WINNAKEN/robot-arm-lab/models/cycloid-27-v1/README.md

# 사이클로이드 27:1 시제품 v1 — 손목 크기 (MP6 · 1 호기용)

**상태: 시제품 — 끼움 값은 임시**(시험편 v1 · 이 판의 맞춤 확인 판을 보고 정한다). 계획 = `docs/design/029-cycloid-27-prototype.md`. 수치의 권위 =
`src/cad/cycloid-27-v1/cycloid.py` 의 산출 `cycloid.json` · 검사 = `checks.json`. 출력 · 구매 · 조립은 사용자가 한다.

> **비작성자 최종 검수 미통과**(2026-10-25 · 사용자 결정 「‘검수 미통과’ 표지로 커밋 (권장)」). 비작성자 검수 5 회(L4 R1 · R2 · R3 · N1 · N2)가 모두 BLOCK
> 이었다. 다섯 번 모두 「지금 부품의 명목 결함은 없음」 이었고 남은 지적은 **검사 장치의 빈틈**이었다. 마지막 고침(N2)은 작성자 양성 대조 35 종으로만 확인했다.
> 이 판을 출력 · 구매의 수용 근거로 쓰지 말고, 출력과 맞춤 확인 판 시험으로 실물을 확인할지는 사용자가 정한다. 기록 = `.dev/cycloid-27-evidence/`.

- 감속비 27:1(고정 핀 28 · 원판 로브 27) · **출력은 입력의 반대 방향**(명목 1/27 — 틈만큼 유격이 있다).
- NEMA17 모터(Ø22 파일럿 · M3 31 mm 사각)에 바로 붙는 독립 시험 감속기 · 바깥 Ø78 · 높이 43.5 mm(모터 면부터 출력 플랜지 윗면).
- 손목 기준: 짐 0.5 kg 에서 필요 약 3.9 N·m(안전율 포함 · MP5). **어깨용이 아니다** — 어깨는 같은 생성기로 키운 판을 두 축 실측 뒤에 만든다.

## 파일

| 파일 | 내용 |
|---|---|
| `cycloid.json` | 계산 산출(윤곽 · 기구학 보장 틈 · 쌓임 · 반지름 · 벽 · 틈 · 베어링 고리 닿음 · 축 방향 고정 · 하중 어림) |
| `checks.json` | 검사 C1 ~ C8 판정 |
| `parts/*.stl` | 부품(조립 자리 · 원판은 둘이지만 같은 부품 — 판에는 `DISC_1` 을 두 번) |
| `print-plate.stl` · `slicer/` | 한 판(H2D) · PrintForge 출력 준비 결과(G-code 없는 3MF · 보고서) |
| `cycloid-27-theta000.solidcraft` · `cycloid-27.step` | 조립(입력 0°) |
| `small-parts.solidcraft` | 맞춤 확인 판 · 와셔 셋 · 게이지 |

## 부품 (인쇄 — PLA · 0.20 Standard · 지지대 없음)

| 부품 | 쓰임 | 개수 | 크기 mm(x × y × 높이) |
|---|---|---|---|
| `FIT_STRIP` | 맞춤 확인 판 | 1 | 120.00 × 72.00 × 11.00 |
| `HOUSING_BASE` | 아래 하우징 — 바닥판(모터 · 고정 핀) + 벽 | 1 | 78.00 × 78.00 × 23.85 |
| `HOUSING_CAP` | 덮개 — 고정 핀 윗끝 · 6808 자리 | 1 | 78.00 × 78.00 × 15.65 |
| `RETAINER` | 누름 고리 — 6808 바깥 고리 | 1 | 72.43 × 72.42 × 2.50 |
| `DISC_1` | 원판(같은 부품 둘 · 둘째는 180° 돌려 끼움) | 2 | 53.03 × 53.12 × 6.00 |
| `CARRIER` | 출력 캐리어 — 출력 핀 · 6800 · 6808 속 고리 | 1 | 45.00 × 45.00 × 15.65 |
| `OUTPUT_FLANGE` | 출력 플랜지 — 6808 속 고리를 누름 | 1 | 44.00 × 44.00 × 4.00 |
| `GAUGE` | 끼움 게이지 0.6(아래 편심 축 높이 — 모터만 있을 때 쓰고 뺀다) | 1 | 30.00 × 14.00 × 0.60 |
| `WASHER_T2p0` | 와셔 2.0(6801 #2 ↔ 6800 속 고리 · 셋 중 맞는 것 하나) | 1 | 14.40 × 14.40 × 2.00 |
| `WASHER_T2p2` | 와셔 2.2(기본) | 1 | 14.40 × 14.40 × 2.20 |
| `WASHER_T2p4` | 와셔 2.4 | 1 | 14.40 × 14.40 × 2.40 |
| `CAM_LOWER` | 편심 축 아래 — 허브 + 편심 1 | 1 | 14.00 × 14.00 × 12.05 |
| `CAM_UPPER` | 편심 축 위 — 간격 고리 + 편심 2 + 저널 | 1 | 14.00 × 14.00 × 14.20 |

한 판 263.2 × 247.1 mm · Bambu Studio 미리 슬라이스: 판정 `ready` · 지지대 권고 없음 · 예상 3 시간 48 분 · 116.91 g · 38.57 m(프로필 Bambu Lab H2D 0.4 nozzle · 0.20mm Standard @BBL H2D · Bambu PLA Basic @BBL H2D · Textured PEI Plate).

## BOM (제안 — 구매 = 사용자)

| 품목 | 수량 | 쓰임 |
|---|---|---|
| 강철 다월 핀 Ø4 × 28 | 28 | 고정 핀(바닥판에 21.85 압입 · 윗끝 6.15 는 덮개 미끄럼 구멍에) |
| 강철 다월 핀 Ø4 × 20 | 6 | 출력 핀(캐리어 판에 압입) |
| 베어링 6801(12 × 21 × 5) | 2 | 원판 가운데 |
| 베어링 6808(40 × 52 × 7) | 1 | 출력 지지(덮개) |
| 베어링 6800(10 × 19 × 5) | 1 | 편심 축 윗끝(캐리어 가운데) |
| M3 열압입 인서트 | 12 | 덮개 아래 4 · 덮개 위 4 · 캐리어 허브 4 |
| M3 둥근머리 나사 × 10 | 4 | 모터(바닥판 위에서 · 물림 4.0 — 모터 나사 깊이 4.5 는 가정) |
| M3 나사 × 30 | 4 | 바닥판 아래 → 덮개 인서트(물림 6.2) |
| M3 나사 × 8 | 4 | 누름 고리 → 덮개 인서트(물림 5.5) |
| M3 나사 × 8 | 4 | 출력 플랜지 → 캐리어 허브 인서트(물림 4.0 — 시험 짐 · 팔을 함께 끼우면 그 두께만큼 길게) |

나사 길이 = `cycloid.json` 의 `screws`(표준 길이 중 물림이 하한 이상이고 끝이 막힌 구멍 바닥에서 0.5 이상 떨어지는 가장 긴 것).

베어링의 표준 치수 · 다월 판매 길이 · 고리 단면은 이 저장소 자료로 확인하지 않았다. 턱 · 고리 반지름은 「d + 0.15(D − d) ≤ 안 고리 바깥지름 ≤ d +
0.4(D − d) · D − 0.4(D − d) ≤ 바깥 고리 안지름 ≤ D − 0.15(D − d)」 가정으로 정했다 — 다른 고리는 넓은 쪽으로 피하고, 제 고리에는 어느
베어링에나 있는 좁은 띠에서 닿게(`cycloid.json` 의 `ring_contacts` · 가장 얇은 겹침 0.30 mm). **실물 베어링에서 턱이 제 고리에만 닿는지** 눈으로
확인한다.

## 축 방향 고정 (어떤 면이 무엇을 잡는가)

- 아래 편심 축: 모터 D 축에 **압입** — 모터만 따로 둔 채 게이지(0.6)를 모터 파일럿 위에 놓고 눌러 넣은 뒤 게이지를 뺀다(바닥판에 붙이기 전).
- 6801 #1: 속 고리 = 아래 편심 축 허브 윗면 ↔ 위 편심 축 간격 고리 밑면(둘 다 입력 속도) · 바깥 고리 = 원판 1 에 압입(원판 윗면과 같은 높이).
- **베어링 속 고리는 모두 손으로 밀어 끼운다**(편심 둘 · 저널) — 누르면 그 힘이 아래로 내려가 아래 편심 축의 압입을 민다. 손으로 안 들어가면 누르지 말고
  `bearing_bore_extra` 를 줄여 편심 축을 다시 출력한다.
- 위 편심 축: D 축에 **미끄럼 끼움** — 간격 고리가 6801 #1 속 고리에 얹힌다 · 위에서는 와셔 · 6800 · 캐리어가 누른다.
- 6801 #2: 속 고리 = 간격 고리 윗면 ↔ 와셔(입력 속도) · 바깥 고리 = 원판 2 에 압입(원판 윗면과 같은 높이 — 원판 1 과 같다).
- 와셔(2.0 / 2.2 / 2.4 중 하나): 6801 #2 속 고리 ↔ 6800 속 고리. **와셔 윗면 = 바닥판 벽 윗면**(설계 차 0.00) — 이것이 조립 중 잴 수 있는
  기준이다(아래 8 단계).
- 6800: 바깥 고리 = 캐리어 자리에 압입(위 턱 — 속 고리 위는 오목) · 속 고리 = 저널.
- 캐리어: 6808 속 고리를 캐리어 턱과 출력 플랜지 사이에 낌 · 6808 바깥 고리 = 덮개 턱과 누름 고리 사이.

## 조립 순서

1. **모터만 따로 둔 채**: 게이지(0.6)를 모터 파일럿 위에 D 축을 끼고 놓고, 아래 편심 축을 D 축에 눌러 게이지에 닿게 한 뒤 게이지를 옆으로 뺌.
2. 모터를 바닥판에 M3 둥근머리 4 개(아래 편심 축 허브 Ø14 가 바닥판 파일럿 구멍 Ø22.3 을 지남 · 머리는 바닥판 위 — 카운터보어 없음).
3. 고정 핀 28 개를 바닥판 구멍에 압입(위로 튀어나온 길이를 같게).
4. 6801 을 원판 둘에 압입 — **둘 다 평평한 판 위에 원판을 놓고 베어링 윗면 = 원판 윗면이 될 때까지**(아랫면 쪽은 1.0 들어감). 그 면이 위로 간다.
5. 원판 하나를 위에서 아래 편심에 **손으로 밀어** 끼움(베어링 속 고리가 허브 윗면에 앉음 · 누르지 않는다).
6. 위 편심 축(미끄럼 끼움)을 D 축에 내려 간격 고리가 6801 #1 속 고리에 얹히게 함 — 세게 누르지 않는다(아래 편심 축이 밀리면 게이지 높이를 잃는다) ·
   D 면 때문에 편심이 아래와 반대쪽.
7. 다른 원판을 **180° 돌려** 위 편심에 손으로 밀어 끼움(원판 둘의 같은 표시가 반대쪽).
8. 와셔(먼저 2.2)를 저널에 끼우고 **곧은 자를 바닥판 벽 윗면에 걸쳐 와셔 윗면과 견준다**: 자가 벽과 와셔에 함께 닿으면 맞음 · 자가 와셔에 떠 있으면(와셔가
   높음) 얇은 와셔 · 와셔 위에 틈이 보이면 두꺼운 와셔. 2.4 로도 틈이 크면(아래 편심 축 허브 ↔ 파일럿 설계 틈 0.6 쯤) 아래 편심 축이 밀린 것 →
   1 단계부터. 밀려도 원판 1 은 나사 머리에서 0.4 떠 있다(설계 틈 1.0 − 0.6).
9. 덮개에 6808 을 위에서 넣고 누름 고리를 M3 4 개로.
10. 캐리어 판에 출력 핀 6 · 가운데에 6800 바깥 고리 압입(캐리어만 따로 — 편심 축에 올리기 전) → 캐리어 허브를 아래에서 6808 속 고리에 밀어 넣고 출력
    플랜지를 M3 4 개로.
11. 덮개 묶음을 내려 출력 핀이 원판 구멍 · 저널이 6800 속 고리(손으로 밀어 끼움) · 고정 핀 윗끝이 덮개 구멍(미끄럼 — 압입 아님)에 들어가게 하고,
    바닥판 아래에서 M3 4 개로 덮개 인서트에 조임. 다시 열 때는 이 4 개만 풀면 덮개 묶음이 통째로 빠진다.

## 손 시험 기록지 (모터 없이 · 또는 모터 끈 채)

| 항목 | 기록 |
|---|---|
| 모터 축(입력)을 손으로 돌릴 때 걸림 · 뻑뻑한 자리(입력 몇 바퀴째 · 출력 각) | |
| 출력 플랜지를 잡고 입력을 돌릴 때 출력이 **반대로** 1/27 도는가 | |
| 출력을 손으로 좌우로 흔들 때 유격(대략 각 · 또는 「안 느껴짐」) | |
| 원판 · 핀 · 캐리어 판 · 와셔 사이 긁힘 소리 · 자국 | |
| 고정 핀 · 출력 핀 · 편심 축이 빠지거나 헐거운가 | |
| 쓴 와셔 두께 | |

결과 → 틈 C(`fits.profile_clearance`) · 출력 구멍 틈(`fits.output_hole_clearance`)을 ±0.05 씩 바꿔 **원판만** 다시 출력.

## 이 판에 쓴 끼움 보정값 (원장 `src/cad/calibration/print-fits.json`)

재료 **PLA**(원장 `print-fits.json`).

| 값 | mm | 상태 | 근거 |
|---|---|---|---|
| `bearing_seat_extra` | 0.05 | 시험함 · 확정 전 | 감속기 맞춤 확인 판 바깥 자리(6801 21.00 / 21.10 / 21.20 · 6800 19.00 / 19.10 / 19.20 · 실 베어링 · 2026-10-29 · 판정 원문 = observations) → 사용자 「작은값과 중간값 사이를 하는게 나아보이긴해」 = 0.05(MP12) — 0.05 자체는 아직 출력해 끼워 보지 않아 provisional · 6808 자리는 시험 없음 · 그 전 근거 = fit-coupons-v1 ② 608 자리 22.00 억지끼움 · 22.10 보통 끼움(2026-10-25) |
| `bearing_bore_extra` | 0 | 확정 | 감속기 맞춤 확인 판 속 고리 기둥(6801 11.90 / 12.00 / 12.10 · 6800 9.90 / 10.00 / 10.10 · 실 베어링 · 2026-10-29): 「둘 다 가운데」 = 안지름 그대로(+0.0 · MP12) · 캐리어 허브 Ø40(6808)은 시험 없음 |
| `pin_press_hole_dia` | 4.2 | 시험함 · 확정 전 | 핀 구멍 시편 v1(MP13 · H2D 판 36b = 하늘 Bambu PLA Pure · 외부 스풀 · 왼쪽 노즐 · 세운 관통 구멍 4.10 ~ 4.45 · 0.05 간격 · 깊이 10 · 실 강철 Ø4 다월 · 2026-11-04 · 판정 원문 = observations): 「20은 되게 끼움맞춤인데 들어가긴하는데조금 빡세고」 = 4.20(들어가는 가장 작은 구멍) · 그 전 맞춤 확인 판 3.8 ~ 4.1 은 모두 작음. provisional — 윗면 · 밑면을 나눈 판정이 아님 · 실제 바닥판은 21.85 를 누름(시편 10) · 🔴 시험 재료 = 하늘 Pure(이 칸의 다른 값은 Basic) → 흰 Basic 시편 36 을 다음 판에 함께 뽑아 견줌 — 바닥판 · 캐리어에 실제로 눌러 본 뒤 확정 |
| `pin_slip_hole_dia` | 4.25 | 시험함 · 확정 전 | 핀 구멍 시편 v1(MP13 · 같은 판 36b · 하늘 Pure · 2026-11-04 · 판정 원문 = observations): 「25는딱 쉽게 들어갈정도」 = 4.25. provisional — 윗면 · 밑면을 나눈 판정이 아님(덮개 구멍은 판 쪽으로 열림) · 실제 덮개는 핀 28 개를 한꺼번에 씌움 · 한 칸 큰 4.30 은 4.27 을 넘어 벽 < 2.0 · 🔴 시험 재료 = 하늘 Pure(덮개는 흰 Basic 으로 뽑음 — 흰 시편 36 으로 견줌) — 덮개를 실제로 씌워 본 뒤 확정 |
| `d_bore_extra` | 0.2 | 임시값(시험 전) | 사용자 결정(MP14 · 2026-11-04 · 원문 `.dev/mp14-evidence/user-decisions-mp14.json` · observations): 핀 구멍 시편 판정 뒤 「핀과 같이 모터축의 크기도 키워야할것같아」 → 질문 창 「핀과 같은 양 +0.20」 = 아래 편심 축 D 구멍 5.20(위 편심 축 = + cam_upper_bore_extra 0.1 = 5.30). 5.20 은 출력해 끼워 보지 않음(맞춤 확인 판 범위 4.90 ~ 5.10 밖) → placeholder · 그 전 = 맞춤 확인 판 D 구멍(4.90 / 5.00 / 5.10 · 평면 1.95 / 2.00 / 2.05 · 실 모터 축 · 2026-10-29 · 초록 Basic) 「가운데(5.00)」 · 편심 축은 하늘 Pure 로 뽑음 |
| `cam_upper_bore_extra` | 0.1 | 임시값(시험 전) | 모터가 오면 정함 |
| `pilot_hole_dia` | 22.3 | 시험함 · 확정 전 | fit-coupons-v1 ① 버니어(부정확): 22.15→21.9 · 22.30→22.0~22.05 · 22.45→22.2(2026-10-25) — 모터로 확정 |
| `m3_clearance_dia` | 3.4 | 임시값(시험 전) | fit-coupons-v1 ③ C 구멍(3.2 / 3.4 / 3.6) — M3 나사 없음 |
| `insert_hole_dia` | 4 | 확정 | fit-coupons-v1 ③ I: Ø4.0 에 M3 인서트가 잘 들어감(2026-10-25 확정) · Ø4.4 너무 큼 · Ø4.2 는 처음에 M4 인서트로 잘못 시험해 무효(M3 로는 아직 안 봄) · 쓴 인서트 = M3 · 길이 5.7 · 바깥지름 4.2(2026-10-26 사용자) — 다른 인서트면 다시 확인 |

## 끼움 확인 판 (`FIT_STRIP` — 줄마다 왼쪽 → 오른쪽 = 작은 값 → 큰 값 · 오른쪽 두 기둥 열은 아래 → 위 · 가운데 = 지금 보정값)

| 자리 | 시험 | 지름 mm | 판정 |
|---|---|---|---|
| (8, 8) | Ø4 pin press hole | 3.80 | |
| (18, 8) | Ø4 pin press hole | 3.90 | |
| (28, 8) | Ø4 pin press hole | 4.00 | |
| (38, 8) | Ø4 pin press hole | 4.10 | |
| (52, 8) | motor D-shaft bore (d_bore_extra +0.10) | 5.10 · 평면 2.05 | |
| (66, 8) | motor D-shaft bore (d_bore_extra +0.20) | 5.20 · 평면 2.10 | |
| (80, 8) | motor D-shaft bore (d_bore_extra +0.30) | 5.30 · 평면 2.15 | |
| (16, 30) | 6801 outer-ring seat | 20.95 | |
| (44, 30) | 6801 outer-ring seat | 21.05 | |
| (72, 30) | 6801 outer-ring seat | 21.15 | |
| (16, 56) | 6800 outer-ring seat | 18.95 | |
| (44, 56) | 6800 outer-ring seat | 19.05 | |
| (72, 56) | 6800 outer-ring seat | 19.15 | |
| (96, 14) | 6801 inner-ring peg | 11.90 | |
| (96, 32) | 6801 inner-ring peg | 12.00 | |
| (96, 50) | 6801 inner-ring peg | 12.10 | |
| (113, 14) | 6800 inner-ring peg | 9.90 | |
| (113, 32) | 6800 inner-ring peg | 10.00 | |
| (113, 50) | 6800 inner-ring peg | 10.10 | |

판정 말: 핀 구멍 · 바깥 자리 · D 구멍 = 압입 적당 · 헐거움 · 안 들어감 · 갈라짐 / **안지름 기둥(베어링 속 고리) = 손으로 밀어 들어가고 흔들림 없음 ·
헐거움 · 안 들어감**(누르지 않는다 — 조립에서도 누르지 않는 끼움이다). 결과 → **끼움 보정 원장 `src/cad/calibration/print-fits.json`**(재료별 값 ·
판정 원문 · 바꾼 기록 — 이 판은 PLA 항목을 읽는다)의 값을 고치고 기록을 더한다(계획 029 의 「끼움 결과 → 매개변수」 표 — 바깥 자리 =
`bearing_seat_extra` · 안지름 기둥 = `bearing_bore_extra`(편심 Ø12 · 저널 Ø10 · 캐리어 허브 Ø40 에 함께 들어감) · 핀 구멍 = `pin_press_hole_dia`(압입)와
`pin_slip_hole_dia`(덮개 — 미끄럼) · D 구멍 = `d_bore_extra`(가운데 구멍이 지금 아래 편심 축과 같은 값 · 위 편심 축은 `cam_upper_bore_extra` 만큼 더 큼)) →
`make_all.py` 로 계산 · 형상 · 검사 · 출력 준비를 다시 돌린다. D 구멍은 모터를 받은 뒤 판정한다(미보유). 맞춤 확인 판 바닥(핀 구멍 밑 1.0) · 게이지(0.6)는
시험용이라 최소 재료 2.0 보다 얇다(검사 C3 밖).

## 한계

- 모터 축(Ø5 D · 평면 → 반대편 4.5 · 장착면에서 축 끝 21.5 = 턱 2 + 19.5) · 파일럿(Ø22 × 2)은 사용자 실측(2026-11-04 · 모터 원장 · MP14). **축을 따라 D 평면이 끝나는 자리는 아직 안 잼** — 편심 축 둘이 D 구멍이라 축 끝에서 18.9 이상 평면이 있어야 아래 편심 축이 끝까지 들어간다. 나사 간격 31 · 모터 나사 깊이 4.5 · 나사 머리는 NEMA17 일반값 **가정**.
- PLA 원판 · 편심 축의 마모 · 크리프 · 열, 강도 · 효율 · 유격은 계산하지 않았다(하중은 어림만 — `cycloid.json` 의 `loads_rough`: 출력 핀 힘 · 밑동 굽힘 ·
  편심 반력 규모 · 두 원판 짝힘).
- 편심 축은 모터 축과 6800 으로만 받친다 — 모터 베어링에 가는 반력 · 두 원판 짝힘이 닫히는 길은 계산하지 않았다.
- 압입(편심 축 · 베어링 · 핀)과 쌓임 공차는 임시 — 와셔 셋과 손 시험으로 맞춘다. 0.20 층 출력은 높이를 층에 맞춰 반올림한다(0.05 단위 높이가 0.1 쯤
  달라질 수 있다) — 그 차이도 8 단계의 와셔 고르기가 받는다. 와셔 셋이 덮는 범위(±0.2)를 넘는 오차는 계산하지 않았다.
