WINNAKEN/robot-arm-lab/models/j23-drive-v1/README.md

# J2 · J3 공통 구동 모듈 v1 (MP16)

NEMA23 + MKS SERVO57D → HTD 3M 벨트 20 : 60(3 : 1) → 인쇄 사이클로이드(고정 핀 28 · 원판 로브 27) = **81 : 1**. 어깨 J2 와 팔꿈치 J3 에 같은 모듈을 쓴다.
모터는 감속기 옆(축 거리 91.0 mm · 벨트 3M-306-15)에 둔다. 시험대 · 시험 팔을 함께 만들었다(책상에서 축을 눕혀 돌려 보기용).

- 결정 원문 = `.dev/mp16-evidence/user-decisions-mp16.json`: 「J2,J3  설계 시작해서 구매품 확정해」 · 「네마 23 서보 57 사올테니」 · 질문 창 「MP16 (권장)」 ·
  「일단 0.7정도 라고 생각해서 손목 안건들고는안더ㅣ나」 · 「J2·J3 같은 모듈 81:1 (권장)」 · 「J2·J3 는 1 kg 기준 (권장)」 · 「J2는 그럼 76사올게」 ·
  「오기전에 모델링은 끝내놔 치수보정은 나중에 한다고해도」 · 「옆 배치 (권장)」 · 「구동 모듈 + 시험대 (권장)」.
- 원천 = `src/cad/j23-drive-v1/`(생성기 `build_drive.py` → SolidCraft 명령줄 · 크기 계산 `sizing.py` · 검사 `check_drive.py` · 대조 `run_controls.py` ·
  출력 준비 `print_prep_drive.py`). 이 폴더는 산출물이다. 원판 윤곽은 MP6 생성기(`cycloid.py`)를 읽기만 해서 쓴다.
- **구매품 치수는 장바구니 상품의 표시값 · 일반값이다 — 받으면 재서 보정한다**(사용자 지시). 특히 D 축 평면까지 거리(3.5 가정) · 풀리 바깥 · 플랜지 · 허브 · NEMA23 볼트 간격 · 파일럿.

감속기 · 모터 · 핀 · 풀리 어림 몸체를 얹은 모습

## 부하 · 여유 (`.dev/mp16-evidence/sizing/` — MP5 하중 모델 사본 · 가정 = 쓸 수 있는 토크 50 % · 안전율 2 · 효율 0.7125)

| 짐 | J2(76 mm 모터 · 토크 1.89 N·m **가정**) | J3(56 mm · 1.26 N·m) | 손목 J4 · J5(27:1 · 그대로) |
|---|---|---|---|
| 0.7 kg | 필요 31.9 N·m · 여유 +71 % | 15.1 · +141 % | -12 %(실제 안전율 약 1.77) |
| 1.0 kg(설계 기준) | 35.9 · +52 % | 17.9 · +103 % | -32 % |

- 키운 J3 모듈의 무게(금속 0.75 kg · 57D 보드 0.12 kg 가정 · 인쇄 +0.35 kg 가정)를 넣고 다시 셈했다. 관절 속도 약 22 °/s(모터 300 rpm 가정).
- 출력은 모터와 **반대 방향**(벨트는 같은 방향 · 사이클로이드가 뒤집음).

## 구매품 (한 모듈 — 두 모듈이면 두 배 · BOM `docs/BOM.md` 2d)

| 품목 | 한 모듈 | 쓰는 곳 |
|---|---|---|
| MKS SERVO57D CAN MT — J2 = 76 mm(Motor Package 2) · J3 = 56 mm(Motor Package 4) | 1 | 입력 |
| HTD 3M 풀리 20 잇 · 벨트 폭 15 · 구멍 8(양쪽 플랜지 권장) | 1 | 모터 축 |
| HTD 3M 풀리 60 잇 · 15 · 구멍 8 | 1 | 입력 축 아래 끝 |
| HTD 3M 닫힌 벨트 15 mm · 3M-306(102 잇) | 1 | 옆 배치 |
| D 컷 강철 축 Ø8 × 100 → **81 로 자름(풀리를 잰 뒤)** | 1 | 입력 축 |
| 베어링 608(8 × 22 × 7) | 2 | 입력 축 — 바닥판 · 캐리어 가운데 |
| 베어링 6804(20 × 32 × 7) | 2 | 원판 가운데 |
| 베어링 6812(60 × 78 × 10) | 1 | 출력(캐리어 허브 ↔ 덮개) |
| 평행핀 Ø6 × 45 | 28 | 고정 핀(바닥판 압입 · 덮개 홈) |
| 평행핀 **Ø8 × 45**(담금질 경화 권장) | 8 | 출력 핀(캐리어에 19 압입) |
| M3 열압입 인서트(M3 × 5.7 또는 6 · 바깥 4.2 · 구멍 Ø4.0 × 깊이 7.5) | 27 | 덮개 밑 6 · 덮개 위 12 · 캐리어 6 · 바닥판 밑 3 |
| M3 × 12 | 7 | 덮개 나사 6(바닥판 밑 자리파기) · 벨트 덮개 모터 쪽 귀 1(+ M3 너트) |
| M3 × 8 | 9 | 누름 고리 6 · 벨트 덮개 귀 3 |
| M3 × 10 둥근머리 | 6 | 출력 플랜지(시험 팔을 달면 빼고 M3 × 20) |
| M5 × 20 렌치볼트 + M5 너트 + M5 와셔 | 4 + 4 + 4 | 모터(바닥판 밑에서 · 너트는 모터 귀 위) |
| (시험대 한 벌) M3 × 12 6 · M3 × 20 6 · 책상 고정 M4 4 | | 시험대 · 시험 팔 |

## 출력 (H2D · 0.20 Standard · PLA Basic · Textured PEI · 지지대 없음 — `.dev/mp16-evidence/printprep.json`)

| 부품 | 방향 | 질량 · 시간 |
|---|---|---|
| `HOUSING_BASE` | 그대로 | 62.1 g · 1 시간 42 분 |
| `CAP` | 그대로 | 104.4 g · 2 시간 43 분 |
| `CARRIER` | 그대로 | 37.0 g · 1 시간 0 분 |
| `DISC_1` | 그대로 | 24.9 g · 47 분 |
| `CAM_LOWER` | 그대로 | 2.0 g · 11 분 |
| `CAM_UPPER` | 그대로 | 2.5 g · 12 분 |
| `WASHER_T1p2` | 그대로 | 0.1 g · 6 분 |
| `WASHER_T1p4` | 그대로 | 0.2 g · 6 분 |
| `WASHER_T1p6` | 그대로 | 0.2 g · 6 분 |
| `RETAINER` | 그대로 | 7.8 g · 19 분 |
| `OUTPUT_FLANGE` | 그대로 | 10.0 g · 19 분 |
| `GUARD` | 그대로 | 66.4 g · 1 시간 38 분 |
| `STAND` | 뒤집어(윗면을 판에) | 96.2 g · 2 시간 7 분 |
| `LEVER` | 뒤집어(윗면을 판에) | 49.1 g · 1 시간 5 분 |

두 모듈(J2 · J3) + 시험대 한 벌 = 판 다섯(`print-plate-*.stl` · `slicer/*.bambu.3mf` — G-code 없는 프로젝트, 창에서 열어 슬라이스):

| 판 | 부품 | 질량 · 시간 |
|---|---|---|
| A_base_carrier | HOUSING_BASE × 2 · CARRIER × 2 · CAM_LOWER × 2 · CAM_UPPER × 2 · WASHER_T1p2 × 2 · WASHER_T1p4 × 2 · WASHER_T1p6 × 2 | 207.6 g · 5 시간 29 분 |
| B_cap_disc | CAP × 2 · DISC_1 × 2 | 258.0 g · 6 시간 49 분 |
| C_guard_disc | GUARD × 2 · DISC_1 × 2 | 183.4 g · 4 시간 31 분 |
| D_stand_lever | STAND × 1 · LEVER × 1 | 144.9 g · 3 시간 9 분 |
| E_retainer_flange | RETAINER × 2 · OUTPUT_FLANGE × 2 | 35.8 g · 1 시간 0 분 |

합계 약 830 g · 21 시간 1 분. 부품 모두 뱀부 판정 `ready` · 지지대 권고 없음.
- 보낼 때 권장: 구멍 턱(카운터보어 · 막힌 베어링 자리 천장)이 있는 **바닥판 · 캐리어 · 벨트 덮개 · 시험대 · 시험 팔**에 「카운터보어 홀을 브리지로 연결 = 희생 레이어」(판 38 교훈 — 뒤에 막을 뚫음).
- **시험 팔은 채움 100 %**(물체별 설정) — 갈고리 최대 무게(J2 설계 하중 = 짐 1 kg 몫 · 안전율 없이): 200 mm 9 kg · 150 mm 12 kg · 100 mm 18 kg. J3 모듈이면 그 절반.
- 이 프로젝트들은 printforge 기본값(벽 arachne · 뱀부 점검기 FAIL 0 · WARN 0)이다. 끼움 원장 값은 classic 조건에서 나왔으므로 핀 · 베어링 자리가 있는 부품을 classic 으로 할지,
  색(바깥 흰 · 안 하늘 등)은 보낼 때 정한다.

## 조립 순서

1. 인서트: 덮개 밑면(z 10 면) 6 · 덮개 윗면 12(누름 고리 6 · 시험대 6) · 캐리어 허브 윗면 6 · 바닥판 밑면 3(벨트 덮개).
2. 고정 핀 28 개(Ø6 × 45)를 바닥판 구멍에 위에서 눌러 끝까지(바닥 2 mm). 608 하나를 바닥판 가운데 자리에 위에서 넣는다(턱에 닿게).
3. 아래 편심 축을 D 축에 눌러 끼운다 — **목(축 중심 작은 고리) 아랫면이 축 아래 끝에서 46.0 mm**(축을 81 보다 길게 잘랐으면 그만큼 위 끝이 608 위로 나옴 · 2 mm 까지 됨).
   6804 를 원판 둘에 **원판 윗면과 같은 높이**로 넣는다.
4. 원판 하나를 아래 편심에 손으로 밀어 끼우고, 축을 위에서 608 에 내려 꽂는다(목이 608 속 고리에 앉음).
5. 위 편심 축(미끄럼)을 축에 내려 간격 고리가 6804 속 고리에 앉게 → 다른 원판을 **180° 돌려** 위 편심에 끼운다.
6. 와셔(먼저 1.4)를 축 위에 — **와셔 윗면 = 원판 2 윗면 + 2.0**(캘리퍼 깊이로). 다르면 1.2 / 1.6 으로.
7. 덮개 묶음: 덮개를 뒤집어 6812 를 자리에 넣고 누름 고리(M3 × 8 6) · 캐리어 판에 출력 핀 8(Ø8 × 45)을 밑에서 끝까지 압입 · 608 하나를 캐리어 가운데 자리에 밑에서 →
   캐리어 허브를 6812 속 고리에 밑에서 밀어 넣고 출력 플랜지(M3 × 10 6).
8. 덮개 묶음을 내려 출력 핀이 원판 구멍 · 608 이 축 위 끝 · 홈이 고정 핀에 들어가게 → 바닥판 밑에서 M3 × 12 6 을 **살짝만** 조이고 60 잇 쪽 축을 손으로 몇 바퀴 돌려
   자리를 잡은 뒤 조인다(덮개 · 바닥판 동심은 핀 홈 틈 0.125 로만 잡힌다).
9. 60 잇 풀리를 축 아래 끝에(멈춤나사를 평면에 · 허브가 있으면 아래로) — 이(벨트 15)가 바닥판 밑면에서 **10.5 ~ 25.5 mm** 아래. 20 잇 풀리를 모터 축에 같은 높이로
   (허브가 있으면 **위 = 바닥판 쪽**으로 — 모터 축은 판 밑으로 J2 19 · J3 20 mm 뿐).
10. 벨트를 걸고 모터를 바닥판 날개 위에(파일럿을 홈에) → M5 × 20 4 를 밑에서 · 너트는 모터 귀 위 → 모터를 바깥으로 밀어 벨트를 당기고 조임(구멍 ±2.5 mm).
11. 벨트 덮개(M3 × 8 3 + 모터 쪽 M3 × 12 + 너트) · 시험대(M3 × 12 6 · 덮개 윗면) · 시험 팔(플랜지 나사 대신 M3 × 20 6).

## 손으로 확인할 것

- 60 잇 풀리를 손으로 돌려 출력이 **반대로** 1/27 도는지(모터 축 기준 1/81) · 걸림 · 긁힘 · 유격.
- 벨트 장력(가운데를 눌러 몇 mm 들어가는지) · 풀리 높이 맞춤.
- 시험 팔 100 / 150 / 200 mm 구멍에 추를 달아 처짐 · 미끄럼(전원 시험은 제어 세션). 시험 팔은 **아래 반원에서만** 돌린다(위로 약 55° 넘게 돌면 모터에 닿음).

## 검사 (`check.json` — 커밋된 STL 로 스스로 계산 · 판정 True)

- C2 입력 각 12 곳 · 인쇄 부품 13 + 구매품 기준 몸체(핀 · 베어링 · D 축 · 풀리 · 벨트 · 모터 76 / 56 · 볼트 머리) 쌍 교차 최대 1.1e-13 mm³ ·
  장력 조절 양 끝(±2.5)에서도 0.
- C3 원판 ↔ 고정 핀 최소 0.100 · 출력 핀 ↔ 원판 구멍 0.100 · 원판 끝 ↔ 하우징 0.70 mm(입력 한 바퀴 720 점).
- C4 벨트: 축 거리 91.00 · 작은 풀리 감김 156° · 물린 이 8.7 · 모터 축이 벨트 가운데 높이까지 닿음. C5 최소 재료 · 틈 · 모터 판 끝(잰 값).
  C6 나사 물림(벨트 덮개 모터 쪽 귀 = M3 × 12 + 너트). C7 구멍 지름(STL 단면 ± 0.03). C9 베어링 고리마다 양쪽 면에 받치는 부품 면(자기 고리만 · 같은 높이).
- 양성 대조 6 모두 잡힘: disc_big(C2) · guard_narrow(C2) · lobe_short(C5) · pin_tight(C7) · plate_wide(C2) · seat_small(C7 · C2).

## 한계 · 확인 안 한 것

- 구매품 치수(위) · 76 mm 모터 토크 · 57D 보드 질량 · 베어링 정격 · 벨트 허용 장력(300 N 가정)은 확인 안 함.
- Ø6 · Ø8 핀 구멍은 Ø4 시편의 더한 값(+0.20 압입 · +0.25 미끄럼)을 그대로 옮긴 **가정** — 큰 핀은 시험 안 함. 고정 핀(Ø6)은 장바구니의 304 스테인리스(경화 아님) · 출력 핀(Ø8 × 45)은 경화 권장.
- 출력 핀이 PLA 원판을 누르는 압력은 MP6 손목의 약 1.4 배(핀 셋 4.9 · 핀 하나 14.6 MPa). 캐리어 구멍 입구 압력 어림 29 MPa
  (설계 하중 · 안전율 2 포함 — 보통 하중은 그 절반 · PLA 크리프는 시험으로 본다). 두 원판 짝힘이 캐리어를 기울이는 몫은 셈하지 않았다(608 둘째가 받음). 6812 하나라 기울임 강성은 시험으로 본다. 해석(FEA) 도구 없음.
- 덮개는 바로 출력한다 — 6812 를 고정 핀 끝 위로 올리고(산출 검토 R1), 원판 위 45° 경사가 핀 홈보다 위에서 시작한다. 경사가 핀 홈과 만나던 판은 SolidCraft STL 이 홈 사이에서 열렸다.
- 팔(어깨 몸통 · 팔 관)에 붙이는 일은 다음 단위.
