WINNAKEN/robot-arm-lab/models/j5-wrist-v1/README.md

# J5 손목 굽힘 관절 실부품 v1 (MP10 · 계획 056)

**상태: 시제품 — 출력해 조립해 볼 첫 판.** 모터 · 드라이버 · 커넥터 치수는 실측한 전체 길이 53.5(모터 앞면 → 뒤 단자대 끝 · 상한) 밖에는 모두 가정값(모터 원장)이고, J4 쪽 접속은 「J4 도 MP6 같은 감속기」 라는 가정이다.
Codex 비작성자 검수는 받지 않았다. Claude 하위 에이전트 산출 검토 R1 을 받아 13 건을 고쳤고, 그 처분은 `.dev/mp10-evidence/review.md` 에 있다. 고친 뒤 다시 검토는 받지 않았다. 출력 · 구매 · 조립은 사용자가 한다.

- 계획 = `docs/design/056-j5-wrist-real-part.md` · 결정 원문 = `.dev/mp10-evidence/user-decisions-mp10.json`.
- **다시 만들기(2026-10-30)**: 사용자 「지금 40 기준으로」(원문 `.dev/mp10-evidence/user-decisions-mp10-rebuild-1030.json`) — 드라이버 칸 뒤 끝을 모터 원장의 **실측 `overall_length` 53.5** 에서 읽는다(전 = 몸체 40 + 간격 2 + 드라이버 18 가정 = 60). 두 반쪽 뒤 끝 z −64.0 → −57.5 · 덮개도 같이 6.5 앞으로 · 허브 그대로. 앞뒤 = `.dev/mp10-evidence/rebuild-1030-before-after.json`.
- **다시 만들기 2(2026-10-30 · 단자대 방향)**: 드라이버 뒷면 사진 + 「뒤에서보면 이런데 6단자는 오른쪽 5단자에 아래2개 더있는건 왼쪽이야 뒤에서 봤을떄 위의 4개는 모터에 드가더라」 → 질문 창 「양옆 단자를 이음 쪽으로 (권장)」(원문 `.dev/mp10-evidence/user-decisions-mp10-terminals-1030.json`) — 드라이버를 뒤에서 볼 때 위(모터 선 4 단자) = −x(J4 쪽 칸) · 양옆 단자대(5+2 · 6) = ±y(두 반쪽 이음) · 화면 · 단추 = +x. ±y 에 **단자대 칸 둘**(두 반쪽에 반씩 · 이음 쪽으로 오르는 45° 박공 · 안쪽은 조임 칸과 이어짐)과 **이음 자리 창 둘**(폭 14 · 뒤 끝면 위 2 ~ 7 + 박공 · 높이 12 · 조임 귀 밑으로 밖) · 뒤 덮개 나사 30 · 150 · 210 · 330°. 앞뒤 = `.dev/mp10-evidence/rebuild2-1030-before-after.json`.
- **다시 만들기 3(2026-11-01 · 모터 커넥터 칸)**: 출력한 반쪽 A 에 모터가 끝까지 안 들어감 — 「핀은 잘보이는데 모터 위쪽 커넥터떄문에 더 안으로못들어가는것같은데? 얼만큼을 더 밀고싶엇는지는 내가정확하게는 모르겟는데...」(사진 둘) → 다음 단계 상자 「커넥터 칸을 앞으로 늘릴 값은 어떻게 정할까요?」 에 「재서 알려줄게」 → 잰 값 「1. 29 / 2. 선이 두껍지않고 변형도심하지안하도되서 10mm (커넥팅하고 커넥터 높이가 7mm정도라) / 3. 16 / 4. 이건 사진 첨부 , 모터로 바로가」(사진 하나 · 원문 `.dev/mp10-evidence/user-decisions-mp10-connector-1101.json` · 사진은 저장소 밖). 모터 −x 면(라벨 면) 뒤 뚜껑 위의 **모터 6 핀 커넥터**(앞면에서 29 뒤가 맨 앞 끝 · 높이 10 · 폭 16)가 옛 판에서는 앞면 뒤 38 mm 까지 1 mm 뿐인 공기 틈에 걸렸다. 반쪽 A 에 **모터 커넥터 칸**을 더함 — y −8.6 ~ 14(폭 22.6) · 모터 −x 면 위 깊이 12(옛 칸 범위 y ≤ 11.2 는 옛 칸 바깥 끝 너머 14.1) · 지붕 = y 방향 45° 박공(양 끝 z −27 · 가운데 꼭대기 z −15.7). +y 갈비는 그 뒤가 짧아져 반쪽 A 갈비 닿는 넓이 386 → 323 mm²(하한 300). 반쪽 B · 덮개 · 허브는 그대로(sha 같음). 앞뒤 = `.dev/mp10-evidence/rebuild3-1101-before-after.json`.
- 코드 = `src/cad/j5-wrist-v1/`(생성기 `j5geom.py` · 만들기 `build_j5.py` · 두 번째 구현 `expected_j5.py` · 검사 `validate_j5.py` · 대조 `run_controls.py` · 출력 준비 `print_prep.py` · 렌더 `blender_j5.py`).
- **MP6 사이클로이드 27:1 감속기는 파일 · 부품 그대로 쓴다**(`models/cycloid-27-v1/` — 「비작성자 최종 검수 미통과」 표지 그대로). 바뀌는 것은 출력 플랜지 나사 넷의 길이뿐(M3 × 8 → 12).
- 목(링크 4 쪽 J4 접속판 + 받침)은 반쪽 A 와 한 몸이다 — 사용자 「한 몸 그대로」(2026-10-29 · 원문 `.dev/user-reports-1029/user-reports.json` · 검토 R-4 ③ 닫힘).

## 좌표

모듈 좌표 = MP6 좌표: z = J5 축 · z = 0 = 모터 앞 장착면 · 감속기 출력 면 z = 43.5 · x = 링크 4 의 +x(J4 → J5) · y = 링크 4 의 −z.
링크 4 점 = (x + 78, z − 21, −y) — 관절 원점 · 축 · 거리는 v1 그대로(검사 C5). 부품 STL 은 이 좌표로 저장했다.

## 부품 (인쇄 · PLA Basic · 0.20 Standard · H2D — `.dev/mp10-evidence/printprep.json`)

| 부품 | 하는 일 | 출력 방향 | 질량 · 시간 |
|---|---|---|---|
| `J5_STATOR_A` | 캔 반쪽(J4 쪽) + **목** — J4 출력 면에 닿는 판(반지름 28.5 바깥 0.6 물림) · 45° 받침 · J4 나사 넷 · 모터 선 칸(−x) · 그 창 · **모터 커넥터 칸**(그 앞 · 박공) · 단자대 칸 · 이음 창 반쪽씩 · 받침 아래 케이블 홈 · 타이 구멍 · 조임 귀 둘 | 뒤 끝을 바닥에(z 위) | 46.7 g · 1 시간 31 분 |
| `J5_STATOR_B` | 캔 반쪽 — 조임 귀 둘(인서트 자리) · 단자대 칸 · 이음 창 반쪽씩 | 같음 | 32.1 g · 53 분 |
| `J5_REAR_COVER` | 뒤 덮개(남색 · KMJH 사선 홈) — 두 반쪽을 뒤에서 묶음 · 떼면 드라이버 뒤가 열림 | 바깥 면이 위 | 12.8 g · 22 분 |
| `J5_OUTPUT_HUB` | MP6 출력 플랜지 위 원판(링크 5 뿌리) — 위면에 링크 5 용 M3 인서트 넷(반지름 20.5 · 0°) | 밑면이 바닥 | 10.6 g · 22 분 |

한 판(`print-plate.stl` · `slicer/` = G-code 없는 뱀부 스튜디오 프로젝트 · 보내기 · 출력은 사용자): 102.2 g · 약 2 시간 54 분.
**네 부품 모두 지지대 권고 없이 판정 `ready`**(뱀부 스튜디오 2.8.2.61 · 부품 하나씩도 같음 — C8 이 지지대 없음까지 본다). 색은 KMJH(반쪽 흰 · 덮개 남 · 허브 회).

## 어떻게 붙나

- **모터 조임**: 두 반쪽이 모터 몸통을 x 로 조인다. 한 반쪽에 갈비 둘(폭 6)만 모터에 닿고(반쪽 A 의 +y 갈비는 모터 커넥터 칸 뒤로 짧음), 나머지 x 면은 공기 틈 1.0 이다(사용자가 고른 「모터 둘레 공기 틈」).
  사각 홈이라 돌지 않는다(모양 잠금). 두 반쪽 사이는 1.0 떠야 조임 힘이 모두 모터로 간다.
- **조임 볼트**: 가르는 면 양옆의 귀를 지난다. 반쪽 A 귀의 평평한 바깥 면에 머리가 앉고, 반쪽 B 귀의 인서트로 들어간다. 귀 밑은 45°.
- **MP6 덮개 나사(M3 × 30) 머리**: 바닥판 밑으로 나온다(둥근머리 1.65 · 렌치볼트 3.0 — 어느 쪽이든). 캔 앞 테의 홈(깊이 3.4)에 들어간다. 그 홈은 가르는 면까지 x 로 열려 있어, 반쪽을 옆에서 밀어 넣을 수 있다.
- **J4 쪽**: 목판을 J4 출력 플랜지(가정 = MP6 출력 플랜지)에 얹고 같은 나사 원(반지름 14 · 45°)에 M3 × 16 을 쓴다.
- **케이블**: 전원(6 단자) · 통신(5+2 단자) 선은 양옆(±y) 단자대 칸 → 이음 자리 창 → 캔 바깥을 1/4 바퀴 → 목 받침 아래 45° 홈 → 타이 구멍 둘로 묶어 J4 쪽으로 뺀다. 모터 선(위 4 단자)은 J4 쪽(−x) 칸 안에서 모터로 간다(그 칸의 창은 남는 출구).

## 구매품 (이 단위가 더하는 것 — MP6 BOM 은 MP6 README 그대로 · `docs/BOM.md` 2c)

| 품목 | 수량 | 쓰임 |
|---|---|---|
| M3 × 16(둥근머리 또는 렌치볼트) | 4 | 모터 조임 — 반쪽 A 귀 → 반쪽 B 귀 인서트(물림 5.7 · 끝 ↔ 바닥 1.5) |
| M3 × 16 | 4 | 목판 → J4 출력 플랜지 → J4 캐리어 인서트(J4 가 MP6 같을 때 · 가정) |
| M3 × 12 | 4 | 허브 → MP6 출력 플랜지 → 캐리어 인서트 — **MP6 의 M3 × 8 넷 대신**(끝 자리는 같음) |
| M3 × 10 둥근머리 | 4 | 덮개 → 두 반쪽 인서트(물림 5.7 · 끝 ↔ 바닥 2.0) |
| M3 열압입 인서트(M3 × 5.7 × 4.2 — 보유품) | 12 | 반쪽 B 귀 4 · 두 반쪽 뒤 4 · 허브 위(링크 5 용) 4 |

이 단위 나사 머리는 둥근머리 ISO 7380(Ø5.7 × 1.65)으로 검사했다. MP6 덮개 나사(R08)는 렌치볼트(ISO 4762)여도 된다(홈이 둘 다 받음).

## 조립 순서

1. 인서트: 반쪽 B 귀의 가르는 면에 넷(조임) · 두 반쪽 뒤 끝면에 넷(덮개) · 허브 위면에 넷.
2. **목(반쪽 A)을 J4 출력 플랜지에 먼저 단다**(M3 × 16 넷 · 판의 J5 쪽 자리파기에서). J5 감속기가 아직 없을 때라 렌치가 들어간다.
3. MP6 감속기를 MP6 README 차례대로 조립하되, 마지막 덮개 나사(M3 × 30 넷)까지 끝낸다.
4. **드라이버 커넥터에 선을 꽂아 두고**, 모터 + 감속기를 반쪽 A 쪽(−x)으로 밀어 넣는다. 덮개 나사 머리는 앞 테의 x 길을 따라 홈에 들어가고, 선은 커넥터 칸으로 들어간다.
   **모터 6 핀 커넥터(선 꽂은 채 · 모터 −x 면 뒤쪽)는 반쪽 A 의 모터 커넥터 칸으로 들어간다** — 커넥터 뒤 선은 위 4 단자로 · 선은 드라이버 면에 붙게 안쪽으로 눕힌다(옛 칸 +y 벽에 스치지 않게 · 검토 R4-2). 모터 선(위 4 단자)은 −x 칸에 들어간다. 양옆 단자대(±y)의 전원 · 통신 선은 반쪽 A 쪽 단자대 칸 반쪽을 지나 이음 자리 창에 눕혀 둔다.
   모터 −x 면이 갈비 둘에 닿고, 캔 앞면이 바닥판 밑면에 닿는다.
5. 이음 창에 눕힌 선이 끼지 않게 반쪽 B 를 +x 에서 밀어 넣고 M3 × 16 넷(반쪽 A 귀 바깥에서)으로 조인다. **두 반쪽 사이가 1.0 떠 있어야 맞다**(닿으면 모터가 덜 조임).
6. **MP6 출력 플랜지 나사 M3 × 8 넷을 빼고**, 허브를 얹어 M3 × 12 넷으로 조인다.
7. 뒤 덮개(M3 × 10 넷). 드라이버 화면 · 버튼은 덮개를 떼면 뒤에서 닿는다(화면 · 단추 = 드라이버 뒷면 아래 · +x 쪽 — 사용자 사진 10/30).
8. 양옆 창에서 나온 선을 캔 겉을 따라 1/4 바퀴 돌려(그 사이 약 85 mm 에는 묶을 자리가 없음 — 검토 R3-5) 목 받침 아래 홈에 눕히고 타이 구멍 두 쌍으로 묶는다.

## 검사 (커밋된 STL 로 스스로 계산 — `check.json` · 대조 `.dev/mp10-evidence/controls.json`)

| 번호 | 무엇 | 결과 |
|---|---|---|
| C0 | 만들기 기록의 sha256 = 지금 STL · 입력(매개변수 · 생성기 · 원장 · cycloid.json) | 참 |
| C1 | 부품 넷 닫힘 · manifold 부피 = 메시 부피 > 0 | 참 |
| C2 | 두 번째 구현(정답 형상) ↔ STL 양방향 표면 거리 ≤ 0.03 | 참(넷 모두 ≤ 0.02 — 이 값은 **위쪽 한계**이지 잰 최대가 아님) |
| C3 | 조립 겹침 · 틈 90 쌍(닿기로 한 28 쌍은 실제로 닿음 — 단자대 가정 상자 넷 포함 · 그 밖 겹침 0 · 모터 커넥터 실측 상자 둘 = 사진 어림 자리 · 가운데 자리 ≥ 0.5) | 참 — 모터 커넥터 0.8(어림 자리) · 0.6(가운데) · 반쪽 사이 1.0 · 드라이버 1.0 · MP6 덮개 나사 머리 겉봉 0.4 · 목판 ↔ 감속기 2.0 · 허브 ↔ 누름 고리 1.5 |
| C3b | 닿는 넓이 하한 | 참 — 갈비 ↔ 모터 반쪽 A 323 · B 386 mm² · 앞 테 ↔ 바닥판 1030 · 허브 ↔ 플랜지 1484 · 덮개 ↔ 반쪽 1197 · 목판 ↔ J4 플랜지 1484 |
| C4 | 나사 16 개 — 자리 · 바닥을 STL 에 광선을 쏴 잼 | 참 — 조임 물림 5.7 · 바닥 여유 1.5 / 덮개 5.7 · 2.0 / 허브 · 목 끝 자리 = MP6 출력 플랜지 나사 끝(35.5 · −68) |
| C5 | v1 parameters 독립 순기구학 ↔ kinematics.json · 모듈 z 축 = J5 축 · 목판 면 가운데 = J4 원점 + 18 · J4 축 | 참(오차 0) |
| C6 | J4 한 바퀴(5°) — 모듈 ↔ v3 링크 0 ~ 3 | 참(목판 ↔ v3 J4 덩어리는 면 접촉 · 목 나사 몸통은 J4 로 들어가는 설계라 뺌) |
| C6b | J4 = MP6 가정 — J4 고정 쪽(덮개 · 누름 고리 · 그 나사 머리)을 5° 간격 한 바퀴 | 참 — 최소 틈 0.45 |
| C7 | 단면 71 곳(원천 값에서 끌어낸 자리) 벽 ≥ 2.0(열림 연산 · 지운 조각 ≤ 1.5 mm²) | 참 — 가장 큰 조각 1.24(45° 예각 모서리 — 얇은 벽 아님) |
| C8 | 출력 준비 기록 = 지금 STL · 판정 `ready` · 지지대 없음 | 참 |
| C9 | J5 한 바퀴(15°) — 허브 · 허브 나사 ↔ 고정 쪽 | 참 — 틈 ≥ 1.0 |
| C10 | 반쪽을 옆에서 밀어 넣는 길(0.25 ~ 45 mm 21 자리) — 모터 · 드라이버 · 커넥터 · 단자대 둘 · 모터 커넥터 실측 상자 둘 · MP6 덮개 나사 머리 겉봉 | 참 — 겹침 0 |
| C11 | 창이 밖으로 열림 — 창 상자 단면 속(가장자리 0.3 안) 막대를 칸 바깥 끝에서 캔 밖까지 · 반쪽과 겹침 0(이음 창 둘 · −x 창) | 참 — 이음 창 폭 14 · 상자 5 + 박공 7 |
| C12 | 덮개 인서트 구멍 넷 — 둘레 2.0 고리가 모두 재료 · 구멍 속은 비어 있음 | 참 |

**양성 대조 21**(생성기 · 검사기에 고장을 넣은 판을 검사기가 잡는지 — 잡아야 할 검사와 C2 가 모두 거짓이어야 잡힘):
- 다시 만들기 3(11/01) 뒤 한 번에 돌린 `.dev/mp10-evidence/controls.json` 에서 **21 개 모두 잡혔다**(all_caught = True). 홈 각 · 조임 칸 좁힘 · 드라이버 칸 좁힘 · 반쪽 틈 0 → C3, 목판 1 mm 밀림 → C5, 허브 키움 → C9, 덮개 인서트 바깥 → C7,
  볼트 자리 얕음 · 목 / 허브 나사 자리 · 덮개 인서트 얕음 → C4, 갈비 좁힘 → C3b, 머리 길 없앰 → C10, J4 면 물림 없앰 → C6b, 인서트 원 반지름 22.5 → C2, 단자대 칸 1.5 좁힘 → C3, 이음 창 막음 → C11, 덮개 인서트 옛 각(70 · 110 · 250 · 290°) → C12, 모터 커넥터 칸 없앰(옛 판 — 사용자가 실물로 겪은 고장) → C3 · C10, 열린 메시 → C1, 기록 ↔ 파일 sha 어긋남 → C0.
- C2 는 생성기 고장 19 개 중 19 개에서 거짓이었다.
- 첫 만들기(10/28)에는 `insert_r` 고장 값 23 이 허브 위 모따기 끝과 맞닿아 SolidCraft 가 만들기를 거부했다(대조 무효) → 22.5 로 바꿔 그것만 다시 돌려 잡았다(`controls-insert_r-rerun.json` — 그때 기록).

## 질량 (어림 — `mass-properties.json`)

모듈 합 약 **662.1 g**(무게중심 모듈 좌표 (−1.2, 0, −8.6) — 링크 4 로 (76.8, −29.6, 0)): J5 인쇄 부품 102 g · MP6 인쇄 부품 90 g · 모터 + 드라이버 310 g(원장 가정) ·
강철 다월 89 g · 베어링 45 g(어림) · 나사 · 인서트 27 g(어림). 인쇄 질량 = 슬라이서 값.

## 가정 · 한계

- 모터 몸체 40 · 몸체 ↔ 드라이버 간격 2 · 앞 판 42.3 · 드라이버 46 각 · 커넥터 12 mm(−x 쪽) · 모터 + 드라이버 310 g — 원장 가정값(몸체 · 간격은 따로 안 잼).
  드라이버 칸 뒤 끝 = **실측 전체 길이 53.5**(10/29 · 뒤 단자대 끝까지 잰 값 — 원장 note 의 뜻으로 읽음 · 원장 means 는 「덮개 면까지 · 단자 제외」 라 서로 다름) → 몸체 + 간격 42 뒤 드라이버 칸 11.5. 몸체 쪽 겹침에는 넉넉한 쪽이지만, **단자대 끝 뒤 여유는 덮개 안면까지 4 · 커넥터 칸 바닥까지 1 mm 뿐**이다(전 판 10.5 · 7.5).
  단자대 위치 = 사용자 사진(10/30 · 위 4 · 왼쪽 5+2 · 오른쪽 6). 단자대 크기 · 선이 들어가는 방향은 안 잼 — 칸 바깥 끝 = 원장 커넥터 여유 12(가정) · 단자대 가정 상자 x 반폭 10. 전원 · 통신 선은 이음 자리 창(폭 14 · 높이 12)으로 나간다(창 크기 하한 검사 없음). J4 쪽(−x) 칸의 창(직사각 5.5 + 박공)은 이제 남는 출구다.
  **단자대 칸 안쪽은 조임 칸과 이어져** 모터 ±y 면(원래 닿지 않는 면)이 |x| ≤ 11 · 높이 −41 ~ 약 −30 에서 드러난다(갈비 조임 · x 방향은 그대로) — 칸 지붕을 바깥 벽 쪽으로 올리는 꼴은 이음 쪽이 열린 칼날 모서리가 되어 뱀부 스튜디오가 「floating cantilever」 를 냈다(parameters roof_note).
  단자대 칸 반폭 11 · 검사 가정 상자 반폭 10 은 −x 칸의 가정을 옮긴 값이다(사진 어림으로 왼쪽 5+2 묶음이 x 약 +11 까지일 수 있음 — 단자대 길이 · 치우침 실측 전 · 검토 R3-2). 칸 · 창이 아래 조임 귀 밑의 안쪽 벽을 지워 「귀 → 갈비」 하중 단면이 줄었다 — 강성은 재지 않음(실물 시험 항목 · 검토 R3-4).
  **모터 6 핀 커넥터**(11/01 실측 — 앞 끝 29 · 높이 10 · 폭 16)의 **y 자리는 재지 않았다** — 위 사진 화소 어림 +4(사진 위 = +y 로 읽음). 칸 y −8.6 ~ 14 은 어림 자리와 가운데 자리를 모두 덮는다(검사 C3 · C10 이 두 상자 다 봄). −y 로 1 mm 넘게 치우쳐 있으면 맞지 않는다. +y 쪽은 커넥터 5+2 단자 쪽 끝이 모터 옆면에서 8.2 보다 가까우면 설계 여유 1.05 아래다(검토 R4-1 의 사진 읽기 = 끝 +12.9 ~ +13.2 → 여유 0.8 ~ 1.1 · 그 거리는 아직 안 잼). 11/05 넓히기(y1 15.3 · 14.6)는 둘 다 C7 얇은 띠로 버렸다 — 넓히려면 −y 띠(y0 · 갈비 규칙)도 같이 바꾼다(`.dev/mp10-evidence/rebuild3-1105-widen-tries.json`). 커넥터 값은 J5 매개변수 · 결정 파일에만 있고 모터 원장에는 없다(원장 단위에 넘김).
  **원장 값(모터 · 끼움)이 바뀌면 이 단위를 다시 만든다**: `build_j5.py` → `print_prep.py` → `validate_j5.py`. 생성기가 원장을 직접 읽고, 원장 sha 가 어긋나면 C0 이 거짓이 된다.
  모터 원장의 「생성기가 자동으로 읽지 않는다」 안내는 그 전 모델들 이야기다(원장은 보호 파일이라 고치지 않음).
- **모터 조임은 모양(사각) 잠금 + 갈비 마찰**이다. 크리프로 조임이 풀리면 축 방향(모듈이 빠지는 쪽)은 마찰에만 기댄다 — 실물 시험 항목.
- J4 접속(판 면 = 링크 4 x 18 · 나사 넷 반지름 14 · 45° · 바깥 물림)은 J4 를 설계할 때 바뀔 수 있다. 중심 맞춤 턱은 끼움 값이 원장에 없어 두지 않았다(나사 구멍 틈만큼 ± 0.2 어긋날 수 있음 — 허브도 같음).
- PLA 는 모터 · 드라이버 열에 약하다(갈비 밖 공기 틈 1.0 · 드라이버 둘레 1.0 · 덮개로 닫힘 — 통풍 없음).
- **두 번째 구현(`expected_j5.py`)은 같은 작성자가 같은 세션에 썼다.** 작은 여유 수까지 생성기와 같으므로 C2 는 의도의 독립 판단이 아니라 SolidCraft ↔ manifold3d 의 일치 확인에 가깝다.
  설계 의도는 C3 · C3b · C4 · C5 · C6b · C7 · C9 · C10 의 측정 검사가 본다.
- 감속기 · 다월 · 베어링 질량은 어림이다.

## 다시 만들기

```powershell
$py = "C:\projects\printforge\.venv\Scripts\python.exe"; $cli = "C:\tools\SolidCraft-0.18.2\solidcraft-0.18.2-windows-x64-portable\solidcraft-cli.exe"
& $py -B src\cad\j5-wrist-v1\build_j5.py --cli $cli --scratch-root <MP10_SCRATCH 표지가 있는 작업 폴더>
& $py -B src\cad\j5-wrist-v1\print_prep.py --printforge C:\projects\printforge --scratch-root <같은 작업 폴더>
& $py -B src\cad\j5-wrist-v1\validate_j5.py --scratch-root <같은 작업 폴더>
& $py -B src\cad\j5-wrist-v1\run_controls.py --cli $cli --scratch-root <같은 작업 폴더>
& C:\tools\Blender-5.2.3\blender-5.2.3-windows-x64\blender.exe -b --factory-startup --python src\cad\j5-wrist-v1\blender_j5.py -- --scratch-root <같은 작업 폴더>
```

구글 드라이브가 방금 쓴 파일에 임시 하드 링크를 걸면 가드가 다시 쓰기를 거부한다 → 이 폴더의 생성 파일(README 는 빼고)을 지우고 다시 돌린다.
