WINNAKEN/robot-arm-lab/models/kmjh-gripper-v1/README.md

# KG1 — 첫 그리퍼 (MP8 · 2026-10-28) — 3D 출력물을 트레이에서 집어 옮기는 평행 집게

> **검수 상태: Codex 비작성자 검수 없음.** 형상 · 맞물림 · 행정 · 구멍 · 출력 · 출처는 커밋된 STL 로 스스로 계산하는 검사(`verify_gripper.py` — 키 34 모두 참)와
> 양성 대조 29 건 · 가드 대조 29 건(`run_controls.py` — 모두 맞음)으로 확인했다. Claude 하위 에이전트 독립 산출 검토의 지적과 처분 = `.dev/mp8-evidence/review.md`
> (계획 검토(만들기 전)와 고친 뒤 다시 검토는 하지 않았다). **출력 · 조립 · 구동은 하지 않았다** — 끼움 값 다섯(관 미끄럼 · 관 고정 · M3 꼭 맞는 구멍 · 피니언 · 랙 백래시)과
> M2 통과는 시험 전 임시값이다. 먼저 **시험편 판(KG1_FIT)** 을 출력해 정한다(M2 는 서보가 온 뒤).
>
> **MP19(2026-11-07) — 시험편 판정 반영 · 다시 만들기**: 시험편 판(KG1_FIT · H2D 판 38 · 흰 PLA Basic) 판정 넷을 원장 `pending` 칸에 넣고(provisional) 다시 만들었다 — 피니언 깎음 0.10 → **0.15** · 관 미끄럼 6.25 → **6.2** · 관 고정 6.05 → **6.1** · M3 꼭 맞는 3.2(값 그대로). 바뀐 부품 STL = BASE · JAW_A · JAW_B · PINION(나머지 12 은 바이트 같음 · 바뀐 자리 = 관 구멍 · 피니언 이 옆면뿐 — `.dev/mp19-evidence/regen-compare.json`). 검사기 상수 둘을 원장에서 읽게 고친 뒤(사용자 결정 「검사 상수를 원장에서 읽게 (권장)」) 키 34 모두 참 · 양성 대조 29 · 가드 대조 29 다시 맞음. 랙 백래시 몫 · M2 통과는 여전히 시험 전 값. 판정 원문 = 원장 observations · `.dev/mp19-evidence/user-decisions-mp19.json`.

요청: 「이제 좀더 해당 장비 설계부분 더 보강하자」 · 「추가로 그립퍼 어떻게했으면좋겟는지 참고로 난 첫 그리퍼는 3d 프린터 출력물 집는데 쓸거야」.
결정(질문 창 원문 = `.dev/mp8-evidence/user-decisions-mp8.json`): G1 「STS3215 12V 버스 서보 (권장)」 · G2 「그리퍼 포함 0.5 kg (권장)」 ·
G3 「중간 (폭 80 mm · 200 g 이하)」 · G4 「정해진 자리(트레이 · 지그)에서 (권장)」 · G5 「Ø6 금속 봉 + 인쇄 턱 구멍 (권장)」 · G6 「탄소 관 6 × 4 (권장)」.
계획 = `docs/design/046-design-reinforcement-gripper.md` · 생성기 = `src/cad/kmjh-gripper-v1/` · 기록 = `.dev/mp8-evidence/`.

**결정 때 안내와 달라진 것**: G6 질문 문구는 「봉은 둘」 이었으나 설계는 **턱마다 둘 = 넷**(관을 함께 쓰면 긴 슬리브끼리 부딪히고, 랙 하나를 길게 내밀면 휨이 큼) ·
질량 **184 g**(G5 설명 「약 155 ~ 180 g」 · 계획 목표 170 g 보다 큼 — 가반 0.5 kg 은 지킴) · 가로 폭 약 165 → 140 mm(작아짐).
→ 사용자 답(2026-10-28): 「탄소봉 네게 써도되고 무게좀더 무거운건 괜찬아」 — 관 넷 · 184 g 그대로 간다.

닫힘
80 mm 벌림

(뒤에서 본 80 mm 벌림 = `render-open80-back.png` · SolidCraft 그림 = `iso.png` · `front.png` · `top.png`)

## 구조

서보(Feetech STS3215)를 **눕혀** 축을 앞(+y)으로 두고, 그 축의 피니언(m1.5 · 18 잇 · 피치 반지름 13.5) **위에 랙 A, 아래에 랙 B** 가 물린다.
피니언이 돌면 두 랙이 반대로 같은 거리만큼 움직여 두 턱이 가운데를 기준으로 같이 열리고 닫힌다. 턱마다 **자기 탄소 관 둘**(Ø6 × 4)을 타고 미끄러진다
(턱 A = 위 관 둘 · 턱 B = 아래쪽에서 세운 벽으로 올라와 뒤 관 둘). 손끝은 나사 둘로 갈아 끼운다(평면 · V 홈).

- 좌표: 원점 = 팔 공구 플랜지에 닿는 면 가운데 · +z = 다가가는 쪽 · x = 턱이 움직이는 쪽. 손끝 가운데 = 팔 J6 축 위(x 0 · y 0).
- 행정: 손끝 사이 0 ~ **94 mm**(한쪽 47 · 물체 80 + 여유) · 서보 199.5° · 닫힘 = 두 손끝이 맞닿음(원점).
- 트레이에서 집기: 손끝 끝(z 106)을 트레이 가까이 대면 **물체 높이 47.5 mm 까지**(그보다 높으면 슬리브 밑(z 58)에 닿음 — 손끝을 띄워 쥠). 검사 G4 가 80 × 20 × 47.5 상자를 81 벌림에 놓아 본다.
- 크기: 가로 140(받침 기둥 끝) × 깊이 약 70(서보 뒤 커넥터 제외) × 높이 106(손끝 끝 · 팔 플랜지에서).
- 무게: **약 183 g**(인쇄 103 g = 슬라이서 · 서보 55 · 관 13 · 혼 3 · 나사 · 인서트 9 — MP19 다시 만들기 · 출력 준비 = printforge printprep 보고서 판 2 · 벽 arachne) · 무게중심 (3.4, −6.9, **35.7**) mm — `mass-properties.json`.
- 손끝 힘(한 턱 · 두 랙이 반씩 · **안내 마찰 무시**): 서보 정격 0.98 N·m → 36 N · 서보 EEPROM 상한 50 % 1.47 N·m → 54 N · 정지 2.94 N·m → 109 N.
  200 g 출력물에 필요한 힘은 SMC 지침 「10 to 20 times the workpiece weight」 를 한 턱에 대어 **19.6 ~ 39.2 N** → 서보 0.53 ~ 1.06 N·m(마찰 무시).
  턱 B 는 구동점(랙 B)이 관보다 39.5 아래라 안내 마찰이 커서 효율이 50 ~ 64 % 쯤으로 떨어질 수 있다(어림) — 실제 쥠 힘은 첫 구동 때 재서 정한다. **토크 상한이 꼭 필요하다**(얇은 벽 출력물 · PLA 기어).
- 기어 굽힘(루이스 · 이 너비 9 · 피니언 Y 0.309 · 랙 0.485 = 원문 미확인): 한 랙 몫 0.5 / 0.6 일 때 피니언 — 정격 8.7 / 10.4 · EEPROM 50 % 13.1 / 15.7 · 정지 26.1 / 31.3 MPa ·
  랙 — 정격 5.5 / 6.7 · 50 % 8.3 / 10.0 · 정지 16.6 / 20.0 MPa. 비교 기준은 PLA 층 사이 인장 하한 **31 MPa**(랙 B 이는 층을 가로지름 · 피니언 이는 층 면 안).

## 부품 (인쇄 — H2D 0.4 · PLA Basic · 0.20 Standard · 지지대 없음 · 슬라이서 「ready」)

| 부품 | 역할 | 출력 방향 | 질량 g · 시간 |
|---|---|---|---|
| `BASE` | 원판(Ø56 · 팔 플랜지에 닿음 · 아랫면 Ø20 맞춤 홈 · **앞면 x 0 세로 맞춤 홈**) · 판 · 받침 기둥 둘(관 넷 — L 미끄럼 · R 고정) · 서보 벽(Ø21 혼 구멍 · M2 홈 넷 · 위 둘 자리파기는 꼭대기까지 틈) · 버팀 둘 · **서보 받침 턱**(벽 뒤 · 서보 아래 옆면) · 카메라 자리 M3 통과 둘(x ±20 · y 22 · 원장 `m3_clearance_dia` 3.4 임시값) | 그대로(z 위) | 46.5 · 79 분 |
| `JAW_A` | 턱 A — 슬리브(관 둘) · 위 랙(이 아래) · 랙 뒤 45° 받침 · 손끝 대 10 mm(+y 면 인서트 둘) | **y 를 위로**(랙 이가 층 안에) | 19.0 · 40 분 |
| `JAW_B` | 턱 B — 아래 랙(이 위) · 세운 벽 · 45° 갈비 셋 · 슬리브(관 둘) · 손끝 대 10 mm(윗면 인서트 둘) · 대 아래 45° 쐐기 | 그대로(z 위 · 랙 이는 층을 가로지름) · **브림 켬**(높이 93.5 · 바닥 깊이 14.5) | 25.6 · 61 분 |
| `PINION` | 피니언 m1.5 · z18 · 이 너비 9 · 허브 Ø20 × 2(혼 바깥면에 앉음) · 혼에 M3 넷(Ø14 원 · **꼭 맞는 구멍** — 혼 위 가운데 맞춤) · 가운데 Ø6(혼 나사 머리) | 앞면(나사 자리파기)을 판에 | 4.1 · 20 분 |
| `PAD_A_FLAT` · `PAD_B_FLAT` | 평면 손끝(끝 바깥 45° 모따기) | 맞닿는 면을 판에 | 4.1 · 3.7 |
| `PAD_A_V` · `PAD_B_V` | V 홈 손끝(세로 90° 홈 깊이 2 — 둥근 출력물) | 맞닿는 면을 판에 | 4.2 · 3.8 |
| `FIT_BLOCK` | 시험편 — 눕힌 관 구멍 Ø5.9 / 6.0 / 6.1 / 6.2 / 6.3 / 6.4(길이 8 = 기둥 두께 · 윗면 홈 1 ~ 6 개 = 순번) + 날개의 세로 M3 구멍 3.1 / 3.2 / 3.3(홈 1 ~ 3 개) | 그대로 | 6.3 · 21 분 |
| `FIT_MESH` | 맞물림 지그 — 판 · 핀 Ø5.8(시험 피니언 가운데 구멍에) · 바깥 벽 둘(랙 막대가 기대어 미끄러짐 · 피치선이 핀에서 13.5) | 그대로 | 9.8 · 21 분 |
| `FIT_RACK_A` | 랙 막대 — **눕혀 출력**(이 윤곽이 층 면 안 = 턱 A 와 같음) · 이 두께 = 원장 `gear_thinning_rack` | 그대로 | 2.1 · 12 분 |
| `FIT_RACK_B` | 랙 막대 — **세워 출력**(이끝 위 · 층을 가로지름 = 턱 B 와 같음) · 쓸 때는 옆으로 눕혀 지그에 | 그대로 | 2.3 · 11 분 |
| `FIT_PINION_005` · `_010` · `_015` · `_020` | 시험 피니언 — 이 두께에서 0.05 / 0.10 / 0.15 / 0.20 뺌(본 피니언 = 원장 `gear_thinning_pinion` — MP19 판정 0.15) | 피니언과 같음 | 4.0 ~ 4.1 |

출력 판(G-code 없는 뱀부 스튜디오 프로젝트 · 보내기는 사용자): **`slicer/fit/`(KG1_FIT · 36.5 g · 1 시간 43 분 — H2D 판 38 로 뽑아 판정 끝 · MP19)** · `slicer/main/`(본판 8 부품 ·
110.9 g · 3 시간 27 분 · MP19 출력 준비 = 뱀부 스튜디오 02.08.02.61 · printforge `51814f6` · 벽 arachne). 판 STL = `print-plate-fit.stl` · `print-plate-main.stl`. 부품 STL = `parts/` · native `kmjh-gripper-v1.solidcraft` · STEP · 3MF.
본판의 턱 B 는 브림을 켜고 보낸다(프로젝트에는 켜 두지 않았음 — 보낼 때 사용자 설정).

## 구매품 (BOM `docs/BOM.md` 2b 절 G01 ~ G11 · 구매는 사용자)

| 품목 | 수량 | 쓰는 곳 |
|---|---|---|
| Feetech STS3215 **12V (C018)** + 동봉 혼 · 혼 나사 M3 × 6 | 1 (+ 예비 1 권장) | 구동 |
| Waveshare Bus Servo Adapter (A) | 1 | 제어 보드 IO1 · IO2 ↔ 서보(TTL) |
| 24 → 12 V 강압기(연속 3 A 이상 · 정지 전류 2.7 A) + 24 V 분기 퓨즈 | 1 | 서보 전원(팔 구동은 24 V — 둘 자리는 배선 문서에서) |
| 탄소 관 **6 × 4**(바깥 6 · 안 4) — 140 mm 넷(사용자 확정 10/28 · 결정 문구는 「둘」 이었음) | 560 mm 이상 | 턱 안내 |
| M2 × 5 둥근머리(또는 낮은 냄비) — **머리 지름 ≤ 3.8 · 높이 ≤ 1.6** | 4 | 서보 → 벽(자리파기 Ø4.0 × 1.8 · 일반 냄비 머리는 안 씀) |
| M3 × 6 렌치볼트 | 4 | 피니언 → 혼(혼 탭 깊이 2.5 — **더 긴 나사 금지**) |
| M3 × 8 둥근머리(ISO 7380) | 4 | 손끝 둘씩 |
| M3 렌치볼트(길이는 팔 쪽 설계 때) | 4 | 받침 → 팔 플랜지(머리는 원판 자리파기 Ø6.2 × 3 안) |
| M3 열압입 인서트(가진 것 · M3 × 5.7 × Ø4.2) | 4 | 손끝 대 |

## 끼움 값 — 원장 `src/cad/calibration/print-fits.json` 하나

| 키 | 값 | 상태 | 쓰는 곳 |
|---|---|---|---|
| `insert_hole_dia` | 4.0 | **확정**(세로 구멍) | 손끝 대 인서트(두 턱 모두 출력 방향에서 세로) |
| `m3_clearance_dia` | 3.4 | 임시값 | 나사 통과(손끝 · 팔 · 카메라) |
| `rod_slide_hole_dia` | 6.2 | 판정 provisional(pending · MP19) | 슬리브 구멍(양 끝 12 mm 씩 · 가운데 Ø7 비움) · L 기둥 |
| `rod_press_hole_dia` | 6.1 | 판정 provisional(pending · MP19) | R 기둥 관 고정 |
| `m3_close_hole_dia` | 3.2 | 판정 provisional(pending · MP19) | 피니언 나사(혼 위 가운데 맞춤) |
| `gear_thinning_pinion` | 0.15 | 판정 provisional(pending · MP19) | 피니언 이 두께 |
| `gear_thinning_rack` | 0.10 | 임시값(pending) | 랙 이 두께(턱 A · B · 시험 막대 — 시험 동안 바꾸지 않음) |
| `m2_clearance_dia` | 2.4 | 임시값(pending) | 서보 나사(위면 폭 간격 20.1 ~ 20.5 를 홈으로 받음) — 서보가 온 뒤 확인 |

새 키는 원장의 `pending` 칸에 있다(감속기 MP6 은 `values` 만 읽어 지문을 묶으므로 — 지문 그대로 확인함).

## 먼저 할 일 — 시험편 판 KG1_FIT (출력은 사용자 · MP19 에서 끝남 — H2D 판 38 · 판정 원문 = 원장 observations)

1. **관 구멍**(`FIT_BLOCK` 앞쪽 · 길이 8 = 기둥 두께): 탄소 관을 구멍마다 넣어 본다 — 판정 말 「안 들어감 / 손으로 밀어 넣음(빠지지 않음) / 쑥 미끄러지고 흔들림 없음 / 흔들림」.
   → **미끄러지고 흔들림 없는 가장 작은 구멍 = `rod_slide_hole_dia`** · **밀어 넣으면 빠지지 않는 구멍 = `rod_press_hole_dia`**.
2. **M3 꼭 맞는 구멍**(`FIT_BLOCK` 날개 · 홈 1 ~ 3 개 = 3.1 / 3.2 / 3.3): M3 나사가 손으로 들어가고 흔들림 없는 가장 작은 구멍 → `m3_close_hole_dia`.
3. **맞물림**(`FIT_MESH` + 랙 막대 둘 + 시험 피니언 넷): 막대 A 는 그대로 눕혀, 막대 B 는 옆으로 눕혀 이가 핀을 보게 두 벽 안쪽에 대고, 시험 피니언을 허브를 아래로 핀에 끼운다.
   막대 하나를 x 로 밀면 피니언이 돌며 다른 막대를 반대로 민다(그리퍼와 같음). 「뻑뻑 / 부드럽고 덜컹 없음 / 덜컹」 —
   **부드럽고 덜컹이 가장 적은 피니언의 번호(0.05 / 0.10 / 0.15 / 0.20)를 `gear_thinning_pinion` 에 그대로** 적는다(랙 값은 그대로 두므로 합계가 시험과 같다).
4. 알려 주시면 원장에 원문 그대로 적고, 키를 `pending` → `values` 로 옮기며 **`parameters.json` 의 `fits_from` 목록도 같이 옮긴 뒤**(안 옮기면 생성기 · 검사가 멈춤)
   아래 「다시 만들기」 차례로 다시 만들어 본판을 준비한다(그때 MP6 도 `make_all.py`).

## 조립 순서

차례가 중요하다 — **턱 B 의 세운 벽이 피니언 앞을 가려서, 턱 B 를 넣은 뒤에는 피니언 · 혼 나사에 손이 닿지 않는다.** 검사 G8 이 이 차례의 빼내는 길(거꾸로)을 1 mm 마다 본다
(혼 높이 2.65 · 3.0 두 끝 · 관 없는 턱 A 가 0.3 처진 경우 포함).

1. `BASE` 를 팔(또는 시험대)에 먼저 고정 — 팔 나사 넷(Ø31.5 원)은 서보 · 턱이 들어오면 위에서 닿지 않는다(그리퍼를 떼려면 관 → 턱 B → 턱 A → 피니언 → 서보 순으로 푼다).
2. 서보를 벽 뒤에서 대고, **서보 아래 옆면을 받침 턱에 눌러 댄 채** M2 × 5 넷을 조인다(벽 앞 홈 — 피니언을 달면 가려짐). 받침 턱이 서보 높이(피니언 ↔ 랙 거리)를 정한다.
3. 스플라인 혼 + 혼 나사(가운데 M3 × 6) — 혼은 스플라인 어느 자리에 끼워도 된다.
4. 피니언을 혼에 대고 M3 × 6 넷(꼭 맞는 구멍 — 피니언이 혼 가운데에 선다).
5. 턱 A 를 **위에서 내려** 랙 A 를 피니언 위에 물린다 — 닫힘 가까이(손끝 대 안쪽 면이 받침 앞면 맞춤 홈에서 왼쪽 약 4 mm).
6. 턱 B 를 **앞(+y)에서 밀어 넣는다** — 랙 B 가 피니언 아래를 축 방향으로 미끄러져 물린다(손끝 대 안쪽 면이 홈에서 오른쪽 약 4 mm — 두 턱이 홈 양쪽으로 같은 거리).
7. 관 넷: 앞끝을 살짝 모따기하고 **L 기둥(미끄럼)으로 넣어** 두 슬리브를 지나(관 없는 턱은 0.3 ~ 0.5 처져 있으니 들어 맞춤) **R 기둥에만 눌러 끼운다**(바깥면과 같은 높이).
   R 이 헐거우면 다 끼운 뒤 바깥면에서 접착제를 스며들게(L 쪽은 붙이지 않음 — 빼낼 때 R 쪽에서 Ø5 막대로 밀어냄).
8. 손끝(평면 또는 V) — A 는 옆 날개를 대 +y 면에, B 는 덮개를 대 윗면에 M3 × 8 둥근머리 둘씩.
9. 처음 돌리기 전에 **서보 EEPROM 토크 상한을 먼저** 낮춘다(아래 Codex 몫). 천천히 닫아 **두 손끝이 맞닿는 선이 받침 앞면 맞춤 홈 위(± 1 mm)** 인지 본다 —
   약 2.4 mm 비켜 있으면 턱 하나가 한 이 어긋난 것이니 턱 B 를 앞으로 빼서 한 이 옮겨 다시 넣는다.
10. 서보 케이블은 묶음끈으로 받침 기둥 쪽에 붙여 J6 회전에 끌리지 않게(고정 자리는 다음 판 — 검토 G12).

## 제어 · 펌웨어 (Codex 몫 — 이 단위는 고치지 않음)

한 목록은 `.dev/HANDOFF.md` MP8 절의 「Codex 에게」(① ~ ⑧): UART 두 번째 구동 경로의 정지 · 제어권 · `Max_Torque_Limit`(주소 16 · EEPROM) 50 % 이하 ·
시작 토크(200 g 이면 0.53 ~ 1.06 N·m · 마찰 무시) · 손끝 간격 = 2 × 13.5 × θ · 닫힘 0 = 손끝 맞닿음 · **조립은 닫힌 자리에서 하므로 199.5° 가 서보 원시 0 / 4095 경계를 넘을 수 있다 —
닫힘 자리 오프셋(서보 위치 보정)을 펌웨어에서 정함** · 강압기 · 퓨즈 배선 · 어댑터 논리 전압(잇기 전 멀티미터 — 사람 점검) · URDF 그리퍼 링크 · 확장 헤더 핀 간격 확인.

## 짐 판정 (MP5 계산기를 입력 사본으로 다시 — `.dev/mp8-evidence/loads-gripper/summary.json`)

그리퍼 183 g + 출력물 200 g = **383 g**(MP19)(가반 0.5 kg 안). 물체 무게중심(쥐는 점)은 높이 셋으로 본다 — 손끝 판 가운데 82.25 · 트레이에서 20 mm 물체 96 · 6 mm 물체 103(기본 · 최악).
여유 = 그 짐에서의 토크 여유(부호 있음 · MP5 표처럼 0.1 % 아래 내림).

| 후보(칸) | 기본(쓸 수 있는 토크 50 %) — 82.25 / 96 / 103 | 비관(40 %) — 82.25 / 96 / 103 |
|---|---|---|
| 손목 사이클로이드 27:1 · NEMA17-40 | 25.5 / 23.2 / 22.1 % | **0.4 / −1.4 / −2.3 %**(트레이 집기에서 부족) |
| 손목 27:1 · NEMA17-48 | 74.1 / 71.2 / 69.7 % | 39.3 / 37.0 / 35.8 % |
| 손목 54:1 · NEMA17-40 | 138.4 / 134.1 / 132.0 % | 90.7 / 87.3 / 85.6 % |
| 어깨 J2 칸 135:1 · NEMA17-48 | 9.9 / 9.6 / 9.4 % | **부족** |
| 어깨 J2 칸 162:1 · NEMA17-48 | 31.9 / 31.5 / 31.3 % | 5.5 / 5.2 / 5.1 % |
| 어깨 J2 칸 81:1 · NEMA23-56 | 35.3 / 35.0 / 34.8 % | 8.3 / 8.0 / 7.9 % |

어깨 칸은 J2 를 본다(같은 구동이면 J3 여유가 더 큼). 어깨 · 손목 구동은 여전히 「두 축 시험 실측 뒤 결정」(사용자) — 이 표는 그 결정의 입력이다.
손목을 27:1 · NEMA17-40 으로 가면 트레이 집기의 비관 경우가 모자라므로 **NEMA17-48 이나 앞단 2:1(54:1)** 이 안전하다(모터 실측 원장 · 영향 표 참고 — 손목 여유 0 이 되는 NEMA17-40 유지 토크 = 기본 0.328 / 비관 0.41 N·m).

## 검사 (`.dev/mp8-evidence/gripper/verify.json` — 키 34 모두 참)

- G0 출처: 부품 STL · native · STEP · 3MF sha256 = 만들기 기록 · 출력 키 집합 = 독립 기대 집합 · 입력 sha256 = 지금 파일 · 쓴 끼움 값 = 원장 · 출력 준비 기록의 부품 · 판 · 슬라이서 파일과
  질량 기록의 부품 sha256 = 지금 파일 · 만들기 도구(`solidcraft-cli 0.23.0` · sha256) 기록.
- G1 부품 16 = 독립 표 · 닫힌 메시 · manifold 부피 = 메시 부피(바꾸기에 실패한 입체가 빈 입체로 조용히 통과하지 않게).
- G2 표본 u 0 · 2 · 10 · 23.5 · 35 · 47 × 손끝 두 벌: 인쇄 부품이 낀 모든 쌍(서보 몸통 · 커넥터 자리 · 혼 · 혼 나사 · 서보 나사 머리 · 몸통 · 피니언 나사 머리 · 몸통 · 관 넷 ·
  팔 나사 · 손끝 나사 포함) 교차 ≤ 0.01 mm³ · **움직이는 쌍은 δ 0.3 옮겨도 ≤ 0.01**(빼는 방향은 이름 표로만) · **놀음 끝 여덟**(혼 높이 2.65 · 턱이 관 위에서 ±0.1(원장 관 미끄럼 − 관 6.0 의 반 · 턱 ↔ 관은 0.02 덜 민 자리 — MP19) · 피니언이 나사 구멍 안에서 0.1) ·
  피니언 나사 끝 ↔ 서보 몸체.
- G3 위상 표본 20(23.5 ~ 28.25) + 표본 u: 피니언 ↔ 랙 겹침 없음 · 피니언 비킴 + 관 놀음(0.2)만큼 밀어도 겹침 없음(최소 백래시) · 원장 백래시 반경 환산 0.3434 + 0.125 = 0.4684 밀면 겹침 > 1 mm³(물려 있음 · 가장 작은 겹침 1.793 mm³ — MP19 에서 옛 고정 0.4 를 원장 읽기로).
- G4 손끝 간격 = 2u · 최대 94 · 서보 각 ≤ 300° · 물체 상자 80 × 20 × 47.5 가 81 벌림에서 아무 데도 안 닿음.
- G5 선언 구멍 73 개: 지름 = 출처(원장 · parameters · 시험편 목록) · 안이 빔(M2 홈은 홈 길이 탐침) · 둘레 재료(인서트 · 관 · 시험편) · 개수 표와 꼭 같음 · 인서트가 출력 방향에서 세로.
- G6 출력 방향별: 판 안 · 판 닿는 넓이 · 아래 향한 면마다 다리 길이(가파른 면 20 · 수평 30 mm 넘거나 한쪽이 비면 받침 없음 — 받침 없는 넓이 ≤ 5 mm²). G7 루이스 · 꽉 찬 질량 상한.
- G8 조립 경로: 턱 A 를 위로 80(혼 높이 두 끝) · 턱 B 를 앞으로 40(턱 A 정위치 · 0.3 처짐) 빼내는 길에 겹침 ≤ 0.01(1 mm 마다) · 관 축 = 기둥 구멍 = 슬리브 구멍 = 치수 파일 ·
  L 기둥 = 미끄럼 · R 기둥 = 고정.
- 양성 대조 = `.dev/mp8-evidence/gripper/controls.json`(29 건 — 거짓이 된 키 집합이 밝힌 기대 집합과 꼭 같고, G2 계열은 겨냥한 쌍 이름까지 · 가드 대조 29 — 거부 사유 조각까지).
  **대조가 덮지 않는 키 일곱**: G0 도구 기록 · G1 닫힘 · G1 manifold · G4 최대 벌림 · G4 서보 각 · G6 판 안 · G6 판 닿음(까닭 = controls.json `not_covered`).
- **검사 범위 밖**: 실제 끼움 · 마찰 · 백래시(시험편 전) · 서보 실물 치수(공개 도면 — 위면 구멍 폭 간격 · 혼 지름 19.2 / 19.95 · 혼 높이 · 서보 길이 방향 틈 0.89 는 실물로 확인) ·
  M2 셀프태핑 자리 깊이(공표값 없음) · 강도는 기어 이만 — 턱 B 손끝 대(10 × 18 · 층을 가로지름)는 꽉 찬 단면 어림으로 EEPROM 50 % · 쥐는 점 z 100 에서 약 7.6 MPa ·
  정지 토크면 약 15 MPa(출력은 벽 둘 · 채움 15 % 라 실제는 약 1.7 배 — 정지에서 층 사이 31 MPa 에 가까움 → 토크 상한 필수) · 턱 · 관 처짐 · 크리프 · 열 ·
  서보 받침 턱 자리의 얇은 띠(자리파기 ↔ 혼 구멍 0.38 · 기능에 안 걸림) · 팔에 붙인 자세에서 J5 를 접을 때의 충돌(그리퍼를 v3 Link6 에 붙인 자세 검사는 다음).

## 다시 만들기

```
python src/cad/kmjh-gripper-v1/build_gripper.py --cli <solidcraft-cli.exe> --scratch-root <작업 뿌리(표지 MP8_SCRATCH)>
python src/cad/kmjh-gripper-v1/print_prep.py --printforge <printforge 저장소> --scratch-root <작업 뿌리>
python src/cad/kmjh-gripper-v1/verify_gripper.py --out .dev/mp8-evidence/gripper/verify.json
python src/cad/kmjh-gripper-v1/run_controls.py --scratch-root <작업 뿌리>
python src/cad/design-check-mp8/gripper_loads.py --gripper models/kmjh-gripper-v1/mass-properties.json
python src/cad/design-check-mp8/motor_impact.py
blender --background --factory-startup --python src/cad/kmjh-gripper-v1/render_gripper.py -- --scratch-root <작업 뿌리> --u 0 40
```
