WINNAKEN/robot-arm-lab/models/manipulator-v2/README.md

# 팔 전체 v2 — v3 초안 모양 전면 재설계 (MP18 · 개념 B · 57D 단자 · 케이블 길)

MP17 팔 전체 v1(`models/manipulator-v1/` · 커밋 `e80c995`)을 **v3 초안(MP7) 모양**으로 다시 그렸다. **구매품 · 관절 거리 · 관절 축은 그대로** — 바뀐 것은 출력 부품과 J3 구동 모듈의 돌림 각뿐이다.

- 결정 원문 = `.dev/mp18-evidence/user-decisions-mp18.json`: 「하나 더 궁금한건 지금 저기 저 초안 디자인처럼 모델링 수정은 안되?」 → 질문 창 「셸(껍데기) 추가 (권장)」 · 「MP17 커밋 후 MP18 로 (권장)」 → 셸 개념 그림에 「뭔가 다르지않아?? 전면적으로 디자인 개선을 시작해」 · 「이미 출력된거 안써도되니깐 구매품만 그대로 쓴다면괜찬아」 → 개념 B 그림에 「B 로 진행 · 손목까지 (권장)」.
- 원천 = `src/cad/manipulator-v2/`(MP17 생성기 · 검사기 · 출력 준비 · 하중 · 그림을 복사해 고침 — **MP17 파일은 그대로**). 계획 = `.dev/mp18-evidence/plan-mp18.md`.
- 작업 폴더의 개념 그림(커밋 안 함)으로 v3 · MP17 · 개념 B 를 같은 쪽에서 견줘 고른 뒤 본설계했다.
- **MP18 이어서(57D 단자 · 케이블 길)** — 결정 원문 = `.dev/mp18-evidence/user-decisions-mp18-cable.json`: 마무리 물음 「57D 단자 · 케이블 길 설계를 언제 할까요?」 에 「2」(= 「42D 단자 배치를 57D 에도 가정해 지금 바로」) → 개념 그림 뒤 질문 창 「A · 막대 높이 키움 (권장)」 · 「±170° 유지 (권장)」 — 아래 「57D 단자 · 케이블 길」 절.

앞(+y · 위팔 덮개 쪽)

## v1(MP17) 에서 바뀐 것

| 자리 | v1 (MP17) | v2 (MP18) |
|---|---|---|
| J3 구동 모듈(MP16) | 모터가 팔꿈치 위로 솟음 | **축 둘레로 90° 돌려 모터를 위팔 안(J2 쪽)에** — 모듈 부품 · 구매품 그대로(덮개 윗면 인서트 자리 · 캐리어 나사 자리도 함께 돎) |
| 위팔 | 판 + 상자 · KMJH 글자(돋움 · 새김) | **앞이 열린 상자**(판 y 52 ~ 59 + 둘레 벽 y 170 까지) + **앞 덮개**(두께 4 · 남색 뚜껑 J2 · J3 + 민트 사선 · KMJH 돋움) · 모터 창 · 통풍 홈 · J2 끝 덮개 나사 기둥 · **J3 끝 덮개 받침대**(따로 출력 · J3 모듈 바닥판의 벨트 덮개 인서트 셋에) |
| 어깨 | 판 + 발 · J2 모터 흰 덮개 · MP16 벨트 덮개 | **뒤 통**(북 r 64 + 뒤 기둥 · 바닥 열림 · 벨트 덮개 대신 그 인서트 · 나사로) + **J2 모터 두건**(갈비로 모터에 끼움 · 남색 앞면 · 통풍) · 어깨 판 피함 자리 넓힘 |
| 바닥 | 원통 BASE + 민트 고리 | **원뿔 겉**(r 68 → 62 · 민트 띠 · 뒤 케이블 박공 홈(폭 24 · 높이 22 · 이어서: 들고 나는 묶음 둘이 지남) · 바닥판 밑에서 나사 셋) |
| 회전대 | 흰 | **남색 띠**(한 물체 · 높이 구간 색) |
| 아래팔 · J6 | 몸통 그대로 보임 | **흰 통**(몸통 둘레 · 남색 뒤판 · 남색 앞 고리 · 판 홈 · 통풍 · 몸통 뒤 덮개 나사를 M3 × 12 로) |
| 링크 5 | 판 | **남색 뚜껑**(J5 허브 나사 위 · 평면에 양면테이프 — 떼어 정비) + 민트 사선 |
| 빠진 출력 부품 | — | MP16 GUARD(둘) · MP17 모터 덮개 둘 · J2 끝 덮개 · 바닥 민트 고리 |

## 57D 단자 · 케이블 길 (MP18 이어서 — 결정 원문 = `.dev/mp18-evidence/user-decisions-mp18-cable.json`)

MP18 산출 검토 R1-2(57D 단자 자리 없음) · R1-3(케이블 길 없음)을 닫았다. **57D 는 아직 없어 42D 배치를 옮긴 가정**이다(실측하면 `parameters.json` v2.term57 만 바꿔 다시 만든다).

**57D 단자 어림(가정)** — 42D(MP10 다시 만들기 2 · 3 · 사용자 사진 · 글 · 실측 · 모터 원장)를 그대로 옮김:
- 드라이버를 뒤에서 볼 때 **위 = 모터 4 단자**(그 아래 몸통 면에 모터 6 핀 커넥터 — 몸통 뒤 끝에서 11 앞부터 · 높이 10 · 폭 16) · **왼쪽 = 5+2 단자대(CAN H / L 쪽)** · **오른쪽 = 6 단자대(V+ / GND 쪽)** · 아래 = 화면 · 단추.
- 단자대 · 4 단자는 드라이버 면에서 **12 mm**(선 굽힘 포함 · 원장 connector_clearance) · 띠 ±11 · 드라이버 폭 = 몸통 + 3.7(42D 원장 46 − 42.3) · 칸 틈 0.5.
- 방향(J2 · J3 같음): 위(커넥터)가 −x(J2 = 뒤 · J3 = J2 쪽) · **화면은 관절 축 쪽**(조립 뒤 못 봄). J2 = 전원 아래 · CAN 위 / J3 = 전원 위 · CAN 아래.
- 검사용 어림 몸체 = `REF.J2/J3.DRIVER57` · `TERM57_TOP / LEFT / RIGHT / CONN`(C4 · C5 · C9 에 들어감) · **J3 드라이버 · 단자 어림은 벨트 홈 두 끝에도**(+2.5 = 장력 쪽 · -1.5 — 검토 R1-4: 더 J3 쪽(−2.0)은 가정 드라이버가 J3 모듈 뚜껑에 닿음).

**바뀐 출력 부품**:

| 부품 | 바뀐 것 |
|---|---|
| J2 두건 + 남색 앞면 | 속 = 드라이버(가정 폭) + 2.0 · 갈비가 **드라이버 덮개**를 누름(y 56.5 ~ 66.5 — 몸통을 누르면 넓은 드라이버를 못 지남) · **단자 칸 셋**(뒤 = 커넥터 · 4 단자 / 위 = CAN / 아래 = 전원 — 뒤 끝이 열린 각기둥이라 밀어 끼울 때 단자가 지나감) · 바깥 = 칸을 감싼 **팔각** · 앞 10 mm 늘려 **드라이버 앞 선 방** · 아래 칸 바닥 **선 홈**(14 × 16 + 45°) · 남색 앞면 **선 구멍 Ø13** + **타이 짝 둘**(J1 · J2 고리 끝 — 검토 R1-2) · 통풍 홈 넷(팔각 채움 위까지 뚫음 — 검토 R1-5) |
| 어깨 판 | 피함 자리 = 두건 바깥 + 1.5 · 자리표시 묶음 구멍 둘 없앰 |
| 위팔 상자 + 앞 덮개 | **막대 높이 78 → 91**(사용자 「A · 막대 높이 키움 (권장)」) · 모터 창 x 쪽 5.5(드라이버 가정 폭 + 벨트 ±2.5) · **판 홈**(J3 단자 칸 위 · 아래 · J2 쪽 — **위 홈은 선 출구와 합침** x 62.5 ~ 108 · 첫 전체 검사에서 모터 밑 출구가 J2 를 +3° · J3 를 +121° 로 막아 위로 옮김) · **J2 끝 벽 선 입구**(112° · Ø13 + 45°) · 판 홈에 **벨트 장력 이동 ±2.5**(검토 R1-4) · 위 벽 **묶음 구멍 둘**(x 25 = J2 고리 끝 · x 92 = J3 고리 끝 — 통풍 홈을 x 48 ~ 84 로 옮겨 벽 3.75 · 검토 R1-2 · R1-7) |
| 원뿔 겉 + 띠 | 뒤 홈 24 × 10 + 45°(꼭대기 22 — 들고 나는 묶음 둘) · 뒤 **묶음 구멍**(z 46) |
| BASE | 뒤 창 폭 18 → 24 |
| 통(J4 · J6) + 뒤판 | 케이블 구멍 = **통 틈 안 원호 홈**(r 43.75 · 폭 9 · 아래팔 24° ~ 54° · J6 -54° ~ -24° — 선이 나란히 지남 · 검토 R1-11 · 옛 구멍(y −30)은 MP10 몸통 뒤 덮개(막힌 판)로 열려 길이 없었다) · 통 앞 **타이 짝**(아래팔 180° · J6 300° — J4 · J6 고리 끝 · 출구를 그 각으로 옮겨 감김을 줄임 · J6 는 캔 반쪽 아래 귀(260 ~ 280°)를 피함 · 검토 R1-2) |
| 링크 5 | J5 쪽 **귀 + 묶음 구멍**(J5 고리를 축 가까이 — r 45) |

**케이블 고정 구간**(묶여 링크와 함께 움직이는 곳 · 세계 q = 0 · `parameters.json` v2.cable.segments):

| 링크 | 이름 | 지나는 곳 | 지름 |
|---|---|---|---|
| 바닥(링크 0) | `L0_IN` | 탁자 → 원뿔 겉 뒤 홈 → BASE 뒤 창(들어옴) | 10 |
| 바닥(링크 0) | `L0_SPLIT_P` | 바닥 안 틈 → J1 전원 단자 창(−y) · 나눈 선 | 6 |
| 바닥(링크 0) | `L0_SPLIT_C` | 바닥 안 틈 → J1 CAN 단자 창(+y) · 나눈 선 | 6 |
| 바닥(링크 0) | `L0_LINK` | BASE 창 → 바닥 안 틈(나눔) | 6 |
| 바닥(링크 0) | `L0_OUT` | BASE 뒤 창 → 원뿔 겉 뒤 홈 → 겉을 따라 위로 → 겉 묶음 구멍(나감 · J1 고리 시작) | 10 |
| 회전대 · 어깨(링크 1) | `L1_HOOD` | 두건 아래 혹 홈 → 앞 방(앞면 안쪽) · 앞면 아래 타이(J1 고리 끝) → CAN(위) → 앞면 위 타이(J2 고리 끝) → 남색 앞면 구멍 | 10 |
| 회전대 · 어깨(링크 1) | `L1_PWR` | 앞면 아래 타이 뒤에서 갈린 전원 두 가닥 → 아래 단자대(J2 전원) | 6 |
| 위팔(링크 2) | `L2_BOX` | J2 끝 벽 입구 → 덮개 기둥 아래 → 위 벽 타이 x 25(J2 고리 끝) → J3 전원(위) → 모터 J2 쪽 → CAN(아래) → 다시 J2 쪽으로 올라 → 위 벽 타이 x 92(J3 고리 끝) → 위 판 홈 → 판 뒤 | 10 |
| 아래팔(링크 3) | `L3_FA` | 아래팔 −y 면(위 타이) → 통 뒤판 | 10 |
| 아래팔(링크 3) | `L3_ANN_IN` | 통 뒤판 원호 홈 → 통 틈(나눔) | 6 |
| 아래팔(링크 3) | `L3_ANN_ARC` | 통 틈 둘레: J4 전원(위) → −y → CAN(아래) | 6 |
| 아래팔(링크 3) | `L3_ANN_FWD` | 통 틈 −y(180°) → 통 앞 타이 → 출구(J4 고리) | 6 |
| J5 몸통(링크 4) | `L4_J5` | J5 목 홈 · 타이(MP10) → J5 몸통 바깥 | 6 |
| J5 몸통(링크 4) | `L4_J5_ARC` | J5 몸통 둘레: 전원 창(위) · CAN 창(아래) | 6 |
| 링크 5 | `L5_PLATE` | 링크 5 귀 타이 → 판 −y 면(보스 아래) → J6 통 뒤판 | 10 |
| 링크 5 | `L5_ANN_IN` | J6 통 뒤판 원호 홈 → 통 틈(나눔) | 6 |
| 링크 5 | `L5_ANN_ARC` | 통 틈 둘레: J6 CAN(아래) → 전원(위) | 6 |
| 링크 5 | `L5_ANN_FWD` | 통 틈 300° → 통 앞 타이 → 출구(그리퍼 선만 · J6 고리) | 4 |
| 그리퍼(링크 6) | `L6_SERVO` | 그리퍼 서보 커넥터 아래 | 4 |

**관절 고리**(C10 — 바라는 범위에서 다른 관절 0 · 두 고정점 사이 가장 짧은 길(관절과 같은 축 원통을 돌아감 · **감긴 각은 접지 않음** — 검토 R1-1) · 단위 mm · 타이 = 고리 끝 둘의 타이 자리와 고정점까지 거리):

| 관절 | 바라는 범위 | 필요 최대 | 감긴 각 최대 | 고리 길이 | 가장 짧을 때 → 남는 길이 | 감는 반지름 | 타이(끝 둘) | 맞음 |
|---|---|---|---|---|---|---|---|---|
| J1 | -170° ~ +170° | 282 (@-170°) | 206° | **300** | 85 → 215 | 68 | 원뿔 겉 7 · 두건 앞면 27 | 예 |
| J2 | -100° ~ +0° | 56 (@0°) | 50° | **75** | 17 → 58 | 55 | 두건 앞면 14 · 위팔 위 벽 50 | 예 |
| J3 | -20° ~ +120° | 194 (@120°) | 239° | **210** | 94 → 116 | 41 | 위팔 위 벽 29 · 아래팔 판 11 | 예 |
| J4 | -120° ~ +120° | 104 (@-120°) | 120° | **120** | 54 → 66 | 42 | 아래팔 통 11 · J5 목(MP10) 14 | 예 |
| J5 | -90° ~ +90° | 108 (@-90°) | 90° | **135** | 82 → 53 | 44 | J5 목(MP10) 14 · 링크 5 귀 10 | 예 |
| J6 | -170° ~ +170° | 170 (@-170°) | 187° | **190** | 81 → 109 | 42 | J6 통 10 · 플러그 | 예 |

- 고리 길이 = 필요 최대 + 15 를 5 로 올림(J5 는 +10 더 — 곧은 길 셈이 MP10 목 받침을 지나는데 실제 선은 돌아감 · 검토 R1-6) · 여유 10 이상.
- **감긴 각은 접지 않는다**(검토 R1-1): 선은 축 몸통을 뚫지 못하니 180° 넘게 감기면(J1 206° · J3 239° · J6 187°) 원통을 그만큼 돈다. 처음 셈(0 ~ 180° 로 접음)은 J1 · J6 를 15 ~ 16 mm 짧게 봤다 — J1 270 → 300 · J3 170 → 210 · J6 180 → 190(출구 300°) · J4 150 → 120(출구를 J5 목 홈과 같은 180° 로). 설계 셈(작은 걸음으로 이어 셈)과 검사(q = 0 방위 차 + 관절 각)는 다른 방법으로 같은 값.
- 남는 길이는 고리가 처지는 몫(J1 이 가장 김 — 바닥 뒤로 늘어짐). J3 뚜껑 뒤(y < 37)는 비어 있어 J3 고리가 처지면 남색 뚜껑 · 민트 사선 위를 쓸 수 있다 — 처짐 · 쓸림은 검사 밖(조립 뒤 손으로 돌려 봄).
- **고리 끝 열둘마다 타이 자리**(그리퍼 서보 끝만 플러그 · 검토 R1-2) — C10 이 부품 STL 에서 짝 구멍 둘(빈 곳)과 사이 벽(찬 곳)을 찾고 고정점에서 60 mm 안인지 본다. 새 자리 다섯 = 두건 앞면 둘 · 위팔 위 벽 x 25 · 아래팔 통 앞 · J6 통 앞. 두건 쪽 둘은 두건(갈비 누름으로만 붙음)에 있다 — 어깨 판 뒤는 뒤 통이 덮어 끈이 못 지난다 · 두 고리의 당김(J1 = 아래 · J2 = 팔 평면)은 두건이 빠지는 쪽(+y)과 직각이다. 타이 = 4 mm 이하(구멍 4.5 × 2.4 · BOM F06).

## 쓸 수 있는 관절 범위(C5 — 자기 충돌만 · 표시 자세에서 관절 하나씩 · 5° · 끝 1° — 이어서: 57D 단자 어림 · 케이블 고정 구간도 넣고 봄)

| 관절 | v2 | v1(MP17) | 바라는 범위(작성자 제안) | 덮음 |
|---|---|---|---|---|
| J1 | 한 바퀴 | 한 바퀴 | -170° ~ +170° | 예 |
| J2 | -105° ~ +20° | -130° ~ +25° | -100° ~ +0° | 예 |
| J3 | -120° ~ +125° | -140° ~ +130° | -20° ~ +120° | 예 |
| J4 | 한 바퀴 | 한 바퀴 | -120° ~ +120° | 예 |
| J5 | -100° ~ +100° | -115° ~ +115° | -90° ~ +90° | 예 |
| J6 | 한 바퀴 | 한 바퀴 | -170° ~ +170° | 예 |

- J2 × J3 격자(10°): 충돌 없는 칸 31 % · 그중 책상 위 24 %. J2 뒤쪽 · J3 접힘 · J5 는 v1 보다 조금 줄었다(어깨 두건 · 위팔 상자 · 통 · 케이블 고정 구간 때문) — 바라는 범위는 그대로 덮는다.
- 케이블 **고리**(관절 사이 늘어진 구간)는 몸체로 넣지 않았다 — 길이만 C10 이 본다(아래). 실제 팔에서 고리가 다른 부품에 닿거나 쓸리는지는 조립 뒤 손으로 돌려 본다.

## 자세 그림(보기용 — 사용자 글 「발사 완료하면 블랜더로 몇몇 자세들 이미지 만들어서 남겨놔」 · `.dev/mp18-evidence/user-decisions-mp18-cable.json` 넷째)

자세마다 검사기(`check_arm.Sweep` — 링크끼리 겹침 · 움직이는 링크의 가장 낮은 점 z ≥ 0 = 탁자 위)로 먼저 보고 통과한 8 자세만 그렸다(`renders/poses/poses.json` · 치수 원천 아님).
그림 = Blender Workbench — 작업 폴더 `C:\tools\mp18c\poses\`(`blender_arm.py` 사본에 보기마다 화면 맞춤만 더함 — 원본 맞춤은 세운 자세를 자른다 · 한 장씩 큰 그림도 거기).

자세 여덟 — 뒤 비스듬히

자세 여덟 — +y(위팔 덮개 쪽)

| 자세 | J1 ~ J6 (°) | 가장 낮은 점 z (mm) | 뜻 |
|---|---|---|---|
| `home` | 0 · 0 · 0 · 0 · 0 · 0 | 110 | 영점 — 팔을 앞으로 곧게 |
| `display` | 15 · -50 · 70 · 15 · 25 · -10 | 13 | 표시 자세(parameters poses.display_deg) |
| `ready_high` | 0 · -60 · 60 · 0 · 0 · 0 | 124 | 들어 올린 준비 자세(parameters 의 ready 는 팔의 가장 낮은 점이 탁자 아래 z −79 라 대신 — find_poses.py) |
| `upright` | 0 · -90 · 0 · 0 · 0 · 0 | 124 | 위로 곧게 세움 |
| `reach_table` | 0 · -40 · 60 · 0 · 20 · 0 | 7 | 앞 탁자로 뻗어 집기(쥐는 점 앞 562 · 탁자 위 23 — find_poses.py) |
| `side_pick` | 90 · -40 · 60 · 0 · 20 · 0 | 7 | J1 90° 돌려 옆 탁자에서 집기 |
| `folded` | 0 · -95 · 110 · 0 · 90 · 0 | 8 | 작게 접은 보관(쥐는 점 바닥 앞 150 · 탁자 위 14 — find_folded.py) |
| `wrist_play` | -30 · -55 · 75 · 90 · 60 · 90 | 124 | 손목 돌림 · 꺾음 |

- `parameters.json` 의 ready 자세(0 · -60 · 90 · 0 · 60 · 0)는 링크끼리 겹침 없음 · 가장 낮은 점 z -79(탁자 아래)라 그리지 않고 `ready_high` 로 대신했다 — ready 값을 바꿀지는 따로(이 단위에서 안 바꿈 · `renders/ready-isoback.png` 가 그 자세).

## 출력(H2D · 0.20 Standard · PLA Basic · Textured PEI · 모두 지지대 없음 — `.dev/mp18-evidence/printprep.json`)

| 부품 | 방향 | 질량 · 시간 |
|---|---|---|
| `FLOOR` | 그대로(밑면이 판) | 67.2 g · 1 시간 24 분 |
| `BASE` | 그대로(밑면이 판) | 104.5 g · 2 시간 32 분 |
| `BASE_SKIN` + `BASE_SKIN_BAND` | 그대로(밑면이 판) | 59.8 g · 1 시간 27 분 |
| `J1_CAN_A` | 그대로(밑면이 판) | 30.8 g · 56 분 |
| `J1_CAN_B` | 그대로(밑면이 판) | 31.8 g · 53 분 |
| `TURRET` + `TURRET_BAND` | 뒤집어(윗면이 판) | 112.6 g · 2 시간 22 분 |
| `J1_SPACER` | 그대로(밑면이 판) | 12.6 g · 24 분 |
| `SHOULDER` | +y 면이 판 | 59.2 g · 1 시간 42 분 |
| `SHOULDER_SHROUD` | −y 면이 판 | 187.9 g · 4 시간 36 분 |
| `J2_MOTOR_HOOD` + `J2_HOOD_FACE` | +y 면이 판 | 48.3 g · 1 시간 21 분 |
| `J2_HUB` | +y 면이 판 | 17.0 g · 28 분 |
| `UPPER_ARM` | −y 면이 판 | 243.8 g · 5 시간 53 분 |
| `UA_COVER` + `UA_LOGO` | −y 면이 판 | 67.7 g · 1 시간 31 분 |
| `UA_J3_BRACKET` | −y 면이 판 | 10.6 g · 35 분 |
| `UA_CAP_J2` + `UA_CAP_J2_MARK` | −y 면이 판 | 11.6 g · 20 분 |
| `UA_CAP_J3` + `UA_CAP_J3_MARK` | −y 면이 판 | 18.8 g · 28 분 |
| `FOREARM` | −y 면이 판 | 59.5 g · 1 시간 19 분 |
| `J3_CAP` + `J3_CAP_MARK` | +y 면이 판 | 9.9 g · 17 분 |
| `J4_CAN_A` | 그대로(밑면이 판) | 33.1 g · 1 시간 1 분 |
| `J4_CAN_B` | 그대로(밑면이 판) | 31.8 g · 53 분 |
| `J4_REAR_COVER` | 뒤집어(윗면이 판) | 12.7 g · 22 분 |
| `FA_TUBE` + `FA_TUBE_CAP` + `FA_TUBE_RING` | −x 면(뒤판)이 판 | 54.6 g · 1 시간 20 분 |
| `LINK5` | +y 면이 판 | 44.5 g · 1 시간 4 분 |
| `LINK5_CAP` + `LINK5_CAP_MARK` | −y 면이 판 | 4.5 g · 11 분 |
| `J6_CAN_A` | 그대로(밑면이 판) | 34.3 g · 1 시간 3 분 |
| `J6_CAN_B` | 그대로(밑면이 판) | 31.8 g · 53 분 |
| `J6_REAR_COVER` | 뒤집어(윗면이 판) | 12.7 g · 22 분 |
| `J6_TUBE` + `J6_TUBE_CAP` + `J6_TUBE_RING` | −x 면(뒤판)이 판 | 54.6 g · 1 시간 20 분 |
| `TOOL_FLANGE` | 그대로(밑면이 판) | 11.3 g · 24 분 |
| `J1_FIT_SLEEVE` | 그대로(밑면이 판) | 6.7 g · 15 분 |
| `J1_FIT_BORE` | 뒤집어(윗면이 판) | 9.2 g · 20 분 |

팔 한 대 몫 = 판 10 장 · **판 I(6818 끼움 시편)를 가장 먼저**:

| 판 | 부품 | 질량 · 시간 |
|---|---|---|
| A_upper_arm | UPPER_ARM | 243.8 g · 5 시간 53 분 |
| B_cover | UA_COVER · UA_J3_BRACKET | 78.2 g · 2 시간 1 분 |
| C_shoulder | SHOULDER_SHROUD · SHOULDER | 246.2 g · 6 시간 11 분 |
| D_floor_hood | FLOOR · J2_MOTOR_HOOD · J2_HUB | 131.1 g · 3 시간 1 분 |
| E_base_skin | BASE_SKIN · BASE · J1_SPACER | 176.8 g · 4 시간 14 분 |
| F_forearm_tubes | FOREARM · FA_TUBE · J6_TUBE | 168.6 g · 3 시간 54 분 |
| G_cans | J1_CAN_A · J1_CAN_B · J4_CAN_A · J4_CAN_B · J6_CAN_A · J6_CAN_B | 193.1 g · 5 시간 19 분 |
| H_turret_small | TURRET · J4_REAR_COVER · J6_REAR_COVER · TOOL_FLANGE | 150.1 g · 3 시간 16 분 |
| J_link5_caps | LINK5 · UA_CAP_J2 · UA_CAP_J3 · LINK5_CAP · J3_CAP | 89.0 g · 2 시간 0 분 |
| I_fit_coupons_first | J1_FIT_SLEEVE · J1_FIT_BORE | 15.9 g · 31 분 |

합계 약 1493 g · 36 시간 25 분(MP16 · MP6 · MP10 · KG1 모듈 판은 그 단위 것 — MP16 GUARD 는 뽑지 않음).
- **시제품 출력 색**(사용자 질문 창 「검정=남색 · 녹색=민트」 · 판은 「검사 끝난 뒤 정함」 — `.dev/mp18-evidence/user-decisions-mp18-cable.json` 셋째): 남색 자리 = 검정 실 · 민트 자리 = 녹색 실(H2D 에 넣은 차례 검정 · 회색 · 흰색 · 녹색) — 모형 색 · 출력 준비 기록은 KMJH 그대로 · 실 배정은 보낼 때. 57D 에 묶인 판 A · B · C · D 는 57D 실측 뒤.
- **첫 출력 = H2D 판 42**(사용자 글 「끝나는대로 H2D에 출력걸었으면 좋겠어」 — `.dev/mp18-evidence/user-decisions-mp18-cable.json` 넷째 · 판은 같은 글의 「I,G 함께 …」): 판 I(6818 끼움 시편 둘 — 슬리브 고리를 구멍 고리 안에) + 판 G(몸통 캔 여섯) + J4 · J6 뒤 덮개 + 링크 5 = **흰색 한 판**(녹색이 섞인 공구 플랜지는 뺌) · 2026-11-07 01:42 H2D1 로 보냄(01:49 첫 층).
  AMS A3 흰 실이 **Bambu PLA Pure**(뱀부 필라멘트 관리 탭)라 Pure 프로필(최대 체적 12 mm³/s — Basic 25)로 다시 잘랐다: 8 시간 32 분 · 279 g · 287 층 · 지지대 없음 · 벽 classic(끼움 원장을 판정한 판과 같은 벽 방식) · 구멍 턱 희생 레이어(printforge auto) · 오른쪽 노즐 A3.
  🔴 끼움 원장 값(6818 구멍 · 슬리브)은 흰 **Basic** 으로 판정한 값 — 이 시편은 Pure 라 결과를 볼 때 재료가 다름을 적고 본다(실제 흰 부품도 이 Pure 스풀로 뽑으면 그 부품과는 같은 실). 작업 폴더 = `C:\tools\mp18c\plate42\` · 출력 기록 = `Downloads\H2D_start\README.txt` 42.
- 색: 한 물체 안의 띠 · 판 · 표시는 높이 구간 수정자(AMS) — 남색 = J2 허브 · 뚜껑들 · 두건 앞면(바닥 2.5) · 회전대 띠 · 통 뒤판(바닥 3) · 통 앞 고리(맨 위 4.5) · 글자 / 민트 = 공구 플랜지 · 원뿔 띠 · 사선 / 회색 = 바닥판 · 간격 고리.
- 구조 부품(어깨 · 위팔 · 아래팔 · 링크 5 · 회전대 · BASE · 뒤 통)은 벽 4 ~ 6 · 채움 40 % 이상 권장(MP17 검토 R1-22 그대로). 모터를 감싸는 위팔 상자 · 두건 · 뒤 통 · 통의 재료는 온도 실측 뒤 정한다(아래 「가정 · 한계」 — 위 시간 · 질량은 PLA).

## 나사(C3 — STL 광선 · 물림 ≥ 4 · 구멍 바닥 여유 ≥ 0.5 · 인서트 구멍 깊이)

| 자리 | 개수 | 나사 | 물림 최소 | 바닥 여유 최소 |
|---|---|---|---|---|
| floor_to_j1_can | 4 | M3 × 10 | 6.5 | 1.5 |
| floor_to_base | 4 | M3 × 8 | 5.0 | 2.5 |
| turret_to_j1_mp6 | 4 | M3 × 12 | 4.0 | 2.0 |
| shoulder_to_turret | 6 | M3 × 12 | 5.0 | 2.5 |
| shoulder_to_j2_cap | 6 | M3 × 10 | 5.5 | 2.0 |
| upper_arm_to_j2_carrier | 6 | M3 × 16 | 5.0 | 2.5 |
| upper_arm_to_j3_cap | 6 | M3 × 10 | 6.5 | 1.0 |
| ua_cover_to_upper_arm | 3 | M3 × 8 | 5.8 | 2.6 |
| ua_cover_to_j3_bracket | 3 | M3 × 8 | 5.8 | 2.6 |
| j3_bracket_to_j3_base | 3 | M3 × 8 | 5.0 | 2.5 |
| forearm_to_j3_carrier | 6 | M3 × 16 | 5.0 | 2.5 |
| forearm_to_j4_pad | 4 | M3 × 12 | 4.5 | 3.0 |
| link5_to_j5_hub | 4 | M3 × 20 | 6.0 | 2.0 |
| link5_to_j6_pad | 4 | M3 × 12 | 5.0 | 2.5 |
| j5_neck_to_j4_mp6 | 4 | M3 × 16 | 4.0 | 2.0 |
| tool_flange_to_j6_mp6 | 4 | M3 × 12 | 4.0 | 2.0 |
| gripper_to_tool_flange | 4 | M3 × 10 | 7.0 | 1.0 |
| floor_to_base_skin | 3 | M3 × 8 | 5.0 | 1.5 |
| shoulder_shroud_to_j2_base | 3 | M3 × 8 | 5.0 | 2.5 |
| fa_tube_cap_to_j4_can | 4 | M3 × 12 | 5.0 | 3.0 |
| j6_tube_cap_to_j6_can | 4 | M3 × 12 | 5.0 | 3.0 |

- MP17 과 달라진 나사: 위팔 덮개 M3 × 8 × 6(새 자리 — J2 끝 상자 기둥 셋 · J3 끝 받침대 기둥 셋) · 바닥판 → 원뿔 겉 M3 × 8 × 3(새 자리) · J4 · J6 몸통 뒤 덮개 M3 × 10 × 8 → **M3 × 12 × 8**(통 뒤판 3 mm) ·
  어깨 뒤 통 = MP16 J2 벨트 덮개 나사(M3 × 8 × 3 + 모터 쪽 M3 × 12 + 너트 — 2d 그대로 · 모터 쪽 너트 나사는 광선 검사 밖 — 셈 3 + 5 + 2.4 = 10.4 ≤ 12) ·
  J3 덮개 받침대 → J3 바닥판 = MP16 J3 벨트 덮개 나사 M3 × 8 × 3(2d 그대로 — v2 는 벨트 덮개를 뽑지 않음). 인서트 +9(상자 기둥 3 · 받침대 기둥 3 · 원뿔 발 3).
  **새 길이 · 새 품목은 없다** — 이미 BOM 에 있는 M3 × 8 · M3 × 12 의 수만 늘고 M3 × 10 이 8 줄어든다(BOM 2f).

## 조립 순서(v1 과 다른 곳만)

1. 바닥: 원뿔 겉을 바닥판 위에 세우고 **바닥판 밑에서 M3 × 8 셋**(발 인서트) — BASE · J1 순서는 v1 그대로(겉은 BASE 를 바닥판에 조인 뒤 씌워도 됨). **겉은 회전대보다 먼저**(겉 위 안쪽 r 59.5 < 회전대 r 63 — C9 는 회전대 없이 봄).
2. 어깨: J2 모듈(벨트 덮개 없이 · **모터 쪽 귀 너트는 미리 날개 위에 순간접착제로** — 통을 씌운 뒤에는 손이 닿지 않음) → 어깨 판(v1) → **뒤 통을 뒤(−y)에서 모듈 위로 밀어 넣고** 벨트 덮개 귀 자리 셋에 M3 × 8 · 모터 쪽 귀에 M3 × 12 → **두건**을 앞(+y)에서 어깨 판 피함 자리를 지나 **드라이버 덮개에** 밀어 끼움(갈비 · 들어가는 끝 45°).
3. 위팔: J2 허브 + 위팔 상자 → J2 출력(M3 × 16 × 6 · 상자 안에서) → **J3 모듈(모터 · 벨트 포함)을 앞에서 상자에 넣고** 뒤(−y)에서 덮개 윗면 인서트에 M3 × 10 × 6 →
   **J3 덮개 받침대**를 앞에서 넣어 J3 바닥판 벨트 쪽 면의 벨트 덮개 인서트 셋에 M3 × 8 × 3 → 케이블 정리 → **앞 덮개**(M3 × 8 × 6 — 상자 기둥 3 · 받침대 기둥 3) → 남색 뚜껑 둘을 덮개 핀에 눌러 끼움(핀 하나가 다른 반지름 — 한 방향으로만 · 떼어 정비).
4. 아래팔: v1 그대로(J3 출력 나사 자리만 모듈과 함께 돎). **통은 작업대에서 J4 몸통에 먼저** — 몸통 뒤에서 밀어 넣고 몸통 뒤 덮개 나사(M3 × 12 × 4)로 뒤판과 함께 조인 뒤,
   **몸통째** 아래팔 판에(판이 통 홈으로 들어감 · 받침 나사) → 그다음 J5 손목. 팔에 단 뒤에는 통을 뒤로 빼면 J3 뚜껑에 걸린다(C9 가 찾음). J6 도 같음(링크 5 판 · 그다음 공구 플랜지 · 그리퍼).
5. 링크 5 뚜껑을 평면에(양면테이프 — 떼면 밑의 J5 허브 나사).
6. **케이블(이어서)**: 바닥 뒤 홈으로 들고 나는 묶음 → BASE 뒤 창 → 바닥 안 고리 틈에서 선을 나눠 J1 단자 창(±y) → 나가는 묶음은 원뿔 겉 뒤를 따라 올려 겉 묶음 구멍에 타이 →
   J1 고리 → 두건 아래 혹 홈으로 들여 앞 방(앞면 안쪽)으로 → **앞면 아래 타이** → 전원 두 가닥은 아래 단자대(J2 전원) · 묶음은 앞 방 위로 → CAN 단자(위) → **앞면 위 타이** → 남색 앞면 구멍 → J2 고리 →
   위팔 J2 끝 벽 입구 → 덮개 기둥 아래 → **위 벽 타이(x 25)** → J3 전원(위) → 모터 J2 쪽 → CAN(아래) → 다시 J2 쪽으로 올라 위 벽 안 → **위 벽 타이(x 92)** → 위 판 홈으로 뒤 →
   J3 고리(J3 뚜껑 뒤) → 아래팔 −y 면 위 타이 → 통 뒤판 원호 홈으로 선을 나눠 통 틈 → J4 전원(위) · CAN(아래) → −y 쪽(180°)에서 앞으로 → **통 앞 타이** → J4 고리 → J5 목 홈 · 타이(MP10) →
   J5 몸통 바깥 → J5 단자 창(위 전원 · 아래 CAN) → J5 고리 → 링크 5 귀 타이 → 판 −y 면(보스 아래로) → J6 통 뒤판 원호 홈 → 통 틈 → J6 단자 → 그리퍼 선만 300° 에서 앞으로 → **통 앞 타이** →
   J6 고리 → 그리퍼 서보 커넥터(아래). 두건 앞면 타이는 두건을 끼운 뒤 앞에서(끈은 앞면 바깥으로) · 통 앞 타이는 통을 몸통에 단 뒤 통 바깥에서.
   **J2 · J3 단자는 모터를 집에 넣기 전에 선을 꽂아 둔다**(넣은 뒤에는 화면 · 단추 · 단자에 손이 안 닿음 — CAN ID · 보정은 넣기 전이나 CAN 명령으로).

## 검사(`check.json` — 커밋된 STL 로 스스로 계산 · 판정 True)

- C0 만들기 기록 · C1 닫힘 · 한 덩어리(글자는 **다섯 조각이어야 참** — MP17 은 한 조각만 저장된 걸 못 잡았다) · 두건 통풍 홈 뚫림(이어서 검토 R1-5) · C2 순기구학(v1 + 아래팔 165 · 모듈 축 = 관절 축 — 돌린 J3 모듈 포함) ·
  C3 나사 위 표 · C4 세 자세 겹침 0 + 맞춤 짝 범위(BASE_SKIN ↔ BASE_SKIN_BAND 41.9 · TURRET ↔ TURRET_BAND 30.9 · J2_MOTOR_HOOD ↔ J2_HOOD_FACE 27.3 · J2_MOTOR_HOOD ↔ REF.J2.DRIVER57 31.1 · UA_COVER ↔ UA_LOGO 12.0 · UA_CAP_J2 ↔ UA_CAP_J2_MARK 4.5 · UA_CAP_J3 ↔ UA_CAP_J3_MARK 4.5 · J3_CAP ↔ J3_CAP_MARK 3.1 · FA_TUBE ↔ FA_TUBE_CAP 12.4 · FA_TUBE ↔ FA_TUBE_RING 12.4 · LINK5_CAP ↔ LINK5_CAP_MARK 2.2 · J6_TUBE ↔ J6_TUBE_CAP 12.4 · J6_TUBE ↔ J6_TUBE_RING 12.4 · TOOL_FLANGE ↔ KG1.BASE 0.9 — 표시 짝은 하한 > 0 이라 뜬 표시도 거짓) · C5 위 · C6 지름 · 틈 · C7 출력 준비 기록 · C8 하중 기록 ·
  **C9 넣는 길**(검토 R1-1 · R1-4 — 묶음 10 개를 빼는 방향으로 2 mm 걸음씩 옮기며 받는 쪽과 겹침 0: j3_module_into_upper_arm, j3_bracket_into_upper_arm, ua_cover_onto_upper_arm, shoulder_shroud_onto_j2, j2_hood_onto_motor, fa_tube_onto_j4_can_bench, j4_unit_onto_forearm, j6_tube_onto_j6_can_bench, j6_unit_onto_link5, base_skin_over_base — 이어서: J2 · J3 57D 단자 어림을 두건 · 뒤 통 · J3 모듈 묶음에 넣음) ·
  **C10 케이블 고리 길이**(이어서 — 관절마다 바라는 범위에서 두 고정점 사이 가장 짧은 길 ≤ 고리 길이 − 10 · **감긴 각 펼침**(검토 R1-1) · 고정점 = 고정 구간 끝 · **고리 끝 타이를 STL 에서 확인**(검토 R1-2)).
- 이어서: **57D 단자 어림(42D 배치 가정 · 드라이버 · 단자대 · 4 단자 · 모터 커넥터)과 케이블 고정 구간(캡슐 19 줄 · 지름 10 / 나눈 선 6 / 그리퍼 선 4)은 구매품 어림 몸체로 C4 · C5 에 들어간다** — 구멍 · 홈이 없거나 좁으면 C4, 다른 링크가 지나며 치면 C5 가 거짓. 검토 R1-3 뒤 C4 는 **같은 링크의 모터 · 드라이버 · 나사 머리 어림과 케이블도** 본다(단자 어림은 선이 꽂히는 곳이라 뺌).
- 양성 대조 33 개 모두 잡힘(`.dev/mp18-evidence/controls.json` — MP17 대조 13 + v2 대조 8 + 이어서 대조 12):

| 대조 | 뜻 | 잡아야 할 검사 | 거짓이 된 검사 |
|---|---|---|---|
| shoulder_hole_small | 어깨 가운데 구멍 반지름 45(J2 허브 반지름 46 이 못 지나감) | C4 | C4 |
| turret_high | 회전대 판을 위로 3 mm 두껍게(J2 덮개 밑과 만남) | C4 | C3 · C4 |
| pad_insert_shallow | 몸통 받침 인서트 구멍 깊이 7.5 → 5.0 | C3 | C3 |
| turret_shoulder_touch | 회전대 턱을 위 6818 바깥 고리에 다시 닿게(축 기준 둘) | C6 | C6 |
| floor_hole_big | 바닥판 중심 맞춤 구멍 5.2 → 7.4 | C3 | C3 |
| shoulder_cbore_none | 어깨 → J2 덮개 나사 자리파기 3.5 → 0 | C5 | C3 · C5 |
| sleeve_tight | J1 슬리브 안 반지름 41 → 39.5(틈 0.5) | C6 | C6 |
| tool_boss_big | 공구 플랜지 돌기 반지름 10 → 10.6 | C6 | C4 · C6 |
| j3_layer_shift | J3 모듈을 손목 면 쪽으로 2 mm 옮겨 놓음 | C4 | C3 · C4 |
| can_turned | J4 몸통을 축 둘레로 180° 돌려 놓음 | C3 | C3 |
| open_mesh | 아래팔 STL 사본에서 997 번째 면마다 지움 | C1 | C1 |
| record_mismatch | 만들기 기록의 출력 sha 하나를 0 으로 | C0 | C0 |
| j2_range_wanted_wide | 바라는 J2 범위 −175° ~ +60° | C5 | C5 |
| j3_turn_zero | MP18: J3 모듈을 안 돌림(모터가 다시 팔꿈치 위 · 위팔 상자 밖) | C3 · C4 | C4 |
| logo_one_letter | MP18: KMJH 글자 몸체를 안 합침(첫 글자만 저장 — MP17 의 고장) | C1 | C1 |
| ua_j3_ribs_back | MP18: J3 끝 덮개 갈비를 상자에 되살림(r 59 — J3 모듈이 들어가는 길을 막음 · 검토 R1-1) | C9 | C4 · C9 |
| j3_bracket_post_out | MP18: J3 덮개 받침대 기둥 r 55 → 59(기둥 벽이 상자 벽 속) | C4 | C4 |
| mark_floating | MP18: 돋움 표시를 면 0.02 속 대신 0.3 위에 띄움(검토 R1-12) | C4 | C4 |
| hood_rib_tight | MP18: J2 모터 두건 갈비 누름 0.15 → 1.0 | C4 | C4 |
| shroud_small | MP18: 어깨 뒤 통 북 반지름 64 → 60(J2 덮개 r 59 속) | C4 | C4 |
| tube_slot_narrow | MP18: 통 홈 y 39.5 → 44(통 벽이 아래팔 · 링크 5 판 속) | C4 | C4 |
| ua_bar_low | 이어서: 위팔 막대 높이 91 → 78(J3 57D 단자 어림이 위아래 벽 속) | C4 | C4 |
| hood_no_pockets | 이어서: 두건 단자 혹 · 칸 없음(MP18 네모 두건) | C4 | C4 |
| hood_exit_closed | 이어서: 두건 남색 앞면 선 구멍 없음 | C4 | C4 |
| ua_entry_closed | 이어서: 위팔 J2 끝 벽 선 입구 없음 | C4 | C4 |
| skin_slot_small | 이어서: 원뿔 겉 뒤 홈을 MP18 크기(16 · 7 + 45° 15)로 — 들고 나는 묶음이 못 지남 | C4 | C4 |
| j2_loop_short | 이어서: J2 고리 75 → 50 mm(바라는 범위에 56 필요) | C10 | C10 |
| loop_anchor_off | 이어서: J3 고리 아래팔 고정점을 고정 구간 끝에서 10 mm 옮김 | C10 | C10 |
| j1_loop_fold | 검토 R1-1: J1 고리 300 → 265 mm(감긴 각을 0 ~ 180° 로 접어야 맞는 길이 — −170° 끝은 282 필요) | C10 | C10 |
| cable_in_j3_motor | 검토 R1-3: 위팔 케이블 점 하나를 J3 57D 모터 몸통 속으로(같은 링크 구매품 어림) | C4 | C4 |
| tie_decl_off | 검토 R1-2: J2 고리 두건 앞면 타이를 뚫은 자리보다 20 mm 위에서 찾음 | C10 | C10 |
| notch_no_travel | 검토 R1-4: 위팔 판 홈에 벨트 장력 이동을 안 넣음(벨트 홈 끝의 J3 단자 어림이 판 속) | C4 | C4 |
| hood_vents_short | 검토 R1-5: 두건 통풍 홈을 네모 높이까지만(팔각 채움이 막음) | C1 | C1 |

## 하중(`.dev/mp18-evidence/loads/loads.md` — 손계산 · MP17 방식 그대로)

필요 / 가진 토크(N·m) · 여유:

| 짐 | J1 | J2 | J3 | J4 | J5 | J6 |
|---|---|---|---|---|---|---|
| 0.5 kg | 3.0 / 4.0 (+35 %) | 34.3 / 54.5 (+59 %) | 18.0 / 36.4 (+102 %) | 5.1 / 4.0 (-20 %) | 5.1 / 4.0 (-20 %) | 0.2 / 4.0 (+1833 %) |
| 0.7 kg | 3.4 / 4.0 (+20 %) | 37.3 / 54.5 (+46 %) | 20.2 / 36.4 (+80 %) | 6.2 / 4.0 (-35 %) | 6.2 / 4.0 (-34 %) | 0.3 / 4.0 (+1305 %) |
| 1.0 kg | 3.9 / 4.0 (+3 %) | 41.8 / 54.5 (+30 %) | 23.6 / 36.4 (+54 %) | 7.9 / 4.0 (-49 %) | 7.9 / 4.0 (-48 %) | 0.4 / 4.0 (+896 %) |

- 질량 합 약 **8.86 kg**(v1 8.19 kg — 집 · 덮개 · 통이 더해짐 · GUARD · 모터 덮개는 빠짐) · 케이블 어림 147 g 포함(선 밀도 가정 — 검토 R1-10d).
- 위팔 상자 판 홈 자리(판이 벽까지 0.45 만 남음) = 위 · 아래 벽 + 덮개 단면(단면 계수 약 30918 mm³ — MP17 판 7 × 60 의 7.4 배) · 설계 J2 토크를 거기 걸어도 1.4 MPa(검토 R1-8 · 한계식 box_walls_carry_bending_at_notches).
- 감속기 설계점 대조(1 kg): J2 안전율 1.72(v1 1.72) · 1 kg 에서 2 미만 = J1 · J2 · J4 · J5 · 설계점에 맞는 J2 짐 0.61 kg.
- 짐 한계(안전율 2): J1 1.06 kg · J2 1.84 kg · J3 2.15 kg · J4 0.32 kg · J5 0.32 kg · J6 10.25 kg.
- **J2 짐 기준 · 손목 짐 한계는 MP17 에서 넘어온 사용자 결정 대기 그대로**(이 단위에서 바꾸지 않음).

## 가정 · 한계

- 구매품 치수는 표시값 · 가정(MP17 과 같음). v2 의 새 출력 부품 끼움(두건 갈비 0.15 · 뚜껑 핀 3.0 ↔ 구멍 3.1 · 통 홈 · 원뿔 발)은 시험 전 값(끼움 원장 밖 — 시편 먼저).
- 🔴 **57D 단자 · 드라이버는 42D 배치를 옮긴 가정이다**(사용자 「2」 = 「42D 단자 배치를 57D 에도 가정해 지금 바로」): 57D 가 오면 드라이버 폭 · 단자대 자리 · 선을 꽂은 높이 · 모터 커넥터 자리 · 화면 쪽을 재서
  `parameters.json` v2.term57 을 실측으로 바꾸고 다시 만든다. 다르면 두건 · 위팔 상자 · 덮개를 다시 뽑아야 할 수 있다 — **급하지 않으면 이 다섯(UPPER_ARM · UA_COVER · J2_MOTOR_HOOD · J2_HOOD_FACE · SHOULDER — 어깨 판 피함 자리는 두건 바깥에서 나옴 · 검토 R1-9)은 57D 실측 뒤에 뽑는 것이 안전**(다른 판 · 끼움 시편은 됨).
  가정에 민감하다(검토 R1-9): 드라이버가 한쪽 0.6 만 넓어도(비례 가정 61.3) 위팔 단자 틈 0.45 → 벽 속 · 두건 갈비 누름 0.15 → 0.77(맞춤 상한 넘음) · 모터 창 x 여유 1.15 → 0.53 — 좁으면 두건이 헐거워진다. J2 범위 여유도 바라는 −100° 에서 5°(MP18 15°).
- J3 모터를 벨트 홈 J3 쪽 끝(−2.5)까지 당기면 가정 드라이버가 J3 모듈 뚜껑(MP16)에 닿는다(−2.0 에서 1.3 mm³ · −2.5 에서 49 mm³ — 재어 봄) — 짧은 벨트(공차)면 −1.5 까지만 쓸 수 있다. C4 는 +2.5 · −1.5 두 끝에서 본다 · 57D 실측 뒤 다시. J2 모터 장력은 J2 에서 먼 쪽(−x)으로만 — 두건이 모터와 함께 움직여 어깨 판 피함 자리(틈 1.5)에서 멀어진다(반대 끝 +x 는 틈을 넘음).
- 케이블 묶음은 가정(18AWG 전원 둘 + CAN RVSP 4 심 + 그리퍼 STS3215 3 선 = 둥근 지름 10 · 통 · 바닥 안 틈 9.5 ~ 10.5 는 선을 나눠 지름 6). **전원을 드라이버마다 이어 가는지 · 별로 나누는지 · 접속점(WAGO)을 어디 두는지는 배선 문서 몫** — 별 배선이면 묶음이 굵어져 구멍 · 홈이 모자랄 수 있다.
- RVSP(CAN)의 움직이는 굽힘 반지름(약 10 × 지름 = 50)을 관절 고리가 다 지키지는 못한다 — 고리 구간은 유연한 선(드래그 체인용)이 낫다 · **사지 않았다**(사용자 결정 · 배선 문서).
- J1 ±170° = 바닥 뒤 느슨한 고리(약 300 mm · 정지 자세에서 탁자 쪽으로 늘어짐 · 끝 자세에서 회전대를 반 바퀴 넘게(약 206°) 감음 — 사용자 「±170° 유지 (권장)」). 고리는 묶음 보호(스파이럴 · 메시 슬리브)가 있으면 좋다(없음 · 사지 않음).
- 그리퍼 서보(STS3215 12 V) 선은 J6 고리만 건너고 통 · 링크를 따라 바닥까지 간다 — 12 V 전원 · 직렬 신호를 어디서 내는지는 배선 몫. 서보 커넥터 자리는 MP8 검사 어림(플러그 구역) 기준.
- 판 홈(J3 단자 · 선 출구) 때문에 위팔 뒤 판은 모터 창 둘레가 더 열렸다 — 그 자리 굽힘은 위아래 벽 + 덮개가 받는다(하중 절 · 검토 R1-8). 비틀림은 창 · 홈 때문에 열린 단면(셈 안 함 · 다음 판).
- 전원을 드라이버마다 이어 가면 단자 하나에 18AWG 두 가닥이 물린다 — 6 단자대 정격 · 굽힘 여유 12 가 감당하는지는 배선 문서 몫(검토 R1-11).
- 뒤(−y)에서는 위팔 판의 창 · 홈으로 J3 모터 끝 · 단자 · 선이 보인다 — 창 뒤로는 주로 **어깨 판**이 1 mm 틈으로 지나가고(q2 = 0 에서 창의 약 40 %를 덮음) |J3| 가 약 127° 를 넘으면 아래팔도 지나간다(덮을 자리 없음 · 앞 = 위팔 덮개 쪽이 v3 모습).
- 모터를 감싸는 집(위팔 상자 · 두건 · 뒤 통 · 통)에는 통풍 홈을 냈지만 **온도 실측 전** — 덮개를 닫은 채 재고 재료를 정한다(PETG · ASA 는 새로 사야 하면 먼저 묻는다 · 재료가 바뀌면 끼움 시편부터).
- J2 벨트: 뒤 통 바닥이 열려 있어 작은 풀리에 손가락이 닿는다(검토 R1-7) — 케이블은 두건으로 지나게 정했으니 뒤 통 바닥 막음은 다음 판에 따로. J3 벨트는 상자 · 덮개로 다 가려짐.
- 여러 색 판(D · E · F · H · J)은 같은 층에 색이 섞여 노즐을 바꾼다 — 위 시간 · 질량은 한 색 기준 추정이다.
- 하중 단면: 위팔은 판 홈 자리 상자 단면(위 줄) · 아래팔 · 링크 5 · 어깨 판은 MP17 셈 그대로(`loads.md`).
- 덮개 가운데(약 150 mm) 고정 · 가장자리 45° 모따기(지금은 2 × 2 계단) · 통 홈 가장자리 칼날(0 → 2.2)은 다음 판.
- 어깨 두건은 드라이버 덮개에 갈비 누름(0.15)으로만 붙는다(케이블 당김은 빠지는 쪽과 직각 · 확실한 잠금은 57D 실측 다시 만들기에서 — 검토 R1-2 · R1-9) · 원뿔 겉은 바닥판 나사 셋 · 링크 5 뚜껑은 양면테이프(자리 없음 — 링크 5 는 그 면을 판에 놓고 뽑음).
- **MP17 결함(이 단위에서 찾음)**: MP17 `UA_LOGO.stl` 은 KMJH 다섯 글자 중 **한 조각만** 저장됐다(SolidCraft 가 글자마다 몸체를 따로 만들고 첫 몸체만 저장 · MP17 C1 이 조각 수를 안 봄). v2 는 합쳐서 다섯 조각 · C1 이 다섯을 요구 · 대조 `logo_one_letter` 가 잡는다. MP17 파일은 고치지 않았다(v2 가 대신함).
- **Codex URDF v4**(`models/robot-arm-urdf-v4/` · 118 · 커밋 `14794818`)가 이 모델(이어서 R1 고친 뒤 작업 트리 · 아래팔 165)을 읽어 만들어졌다 — v4 가 읽은 MP18 입력 97 중 형상 입력(부품 STL 43 · parameters · 생성기 · 검사기 · 하중 · 출력 준비 · 만들기 기록)은 이 판과 바이트가 같고, 다른 것은 표시 GLB · 렌더 그림 9(다시 그림)과 이 README(문서)뿐이다.
- 산출 검토 = Claude 하위 에이전트(읽기 전용) — 처분 = `.dev/mp18-evidence/review-r1-disposition.md` · 이어서(57D 단자 · 케이블 길) 산출 검토 R1 「고친 뒤 출력」(지적 11 — 중요 3 · 사소 8) — 처분 = `.dev/mp18-evidence/review-cable-r1-disposition.md` · Codex 검수 없음.

## 다시 만들기

```powershell
$py = "C:\projects\printforge\.venv\Scripts\python.exe"; $cli = "C:\tools\SolidCraft-0.18.2\solidcraft-0.18.2-windows-x64-portable\solidcraft-cli.exe"
cd src\cad\manipulator-v2
& $py -B build_arm.py --cli $cli --scratch <저장소 밖 작업 폴더>
& $py -B print_prep_arm.py --printforge C:\projects\printforge --scratch <같은 폴더>
& $py -B loads_arm.py
& $py -B check_arm.py
& $py -B run_controls.py --cli $cli --scratch <같은 폴더>
& $py -B render_arm.py --blender C:\tools\Blender-5.2.3\blender-5.2.3-windows-x64\blender.exe --scratch <같은 폴더>
```
