WINNAKEN/robot-arm-lab/models/motor-holder-v1/README.md

# 모터 받침 v1 (MP15)

감속기(MP6 `cycloid-27-v1`)를 앞면에 단 모터(MKS SERVO42D)를 책상에 **눕혀** 잡는 받침.
감속기 부품은 그대로다. J5 손목과 같은 감속기를 손으로 · 전원으로 시험할 때 쓴다.

- 결정: 2026-11-04 질문 창 「따로 모터 받침 (권장)」(`.dev/mp14-evidence/user-decisions-mp14.json` 의 `holder_question`) → 2026-11-05 단위 번호 「MP15」(`.dev/mp15-evidence/user-decisions-mp15.json`).
- 축 눕힘 · U 자 받침 + 위 막대 · 바닥판 구멍 넷 · 축 높이 55 는 **작성자 선택**이다. 바꾸려면 말해 주면 된다.
- 원천 = `src/cad/motor-holder-v1/`(생성기 `build_holder.py` → SolidCraft 명령줄). 이 폴더는 산출물이다.
- 산출 검토 R1(Claude 하위 에이전트)의 중요 둘(막대 강도 · 축 방향 멈춤)을 고친 판이다 — 처분 = `.dev/mp15-evidence/review-r1-disposition.md`.

감속기 · 모터 · 커넥터 · 덮개 나사 머리를 얹은 모습(어림 몸체)

## 부품

| 부품 | 파일 | 출력 | 질량 · 시간(슬라이서) |
|---|---|---|---|
| 받침 HOLDER | `parts/HOLDER.stl` | 바닥판이 판에(그대로) · 지지대 없음 | 34.3 g · 58 분 |
| 막대 BAR | `parts/BAR.stl` | 눕혀서(조립 자리에서 z 만 내림) · 지지대 없음 | 4.9 g · 14 분 |
| 한 판 | `print-plate.stl` · `slicer/motor-holder-v1.bambu.3mf` | H2D · 0.20 Standard · PLA Basic · Textured PEI · 벽 arachne | 39.3 g · 약 1 시간 6 분 |

- 뱀부 점검기(`check_bambu_3mf.py`) = FAIL 0 · WARN 0.
- 프로젝트는 G-code 가 없어 창에서 열어 슬라이스한다.
- 막대는 창에서 막대만 골라 **채움 100 %** 로 바꾸면 더 튼튼하다(명령줄 출력 준비에는 물체별 설정이 없다).
- 보내기 · 출력은 사용자.

## 치수 요점 (좌표: 모터 앞면 x 0 · 몸통 +x · 감속기 −x · 책상 z 0)

- 축 높이 **55** — 감속기(Ø78) 맨 아래가 책상에서 16(바닥판 윗면에서 11).
- U 홈: 안쪽 폭 **43.0**(원장 몸통 42.3 **가정** + 한쪽 0.35) · 바닥 z 33.85 · x **0.3 ~ 26.0**.
  - 앞 끝 0.3 — 감속기 바닥판 뒷면(Ø78 평면)이 받침 앞면에 닿아 **모터가 뒤로 밀리지 않는다**(놀이 0.3).
  - 바닥판 뒤로 덮개 나사(M3 × 30) 머리 넷이 나와 있다(높이 ≤ 3.0). 아래 둘은 받침 앞면에 주머니(머리 지름 + 1.5 · x 4.0 까지)로 비켜 가고, 위 둘은 벽 윗면보다 높다.
  - 뒤 끝 26.0 = 모터 6 핀 커넥터 앞 끝 29(2026-11-01 실측 · J5 매개변수) − 3.0. 커넥터가 어느 면에 와도, 모터가 앞으로 3 mm 밀려도 닿지 않는다. 몸통보다 넓은 드라이버도 그 뒤.
- 벽 두께 8 · 벽 윗면 = 모터 윗면 − **1.0** — 막대가 벽보다 먼저 모터를 누른다(몸통이 원장 값보다 1.0 작아도 눌림). 이 틈은 멈춤이 아니다 — **살짝 조인다**.
- 인서트 구멍 Ø4.0(끼움 원장 확정) × 깊이 8 · x 15 · 벽 한가운데(구멍 둘레 2.0 · 인서트 둘레 약 1.9).
- 막대 **20 × 59 × 8** · 구멍 Ø3.4(끼움 원장 M3 통과 — placeholder) · 둥근머리 자리파기 Ø6.5 × 3 · x 5 ~ 25.
- 바닥판 58 × 80 × 5(x −12 ~ 46) · 구멍 Ø4.5 넷(x −6 · 40 · y ±34) — M4 나사나 4 mm 나무나사, 또는 가장자리를 클램프로.

## 필요한 것

| 품목 | 수 | 비고 |
|---|---|---|
| M3 열압입 인서트(M3 × 5.7 × 4.2) | 2 | BOM R06 보유분 |
| M3 둥근머리 나사 × 10(인서트 물림 4.0) 또는 × 12(물림 5.7 · 끝 ↔ 구멍 바닥 2.0) | 2 | R07(M3 × 10)이 남으면 그것 — 검사 C6 이 두 길이를 잼 |
| 고정 나사 M4 또는 4 mm 나무나사 | 4 | 또는 클램프 — 시험만 할 거면 없어도 됨 |

BOM 은 이 단위에서 고치지 않았다.

## 조립 순서

1. 인서트 둘을 벽 윗면 구멍에 인두로 넣는다(면과 같은 높이에서 멈춤).
2. 받침을 판이나 책상에 나사 넷으로 고정한다. **앞 구멍 둘은 감속기 밑이 되므로 모터를 얹기 전에.**
3. 감속기를 단 모터를 위에서 내려 U 홈에 얹는다. 감속기 바닥판 뒷면이 받침 앞면에 거의 닿고(0.3), 아래 덮개 나사 머리 둘이 받침 앞면 주머니에 들어간다.
   커넥터 쪽은 위로(권장 — 선이 자유롭다).
4. 막대를 올리고 M3 둘을 번갈아 **살짝** 조인다. 막대는 벽에 닿지 않고 모터만 누른다 — 모터가 앞뒤로 안 밀릴 만큼만(세게 조이면 막대가 휜다).
5. 감속기를 열 때는(덮개 나사가 받침 · 막대에 가려 렌치가 안 닿는다) 막대를 풀고 모터를 들어낸 뒤 연다.

## 손으로 확인할 것

- 모터가 U 홈에 손으로 쑥 들어가는지 · 좌우로 덜컥거리지 않는지. 빡빡하거나 헐거우면 **몸통 한 변(사각)** 을 캘리퍼로 재 알려 주면 원장에 적고 다시 만든다(지금 42.3 은 가정 — 검사는 이 값을 믿는다).
- 막대를 조인 뒤 모터가 앞뒤로 안 밀리는지.
- 감속기 출력을 손으로 돌릴 때 받침이 들리지 않는지(고정 안 했을 때).
- 전원을 넣어 오래 돌린 뒤 모터 몸통 온도. 45 °C 를 넘으면 받침을 PETG 로(PLA 는 55 ~ 60 °C 에서 물러진다 — 감속기 바닥판도 같다).

## 검사

`check.json`(커밋된 STL 로 스스로 계산) C0 ~ C8 모두 참 · 양성 대조 열둘 모두 잡힘(`.dev/mp15-evidence/controls.json`):
C2 홈 틈 0 · C3 앞면 x 0(원기둥 + 멈춤) · 주머니 없음(나사 머리만) · 앞면 x 4.5(멈춤만) · 축 높이 42(원기둥만) · C4 뒤 끝 28.5 ·
C5 벽 = 모터 윗면 · 막대 0.5 뜸 · C6 벽 6 · 막대 구멍 3.0 · 자리파기 없음(M3 × 10 물림 1.0) · C7 막힌 구멍.

## 한계

- 몸통 한 변 42.3 · 몸통 길이 40 · 드라이버 폭 46 은 모터 원장의 **가정** 값. 홈 폭만 몸통 한 변에 걸린다(실제 허용 약 +0.7 / −1.0 — 산출 검토 셈).
- 덮개 나사 머리 높이 3.0 은 렌치볼트 기준(둥근머리면 1.65 — 더 여유).
- 모터가 앞으로(감속기 쪽) 밀리는 것은 막대 조임의 마찰로만 잡는다 — 3.0 까지는 아무 데도 안 닿는다.
- 전원을 넣어 돌릴 때의 반력은 U 홈 벽 · 막대가 모양으로 받는다(계산은 산출 검토의 어림뿐 — 손 시험으로 확인).
- 그림의 모터 · 커넥터 · 감속기는 어림 몸체다(드라이버 없음).
