WINNAKEN/robot-arm-lab/models/pin-coupon-v1/README.md

# 핀 구멍 시편 v1 (MP13 · 2026-11-04)

**상태: 시험편 — 끼움 값이 아니다.** 감속기(MP6 `cycloid-27-v1`)의 강철 Ø4 다월 구멍 값을 정하려는 작은 판이다.
끼움 값의 권위는 `src/cad/calibration/print-fits.json` 한 곳뿐이고, 이 판의 판정을 받은 뒤 거기에 적는다.

- **왜**: 감속기 맞춤 확인 판(`FIT_STRIP`)의 핀 구멍 3.8 · 3.9 · 4.0 · 4.1 이 실제 다월에 모두 작았다.
  사용자 말: 「우선 핀이왔는데 전에 테스트핀넣으라고 줫던거 가장큰것도때려야지 겨우겨우들어가 거의안들어간다고봐도 무방」.
  질문 창의 답은 「0.05 간격 8 개 (권장)」 · 「MP13 (권장)」 이다. 원문은 `.dev/mp13-evidence/user-decisions-mp13.json` 에 있다.
- 코드 = `src/cad/pin-coupon-v1/`(`parameters.json` · 만들기 `build_pin_coupon.py` · 검사 `check_pin_coupon.py` · 출력 준비 `print_prep_coupon.py`).

## 모양

판 84 × 20 × 10 · 모서리 R2 · 관통 구멍 여덟 개(간격 10 · 세운 구멍 = 실제 부품과 같은 방향). 구멍 아래에 새긴 두 자리 숫자는 「4.」 뒤 두 자리다.

| 숫자 | 10 | 15 | 20 | 25 | 30 | 35 | 40 | 45 |
|---|---|---|---|---|---|---|---|---|
| 구멍 지름(모델) | 4.10 | 4.15 | 4.20 | 4.25 | 4.30 | 4.35 | 4.40 | 4.45 |

4.10 은 지난 판의 가장 큰 구멍과 같은 값이다. 두 판을 견주는 기준으로 다시 넣었다.

## 출력

- 뱀부 스튜디오 프로젝트 = `slicer/pin-coupon-v1.bambu.3mf`(printforge 출력 준비 · G-code 없음 · 지지대 없이 `ready` · 약 25 분 · 8.7 g).
- H2D 로 보낼 판은 저장소 밖 `Downloads\H2D_start\projects\36_핀구멍시편_4.10-4.45_흰A1_약23분.3mf` 이다.
  흰 Bambu PLA Basic · 오른쪽 노즐(AMS A1)로 맞췄고, 명령줄 슬라이스로 22.7 분 · 8.69 g · 경고 없음을 확인했다.
- **조건**: H2D 0.4 · 0.20mm Standard · Bambu PLA Basic · Textured PEI · 벽 classic(시스템 기본). 끼움 원장의 다른 값(베어링 자리 · D 구멍 · 인서트)과 같은 조건이다.
  감속기 하우징 · 캐리어를 다른 필라멘트나 벽 방식(arachne)으로 뽑을 거면 이 판도 그 조건으로 다시 뽑아야 한다.
- 보내기 · 출력은 사용자가 한다.

## 판정하는 법

다월은 바이스나 손바닥으로 곧게 누른다. 망치로 때리지 않는다. 한 구멍씩, 두 쪽에서 따로 본다.

1. **윗면(숫자 새긴 면)에서 넣기 = 압입** — 감속기 바닥판 · 캐리어의 핀 구멍 조건이다(그 구멍은 출력할 때 위로 열린다).
   - 고르는 기준: 손바닥이나 바이스로 눌러 끝까지 들어가고, 손으로는 빠지지 않는 가장 작은 구멍.
   - 실제 바닥판은 21.85 mm 를 누른다(이 판은 10 mm). 이 판에서 빡빡하면 실제로는 더 빡빡하다.
2. **밑면(판에 닿던 면)에서 넣기 = 미끄럼** — 감속기 덮개의 핀 구멍 조건이다(덮개는 핀 구멍이 판 쪽으로 열린 채 출력된다).
   - 고르는 기준: 손으로 쑥 들어가고 흔들림이 거의 없는 가장 작은 구멍.
   - 실제 덮개는 핀 28 개를 한꺼번에 씌우므로, 고른 것보다 한 칸 큰 값이 안전할 수 있다.

판정 말 = 「안 들어감 · 때려야 들어감 · 눌러서 들어감(안 빠짐) · 손으로 들어감(꽉) · 손으로 쑥(흔들림 없음) · 헐거움」. 구멍마다 윗면 · 밑면 두 칸을 적는다.

## 판정 결과 (2026-11-04)

- 사용자 말(원문 `.dev/mp13-evidence/user-verdict-mp13.json`): 「출력과 테스트완료했어 20은 되게 끼움맞춤인데 들어가긴하는데조금 빡세고 25는딱 쉽게 들어갈정도」.
- 🔴 시험한 판 = **36b**(하늘 Bambu PLA Pure · 외부 스풀 · 왼쪽 노즐 — 다른 세션이 같은 메시를 재료만 바꿔 뽑은 사본) · 사용자 답 「36b 하늘 Pure」.
  원장 PLA 칸의 다른 값은 흰 · 초록 Basic 조건이다. 흰 Basic 판(36)은 다음 감속기 판에 함께 뽑아 견준다(사용자 고름).
- 작성자 해석(원문 아님): 4.20 = 압입 `pin_press_hole_dia` · 4.25 = 미끄럼 `pin_slip_hole_dia`. 둘 다 4.27 안쪽이라 묻지 않고 원장에 반영했다.
  윗면 · 밑면을 나눠 본 판정은 아니어서 원장 상태는 `provisional` 이다. 실제 바닥판(21.85 압입) · 덮개(핀 28 개 한꺼번에)에 끼워 본 뒤 확정한다.
- 원장 반영 · MP6 다시 만들기 = 같은 단위 MP13(`.dev/HANDOFF.md` 「MP13 판정 반영」 절).

## 판정 뒤 (이 단위 MP13 의 남은 일)

1. 이 판의 판정과 지난 판(`FIT_STRIP` 3.8 ~ 4.1)의 판정 원문을 끼움 원장 `observations` 에 함께 적는다. 원장은 한 번만 고친다.
2. `pin_press_hole_dia`(지금 3.95 · 임시)와 `pin_slip_hole_dia`(지금 4.1 · 임시)를 고친다.
3. MP6 을 `make_all.py` 로 다시 만든다.
4. 🔴 **설계 제약**: 고정 핀 28 개가 반지름 28 에 놓여 중심 사이가 6.27 mm 다. 구멍이 **4.27 을 넘으면 구멍 사이 벽이 최소 재료 2.0 보다 얇아진다**(바닥판 압입 · 덮개 미끄럼 둘 다). 고른 값이 4.27 을 넘으면 원장을 고치기 전에 사용자에게 묻는다(벽 두께를 받아들일지 · 핀 원을 바꿀지 등).

## 검사 (`check.json` · 대조 `.dev/mp13-evidence/controls.json`)

| 번호 | 무엇 | 결과 |
|---|---|---|
| C0 | 만들기 기록 sha = 지금 STL · 입력(매개변수 · 생성기) · 고장 판 아님 | 참 |
| C1 | STL 닫힘 · 부피 > 0 | 참(15 587 mm³) |
| C2 | 구멍마다 단면(z 2 · 5 · 8)의 넓이 같은 원 지름 = 표의 값 ± 0.03 · 중심 ± 0.05 · 왼쪽 → 오른쪽 커짐 | 참(어긋남 최대 0.004) |
| C3 | 여덟 구멍 모두 관통(가운데 z 광선이 재료를 안 만남) | 참 |
| C4 | 출력 준비 기록 = 지금 STL · `ready` · 지지대 없음 | 참 |

양성 대조 둘 다 잡혔다: 둘째 · 셋째 구멍을 바꿔 뚫은 판 → C2 거짓 · 바닥 1 mm 를 남긴 막힌 구멍 판 → C3 거짓.
만든 도구 = solidcraft-cli 0.28.0 · Codex 비작성자 검수는 받지 않았다(시험편 — 값은 실물 판정이 정한다).
