WINNAKEN/robot-arm-lab/models/bench-prep-v1/slicer/README.md

# H2D 출력 준비 결과

2026-10-23에 PrintForge와 Bambu Studio 02.08.02.61로 각 모델 1개씩 로컬 슬라이스했습니다. 세 모델 모두 `ready`이며 아래 숫자는 **슬라이서 예상값**입니다. 실제 출력·치수·내구성 검증은 아직 하지 않았습니다.

| 모델 | 1개 예상 시간 | PLA 예상 사용량 | 서포트 생성 |
|---|---:|---:|---|
| 케이블 타이 받침 | 8분 52초 | 1.61g | 없음 |
| 빈 배선 태그 | 8분 6초 | 1.42g | 없음 |
| 소형 부품 트레이 | 26분 45초 | 18.81g | 없음 |
| 각 1개를 **별도 작업 3회**로 출력할 때 합계 | **43분 43초** | **21.84g** | 없음 |

한 판에 묶어 출력하거나 수량을 늘린 시간·사용량은 따로 슬라이스해야 합니다.

사용자가 확인한 조건은 H2D와 PLA입니다. 이번 예상은 **0.4mm 노즐, 0.20mm Standard, Bambu PLA Basic, Textured PEI Plate**를 가정했습니다. 실제 PLA 브랜드·노즐·플레이트에 맞춰 설정을 확인하세요. AMS 슬롯이나 좌우 노즐 배정은 하지 않았습니다.

각 하위 폴더의 `.bambu.3mf`는 Bambu Studio에서 열어 검토할 **슬라이스 전 프로젝트**입니다. 전달된 세 프로젝트에 G-code 항목이 없음을 확인했습니다. 출력 버튼을 누르거나 프린터로 파일을 보내지는 않았습니다. 미리보기 PNG와 `print_prep_report.json`, 전체 명령·해시는 `slice_manifest.json`에 있습니다.

원본 슬라이스의 G-code는 `.dev/model-prep-evidence/slicer/runs/` 안의 검증 자료로만 보관합니다. 실제 출력에 바로 사용하기 위한 배포 파일이 아닙니다. PrintForge 소스와 설치된 프로필은 수정하지 않았습니다. 네이티브 Bambu 실행 파일의 모든 내부 네트워크 활동을 계측한 것은 아닙니다.
