WINNAKEN/robot-arm-lab/src/simulation/clock_ready_resume_108/README.md

# 108 inactive fixed-target diagnostic preparation

Separate local preparation based on the final099 source and the exact09742-second proposal.
The configured deadline is int0; configured per-purpose limits are data, not execution authority.
A new108 approval, reviewed freeze and non-author PASS must precede a future explicit45-minute activation.
The consumed099 config, markers, failures, review limits and class thresholds remain unchanged.
No current SSH, SDK/native, CAN, power, flash, calibration, installation or physical operation.
Gains/caps/thresholds/model/program remain unchanged. Local HOST and review results are in outputs/isaac-clock-ready-108.
