WINNAKEN/robot-arm-lab/src/simulation/clock_ready_run/README.md

# 099 fixed-target native diagnostic

Reviewed integration of096 closed recovery and097 exact42-second proposal.
Deadline remains0 until the one-shot reviewed coordinator activates the approved45-minute budget.
No CAN, power, flash, calibration, installation or physical operation. Gains/caps/thresholds/model unchanged.
