WINNAKEN/robot-arm-lab/src/simulation/metadata_session/README.md

# 057 module-bound metadata session

Torch/TV module-bound METADATA/RECORD/init hashes are pinned to048 seal. Ambient discovery is preserved separately. launch.ps1 -Role test|prepare|run|verify. New audit/diagnosis/conditional connection once each, original056 ledger frozen. No install/reboot/hardware/training. Results outputs/isaac-metadata-v1/HANDOFF.md.
