WINNAKEN/robot-arm-lab/src/simulation/mp18_isaac_119/README.md

# 119 MP18 URDF v4 Isaac validation and video

Only the 119 driver CLI `run` opens SSH. Native SDK execution requires final L4 PASS, frozen source/model/dependency hashes, an actual retained user cap decision and a fresh 119 run. `prepare` writes the local payload; `consume` only rechecks the original retrieved result. No real CAN or RS485 is used. No install, clock or network setting changes are included.

One stream and one SDK child own import, 2 s gravity hold, 12 s small motion and, after successful gates, one 42 s large motion. Global/SDK budgets are 2700/1800 s; phase limits are 600/300/300/900 s. No retry or automatic gain/cap/criterion change is permitted. Gains 64/16 and arm position/velocity settling limits 0.5 deg/1 deg/s are retained. Large-motion settling is checked at 34 s. Original v4 URDF effort limits remain untouched. The optional runtime 12/7 Nm override needs the specific user answer; old 6/5 Nm permits import/hold diagnosis only.

The local mathematical support envelope uses source mesh convex-hull vertices for exact linear z extrema, not contact simulation. Native mesh readback checks every source triangle, including multiplicities, rather than only counts/bounds. Tool0 physical-API normalization and root articulation-API placement are explicit and logged. Runtime full inertia, zero-step initialization, independent world-COM gravity reference, remaining drive cap, base/floor/clock/finite-state and frame-generation observations remain separate native acceptance gates. Mass/inertia are estimates and self collision is disabled; no physical safety or performance acceptance is implied.

After retrieval, `media.py encode` validates the sealed original PNGs/sidecars, indices, 120 Hz physics steps, 10 fps clocks and fresh rendering. It labels actual native RGB with stage outcomes and checks the H.264 MP4 by ffprobe and full decode. First/middle/last frames decoded from the finished movie require visual inspection before upload. No HOST fixture or viewer rendering can substitute for native video. Failed or unrun phases stay FAIL/NOT_RUN.

The parent seals exact recovered files only after the actual SDK child is reaped. A closed SDK seal still requires all numeric/provider postchecks. A failed or interrupted lifecycle can deliver only a FAIL diagnostic video: direct native PID/job identity, recovered-byte hashes and preapp SDK/provider/numeric evidence are rechecked; uncompleted phases are derived as FAIL then NOT_RUN. This partial provenance is explicit, and never accepted as motion success or module stability after execution. Original partial records stay unchanged. Missing actual RGB cannot be replaced by an animation.

The Drive connector uploads only `delivery/robot-arm-v4-119.mp4` and the sanitized `delivery/result.json` into a new My Drive `robot-arm-lab-Isaac-v4-119` folder, with no sharing changes. Folder/file metadata readback must verify names, sizes and membership. Raw logs, environment paths, keys and the full repository are excluded. Local source acceptance, actual import/hold/motion outcomes, video export, Drive delivery and physical hardware readiness are reported separately.

Development groups A/B/C/D each retain their original 1500 s clocks and reserves. L2/L4 use at most two rounds and non-author reviewers; the previously authorized same-family fallback retains a common-bias limitation. Older 116/118 sources, failures, rounds and ledgers are immutable inputs. Existing unrelated CAD work is preserved.

The same delivery module has a closed local Git publisher. `publish-preflight` validates the exact unit119 source/output/plan inventory, final review freeze and one bounded unit119 shared-document section without Git mutations. `publish` uses raw unfiltered blobs and a private index based on HEAD, constructs shared blobs from HEAD plus only that section, and verifies actual blob bytes. Before the first ref CAS it exclusively acquires the actual default `index.lock` and rereads the latest staged state. While holding that lock it merges only owned entries into a copy of the locked index, preserves separately staged shared blobs, verifies all foreign entries, then fsyncs and atomically installs the binary index. Ordinary Git writers cannot enter the snapshot-to-write interval; a preexisting lock is never removed. Foreign shared worktree bytes stay unchanged. A second local receipt commit updates only its owned receipt path through standard Git locking. Repeated delivery is rejected. The worktree handoff text is added separately by preserving every prior byte. No push is included.
