WINNAKEN/robot-arm-lab/src/simulation/retest_session/README.md

# 058 authorized runtime retest

Unchanged057R2 metadata/inventory/math, new user-authorized audit/diagnosis/conditional connection once each. Legacy057 consumed ledger preserved. No install/reboot/hardware/training. launch.ps1 -Role test|prepare|run|verify. Results outputs/isaac-retest-v1/HANDOFF.md.
