WINNAKEN/robot-arm-lab/src/simulation/torque_observer_run/README.md

# 079 — 고정된 계측 호출의 실제 검증

078 R2의 제어·계측 구현은 그대로다. 사용자 새45분 승인으로 별도 원장과 1/2/1 사전예산을 사용한다. 예비 정지는 기계적 연결 오류 수리의 원 실패·독립 검토·signature 증거가 있을 때만 사용한다. 기준·게인·cap·경로·물성·실물 제외는 유지한다. 계획079와 outputs/isaac-torque-run-v1/ 참조.
