WINNAKEN/robot-arm-lab/src/simulation/torque_observer_trial/README.md

# 078 — 관절 힘·토크와 제동 응답 계측

077 제어는 그대로 유지한다. torque.py는 외부 명령, 실제 운동축 투영, 자식 관절 프레임6D를 구분한다. PD 단독 토크나 포화로 승격하지 않는다. step0은 물리 샘플이 아니며 양의 모든120Hz 샘플을 검사한다. 계획078·outputs/isaac-torque-observer-v1 결과 참조.
