WINNAKEN/robot-arm-lab/docs/design/014-product-exterior-v2-display-kit.md

> 개발 이력: 작성 당시의 계획·결과입니다. 현재 상태는 [STATUS](../STATUS.md)를 확인하세요. 원시 로그와 로컬 경로 일부는 공개본에서 제외했습니다.

# MP4 — 1:1 제품 외장 v2 · J2 첫 분할 · 오늘 H2D 끼움 시험편

2026-10-23 사용자: 「작업계속 이어가고 마무리하고 이제 실제 프로젝트를 하나해보자 우선 오늘저녁에 h2d를 사용할수있게되기때문에 준비해야하고
C:\projects\robot-arm-lab 이 프로젝트에 지금 코덱스 써서 좀 원리나 이런것관련해서 모델링 컨셉 새롭게 짠게있어 이거 좀 제품답게 만들어봐」.
작업자 = Claude(모델링 — `.dev/HANDOFF.md` 의 역할 분담: 모델링은 Claude/PrintForge, 제어는 Codex). 파일 이름의 `display-kit` 는 첫 판의 이름이며,
결정 2 로 축소 전시 모형은 하지 않는다.

## 사용자 결정 — 질문 창 넷의 원문

원문 전체(질문 · 선택지 이름 · 설명 · 답)는 `.dev/product-v2-evidence/user-decisions-mp4.json`(세션 기록에서 스크립트로 꺼냄). 고른 것과 그 설명:

1. 오늘 출력 = **「6축 제품 시안 축소 모형 (권장)」** — *"제품답게 다듬은 6축 외관을 1:2 정도로 줄인 전시용 모형을 H2D 두 색(예: 흰 몸체 + 주황
   링)으로 한 판에 출력합니다. 모터 실측 없이 오늘 바로 출력할 수 있습니다. 움직이는 기능 부품은 아닙니다."* · 다듬는 범위 = **「외관 디자인 v2
   (권장)」** — *"모터·드라이버를 외장 안으로 숨기고, 둥근 링크 셸 · 관절 덮개와 색 링 · 베이스 하우징 · 케이블 통로를 넣은 제품 시안을 새로
   만듭니다(보기 정본 + 출력용 분할). 내부 감속기 · 베어링 · 볼트 설계는 하지 않습니다."*
2. (L2 R1 뒤) 축소 비율 → 글 답 *「잠깐만 생각해보면 1:1로 모델링은 뽑아놔야지 프린팅을 이모형을 할건아니잖아 모델링에서 컨셉을 좀더 1:1로하고 이제
   분리할걸 분리해야지」* · 두 색 = **「흰 판 · 주황 판 따로 (권장)」** — *"흰 부품 판과 주황 부품(색 링 · 끝 덮개) 판을 따로 준비하고 판마다
   시간·재료 견적을 드립니다. 원하시면 뱀부 스튜디오에서 두 파일을 한 판으로 합치실 수 있습니다."* · 관절 연결 → 글 답 *「실제적으로하자 좀더
   지금은 모형만하는데 이제 잘라서 실설계까지 하고싶은거야 필요하면 MECH SPARRING 까지 써서 검토해」* · 케이블 통로 = **「베이스→손목 이어진 통로」**
   — *"실제 크기 모델에 지름 6 mm 정도의 이어진 통로를 두고 다른 부품과 겹치지 않는지 확인합니다. 시간이 더 걸리고, 축소 모형에는 너무 가늘어 빝니다."*(「빝니다」 도 질문 창의 오타)
3. 오늘 출력 = **「끝움 시험편 세트 (권장)」**(「끼움」 의 오타 — 작성자가 질문 창 글을 이스케이프로 적다 낸 오타. 원문 그대로 둔다) — *"NEMA17
   장착면(Ø22 보스 · M3 구멍 31 mm 간격), 베어링 자리(후보 크기 몇 개), M3 인서트 · 통과 구멍, 링 · 덮개 끌움을 단계별 공차로 만든 작은
   판들입니다(약 1시간 안팎). 이 결과로 1:1 부품의 구멍 치수를 정합니다."* · 감속기 = **「자리만 두고 다음에 선정 (권장)」** — *"오늘은 감속기
   들어갈 공간(지름·깊이)과 모터·출력 접속면만 정해 부품을 나눕니다. 감속기 방식(프린트 사이클로이드 · 프린트 유성 · 기성 감속기 구매)은
   Mech-Sparring 으로 토크·크기를 비교 검토한 뒤 정합니다."*
4. (L2 R2 BLOCK — 예산 2 회 소진 뒤) 검토 진행 = **「고쳐서 바로 진행 (권장)」** — *"두 지적을 계획에 반영하고(관절 하나를 감속기 자리·모터·출력
   접속면까지 첫 분할, 시험편 기록지·판정 기준 추가) 바로 만듭니다. 계획 검토는 더 하지 않고 산출물 검토(L4)에서 함께 봅니다. 오늘 저녁 출력에
   맞출 수 있습니다."* · 가진 부품 = **「M3 열압입 인서트」**(하나만 — M3 볼트 · 608 · NEMA17 모터는 지금 없음) · 첫 분할 관절 = **「J2 어깨
   (권장)」** — *"가장 큰 관절(지름 104 mm)이고 무게를 가장 많이 받습니다. 여기서 정한 꼴을 다른 관절에 줄여 씁니다."*

작성자 해석(검수 대상): 축소 모형은 하지 않는다(2). 1:1 외장 v2 를 정본으로 두고(A2), 「분리할 걸 분리」 · 「실설계」 의 첫 단계로 J2 를 실제 부품으로
나눈다(A3 — 결정 3 · 4 의 「오늘 … 부품을 나눕니다」). 감속기는 공간 · 접속면만(3). 「두 색 따로」 는 출력 부품(흰 몸체 · 주황 링과 덮개)에 적용하고
오늘 시험편은 한 색. 케이블 통로(2)는 다음 단계 B2 — A2 외곽은 통로 자리를 아직 두지 않아 B2 에서 바뀔 수 있다.

## 오늘(A) — 차례와 자를 선

차례 = A1(오늘 저녁 출력의 핵심 경로) → A2 → A3. 시간이 모자라면 A2 의 STEP · 렌더, A3 의 렌더를 뒤로 미룬다. L4 PASS 전에 넘기는 것은 「L4 전 —
미검수」 라고 적는다.

### A1 끼움 시험편 세트

- 생성기 `src/cad/fit-coupons-v1/build_coupons.py` → `models/fit-coupons-v1/`(편집 이력 있는 SolidCraft · 판 STL · STEP · 미리보기 · `coupons.json` ·
  README 기록지). 출력 준비 = PrintForge `printprep` 한 판(여러 셸이 든 STL 하나 — 도구는 물체 하나만 받고 방향을 바꾸지 않는다 `--orient 0` → 방향은
  생성기가 잡는다) · 실행기 `run_slice_prep.py`(MP1 의 것과 같은 꼴 — 명령 · 해시 · 종료 값 · 보고서) → `.dev/fit-coupons-evidence/`.
- **출력 조건 고정**(MP1 과 같다 · 1:1 부품도 같은 조건으로 뽑는다 — 다르면 끼움을 다시 잰다): Bambu Lab H2D 0.4 nozzle · 0.20mm Standard @BBL H2D ·
  Bambu PLA Basic @BBL H2D · Textured PEI Plate · 지지대 auto.
- 항목(지름 기준 — ④ 만 반지름 틈 · 숫자 = 모델 치수 그대로 새김):
  - ① NEMA17 장착면 판 셋: 두께 3 · 파일럿 **관통 구멍** Ø22.15 / 22.30 / 22.45(모터 보스 Ø22 · 높이 약 2) · M3 통과 Ø3.4 네 개(31 mm 정사각).
  - ② 608(d × D × B = 8 × 22 × 7) 바깥 고리 자리: 높이 5 · Ø22.00 / 22.10 / 22.20 / 22.30. (관절 베어링은 감속기 선정 뒤 — 6806 고리는 시간 때문에 뺐다.)
  - ③ M3 구멍 덩어리(높이 10): 통과 Ø3.2 / 3.4 / 3.6(관통) · 셀프탭 Ø2.5 / 2.7 / 2.9(깊이 8) · 인서트 Ø4.0 / 4.2 / 4.4(깊이 8 — 길이 5.7 형까지 + 2.3) ·
    같은 아홉을 가로(눕힌 구멍 · 깊이 10)로 한 번 더.
  - ④ 링 · 덮개 미끄럼 끼움: 속 빈 Ø40 보스(벽 4) + 고리 안지름 Ø40.20 / 40.40 / 40.60(반지름 틈 0.10 / 0.20 / 0.30 · 점 1 / 2 / 3 개).
  - ⑤ D 자 구멍 판(두께 5): D6 핀용(반지름 3 · 평면 5 기준) 틈 0.10 / 0.20 / 0.30 · 모터 축 D5(반지름 2.5 · 평면 4.5) 틈 0.10 / 0.20 / 0.30 + D6 핀 둘(평면을
    판에 눕혀 출력 · 길이 20).
- **판정**(출력 전 — 실행기 · 검사기가 수로 적는다): 셸마다 닫힘 · 체적 양수 · 공동 없음 · 설계 치수로 계산한 최소 재료 두께 ≥ 1.2 mm(새김 글자는
  제외 — 글자는 높이 ≥ 3 · 새김 깊이 0.6 · 못 읽히면 점 · 위치로 가린다) · 판 안(H2D 프로필 350 × 320 × 325 — MP1 보고서) · 구멍마다 축과 Z 의
  각도 기록 · 견적 1.5 시간 이하(넘으면 ⑤ 의 D5 줄 → ③ 의 가로 줄 → ② 의 +0.30 차례로 뺀다). 견적이 1 시간을 넘으면 사용자에게 알린다(선택지
  설명이 「약 1시간 안팎」).
- **끼움 판정**(출력 뒤 — 사용자, README 기록지): 오늘 판정 = ④ · ⑤(출력물끼리 짝) · ③ 의 인서트 구멍(사용자 보유). 나머지(① 모터 · ② 608 · ③ 통과 ·
  셀프탭 — 짝 부품 없음)는 캘리퍼로 출력 치수만 적어 두고 부품이 오면 판정. 판정 말: 「안 들어감 / 눌러 넣음(손 힘) / 손으로 미끄러짐 / 헐거움」.

### A2 1:1 외장 v2 정본

- `src/cad/armold-mks-product-v2/`(`parameters.json` · 형상 라이브러리 `v2geom.py` · `build_product.py` · `validate_product.py` · README) →
  `models/armold-mks-product-v2/`(native — Base + Link1…6 · revolute 6 · STEP · 3MF · 등각 / 정면 / 측면 · v1 과 v2 를 같은 시점으로 나란히 둔 그림 ·
  `bodies.json` · `validation.json` · README). 외장 몸체는 **속이 찬 외곽 덩어리**다(벽 · 속 공간은 B 와 A3).
- 기구학 = v1 그대로: `models/armold-mks-concept-v1/kinematics.json` 의 원점 · 세계 축 · `R_child`(표시 자세 `[15, -50, 70, 15, 25, -10]`도). native 관절 0
  = 표시 자세(v1 과 같은 관례 · ±170 도는 예시). 제어(012 · 013 · 015)는 CAD 값을 아직 쓰지 않는다.
- 관절마다 모터 캔의 쪽(축 방향 기준 · 캔 반지름은 여섯 모두 39 — `parameters.json`):

  | 관절 | 축 | 드럼 지름(v1) | 출력 면 | 모터 캔 |
  |---|---|---|---|---|
  | J1 | Z | 90 | +Z | −Z(베이스 기둥 안 · 덮개 없음) |
  | J2 | Y | 104 | +Y | −Y |
  | J3 | Y | 90 | **−Y** | **+Y**(v1 은 −Y — 전완을 상완 반대쪽에 두려고 뒤집음) |
  | J4 | X | 78 | +X | −X(전완 관을 겸함) |
  | J5 | Y | 78 | +Y | −Y |
  | J6 | X | 78 | +X | −X(손목 관을 겸함) |

- **검사**(`validate_product.py` → `validation.json` 의 `checks` 일곱 — 하나라도 거짓이면 종료 값 1):
  관절 원점 · 축 = v1(값은 native 의 `joint.list` 의 `frame_a` · `frame_b` 에서 읽음 · 원점 허용 1e-6 mm · 단위 축 성분 차 1e-9 — native 관절을 v1 값으로
  만들었으니 이 검사는 native 에 그대로 기록됐는지를 보는 것이다) · 정확 커널 간섭에서 검사 못 한 쌍 0 · 서로 다른 링크 사이 체적 간섭 0 · 가정 상자
  18 개(v1 치수 · v2 배치) · 각 상자가 그 관절 모듈 덩어리 안에 |V(상자 ∩ 모듈) − V(상자)| ≤ 1e-9 · V(상자) · 가정 상자와 다른 링크 간섭 0 · v1
  동결 파일 23 개의 해시 불변(`frozen-manifest.json`). 같은 링크 안의 이음 겹침은 셈만 적는다. 커넥터 상자 모서리 반지름 36.4 와 캔 39 의 차 2.6 mm 는
  벽 두께가 아니다. 「제품 외관」 의 판정은 사용자의 눈.

### A3 J2 첫 분할(실제 부품 — 오늘은 출력하지 않음)

- `src/cad/armold-mks-product-v2/build_j2_split.py` → `models/armold-mks-product-v2/j2-split/`. J2 의 지역 좌표(출력 축 = +Z · 출력 면 z = +18)에서:
  - 부품: **뒤 하우징**(모터 캔 + 뒷벽 한 몸 · 흰) · **감속기 하우징**(드럼 고리 · 출력 베어링 자리 · 흰) · **출력 플랜지**(흰 — 자식 링크와 감속기
    출력을 잇는다) · **색 링**(주황) · **끝 덮개**(주황). 감속기는 공간만(투명 참조 몸체) · 모터 · 드라이버는 v1 가정 상자(참조).
    L4 R1 처분 뒤(F1 · F2): **베어링 누름판**(흰 — 베어링 바깥 고리를 위에서 누르고 색 링을 붙잡음)을 더해 부품 여섯 · 끝 덮개는 뒤 하우징의 기둥 셋에
    M3 · 고정된 쪽의 가장 높은 면(누름판 · 색 링)은 출력 면보다 0.5 낮게(자식 링크는 출력 플랜지에만 닿는다) · A2 의 자식 링크(상완 허브 · 관)를 참조로 그린다.
  - 접속면 표(README): 모터 면(파일럿 · M3 네 개 · 31 mm) · 감속기 공간(지름 · 깊이) · 감속기 출력 접속(볼트 원 · 중심 맞춤) · 출력 베어링 자리(자리
    표시용 후보 — 감속기 선정 뒤 확정) · 부품 사이 체결(M3 열압입 인서트 + 볼트 · 개수 · 반지름) · 끼움 치수는 A1 결과 전 가정값.
  - 검사: 부품끼리 체적 간섭 0(일부러 띄운 틈은 수로) · 가정 상자 18 개 가운데 J2 의 셋이 뒤 하우징의 빈 속에 들고 벽과 간섭 0 · 부품 합의 외곽이 A2 의
    J2 모듈 외곽 안 · 부품마다 닫힘 · 출력 방향(평평한 면이 판에)과 최소 벽 두께. L4 R1 처분 뒤: A2 의 자식 링크와 부품 간섭 0 · 외곽 검사에 예외 없음 ·
    자리파기 · 나사 구멍의 틈 양수.

## 다음(B) — 이번 단위 밖, 사용자와 차례로

B1 나머지 관절 · 링크 셸 · 베이스의 분할(J2 꼴을 줄여 씀 · 끼움 = A1 결과). B2 베이스 → 손목 케이블 통로(결정 2 — 지름 · 관절 통과 방식 · 회전 때 길이
변화 · A2 외곽 수정). B3 감속기 방식 비교(Mech-Sparring). B4 주문한 MKS 2 세트의 두 축 부품 출력.

## 하지 않는 것 · 무접촉 · 커밋

축소 전시 모형 · 감속기 설계 · 실제 모터 장착 확정 · 강도 · 하중 · 프린터 전송 · 구매 · 펌웨어 · 제어 코드. 소유 = 이 계획 ·
`src/cad/armold-mks-product-v2/` · `src/cad/fit-coupons-v1/` · `models/armold-mks-product-v2/` · `models/fit-coupons-v1/` · `.dev/product-v2-evidence/` ·
`.dev/fit-coupons-evidence/`, 그리고 `.dev/CODING_RULES.md` · `.dev/HANDOFF.md` · `.dev/SESSION_HANDOFF.md` 의 **MP4 문단 · 절 덧붙이기만**. 무접촉 =
012 · 013 · 015 와 Codex 의 이후 계획 · 근거 폴더 · `src/firmware/` · v1 · MP1 · MP2 파일. 커밋은 소유 경로만 스테이징하고, 커밋 전후로 `git status` ·
`git diff --cached --stat` 을 본다(같은 브랜치의 Codex 미커밋 변경을 섞지 않는다).

## 검토

새 단위 MP4. L2 R1 · R2 = BLOCK(R2 의 중대 둘 = 결정 3 의 「오늘 부품을 나눕니다」 를 미룸 · 시험편 기록지 없음) → 결정 4 「고쳐서 바로 진행」 으로 L2 는
더 하지 않는다. L4 최대 2 회 — 비작성자(같은 계열 독립 서브에이전트 또는 Codex). 감속기 비교(B3)는 Mech-Sparring.

- L4 R1(Codex `gpt-6.1-sol` high · 2026-10-23) = **`BLOCK — Blocker 0 / Major 2 / Minor 4`** — A1 = 오늘 출력 가 · A2 = 가 · A3 = 불가(F1 플랜지가 자식
  링크와 겹침 · F2 끝 덮개 · 색 링의 빠짐 막음 없음). 영수증 · 처분 = `.dev/product-v2-evidence/l4/`(`mp4-l4-r1-codex.md` · `mp4-l4-r1-disposition.md`).
  처분 뒤 L4 R2(마지막 회).
- L4 R2(Codex `gpt-6.1-sol` high · 2026-10-23) = **`NEEDS_ATTENTION — Blocker 0 / Major 0 / Minor 1`** — R1 의 F1 ~ F6 모두 CLOSED · A1 · A2 · A3 모두 배송 가 ·
  D1(문장 하나 — 고정된 쪽 윗면의 높이)은 고침(`mp4-l4-r2-disposition.md`). L4 2/2 회 · 남은 열린 지적 없음.
