WINNAKEN/robot-arm-lab/docs/design/017-runtime-refresh-phone-execution.md

> 개발 이력: 작성 당시의 계획·결과입니다. 현재 상태는 [STATUS](../STATUS.md)를 확인하세요. 원시 로그와 로컬 경로 일부는 공개본에서 제외했습니다.

# ST3-C — runtime configuration refresh and phone execution roadmap

2026-10-23. L2 R1 PASS7/0; L4 R1 NEEDS_ATTENTION7/2; L3 R2 snapshot frozen for independent L4 R2 (pending). Current user authorizes runtime actual setting rereads and subsequent phone/ESP32 preparation before parts; no flash, device access, purchases or CAD. This file covers **C runtime refresh only**. D phone adapter/safe SDK composition receives its own saved018 plan and independent review after C freezes; no app/UI/HTTP/SDK changes in C. New C budgets declared before first review: L2 max3, L4 max3. D is a genuinely separate adapter/execution boundary, not a renamed C defect or budget reset; unresolved C findings block D integration. Old first-fault/heartbeat/capability/phase findings and disposition remain binding, external-family bridge NOT_RUN (central hook barrier, no bypass).

## 1. Actual baseline and minimal module changes

Current016 completed Boot46fixtures7302assertions/Run51fixtures3426assertions, hardware approvals false/app inactive. SingleSelected Run consumes same-CanPort, move-only BootEvidence with50ms admission, old800ms authority and only scalar earliest4s config expiry. It currently rereads F1/31/32/3A only. Replacing this scalar with a fake renewed timestamp would launder old settings; C instead carries every actual config sample and matches actual periodic transactions.

Owned changes: new shared `src/firmware/components/robot_config/` strict config codec/evidence schema; controlled Boot config compatibility/header/CMake and evidence mint; controlled Run pending/scheduler/config freshness/proof/status/CMake; tests/runtime, necessary Boot/Run runner+expectation updates; this plan and component READMEs; `.dev/runtime-refresh-evidence/build/`. Existing core/gate/StopLink/TWAI/app/HTML/CAD untouched. Root manages top-level records and later target-build integration.

Avoid boot↔run circular dependency: extract existing strict codec implementation into robot_config (depends only robot_core). robot_boot/config_codec.hpp becomes a source-compatible alias shim for existing callers/tests, no duplicate schema/implementation; oldconfig_codec.cpp contains no duplicated definitions. robot_run androbot_boot both REQUIRE robot_config. Preserve handwritten expected wire byte tests and compare extracted behavior against baseline, not only aliases comparing themselves.

## 2. Exact protocol and immutable evidence

ManualV1.0.9 p32 config reads `[00,code,checksum]` DLC3; response echoes **code**, never00, with exact scalar width. Supported schema:82u8=5 (SR_vFOC);84u8=16;8Au8=2(500k);8Bu16=active axis ID;8C two u8 values01/01 (respond/active);4Au8=0(sync off);98u32=1000ms. Big-endian, checksum=(standard CAN ID+prior DATA)&255, DATA/nonRTR/nonextended, ID1/2 before narrowing. `code FF FF C`, DLC4, is explicitunsupported and is rejected before value interpretation. WrongDLC/checksum/code/flags/unrelatedaxis cannot refresh. Runtime emits config **reads only**, never98/F3/settingswrites/calibration/versioninference. Boot retains explicit98write+ACK+newquarantinedread logic, including140ms from98 WRITE confirmedTX. Version40 ambiguity and hardware identity remain externally reviewed approval, not guessed parser.

Shared fixed `ConfigSample` holds valid, value, confirmed_tx_at, dequeued_at; no clock calls, mutable public approval flags or arbitrary raw send. BootEvidence privately carries [2][7] samples, active topology/profile/calibration/principal/issuingCanPort binding and existing deadlines. Mint copies actual validated samples after all-stage proof. Move consumes all private fields once. New Run validation checks each valid flag, expected immutable value, confirmedTX<=dequeue<=now, checkeddequeue+4000 and now<thatdeadline, in addition to existing exact profile/port/move-only/50ms/oldauthority checks. Missing/zero samples cannot be accepted merely because scalar earliestexpiry is future. The scalar earliest configexpiry may remain diagnostic but never acts as a lifetime renewable approval.

All approvals default false. LegacyAllEnabled is still explicitly trusted legacy fixture behavior and is not silently upgraded to production startup. Runtime config monitor is required only for SingleSelected with actualBootEvidence; legacy51 regression behavior remains unchanged. Current transport object identity must outlive capability/actors and stay physically unrebound; no new physical power-cycle detection claim.

## 3. One transport owner, transaction correlation and expiry

Reuse normal actor's sole CanPort owner and one global inflightTX/one pendingresponse. Extend pending kind to DiagnosticRead or ConfigRead; no second actor, FIFO, speculative parallel read, retry or callback-side port access. Original TX50ms, readresponse100ms from actualTXcompletion, poll gap/processing<10ms, RX batch16/backlog checks and alert/error precedence remain. Configpending additionally binds axis+schemaindex+code and same lifetime. ConfigTx API acceptance is not TXsuccess. Only response after matching successful confirmedTX, with dequeue>=TX, dequeue/current processing before deadline and dequeueage<10ms, can update exactly that entry. Pending absent, expired prior generation, duplicate or unsolicited reply remains raw bounded log only. Malformed replies never refresh and ultimately time out. Same axis+code confirmedTX spacing>=140ms, including shared98 Bootwrite/read provenance; no admission/reset refresh.

At **every** request/poll/submission entry, now>=any active entry's actualdequeue+4000 expires before completion/renew/FD. No refresh by reset, seed mint, keepalive, session creation, gateAcquire, normalencoderread or anotheraxis's settings. All additions checked, clock reversal/counter exhaustion fail closed. Actual new matching expected setting read updates only its own actualTX/dequeue/value, removing that entry's old expiry. There is no fixed4s-from-handoff cap once all entries continue to refresh. Actual protocol failure/expiry still stops, never retries/re-enables.

Stop classification: actual config mismatch/unsupported means profile/unchanged-driver premise invalidated → SingleSelected fault + realclose + torqueunknown/manualcut, stop_verifiedfalse, no fresh-driver reset used as approval. Known bus fault remains the016 invalidating close policy. Pure age expiry with no contrary setting evidence may use historical previouslyverified1000 heartbeat for actualStopLink, but actor remains Fault. Configresponse timeout/malformed response follows existing normal transaction-failure stop policy; it does not invent a mismatch or refresh. No action may clear the first fault/time. Preserve original firststop100ms isolation/600ms preparation/3600ms global and terminal no-restart. No config read duringStop/Quiet or after terminal; real new-driver stop verification is separate from current config validity.

## 4. Admission pressure and bounded scheduler

Copying14 timestamps is necessary but insufficient: seed deadlines may be clustered20ms apart from initial Bootreads or spread180ms apart after sparse refresh. A scalar earliestdeadline plus naïve14slot round robin can expire later entries before reaching them. The scheduler must use **each** sample's deadline and request-age budget, not restart a 14-slot cycle at handoff.

Normal fast-fixture cadence remains one eligible transaction at least20ms apart. Diagnostic cycle interleaves axes across F1/31/32/3A; samecode>=140ms. Steady policy inserts at most one ordinary config read after a complete diagnostic cycle, selecting the earliest actual config deadline; begin ordinary prefetch when oldest configage>=1000ms (not at age4000). With fast responses,2axes diagnostic8slots+1config=180ms,3position span360+axisoffset20=380<400;14-entry config rotation2520<4000. One-axis spacing140 is still enforced. These are candidate service rates, not guaranteed success for every response within100ms; overloaded/slow cases fail closed rather than enlargeTTL.

Urgent mode: any config actualexpiry<=now+600ms is eligible ahead of ordinaryprefetch regardless ofcycle cursor. Pick earliest actualdeadline first. Protect currentlyvalid diagnostics: if any latest required diagnostic sample is age>=200ms, service its oldest required diagnostic before another urgent config (and still enforce hard400ms); do not claim a timer alone keeps samplesfresh. While initialChecking has no inherited valid diagnostics, no movement is permitted; urgent seed entries may be refreshed first, then actual fresh normal diagnostic/stability proof is obtained. OriginalChecking2000ms and oldowner800ms still dominate; a seed with insufficient actual timing slack may honestly fail, never gain a new800ms epoch. The scheduler does not guarantee all valid-seed age distributions can succeed under worst-caseAPI/RX latency. Boundary tests must demonstrate clustered seed deadlines handled by actual reads when feasible and exactexpiry fails when not.

Urgent reordering must not fabricate three-position proof or weaken140/400. Repeated configuration bursts may temporarily delay a fresh three-position stopped window; latestdiagnostic freshness remains enforced, completion waits genuine new proof or faults at its original2000ms movement limit. No cursor catch-up burst/FIFO. After every completed transaction, recalculate priorities against current porttime and actual timestamps. If no slot can be safely serviced before a harddeadline, fail closed; do not silently discard an active axis/setting.

Predispatch gate hold: currently arm/ticket pauses normal reads while oldobservations stay<400ms. Do not pause a setting alreadynear expiry. New Arm/Ticket admission requires all actualconfigdeadlines strictly beyond now+400ms; otherwise Busy while realurgentrefresh continues. Existingownedpermit hardchecks both configTTL and diagnosticage; renewal cannot refresh either. Once movingintent is taken, resume normal/config schedule, selectedaxis reservation prevents overlap. Same-valued config replies update config timestamps but do not manufacture encoder/state observations or unrelated gate approvals.

## 5. Host acceptance and mutation tests

Strict C++17 -Wall -Wextra -Werror -pedantic, existinglocalZig; preserve sandbox failure then formal escalation if needed. Tests link actual Boot/sharedcodec/Run/gate/StopLink/StopCoordinator, fakeCanPort only. Preserve fullsource+buildinput/executable hashes and raw failure evidence. ExistingBoot46 andlegacyRun51 fixtures plus original mutants must be rerun; old fixed-config-expiry test is intentionally updated to distinguish newactualrefresh from fakeextension, with originalR2 evidence kept.

C1 codec extraction equivalence against handwritten values and malformed widths/checksum/sentinel/flags/ID; Boot98 ACK/writequarantine still passes. C2 actualBoot→sameport capability→Run seed containsall14real timestamps, wrongprofile/port/expired/reuse/defaultdenial preserved. C3 run beyond old4s **and at leastthree fullconfigrotations** with sameprincipal explicitAcquire/renew and actual per-setting configreads; counts/timestamps show everysetting refreshed, no torque re-enable/FD retry. Includeone-axis[1],[2] andtwoaxis; active-onlysettingcoverage exact.

C4 matchedsettingwrongvalue/unsupportedfor eachschemafamily faults/makesnoverifiedstop, noreset/re-enable; unrelatedaxis/code/checksum/duplicate cannot renew; withheldreply timesout; ageexpiry exact>=4000 before late reply/renew. C5 newestvalue onaxis1 cannotrenewaxis2entry. C6 clustered mixed old seed timestamps copiedexactly, earliest-deadline ordering wins when feasible; infeasible admission/slowreplyfails oldauthority/configdeadline, no fabricated newgrant. C7 simultaneous configdue vsdiagage200/400,140samecode, TX50/read100/poll10 boundaries; predispatchconfigheadroomBusy then actualread allows explicitnewArm; newsettingread cannot satisfy postFD2 positionproof. C8 stoppriority/quiet no configTX, knownbusinvalidatingclose vs age-onlyhistoricalstop, firstfault retained throughcleanup, longrunpoll/RX storagebounded.

Minimum3 compiled behavioral mutants with actual failingtarget assertions: fake all configtimestamps onkeepalive/reset; acceptmismatching/unmatchedconfigasfresh; omitdiagnosticpriority whileconfigurgent. Exact executed fixture/assertioncounts and NOT_RUN gaps stated honestly before L4; full matrix not inferred from compile. No app/network/SDKtarget/hardware in C. C completion requires independentL4 no unresolvedC defects before D production edits.

## 6. D roadmap only — separate018 plan/review

D will define trusted phoneadapter and safetarget composition after C freeze. It must provide bounded2sessions, realauthenticatedprincipal mapping, serverboot/phase namespaces, Host/Origin and typedversion/body/field bounds, rate+queue limits, strictseq/replay, explicit maintenance/unloaded/disable/heartbeat/drive/enable/handoff/normalAcquire/Arm/Ticket/Move routes, distinct status/error/unknownposition fields. Stop gets separatepriority path and never waits behindordinaryqueue; HTTP task never callsport. One supervisor task ownsBoot orRun; disconnect/reconnect neverrestoresauthority, stalephase requests cannot cross Boot→Run.

018 must distinguish simulation backend from actual ESP32 HTTP/SoftAP execution and demonstrate correspondinghostparser/session/queue tests. App compile selects simulation/real path but **defaultdeviceinactive/physicalapprovalsfalse**, noSDK network or CANstartup onhost. Pin existingSDK, buildbothdeclaredpaths, capture freshinputcensus and ELFsymbols proving actualnewruntime/Boot/Run/adapter execution functions link into finalELF, not only unusedarchives. Compilation does not authorizeflash/network/device/motion. Root handles targetbuildintegration afterapprovedDimplementation. No app/UI implementation authorized by this C plan alone; D unresolved scope cannot be declaredcomplete througha mockpage.

## L3 R1 executed evidence and acceptance gap (historical)

Runtime22fixtures/1,525,994assertions PASS; Boot46/7,292 and legacyRun51/3,427 PASS. Three runtime mutations compile successfully and fail their intended assertions (keepalive laundering, wrongaxis, wrongvalue); oldBoot3/Run2 mutants also compile and fail. Tests/runtime/README.md maps actual execution and remaining gaps. In particular, required diagnostic-priority intersection is **NOT PROVEN**: both urgent-only and all-config priority-bypass variants survived the steady schedules; the attempted real Arm setup was denied by genuine position freshness. Those raw failures/survivors are preserved. This is an explicit C acceptance gap for independent L4 disposition, not an author waiver or proof of an unreachable branch. D remains blocked pending independent C acceptance. Exact4000 late-response, clustered-seed pressure and systematic timing/API permutations are not claimed individually executed.

### ST3-C R2 validation snapshot (independent L4R2 pending)

Runtime28fixtures/1527570assertions,5 compiled failing behavioral mutants; oldBoot46/7292+3 andRun51/3427+2 pass. Actual wire RX-age observer now kills the original urgent-only priority mutation (bad config dispatch age3402 vs diag250; positive maximum159). Shared production freshness/headroom predicates, used by actual actor, pin4000/400/overflow while real seed/EDF/one-entry nonrenew/late reply/admission traces pin consumer use. PostFD2 real config response cannot replace new positions; completion follows genuine proof515ms later. Exact actorTTL/headroom race is represented by the explicitly reviewer-permitted predicate+consumer alternative, not falsely claimed isolated wire crossing. See tests/runtime/README.md for exact evidence/limits. Historical R1 survivor gap remains in preserved R1 snapshot; current R2 awaits independent disposition.
