WINNAKEN/robot-arm-lab/docs/design/018-phone-and-esp32-execution.md

> 개발 이력: 작성 당시의 계획·결과입니다. 현재 상태는 [STATUS](../STATUS.md)를 확인하세요. 원시 로그와 로컬 경로 일부는 공개본에서 제외했습니다.

# ST3-D — phone adapter and ESP32 execution preparation

2026-10-23, L1 plan only. Root is plan author; a separate implementation author and independent reviewer are required. L2 max3/L4 max3 declared before review. ST3-C must pass before D production changes. Unresolved findings and previous first-fault recurrence lineage carry forward; a new number does not reset them. Scope is offline preparation and actual pinned SDK compile/link, never flash/device access/purchases/CAD. Current hardware approvals remain false.

## Composition and ownership

New `robot_phone` component composes actual Supervisor and BenchRun through one exact CanPort. Only the serialized control owner may create core sessions, call requests, poll, mint/consume handoff, or touch the port. Boot is terminal before Run starts. No second port or duplicated configuration cache. C's per-setting freshness and diagnostic/stop timing guards remain authoritative.

HTTP task may only receive/validate bounded wire input and send envelopes to the owner. It cannot call a core's open_session/request/status directly: those APIs may inspect deadlines or physical state. The owner publishes copied bounded status/results for HTTP. SDK queue/locking details must prevent data races; never hold a network/mutex wait across a CAN call. Control task polls every1ms candidate (FreeRTOS1000Hz); actual scheduler/API/ISR bounds remain hardware NOT_RUN. HTTP receive/send can block only its own lower-priority task with finite timeouts.

Owner phases are Boot, RunChecking, Run, Stopping, Terminal; monotonically increasing phase generation fences old queued input. No request replay/automatic Acquire/Arm/Ticket/Move across handoff or reconnect. Only explicit authenticated Handoff requests mint/consume actual BootEvidence and preserve its principal/port/deadlines. Two interactive session slots maximum; initial implementation may retain slots for a boot lifetime, clearly reporting SessionFull until explicit reboot. Stateless status reads need not allocate slots. Any slot reclamation instead requires a reviewed expiry/owner-stop/generation contract, never silent reuse.

## Bounded wire contract and trust

Choose a small versioned ASCII POST body rather than a permissive JSON-to-core cast. Exactly eleven pipe-delimited fields: `v1|boot|phase|seq|request|op|lease|ticket|axis|direction|unloaded`. Maximum256 bytes, ASCII only, no escapes/extra fields/signs/whitespace/NUL/trailing data. Decimal unsigned fields check overflow before conversion; boolean exactly0/1; axis0/1/2 and direction0/1, operation allowlist. Wire IDs are decimal strings in JSON status to preserve uint64 beyond JavaScript precision. Tests use handwritten request bytes and inspect actual routed core results.

Server session identity and authenticated principal are not accepted from body fields. HTTP headers carry a server-issued random session credential after pairing; body boot/phase must exactly match copied current owner values. Pairing credential is freshly generated at each prepared ESP32 boot from ESP hardware RNG, never a checked-in fixed token. Session credentials are also random and bound to one internal slot/principal; invalid/duplicate/expired credentials cannot impersonate another slot. Constant-length comparisons avoid partial/prefix matches. Credential, payload and raw CAN are never placed in GET URLs or status logs. Serial onboarding prints credentials deliberately once for the operator; routine logs and API status do not expose them.

Prepared target is local SoftAP only: WPA2 password and pairing credential supplied through serial onboarding on the actual board, no Internet/cloud/OTA. Exact per-listener Host policy: ordinary port80 accepts only `192.168.4.1` (browser's default-port Host); Stop port8081 accepts only `192.168.4.1:8081`. Cross-listener Host, arbitrary suffix/port, missing or duplicate Host is rejected. Both listeners accept only Origin `http://192.168.4.1` for state changes and Stop preflight; no CORS wildcard or missing/null Origin exception. Pairing route also requires pairing credential and correct Origin. Same-origin page holds session credential only in memory; reconnect/reload does not restore motion authority or resend a request. No claim of TLS or protection from an already-authorized credential holder. Host tests inject deterministic credentials through an explicit fixture dependency; no fixture secret reaches prepared target.

Routes on port80: GET `/` serves the embedded page; authenticated GET `/api/status` returns copied owner status; POST `/api/session` pairs/opens a slot; POST `/api/command` accepts only the strict grammar and session credential but excludes Stop. An independent HTTP instance on port8081 accepts POST `/api/stop` only for the same wire grammar with Stop opcode, plus bounded OPTIONS. Distinct TCP and HTTP control-UDP ports and server tasks prevent an ordinary fragmented receive or result wait from blocking Stop ingress. Stop server has exact `Access-Control-Allow-Origin: http://192.168.4.1`, allowed POST/OPTIONS and explicit credential/content-type header list, never wildcard or reflected arbitrary Origin. Other routes/methods and normal operations on Stop port fail. Both instances share the copied-message owner bridge, never live core objects. Browser uses explicit `http://192.168.4.1:8081/api/stop` for Stop; it is separate software-stop ingress, not a physical emergency-stop guarantee.

Pinned SDK public header getters return only the first match and cannot prove duplicate rejection. Each actual server therefore installs the supported `open_fn` plus `httpd_sess_set_recv_override` and per-socket transport context. A portable raw-header guard accumulates at most1024 bytes through CRLFCRLF over arbitrary receive fragments, enforcing request-line/header syntax and case-insensitive uniqueness of Host, Origin, authorization/session credential, Content-Length and Content-Type. Reject obs-fold, conflicting framing/Transfer-Encoding, NUL, malformed CRLF and oversized input. The recv override validates the complete raw header before returning the fragment containing its terminating bytes to the SDK parser. Invalid input returns a socket error/close before URI dispatch; no private SDK struct/header access. Already-delivered partial header bytes cannot dispatch a request without the terminating fragment. Subsequent body reads do not enter the header recorder. Mandatory one request per connection, `Connection: close` and actual session close prevent pipelined data from reusing the guard. New connection gets a new guard/deadline. Portable tests feed the exact same guard fragmented duplicate-header cases; target wrapper must call that guard, not rely solely on ordinary SDK getters.

Content type/length, fragmented body completion and malformed body fail before admission. Exact limits: body256, raw headers1024, ordinary external client sockets2 and Stop external client socket1 (HTTP max_open_sockets5/4 including SDK internal3); LWIP socket allocation16; one normal owner job and one Stop job; owner result wait50ms, no retry; accepted normal enqueue age<50ms at consume; authenticated ordinary commands at most10/s per session with burst4 (permits explicit Arm/Ticket/Move plus a lease renewal), Stop independent of that bucket. Status polling is separately bounded5/s and never renews authority. Socket receive/send timeout100ms, total per-request header/body deadline250ms checked around calls; any timeout closes rather than restarting the total deadline. A network stall or malicious use of the Stop listener can still delay another network Stop; no hostile network availability guarantee is claimed. Separate Stop ingress specifically prevents ordinary work and its response wait from blocking Stop. Never accept user-controlled profile approval/calibration/rawCAN/unlimited pulses/speed/torque settings.

One bounded normal job slot and one independent Stop slot, with finite handler wait for correlated response. Full normal slot returnsBusy; no FIFO of moves, no replace/retry of an accepted move. Stop is serviced before normal work; on Stop acceptance invalidate pending ordinary job and never extend the first stop time. Envelopes include server enqueue time and generation. Owner rejects stale normal jobs before touching core; delay allowance is explicit and less than core observation/lease limits. Stop scheduling delay must also fail closed and cannot manufacture a later deadline. Software stop timing is measured from core's actual owner acceptance, not the phone tap or HTTP receive; queue and network latency are reported separately, never presented as a physical emergency-stop bound.

For the portable component, all adapter/session/queue state has one serialized owner. The SDK wrapper uses bounded FreeRTOS command/result queues, copies envelopes, and publishes snapshots without concurrently reading live core objects. At most one pending HTTP result per handler; late results cannot satisfy a later request (unique job generation), timeout does not auto-retry. Invalid credentials do not consume core sequence or authority. Exact caps/rates are constants with tests; Stop must remain admissible to a valid observer under ordinary-command saturation.

## Explicit UI and command mapping

Operations are allowlisted and namespace-specific: maintenance acquire/renew, unloaded confirmation, DisableAll, FinishMaintenance, drive acquire, EnableSelected, Handoff, normal acquire/renew, Arm, Ticket, Move, Release, Stop. A same-named numeric enum from Boot cannot be cast into Run. Selected axis is immutable from reviewed profile; axis tabs only change display. The UI may perform Arm/Ticket/Move as an explicit single-click sequence only after each actual response, with no speculative or retry sends. A rejected step stops that sequence. Lease keepalive200ms starts only after explicit acquisition and stops on hidden page, connection loss, phase change or any error; no reconnect acquire.

Phone page is responsive and embedded from repository source, with no CDN. It displays phase/generation, actual core status and fault, selected axis, position validity/age, configuration oldest age, lease owner/expiry, queued versus core accepted result, stop_verified and manual_power_cut_required separately. Unknown positions are not zero. Stale/hidden/disconnected pages disable motion immediately and discard local tickets. Always visible software Stop remains distinct from torque disable/unloaded confirmation. No UI control can set physical approvals. A clear hardware-unapproved banner is mandatory for the prepared target.

The new page is not the old mockup. Offline browser/model tests use explicit simulated snapshots and a simulation badge; the embedded target page calls actual SDK routes/core composition. Validation must distinguish parser/model execution, HTML/browser preview, actual target compile/link and NOT_RUN on-board networking/motion.

## SDK entry and target build

Pinned ESP-IDF5.5.6/ESP32-S3 tools already installed and freshly verified. New main composition and HTTP/SoftAP source, component CMake dependencies and project option may be edited. Default entry remains inactive. A separate `ROBOT_LAB_PREPARED_RUNTIME` build option selects the actual task/HTTP/SoftAP composition for compile/link verification; hardware/profile approvals remain immutable false in that prepared profile, so core begin denies before TWAI reset/submit. An old menu approval flag cannot override this. Actual profile acceptance is a future change, not a writable web setting.

Build default inactive and prepared-runtime variants in new ignored build directories without altering old ST2 evidence. Capture before/after source census including every new C++/header/CMake/Kconfig/web resource plus SDK config/compile inputs; build exit, full warnings, BIN/ELF sizes/hashes and nm/map evidence. Prepared final ELF must contain reachable actual owner tick, phone dispatch, Supervisor, BenchRun, StopLink, IdfTwaiPort and SDK HTTP/Wi-Fi functions, not just unreferenced archives or an artificial keep-symbol list. App references a real task function selected by the prepared build option; approvals prevent physical commands at runtime. No build script invokes flash/monitor/serial/device discovery.

## Acceptance

Strict portable C++17 host tests exercise actual phone parser/adapter+actualBoot/Run with fake CanPort: default denial0I/O; exact credential/Host/Origin; overflow/duplicate/extra/truncated fields; phase/boot/replay; two sessions and observer Stop; ordinary saturation/Stop priority/stale queue/late result; explicit full maintenance-to-Run path, repeated moves beyond old4s with actual C refresh; disconnect/lease expiry and no auto-resume; stop/cleanup first-error preservation. Minimum three behavioral mutants must compile and fail targeted tests (authentication bypass, phase fence omission, normal-before-Stop). Re-run C/Boot/Run suites.

UI state tests cover stale/hidden/phase changes clearing authority and tickets, error halting the explicit move sequence, no automatic acquire on reconnect and uint64 string handling. SDK-boundary tests additionally exercise both independent ingress paths: a withheld ordinary body/result does not occupy Stop task/queue, wrong port/op rejected, correct ordinary Host without port and Stop Host with8081 pass, swapping either Host fails, exact common Origin/CORS/OPTIONS, fragmented duplicate raw headers rejected before dispatch, header/body deadline not renewed and late result not reused. The100ms socket timeout uses supported per-socket timeval settings in open_fn; integer-second SDK recv_wait_timeout/send_wait_timeout fields alone do not implement it. These may use SDK stubs around actual production wrapper but must be distinguished from on-board networking. Build tests check actual embedded resource equality and route/production linkage. If actual browser rendering is inspected record it separately; do not call static source tests a mobile usability test. Target compile/link both modes plus actual symbols is required before D completion. Physical Wi-Fi/CAN/torque/response timing remains NOT_RUN.

Save raw failures and frozen manifests under `.dev/phone-runtime-evidence/`. Independent L4 covers full portable/SDK wrapper/UI/build composition and declares exact tested gaps. Final records state C/D completion separately, external-family NOT_RUN if bridge remains blocked, local commit/push status and next received-hardware acceptance.
