WINNAKEN/robot-arm-lab/docs/design/022-modeling-reducer-review.md

> 개발 이력: 작성 당시의 계획·결과입니다. 현재 상태는 [STATUS](../STATUS.md)를 확인하세요. 원시 로그와 로컬 경로 일부는 공개본에서 제외했습니다.

# MP5 — 모델링 · 감속기 검토 (Mech-Sparring 방식 · Claude 모델링 · 2026-10-23)

작업자 = Claude(모델링 담당 — `.dev/HANDOFF.md` 의 역할 분담). 파일 번호: 처음 `021-…` 로 만들었으나 Codex 의 계획 021(`021-joint-frames-and-zero-transform.md` ·
관절축 · 영점)과 겹쳐 022 로 옮겼다 — R1 원문 · R1 브리프 · 사전 점검 원문의 「021」 은 이 문서다. 이 문서는 계획이자 검토 보고서다. 결정은 사용자가 한다 — 아래 「권고」 는 작성자의 제안이다.

## 요청 (원문)

- 2026-10-23 사용자: 「실험편은 좀 나중에나올거야 모델링이랑 감속기 관련 검토좀더해봐」.
- MP4 결정(계획 014 · 원문 `.dev/product-v2-evidence/user-decisions-mp4.json`): 관절 질문의 답 「실제적으로하자 좀더 지금은 모형만하는데 이제 잘라서 실설계까지
  하고싶은거야 필요하면 MECH SPARRING 까지 써서 검토해」 · 감속기 질문의 답 「자리만 두고 다음에 선정 (권장)」 — 그 설명은 감속기 방식을 「Mech-Sparring 으로
  … 비교 검토한 뒤 정합니다」 라고 했다.

## 방법 — Mech-Sparring 방식

Mech-Sparring(`C:\projects\Mech-Sparring` · KineSpar)의 원칙: **LLM 은 제안만 하고(수치 생성 금지), 검증은 결정론 계산이, 승인은 엔지니어가 한다.** 그
저장소의 코드는 아직 단위 · 물리량 층(Phase 0)이라 감속기 비교 도구로 돌릴 수 없다(그 저장소는 읽기만 했다). 그래서 원칙만 따른다:

1. 입력 = 저장소 파일(v1 `parameters.json` · `kinematics.json` · v2 `parameters.json` · A2 의 몸체 부피 · 겉넓이 · 중심(`main-eval.json`) · J2 분할 부품 ·
   시험편 3MF 의 출력 설정 · 슬라이서 결과)과 `src/cad/review-mp5/inputs.json`(출처가 있는 값과 **ASSUMPTION** 표지가 붙은 가정).
2. 계산 = `src/cad/review-mp5/joint_loads.py`(결정론 · 같은 입력이면 같은 값) → `.dev/mp5-review-evidence/loads.json` · `loads.md`. 산출물에 읽은 입력
   파일마다 sha256 이 남는다.
3. **이 문서의 표는 `loads.md` 의 블록(`<!-- mp5-…:begin -->` ~ `end`)을 줄 그대로 옮긴 것이다.** `src/cad/review-mp5/check_doc_sync.py --rerun` 이
   (가) 입력 해시가 지금 파일과 같은지 (나) 이 문서의 블록이 `loads.md` 와 글자 그대로 같은지 (다) 다시 계산한 `loads.md` 가 저장된 것과 바이트로 같은지를
   본다 — 입력이나 계산이 바뀌었는데 이 문서를 고치지 않으면 실패한다. 표 밖 문장의 계산 수는 블록의 값이고(입력 표의 가정 값은 `inputs.json`),
   블록 밖 문장은 이 검사가 대조하지 않으므로 L4 가 대조한다.
4. 후보 비교 · 권고 = 작성자의 제안(계산 결과와 참고 기체의 공개 값에 근거) — 사용자가 고른다.
5. 비작성자 검토(L4 · 최대 2 회) — 계산 스크립트 · 입력 · 이 문서의 수와 논리.

## 하지 않는 것 · 무접촉

- 모델 파일(A2 · J2 분할 · 시험편)을 고치지 않는다 — **Codex 의 계획 020(관절 계약)이 v2 파일의 해시를 후보 스냅샷으로 고정한다.** 레이아웃을 바꿔야 하면
  v2 를 고치지 않고 새 판(v3)으로 만들고 HANDOFF 로 Codex 에 알린다(이 단위에서는 만들지 않는다).
- 감속기 설계 · 구매 · 출력 · 펌웨어 · 제어 코드 없음. Mech-Sparring · Codex 파일 무접촉.
- 소유 = 이 문서 · `src/cad/review-mp5/` · `.dev/mp5-review-evidence/` · HANDOFF 류의 MP5 절 덧붙이기.

## L4 R1(BLOCK — 주요 5 · 작은 7) 뒤 바뀐 것

원문 = `.dev/mp5-review-evidence/mp5-l4-r1-codex.md` · 처리 기록 = `.dev/mp5-review-evidence/mp5-l4-r1-disposition.md`.

| 지적 | 고친 것 |
|---|---|
| F1 구동 토크를 베어링 굽힘으로 봄 | M6 를 다시 썼다 — 베어링이 받는 반경 힘 · 기울임 모멘트를 따로 계산(「J2 출력 베어링」 블록) |
| F2 27:1 이면 손목에 충분 | 필요 감속비를 **올림** 표시 · 후보 구동마다 「필요 토크를 내는 가장 큰 짐」 을 계산이 판정(「후보 구동 판정」 블록) |
| F3 1 단 후보를 NEMA23 어깨에 가능하다고 봄 | 같은 판정 블록 — 27:1 은 어느 어깨 시나리오도 못 낸다 |
| F4 S2 범위를 NEMA17 전체로 일반화 | 모터 길이(S1 · S2 · S3)마다 범위를 따로 적었다 |
| F5 가정 쌓임을 필수 외장 증가로 확대 | M1 을 「그 가정대로면」 의 조건부로 고쳤다 · 표의 수만 쓴다 |
| F6 J4 = J5 복사 | J4 = J5 를 90° 꺾었을 때 두 방향 모멘트의 합 크기(J5 캔의 옆 편심 포함) |
| F7 관 · 목 · 롤 모듈의 자리가 A2 와 다름 | A2 몸체 중심을 `kinematics.json` 의 관절 원점 · 축에 투영 |
| F8 점질량 관성만 · J6 관성 0 | 요소마다 원판 자기 관성(어림 가정 — 상한 아님 · R2 D1) · 관절이 돌리는 요소를 링크 소속으로(축 위 허브 포함) · J6 원판 · J1 에 J2 묶음 · 링크1 · 옆 편심 |
| F9 출력 설정 근사를 출처처럼 씀 | 시험편 3MF 의 설정을 계산이 직접 읽는다(벽 0.42 + 0.45 · 채움 15 % · 밀도 1.26) · 윗면 · 아랫면 차이는 가정으로 적음 |
| F10 「지배 변수」 단정 | 민감도를 16 가지로 넓히고, 순서는 「이 범위 안에서」 로만 말한다 |
| F11 문서 ↔ 산출물 동기 장치 없음 | 입력 sha256 · 블록 대조 · 다시 계산 비교(`check_doc_sync.py`) |
| F12 Armold 가 Sweep 26:1 을 쓴다고 씀 | 구매 메모가 「확인할 질문」 으로 남긴 것으로 고쳤다 |

## 입력 (요지 — 전부는 `inputs.json` · `loads.json`)

| 항목 | 값 | 근거 |
|---|---|---|
| 팔 길이 | 상완 165 · 전완 140 · 손목 78 / 140 mm · 드럼 깊이 36 · 캔 67 | v1 `parameters.json` · `kinematics.json` · v2 외장 식(캔 = 3 + 모터 40 + 2 + 드라이버 18 + 뒤 여유 4) |
| 출력 질량 모형 | 밀도 × (겉넓이 × 벽 + 나머지 × 채움) — 벽 · 채움 · 밀도는 시험편 3MF 에서 읽음 | 아래 「질량」 블록 · 벽 두께를 모든 면에 쓴 것(윗면 1.0 mm · 아랫면 3 층)은 **가정** |
| 관절 모듈 출력 부품 | J2 = 분할 여섯 부품 · 다른 관절 = A2 외곽의 모형 질량 비로 키우거나 줄임 | J2 분할 · A2 eval |
| 링크 몸체 | A2 의 속이 찬 외곽 몸체를 같은 모형으로 | 속 빈 실부품과 다를 수 있다(아래 한계) |
| 모터 | NEMA17-40 0.40 N·m · 0.28 kg / NEMA17-48 0.59 N·m · 0.39 kg / NEMA17-60 0.65 N·m · 0.50 kg(질량 가정) / NEMA23-56 1.26 N·m · 0.70 kg | 판매처 표기(아래 출처 — 이 검토에서 다시 확인하지 않음) · **주문한 MKS 모터는 아직 재지 않았다** |
| 구동 보드 | MKS SERVO42D 0 ~ 3000 mA(NEMA17) · SERVO57D 0 ~ 5200 mA(NEMA23) | MKS CAN 매뉴얼 V1.0.9(`.dev/mks-can-v109-text.txt`) |
| 가정 | 쓸 수 있는 토크 = 유지 토크의 50 % · 안전율 2 · 관절 가속 2 rad/s² · 감속기 금속 0.15 kg/관절 · 드라이버 보드 0.03 kg · 짐 중심 = 플랜지 + 50 mm · J6 짐 편심 20 mm · 자기 관성 반지름 52 mm(어림 — 상한 아님) · 효율(사이클로이드 0.75 · 앞단 + 사이클로이드 0.7125 = 0.75 × 0.95 · 복합 유성 0.55 · 상용 기어헤드 0.73) · 모터 300 rpm 에서 그 토크 · 앞단 비 2 · 3 · 5 · 6 · 8 | **ASSUMPTION**(두 축 시험의 실측으로 바꿀 것) |
| 자세 | 팔을 수평으로 곧게 편 자세(J2 · J3 · J5) · J4 = J5 를 90° 꺾은 경우(J5 가 거기까지 간다는 것도 가정 — `kinematics.json` 의 ±170° 는 확인 안 된 표시용) · J1 = 관성만 · J6 = 짐 편심 | 계산 스크립트 머리말 |

시나리오: S1 = 여섯 축 모두 NEMA17-40(v1 가정) · S2 = 모두 NEMA17-48 · S3 = J2 · J3 NEMA17-60, 나머지 NEMA17-48 · S4 = J2 · J3 NEMA23-56(57D), 나머지 NEMA17-48.
모터가 길어져도 캔 · 인쇄 질량은 A2(모터 40 mm 기준)로 두었다 — 실제로는 캔이 길어져 조금 더 무겁다(「모터 · 캔 맞춤」 블록).

## 결과

### 질량

<!-- mp5-mass:begin -->
- 출력 설정(시험편 3MF에서 읽음): 벽 0.87 mm · 채움 15 % · 필라멘트 밀도 1.26 g/cm³
- 질량 모형 점검(끼움 시험편 판 하나): 모형 47.8 g · 슬라이서 43.11 g · 모형/슬라이서 1.108
- J2 분할 여섯 부품의 모형 질량 = 161 g · 관절 모듈 출력 부품(외곽 비로 추정) = J3 142 g · J4 130 g · J5 130 g · J6 130 g
- J2 너머 팔 질량(짐 제외): S1 2.67 kg · S2 3.11 kg · S3 3.22 kg · S4 3.42 kg
<!-- mp5-mass:end -->

모형이 이 판 하나에서 슬라이서보다 무겁게 나온다 — 출력 질량을 크게 잡는 쪽이다. 슬라이서 비로 모든 출력 질량을 줄여도 J2 필요 감속비는 1.7 % 만 줄었다
(아래 민감도).

### 관절별 필요 토크 · 감속비

필요 감속비 = 필요 토크(안전율 포함) / (유지 토크 × 0.5 × 효율). **소수 첫째 자리로 올림** — 고를 감속비는 표의 값 이상이어야 한다. 「앞단+사이클로이드」 ·
「복합 유성」 은 같은 필요 토크를 다른 효율 가정으로 나눈 값이다.

<!-- mp5-summary:begin -->
| 시나리오(J2 · J3 모터) | 짐 kg | J2 필요 N·m | J2 필요 감속비: 사이클로이드 · 앞단+사이클로이드 · 복합 유성 | 사이클로이드 비일 때 J2 °/s | J3 필요 감속비(사이클로이드) | J4 필요 감속비 | J5 필요 감속비 | J1 필요 감속비(관성만) | J6 필요 감속비 |
|---|---|---|---|---|---|---|---|---|---|
| S1 (NEMA17-40) | 0.0 | 17.67 | 117.9 · 124.1 · 160.7 | 15.2 | 56.6 | 9.5 | 9.2 | 8.5 | 0.1 |
| S1 (NEMA17-40) | 0.25 | 21.01 | 140.1 · 147.5 · 191.0 | 12.8 | 72.3 | 17.0 | 16.8 | 11.0 | 0.7 |
| S1 (NEMA17-40) | 0.5 | 24.34 | 162.3 · 170.9 · 221.3 | 11.0 | 88.0 | 24.6 | 24.4 | 13.4 | 1.4 |
| S1 (NEMA17-40) | 1.0 | 31.01 | 206.8 · 217.7 · 282.0 | 8.7 | 119.3 | 39.7 | 39.6 | 18.3 | 2.7 |
| S2 (NEMA17-48) | 0.0 | 20.61 | 93.2 · 98.1 · 127.1 | 19.3 | 44.6 | 7.4 | 7.1 | 6.7 | 0.1 |
| S2 (NEMA17-48) | 0.25 | 23.95 | 108.3 · 114.0 · 147.6 | 16.6 | 55.2 | 12.5 | 12.3 | 8.4 | 0.5 |
| S2 (NEMA17-48) | 0.5 | 27.28 | 123.3 · 129.8 · 168.2 | 14.5 | 65.9 | 17.6 | 17.4 | 10.0 | 1.0 |
| S2 (NEMA17-48) | 1.0 | 33.95 | 153.5 · 161.6 · 209.3 | 11.7 | 87.1 | 27.8 | 27.7 | 13.4 | 1.9 |
| S3 (NEMA17-60) | 0.0 | 20.98 | 86.1 · 90.6 · 117.4 | 20.9 | 40.5 | 7.4 | 7.1 | 6.8 | 0.1 |
| S3 (NEMA17-60) | 0.25 | 24.31 | 99.8 · 105.0 · 136.1 | 18.0 | 50.1 | 12.5 | 12.3 | 8.5 | 0.5 |
| S3 (NEMA17-60) | 0.5 | 27.65 | 113.5 · 119.5 · 154.7 | 15.8 | 59.8 | 17.6 | 17.4 | 10.1 | 1.0 |
| S3 (NEMA17-60) | 1.0 | 34.32 | 140.8 · 148.3 · 192.0 | 12.7 | 79.1 | 27.8 | 27.7 | 13.4 | 1.9 |
| S4 (NEMA23-56) | 0.0 | 21.65 | 45.9 · 48.3 · 62.5 | 39.2 | 20.9 | 7.4 | 7.1 | 6.9 | 0.1 |
| S4 (NEMA23-56) | 0.25 | 24.98 | 52.9 · 55.7 · 72.2 | 34.0 | 25.9 | 12.5 | 12.3 | 8.6 | 0.5 |
| S4 (NEMA23-56) | 0.5 | 28.32 | 60.0 · 63.1 · 81.8 | 30.0 | 30.9 | 17.6 | 17.4 | 10.2 | 1.0 |
| S4 (NEMA23-56) | 1.0 | 34.99 | 74.1 · 78.0 · 101.0 | 24.2 | 40.8 | 27.8 | 27.7 | 13.6 | 1.9 |
<!-- mp5-summary:end -->

- J2(어깨)는 모터 길이마다 다르다: 사이클로이드 효율 가정에서 S1 117.9 ~ 206.8 · S2 93.2 ~ 153.5 · S3 86.1 ~ 140.8 · S4(NEMA23) 45.9 ~ 74.1. 그 비로
  돌리면 J2 는 S1 8.7 ~ 15.2 · S2 11.7 ~ 19.3 · S3 12.7 ~ 20.9 · S4 24.2 ~ 39.2 °/s(표시한 올림 비로 셈 · 내림 표시).
- J3(팔꿈치): S2 44.6 ~ 87.1 · S4 20.9 ~ 40.8.
- J4 · J5(손목 앞 둘): S2 7.1 ~ 27.8 · S1 9.2 ~ 39.7. J4 는 J5 캔의 옆 편심이 더해져 J5 보다 조금 크다.
- J1 은 관성만 계산했다(마찰 · 케이블 끌림 없음) — S2 에서 6.7 ~ 13.4. J6 은 S1 · 1 kg 에서도 2.7 이하 — 이 계산으로는 어느 감속기든 토크가 남는다.
- 참고 기체의 공개 감속비(로컬 자료): Arctos v2 = 13.5 · **150 · 150** · 48 · 67.82 · 67.82(J5 · J6 은 차동 손목) · Faze4 = 25 · **27** · 15 · 11.85 ·
  11 · 19.19(J1 · J4 · J5 는 벨트 단 포함 · J6 은 유성). 두 기체의 모터 · 가반 · 효율은 우리 가정과 같지 않으므로 수를 맞대어 판정하지 않는다.

### 후보 구동 판정

구동(감속비 R · 효율 η)마다 「유지 토크 × 0.5 × η × R ≥ 필요 토크」 를 만족하는 가장 큰 짐(0 · 0.25 · 0.5 · 1 kg 중). 27:1 = Faze4 J2 · Codex 엑셀의 예 ·
앞단 비 2 · 3 · 5 · 6 · 8 은 **가정**(설계한 것이 아니다).

<!-- mp5-candidates:begin -->
| 구동(감속비 · 효율) | 관절 속도 °/s(모터 300 rpm) | J2 · S1(17-40) | J2 · S2(17-48) | J2 · S3(17-60) | J2 · S4(23-56) | J3 · S2(17-48) | J3 · S4(23-56) | J4 · J5 · S1(17-40) | J4 · J5 · S2(17-48) |
|---|---|---|---|---|---|---|---|---|---|
| 사이클로이드 1 단 27:1 · η 0.75 | 66.6 | ✗(0 kg 도 모자람) | ✗(0 kg 도 모자람) | ✗(0 kg 도 모자람) | ✗(0 kg 도 모자람) | ✗(0 kg 도 모자람) | 0.25 kg 까지(여유 4.4 %) | 0.5 kg 까지(여유 10.1 %) | 0.5 kg 까지(여유 54.0 %) |
| 앞단 2:1 + 사이클로이드 27:1 = 54:1 · η 0.7125 | 33.3 | ✗(0 kg 도 모자람) | ✗(0 kg 도 모자람) | ✗(0 kg 도 모자람) | 0 kg 까지(여유 11.9 %) | 0 kg 까지(여유 15.1 %) | 1 kg 까지(여유 25.7 %) | 1 kg 까지(여유 29.3 %) | 1 kg 까지(여유 84.6 %) |
| 앞단 3:1 + 사이클로이드 27:1 = 81:1 · η 0.7125 | 22.2 | ✗(0 kg 도 모자람) | ✗(0 kg 도 모자람) | ✗(0 kg 도 모자람) | 1 kg 까지(여유 3.9 %) | 0.5 kg 까지(여유 16.9 %) | 1 kg 까지(여유 88.6 %) | 1 kg 까지(여유 94.0 %) | 1 kg 까지(여유 176.9 %) |
| 앞단 5:1 + 사이클로이드 27:1 = 135:1 · η 0.7125 | 13.3 | 0 kg 까지(여유 8.8 %) | 0.5 kg 까지(여유 4.0 %) | 0.5 kg 까지(여유 13.0 %) | 1 kg 까지(여유 73.1 %) | 1 kg 까지(여유 47.2 %) | 1 kg 까지(여유 214.4 %) | 1 kg 까지(여유 223.3 %) | 1 kg 까지(여유 361.5 %) |
| 앞단 6:1 + 사이클로이드 27:1 = 162:1 · η 0.7125 | 11.1 | 0.25 kg 까지(여유 9.8 %) | 1 kg 까지(여유 0.2 %) | 1 kg 까지(여유 9.3 %) | 1 kg 까지(여유 107.8 %) | 1 kg 까지(여유 76.7 %) | 1 kg 까지(여유 277.3 %) | 1 kg 까지(여유 288.0 %) | 1 kg 까지(여유 453.9 %) |
| 앞단 8:1 + 사이클로이드 27:1 = 216:1 · η 0.7125 | 8.3 | 0.5 kg 까지(여유 26.4 %) | 1 kg 까지(여유 33.7 %) | 1 kg 까지(여유 45.7 %) | 1 kg 까지(여유 177.1 %) | 1 kg 까지(여유 135.6 %) | 1 kg 까지(여유 403.1 %) | 1 kg 까지(여유 417.3 %) | 1 kg 까지(여유 638.5 %) |
<!-- mp5-candidates:end -->

이 표는 **목록에 둔 여섯 구동만** 판정한다 — 「후보 중 통과하는 것」 이지 「필요한 최소」 가 아니다(필요한 최소 감속비는 위 요약 표). 여유가 몇 % 인
칸은 가정 하나만 바뀌어도 뒤집힌다(민감도 표).

- **사이클로이드 1 단 27:1 은 어느 어깨(J2) 시나리오에서도 짐 0 kg 조차 못 낸다**(NEMA23 포함). 손목 J4 · J5 는 0.5 kg 까지.
- NEMA23 어깨(S4): 후보 중에서는 54:1(앞단 2:1)이 0 kg · 81:1(앞단 3:1)이 1 kg 까지(여유 3.9 %) — 그때 관절 속도 33.3 · 22.2 °/s. 1 kg 에 필요한 최소는
  앞단 효율로 78.0.
- NEMA17-48 · 60 어깨(S2 · S3): 후보 중에서는 135:1 이 0.5 kg · 162:1 이 1 kg 까지 — 관절 속도 13.3 · 11.1 °/s. **S2 · 162:1 · 1 kg 은 여유 0.2 % 의
  경계**다(1 kg 에 필요한 최소는 앞단 효율로 S2 161.6 · S3 148.3). NEMA17-40(S1)은 216:1 에서도 0.5 kg 까지.
- 손목 J4 · J5 를 1 kg 까지: 후보 중에서는 54:1(앞단 2:1 + 27:1)이 가장 작은 통과다. 1 단으로 필요한 최소는 S2 27.8 · S1 39.7 — 그런 비의 1 단
  감속기는 이 검토의 후보 목록에 없다.

### 민감도

<!-- mp5-sensitivity:begin -->
- 기준(S2 · 짐 0.5 kg · J2 · 사이클로이드) = 123.3

| 한 번에 하나만 바꿈 | J2 필요 감속비 | 변화 % |
|---|---|---|
| J2 모터만 NEMA23-56(J3 는 48 그대로) | 57.8 | -53.2 |
| 쓸 수 있는 토크 0.5 → 0.7 | 88.1 | -28.6 |
| 안전율 2.0 → 1.5 | 92.5 | -25.0 |
| 쓸 수 있는 토크 0.5 → 0.4 | 154.2 | +25.0 |
| 관절 가속 2 → 6 rad/s² | 143.2 | +16.1 |
| 사이클로이드 효율 0.75 → 0.65 | 142.3 | +15.4 |
| 사이클로이드 효율 0.75 → 0.85 | 108.8 | -11.8 |
| 감속기 금속 0.15 → 0.25 kg | 136.5 | +10.7 |
| J4 ~ J6 모터 NEMA17-40(J2 · J3 는 48 그대로) | 111.7 | -9.4 |
| 손목 J5→J6 140 → 72 mm(J6 캔 배치를 바꿔야 가능) | 113.7 | -7.8 |
| 감속기 금속 0.15 → 0.10 kg | 116.8 | -5.3 |
| J3 모터 · 드라이버를 J2 축 위로 | 117.0 | -5.2 |
| 채움 15 → 25 % | 127.4 | +3.3 |
| 짐 중심 = 플랜지 + 0.05 → 0.10 m | 126.1 | +2.3 |
| 출력 질량 × 판의 슬라이서/모형 비 | 121.2 | -1.7 |
| 채움 15 → 10 % | 121.3 | -1.6 |
| 자기 관성 반지름 52 → 104 mm(그 항 4 배) | 123.6 | +0.2 |
<!-- mp5-sensitivity:end -->

한 번에 하나씩 바꾼 이 범위 안에서는 J2 모터(NEMA23 로 −53.2 %)가 가장 크고, 그다음이 쓸 수 있는 토크(−28.6 ~ +25.0 %) · 안전율(−25.0 %) · 관절 가속 ·
효율(−11.8 ~ +16.1 %)이다. 감속기 금속(가정 · −5.3 ~ +10.7 %)과 배치 쪽(손목 모터 −9.4 · 손목 길이 −7.8 · J3 모터 위치 −5.2 %)이 그 뒤다. 자기 관성 어림을 2 배 반지름으로
키워도 +0.2 % 다. 이 순서는 고른
바꿈 폭에 따라 달라지므로 「지배 변수」 를 확정하지 않는다. 이 가운데 두 축 시험이 잴 수 있는 것은 **쓸 수 있는 토크**다(안전율은 설계 선택 · 가속은 요구 값 ·
효율은 감속기 시제품이 있어야 잰다) — 그 폭(−28.6 ~ +25.0 %)이 배치 바꿈보다 크다는 것이 두 축 시험을 먼저 할 이유다.

### J2 출력 베어링 하중

팔 무게가 모두 출력 베어링으로 간다고 볼 때(감속기는 구동 토크만 받음)의 정적 근사. 기울임 = 팔 무게중심이 베어링 중심에서 J2 축 방향으로 비킨 거리 × 무게
(정적) 와 J1 이 2 rad/s² 로 가속할 때 팔의 접선 관성력이 만드는 것(α Σ m x²)의 합 크기.

<!-- mp5-bearing:begin -->
| 시나리오 | 짐 kg | 반경 힘 N | 팔 무게중심의 J2 축 방향 자리 mm(베어링 중심 = 9.3) | 기울임: 정적 · J1 가속 · 합 N·m(안전율 전) | 참고: J2 구동 중력 토크 N·m(감속기가 받음) |
|---|---|---|---|---|---|
| S1 | 0.0 | 26.2 | 1.3 | 0.21 · 0.62 · 0.66 | 8.21 |
| S1 | 0.25 | 28.7 | 1.1 | 0.23 · 0.80 · 0.84 | 9.69 |
| S1 | 0.5 | 31.1 | 1.1 | 0.26 · 0.99 · 1.02 | 11.18 |
| S1 | 1.0 | 36.0 | 0.9 | 0.30 · 1.35 · 1.39 | 14.14 |
| S2 | 0.0 | 30.6 | 1.1 | 0.25 · 0.72 · 0.76 | 9.58 |
| S2 | 0.25 | 33.0 | 1.0 | 0.27 · 0.90 · 0.94 | 11.06 |
| S2 | 0.5 | 35.5 | 0.9 | 0.30 · 1.09 · 1.13 | 12.54 |
| S2 | 1.0 | 40.4 | 0.8 | 0.34 · 1.45 · 1.49 | 15.51 |
| S3 | 0.0 | 31.6 | 3.5 | 0.18 · 0.73 · 0.75 | 9.75 |
| S3 | 0.25 | 34.1 | 3.3 | 0.21 · 0.91 · 0.93 | 11.24 |
| S3 | 0.5 | 36.5 | 3.0 | 0.23 · 1.09 · 1.12 | 12.72 |
| S3 | 1.0 | 41.4 | 2.7 | 0.27 · 1.46 · 1.48 | 15.69 |
| S4 | 0.0 | 33.6 | 5.7 | 0.12 · 0.74 · 0.75 | 10.08 |
| S4 | 0.25 | 36.0 | 5.3 | 0.14 · 0.92 · 0.93 | 11.56 |
| S4 | 0.5 | 38.5 | 4.9 | 0.17 · 1.10 · 1.12 | 13.05 |
| S4 | 1.0 | 43.4 | 4.4 | 0.21 · 1.47 · 1.49 | 16.01 |
<!-- mp5-bearing:end -->

### 모터 · 캔 맞춤 (지금 v2)

<!-- mp5-canfit:begin -->
- J2 분할 기준(관절 중심에서): 모터 면 18 mm · 모터 → 드라이버 간격 2 mm · 덮개 안쪽 면 81.5 mm(덮개 기둥 끝) · 캔 안 반지름 37 mm — 바깥 캔 끝은 85 mm(모터 40 mm 기준). 커넥터 · 57D 보드 크기 · 다른 관절의 실제 장착면은 보지 않았다.

| 모터 | 드라이버 뒤끝 mm | 덮개 안쪽 면을 넘는 길이 mm | 프레임 대각선 반(모서리 안 깎은 상한) mm | 캔 안 반지름을 넘는 mm |
|---|---|---|---|---|
| NEMA17-40 | 78 | 0.0 | 29.9 | 0.0 |
| NEMA17-48 | 86 | 4.5 | 29.9 | 0.0 |
| NEMA17-60 | 98 | 16.5 | 29.9 | 0.0 |
| NEMA23-56 | 94 | 12.5 | 40.3 | 3.3 |
<!-- mp5-canfit:end -->

### J2 감속기 공간

<!-- mp5-space:begin -->
- 지금 J2 분할의 감속기 공간 = 깊이 12.3 mm · 반지름 39.5 mm (드럼 깊이 36 mm 안에 뒷벽 · 턱 4.0 · 베어링 10.0 · 누름판이 함께 든다)

| 후보(쌓임 두께는 모두 가정) | 가정 쌓임 mm | 그 가정대로면 더 필요한 깊이 mm |
|---|---|---|
| 사이클로이드 1 단(원판 2 장) | 20 | 7.7 |
| 앞단(벨트 · 평기어) + 사이클로이드 · 같은 축에 쌓음 | 30 | 17.7 |
| 복합 유성(링 둘) | 26 | 13.7 |
| 상용 NEMA17 유성 기어헤드 | 40 | 27.7 |
<!-- mp5-space:end -->

## 모델링 검토 — 지금 v2 · J2 분할에서 바꿔야 할 것

- **M1 J2 드럼 안의 감속기 공간은 12.3 mm 다.** v2 의 드럼 깊이 36 mm 는 v1 의 「감속기 깊이」 값을 그대로 쓴 것이고, 실부품으로 나누니 뒷벽 · 턱 · 베어링 ·
  누름판을 빼고 12.3 mm 가 남았다. 비교용으로 둔 쌓임 두께(**가정**)대로면 네 후보 모두 7.7 ~ 27.7 mm 가 더 필요하다. 이것은 「드럼을 몇 mm 늘려야 한다」 는
  결론이 아니다 — 감속기를 고른 뒤 그 부품 두께로 다시 재야 하고, 출력 베어링을 감속기 출력부와 겹쳐 놓는 배치(검토 안 함)로 줄 수도 있다.
- **M2 NEMA17 어깨는 큰 감속비와 느린 관절을 뜻한다.** 1 kg 에 필요한 최소 감속비(앞단 효율)는 S2 161.6 · S3 148.3 이고, 후보 목록에서는 162:1(11.1 °/s · S2 는
  여유 0.2 %)이 그것을 넘는다. S1 은 후보 216:1 로도 0.5 kg 까지다. 이 수는 쓸 수 있는
  토크 50 % · 안전율 2 · 효율 가정에 달려 있다(민감도 표에서 그 셋 하나씩만으로 −28.6 ~ +25.0 %).
- **M3 모터 길이가 캔을 정한다.** J2 분할에서 모터 면(18 mm) 뒤로 모터 · 2 mm · 드라이버를 놓으면, 덮개 안쪽 면(81.5 mm)을 40 mm 모터는 넘지 않고
  48 mm 모터는 4.5 mm, 60 mm 는 16.5 mm 넘는다. NEMA23 은 12.5 mm 넘고,
  프레임 대각선 반(모서리를 안 깎은 상한)이 캔 안 반지름을 3.3 mm 넘는다 — 실물 모서리 치수로 확인해야 하지만, 들어가더라도 어깨 모듈 반지름 · 길이가 바뀐다.
  주문한 MKS 모터의 실제 길이를 재는 것이 v3 의 첫 입력이다. 모터 길이 40 → 48 은 J2 너머 팔을 2.67 → 3.11 kg 로 만든다(캔 연장분 제외).
- **M4 케이블 통로(B2)와 감속기 방식이 얽힌다.** 지금은 모터가 관절 축과 같은 줄에 있어(동축) 관절 한가운데로 케이블을 지나게 할 수 없다. Faze4 는 벨트로
  모터를 비켜 놓는다. 앞단(벨트 · 평기어)을 쓰면 모터를 비켜 놓을 수 있어 「베이스 → 손목 이어진 통로」(사용자 결정)와 함께 풀 수 있다 — 통로 성립은 검토 안 함.
- **M5 손목이 길다(J5 → J6 140 mm — MKS 뒤쪽 쌓임 때문에 v1 에서 72 → 140).** 72 mm 로 줄일 수 있다면 J2 필요 감속비가 7.8 % 준다(S2 · 짐 0.5 kg 기준) — 그러려면 J6 캔을
  J5 와 겹치지 않게 다시 배치해야 한다(검토 안 함).
- **M6 J2 출력 베어링의 기울임은 이 근사에서 구동 중력 토크의 약 1/10 이다.** 반경 힘 26.2 ~ 43.4 N · 기울임 0.66 ~ 1.49 N·m(안전율 전) — 같은 경우
  J2 구동 중력 토크 8.21 ~ 16.01 N·m 는 감속기가 받는 양이고 베어링 기울임이 아니다(R1 의 M6 는 이 둘을 같게 보았다 — 틀림). 이 기울임이 6812 에 큰지
  작은지는 정격과 대조해야 판정할 수 있다(대조 안 함). 충격 · 처짐(강성) · 감속기 출력부가 나눠 받는 몫도 없다. 베어링 배치는 감속기를 고른 뒤 그 정격으로
  다시 본다.
- **M7 레이아웃을 바꾸면 Codex 의 관절 계약(계획 020)이 다시 스냅샷해야 한다.** v2 를 고치지 말고 v3 로.
- **M8 J3 모터 · 드라이버를 J2 축 위로 옮기면 J2 필요 감속비가 5.2 % 준다(S2 · 짐 0.5 kg 기준)** — 벨트 · 링크로 J3 를 돌리는 배치(M4 와 같은 결정).

## 감속기 후보 비교 (작성자의 정리 — 판정 수는 위 블록)

| 후보 | 이 계산에서 | 장점 | 위험 · 비용 |
|---|---|---|---|
| 인쇄 사이클로이드 1 단(27:1 예) | 손목 J4 · J5 0.5 kg 까지 · J3 은 NEMA23 일 때 0.25 kg 까지 · 어깨는 어느 모터로도 0 kg 도 못 냄 | 인쇄 쉬움 · 유격 작음(Faze4 설명) · Codex 엑셀의 기준 | 핀 · 베어링 금속 부품 · 편심 부품 정밀도 |
| 앞단(벨트 · 평기어) + 사이클로이드 | 후보 중: NEMA23 어깨 81:1(앞단 3:1)이면 1 kg(여유 3.9 %) · NEMA17-48/60 어깨 162:1(앞단 6:1)이면 1 kg(S2 여유 0.2 % — 경계) · 손목 54:1(앞단 2:1)이면 1 kg | 모터를 비켜 놓아 가운데로 케이블(M4) · J3 모터 옮김(M8) | 벨트 장력 · 모듈이 커짐 · 효율 가정 0.7125 미확인 |
| 인쇄 복합 유성(링 둘) | 효율 가정 0.55 라 같은 짐에 더 큰 비 — S2 어깨 1 kg 이면 209.3 | 동축 · 큰 비를 한 단에 | 미끄럼 손실 · 마모 · 유격 |
| 상용 NEMA17 유성 기어헤드 | 감속비는 고를 수 있음(이 계산은 효율 0.73 만 넣음) | 사서 바로 시험 | 길이 +40 mm 급(가정) · 유격 · 출력축 허용 반경력 · 모멘트는 제품마다 다름(정격 대조 안 함) |
| 인쇄 파동 기어(strain wave) | 계산 안 함 | 유격 작음 | PLA 유연 부품의 피로 — 시험 전 권하지 않음 |
| J2 · J3 를 NEMA23 + MKS 57D 로 | 어깨 필요 감속비가 S2 의 약 절반(45.9 ~ 74.1) · 후보 중 54:1 · 81:1 이면 관절 속도 33.3 · 22.2 °/s(필요 비 그대로라면 24.2 ~ 39.2) | 속도 · 여유 | 지금 캔에 안 들어갈 수 있음(M3) · 57D 보드 크기 미확인 · 모터 · 보드 추가 구매 |

## 권고 (작성자의 제안 — 결정은 사용자)

1. **목표 짐(가반)을 먼저 정한다** — 0.25 / 0.5 / 1.0 kg 에 따라 위 판정 표의 칸이 바뀐다.
2. **J2 · J3 의 구동을 정한다** — (가) NEMA23 + 57D + 앞단 3:1 + 사이클로이드 27:1(81:1 · 어깨 1 kg 여유 3.9 % · 22.2 °/s) 또는 (나) NEMA17-48/60 +
   앞단 6:1 + 사이클로이드 27:1(162:1 · 어깨 1 kg · 11.1 °/s — S2 는 여유 0.2 % 의 경계 · S3 는 9.3 %). (가)는 빠르나 어깨가 커지고(M3) 사야 할 것이
   는다 · (나)는 주문한 모터 계열이지만 느리고, 주문한 모터가 40 mm 급(S1)이면 216:1 에서도 0.5 kg 까지다. 두 안 모두 1 kg 에서는 여유가 얇아 쓸 수 있는
   토크 실측(권고 4)이 판정을 바꿀 수 있다.
3. 손목 J4 · J5 는 짐 0.5 kg 까지면 사이클로이드 1 단 27:1(S1 여유 10.1 %), 1 kg 이면 후보 중 54:1(앞단 2:1). J6 은 토크로는 정해지지 않는다(공간 · 유격으로
   고른다).
4. 두 축 시험에서 MKS 모터의 실제 길이 · 토크 · 속도 · 발열을 재서 `inputs.json` 의 가정(50 % · 300 rpm · 모터 질량)을 바꾸고 이 계산을 다시 돌린다
   (`joint_loads.py` → `check_doc_sync.py --rerun`).
5. 위가 정해지면 v3 레이아웃(캔 길이 · 어깨 크기 · 드럼 깊이 · 케이블 통로 · 손목 길이)을 그리고, J2 감속기 시제품 하나를 인쇄 시험한다(시험편 판정 뒤의
   끼움 값으로). 베어링 배치는 그 감속기의 정격으로 다시 본다.

## 재지 않은 것 · 한계

- 실제 모터 토크 · 속도 곡선 · 감속기 효율 · 마찰 · 유격(모두 가정) · 동적 궤적(가속은 일정 값 하나 · 동시 축 가속 없음) · 링크의 처짐 · 강도 · 베어링 정격.
- 관성: 요소의 자기 관성은 드럼 반지름 원판의 어림이다(상한 아님 — 긴 관의 가로축 관성은 더 클 수 있다 · 반지름 2 배에서 J2 +0.2 %). 모터 회전자 ·
  감속기 안 회전체가 감속비의 제곱으로 커져 보이는 관성(반사 관성)은 넣지 않았다 — 큰 감속비에서 가속 여유를 줄일 수 있다(회전자 관성 자료 없음).
- 모터 · 드라이버 자리는 J2 분할의 장착면 · 참조 상자를 모든 관절에 쓴 것이다(다른 관절은 분할 전).
- 출력 질량 모형은 시험편 판 하나로만 견줘 봤다(모형이 1.108 배) — 큰 부품에서 다를 수 있다. 링크는 A2 의 속이 찬 외곽이라 속 빈 실부품보다 무겁게,
  리브 · 체결부 · 베어링 좌면이 빠져 가볍게 잡는 성분이 함께 있다 — 어느 쪽이 큰지 재지 않았다.
- 다른 관절의 모듈 질량은 J2 분할을 외곽 비로 키운 추정이다. 모터가 길어질 때의 캔 연장 질량은 넣지 않았다. 각 관절 묶음(모듈 출력 부품 전체)은 그 관절의
  고정 쪽으로 셌다 — 출력 플랜지처럼 관절과 함께 도는 부분의 자기 관성은 빠졌다(축 위).
- 감속기 축 방향 쌓임의 부품 두께는 가정이다(표준 베어링 폭만 확정 값). J4 의 최악 자세 · J5 의 90° 도달은 가정이다. J1 은 관성만이다.
- 웹 출처(모터 판매처 표기)는 이 검토에서 다시 열어 보지 않았다.

## 검토

새 단위 MP5(검토 · 보고서). L2 는 두지 않는다(코드 · 모델을 바꾸지 않는 검토 단위 — 계산 스크립트는 보고서의 근거). L4 최대 2 회 — 비작성자(Codex) 가 입력 ·
계산 · 이 문서의 수와 논리를 본다. R1 = BLOCK(주요 5 · 작은 7 — 위 표대로 고침) → 작성자 쪽 사전 점검 10 건 고침 → **R2(마지막) = NEEDS_ATTENTION ·
막음 0 · 주요 0 · 작은 5**(R1 주요 5 건 해소 판정 · 원문 `.dev/mp5-review-evidence/mp5-l4-r2-codex.md`). R2 의 작은 5 건은 L4 회차가 끝난 뒤 작성자가
고쳤다 — 자기 관성 「상한」 표현 철회(D1) · 모터 · 드라이버 자리를 J2 분할의 장착면 · 덮개 안쪽 면 기준으로(D2) · 동기 검사가 같은 이름 블록 중복 · 닫히지 않은
블록을 잡게(D3) · M2 의 후보비 / 필요 최소 구분(D4) · 상용 기어헤드의 근거 없는 하중 평가 삭제(D5). 처리 기록 = `mp5-l4-r2-disposition.md`. **그 고침은
비작성자가 다시 보지 않았다**(L4 2/2 소진). 이 보고서는 가정 아래의 비교 근거이며 실물 모터 · 감속기 · 가반의 선정 승인이 아니다.

## 출처

- Faze4 설계 결정(감속비 · 벨트 · 유성): `docs/references/packages/01/mechanical_refs/Faze4/upstream/docs/B_Design_decisions.rst`
- Arctos v2 감속비 · 차동 손목 · 57D 예시: `docs/references/packages/03/MKS_CAN/Arctos_MKS_CAN_reference/docs/configuration.md`
- Sweep 26:1 · Armold 와의 관계(확인할 질문으로 남음): `docs/references/packages/04/other_public_refs/PURCHASE_REQUIRED_KO.txt`
- MKS SERVO42D/57D 전류: `.dev/mks-can-v109-text.txt`(MKS CAN 매뉴얼 V1.0.9)
- 모터(판매처 표기 — 제조사 데이터시트 아님 · 이 검토에서 다시 열어 보지 않음): 17HS4401 https://openelab.io/products/hanpose-nema17-42mm-12v-stepper ·
  17HS19-2004S1 https://manuals.plus/asin/B00PNEQKC0 ·
  https://funduinoshop.com/en/electronic-modules/electric-motors-and-accessories/elektromotoren/stepper-motors/nema17-stepper-motor-with-lead-17hs19-2004s1 ·
  17HS24-2104S https://www.ebay.de/p/26025345458 · 23HS22-2804S https://www.newegg.com/p/0ZK-0G4B-001W8
- Codex 의 감속기 엑셀: `outputs/reducer-control-20261023/`(사이클로이드 원리 · 구매 후보 · 계산 예시). 이 검토는 엑셀이 비워 둔 선정 입력 중 **부하 · 필요
  감속비 쪽만** 가정 아래 계산했다 — 속도 · 열 · 강성 · 유격은 아니다.
