WINNAKEN/robot-arm-lab/docs/design/023-v2-static-joint-alignment.md

> 개발 이력: 작성 당시의 계획·결과입니다. 현재 상태는 [STATUS](../STATUS.md)를 확인하세요. 원시 로그와 로컬 경로 일부는 공개본에서 제외했습니다.

# 023 — v2 정적 관절 대조 (등록용 안내)

동시 모델링 작업이 커밋84947de에서022를 감속기 보고서에 사용했다.
이 작업의 동결 계획은 [022-v2-static-joint-alignment.md](022-v2-static-joint-alignment.md)다.
초기 검토명022-CA와 인계 등록명023-CA는 **동일 작업·동일 원장·동일 검토 예산**이다.
동결 계획/소스/반례를 바꾸거나 새 예산을 시작하지 않는다. 검토 근거는 `.dev/cad-alignment-evidence/`다.
