WINNAKEN/robot-arm-lab/docs/design/034-last-stop-outcome.md

> 개발 이력: 작성 당시의 계획·결과입니다. 현재 상태는 [STATUS](../STATUS.md)를 확인하세요. 원시 로그와 로컬 경로 일부는 공개본에서 제외했습니다.

# 034 — 마지막 종료 관측의 독립 소유 / SO-20261026

## User disposition / finite bounds

2026-10-26 user said 계속진행해 after the explicit proposal to retain last Stop outcome separately from live connection. This authorizes a fresh ownership design after033 PRODUCT EXHAUSTED, not serial R2 of033. Carry original PA/Stop identity and terminal-evidence/recovery witness unions/thresholds; next additional independently supported + author-accepted same terminal/recovery instance1 remains sufficient for PRODUCT EXHAUSTED. PA next accepted actual live-key instance1, startup/SB and firstfault ledgers remain. No number/budget reset of history. L2 maximum2 / L4 maximum2 declared before first review; author cannot be final reviewer. External-family NOT_RUN under prior central block, no bypass. Ring unresolved/deferred, calibration/normal/hardware/measured approvalsfalse, fixed100pulse restriction unchanged. No hardware/flash/CAN/torque/purchase/printing/CAD/push.

## Actual defect and ownership change

033 separates StopBinding from observer/normal lease but final Terminal still lives only in snapshot. Independent actualOwner phase4/verifiedtrue input is consumed, binding retires, next ordinary status failure or offline calls disconnect() and deletes snapshot; final display disappears. Preserve the original probe/receipts/source at Git20cea77 and evidence. Introduce independently owned immutable lastTerminalOutcome, containing facts only, never any credential/lease/ticket/nonce or command capability. It is independent of live snapshot, StopBinding, result observer, numeric intent and connection auth.

This is a bounded in-memory last observation, NOT an event log or durable browser storage. Page/process restart may lose it; do not add localStorage/IndexedDB. No acknowledgment/delete button, TTL, hidden cleanup or automatic alarm reset. Every successful qualifying newer terminal observation replaces the ONE record; old records are not an unacknowledged alarm ledger. A new boot/nonterminal state, pair, failed pair, disconnect, hidden/clear/stale, Stop ACK/error or receipt must NOT erase it. Only a valid authenticated ordered Terminal sample replaces it. The UI ALWAYS identifies it as past observation, with source boot and boot-local server milliseconds, never as current safe/online/torque-off/physical stop approval.

## Producer and replacement contract

Only the actual authenticated /api/status consumption path in poll writes a private evidence field. Public update(s) cannot publish history. Preserve existing captured session/auth/issued-serial guards; stale callback from old session or older completed poll cannot overwrite. Existing update validates uint64 snapshot fields. After update succeeds, construct/validate a fact record, then publish it BEFORE observeStopTerminal retires the key. If Terminal fact validation fails, disconnect under existing fail-closed error path, preserve prior history AND retain StopBinding (do not retire on malformed final data).

Qualifying sample phase must be exactly4 (Owner Terminal), not Stopping3, ACK, ready or positive lease. Data whitelist: boot/generation/at/stop_at/fault_at uint64 strings; selected_axis reported uint16 including0/unknown; core_state/core_fault/adapter_fault nonnegative uint32 integers; stop_verified and manual_power_cut_required exact booleans. Optional core_stop_verified/queue_stop_late must be booleans if present, otherwise stored null and displayed as unreported, never false/safe. Do not impose inferred sign/at/fault temporal relations, fixed generation offsets, core-state enums or cross-flag consistency that could reject a real Fault/clock terminal. Both verified and manual-cut facts are shown as reported; neither is inferred from the other.

Copy primitives only, freeze record and expose a read-only getter. No spread-copy of live snapshot or positions, no retained secret. Read/format/render history cannot write any control state, acquire/renew/Stop automatically, modify freshness or reconnect auth. All movement guards continue to consume only live snapshot/authority. Same boot replacement must not go backwards in source at or generation compared with retained outcome, even across disconnect where snapshot=null. Reject such terminal data before key retirement and retain previous outcome. Equal source time/generation may be replaced by a later accepted poll (latest authenticated facts); no numerical ordering between DIFFERENT opaque boot IDs. New authenticated Terminal of a different boot replaces latest record; nonterminal newboot keeps old outcome visibly labeled with its origin. Existing poll session/serial fences protect previous-connection callbacks. No absolute server/client clock subtraction or local TTL.

## Consumer / display contract

Add a distinct last-terminal evidence panel. Render it unconditionally BEFORE the existing no-live-snapshot early return. It remains visible when live status says disconnected. Always label 과거 관측 · 현재 안전 상태를 뜻하지 않음 and source boot/axis/at; explicitly show stop_verified, manual_power_cut_required, fault and optional unreported facts. For manualcut=true display a historical report that power cut was required; do not silently hide it because live connection failed or a different boot is currently nonterminal. A later valid Terminal can replace the latest record according to policy; this is not human acknowledgment of an older alarm. No controls read this evidence. No live status substitution or fake fresh indication.

## Scope and predecessors

Production ownership: only robot_phone/web/app.js and index.html. New src/firmware/tests/stop_outcome/, .dev/stop-outcome-evidence/, this plan and closeout indexes HANDOFF/SESSION/BACKLOG/LESSONS/ARCHITECTURE. No Owner/Gate/Run/HTTP/protocol/CAD/old test modifications. Preserve prior immutable plans/evidence, Git20cea77 and the copied predecessor app. Existing033 JS44 mock Terminal lacks two optional flags; treat those as unknown as above, NOT by patching old tests or defaulting to false. Concurrent modeling/print commits/dirty edits must not be reverted or staged as ours.

This unit seeks actual production-JS and DOM HISTORY-RETENTION acceptance only. Full Boot/CAN/browser motion composition/033 hide-Stop acceptance/030PB/032 Ticket-delay/effective missingStop/FD/wholephase-deadline remain OPEN. A deterministic DOM history fixture can avoid the failing Boot setup without claiming to close it: use exact actual production HTML/JS, real Chromium timers/fetch and a loopback HTTP server serving a preserved actualOwner Terminal payload. The source of the status is RECORDED NATIVE OUTPUT, not a live Owner instance in that browser run. Diagnostic manualcut=true variants are explicit synthetic protocol samples. This is a dedicated consumer proof, not a new actual-CAN/phone or Boot schedule result.

## Required tests and effective controls

1. Reuse independently produced actualOwner pending.json final payload; actual PhoneControl consumes authenticated poll Terminal then network failure and explicit production offline action. Outcome persists, live auth/snapshot clears, no permission/commands arise. Positive before/after input matches immutable whitelisted facts. Also manualcut=true/verifiedfalse synthetic diagnostic payload persists and renders distinctly.
2. Lifecycle matrix: hide/clear/stale/pulse, disconnect, failed/successful new pairing, different-boot nonterminal, later valid same/different boot Terminal, Stopping, malformed/missing/string boolean/optional flag/type/uint overflow, direct update, source object mutation, equal time, older time/gen across disconnect, old-session delayed response, out-of-order response. Record survives nonqualifying events; qualifying replacements follow exact policy; no control flags come from history. Check no secrets in record/DOM/storage. No record from direct update or ACK.
3. Actual DOM: load exact assets from loopback HTTP; explicit Pair -> recorded native Terminal; verify historical panel. context offline/status503 triggers actual production disconnect/render and history stays. Explicit re-pair with synthetic manualcut sample, network failure, different-boot nonterminal (old history stays past), newer terminal replacement. No private state/credential/lease injection into browser; no altered product sources or timer intervals. Record all traffic; no control command/renew/automatic pair. Screenshot and actual visible text checked. Target SDK/WiFi/physical/actual new Owner->DOM composition NOT_RUN.
4. Negative controls with syntax-valid mutations and targeted assertion failures, original positive before/after: predecessor actualJS fails post-failure outcome retention; erase-on-disconnect fails it; bypass poll evidence publication fails it; history rendered only from live snapshot fails DOM disconnected-record check. Test malformed final cannot retire existing binding. Optional additional source/time/order controls must test their own consumer, no regex-only proof.
5. Regressions: existing actual JS transfer19, legacy136, stop-capability44; angle5057/UI50/actualbridge156; existing033 actual authenticated Owner132/10 using newly compiled unchanged server/native2552; UI/HTTP/runtime SDKstubs appropriate to changed asset bundle. Label fixture and mock boundaries; no claims old flaky original028 runner passed. Full PB remains open regardless this narrow acceptance.

Freeze/hash before independent L4. Reviewer reproduces actual defect/consumer controls, classification/landing/union and sufficient thresholds; no source edits during review. Any new accepted terminal/recovery instance triggers the inherited class-stop, not an extra R2. Report exact PASS/FAIL/NOT_RUN scopes, carry all unresolved hardware and prior verification gaps. No new unrelated feature or persisted history.
