WINNAKEN/robot-arm-lab/docs/design/035-browser-boot-handoff-stop.md

> 개발 이력: 작성 당시의 계획·결과입니다. 현재 상태는 [STATUS](../STATUS.md)를 확인하세요. 원시 로그와 로컬 경로 일부는 공개본에서 제외했습니다.

# 035 — 부팅·인계·정지의 브라우저/실제 코어 연결 검증

2026-10-26 user explicitly requests offline live browser Boot->handoff->Stop verification, calibration unapproved/ring deferred. This is verification-only: all production app.js/HTML/Owner/Boot/Run/Gate/HTTP/CAN sources remain unchanged at ea09cc2. Keep all033/034/PA/terminal-recovery/startup/firstfault histories and next-instance thresholds; no renumbering reset. L2maximum2 / L4maximum2 declared before review. Independent nonauthor source/consumer review, class/landing/union/EXHAUSTED disposition required. External-family NOT_RUN under prior central block/no bypass; same-family residual. No target/device/flash/purchase/CAD/print/push.

## Reframed acceptance / original observation

Prior033 browser-001 timed out before disable-all. Actual trace: maintenance1432, renew1652/1897, unloaded1954, renew2157/2402/2646/2905; final3151 phase0/core3/fault0, lease_until3705. No Disable request or driver fault was observed. Its test-only conjunction of port operator slot + renewal age<100 + enabled button was not observed in1000ms. This is not proof that the firmware rejected Disable, nor proof that wall jitter is the sole cause. Preserve original artifacts. Do not repeatedly phase-hunt with new sleeps/deadline widening or call a favorable host phase general phone usability.

New scope: actual unchanged browser DOM/fetch -> loopback HTTP fixture -> actual native Owner/Boot/Run/Gate/codec/FakeCAN in one live run, with a declared common CONTROLLED virtual time. Native state is generated from fresh begin/config reads, NOT a prerecorded packet or bootstrapped Ready/lease. No fabricated evidence, private API/state injection, forced port drains, favorable() before commands, auto fixture Renew, direct internal Acquire, or relaxed freshness/permission/deadline. The browser's unmodified50ms/250ms intervals and timeouts run under Playwright clock. This proves selected logical schedules/consumer composition, NOT real-time WiFi/phone/ESP32 scheduling or all phase/latency acceptance. Full030/032 PB/movement/missingFD/phase sweep remain open; all cases calibratedfalse and FD0, no numerical move.

## Controlled clock and scheduling contract

Preflight installed Playwright API on a synthetic page only, then product test after L2. Install/pause clock on blank page before production navigation. Browser Date starts epoch+0, native port clock starts0. No product timers are skipped at initialization. Product script/HTML served byte-identically, no source instrumentation. Install clock exactly once; never fastForward/resume/setSystemTime during scenario. Advance monotone logical time in1ms while waiting operator conditions, or to the NEXT actual product timer/deferred transport boundary otherwise (never past a50ms timer). Assert Date.now==epoch+native.now and no native submit/API operation advances port time. Every intermediate native ms runs actual owner.tick; no native sleeping. Product callbacks and HTTP event-loop promises are drained at each current time before advancing. Host wall I/O timeout aborts, never changes logical safety time.

A new fixture instantiates BootFake + test-approved boot profile + actualOwner + calibrationfalse and begins WITHOUT pairing, maintenance, observations, pre-renewal or bootstrap helper. Actual Pairing envelope through Owner returns the actual seeded credential; Node status session set contains ONLY credentials returned by successful actualOwner pairing. Normal and Stop endpoint listeners are preserved independently from wire.op, so actual Owner still authenticates/denies route mismatch. Actor uses enqueue/tick/take_result public APIs, not private authority access. An operation that has no result yet remains pending and is polled after clock advances; never loops time internally. JSON serialization copies actual result/status fields with uint64 strings.

At each logical boundary: advance native to t (one actual tick per ms), advance browser clock to same t with all due application timers fired, drain newly arrived HTTP requests/responses at t, including same-time Owner tick for newly queued envelopes. All positive dispatch/response latency is explicitly0 logical ms; there is NO claim to tolerate an arbitrary<50ms network delay. A separate queue-age50 case stores enqueue time at HTTP arrival and dispatches later, so native admission sees actual age. Reply delay holds only transport response; native keeps polling. If browser/native drift, unexpectedly hidden clock advance, pending reply timeout or invalid protocol occurs, fail scenario. Disclose timer/rAF initialization and fixed zero phase; do not call this an exhaustive virtual-time proof.

Operator policy: use real DOM enabled/visible/hit-test and read-only FakeCAN diagnostics/rolling position timestamps to wait for first eligible stopped slot (same min140/TTL400 as observable metadata; no proof injection). Tap by actual browser touchscreen at current logical time, including scroll/hit-testing; no controller-method calls in page.evaluate. Waiting for a precondition is allowed; after a request is sent, a rejection FAILS that scenario, no retry/reacquire. Remove the old TEST-ONLY age<100 renewal heuristic, not a production guard: ordinary busy/enabled plus independently enforced core admission remains. A separate explicit unloaded confirmation200ms after Disable (before old claim expires) is an operator action, not automatic authority extension. It may be accepted or rejected by actual core; no deadline edits. Fixed scenario seeds/first eligible selection, no serial schedule tuning after failure without recorded structural diagnosis/review disposition.

## Scenarios / required assertions

1. Selected axis1 and axis2 normal: actualDOM Pair/observed NeedsMaintenance -> Maintenance/explicitUnloaded/DisableAll/readbacks/secondUnloaded/ReadyDisabled -> Finish/Drive/EnableSelected/readback/Granted -> combined handoff actualChecking/actual one-shot Gate Acquire -> authenticated result adoption/actual normalRenew -> explicit independent Stop -> actual Terminal/stop_verified, historical DOM panel persists after offline. Selected-axis F3 enable and all-axis disable facts from actual sent frames, FD0. Calibrationfalse/angle disabled. No side-channel authorization.
2. Pending handoff ACK/status held1200 logicalms: actualDOM hide/visible handlers via explicit synthetic visibilitychange/hidden getter fixture (NOT OS background), explicit Stop before first new namespace status, actual nonce/principal retained, core stop at explicit time, attempts0 after original grant/lease windows. Late ACK cannot adopt/renew/acquire. Final actual Terminal/readback and history arrive through live HTTP. Distinguish ordinary reply held from native actor queue priority; inherited native priority tests cover the latter separately.
3. Offline after accepted Pending: production offline disconnect removes normal control; native may consume the already explicit grant once, never new retries. No move/Renew/autoAcquire after disconnect; original lease expiry causes actual Stop. Online restoration only readonly binding recovery -> Terminal/history, no automatic pairing or movement. Do not assert offline alone sends remote Stop.
4. Grant receipt response held1200: observer timeout/late receipt cannot restore authority or renew. Actual fixed server deadline, subsequent Stop/Terminal and readonly history verified. Query consumes no authority by itself.
5. EnableSelected queue dispatch age50: actual Owner Stale rejection, single sent request/no automatic retry/enable side effect; explicit Stop through current Boot namespace and final state. No handoff credit for this negative prefix.
6. Bad pairing negative: actual Owner Auth denial, no admitted session/control/enable/move, not a full positive flow.

Each run starts a fresh actualOwner and browser context. Capture exact assets, browser/version, timer/poll times, request wire + actual pair/result/status, native sent frames/transfer_attempts, phase transitions, core fault/time/stop_at and final history text/screenshots. Never infer no internal Acquire from no Acquire wire message. Test calibratedfalse always. Synthetic visibility and loopback Stop-URL route/CORS wrapper are fixtures; production HTTP server/real network remain SDKstub/NOT_RUN.

## Effective controls and regression

Positive before/after controls required. Three syntax-valid controls reach their own intended assertions: wrong served asset -> byte identity; missing handoff forwarding with fake Pending reply -> actualChecking/core reservation assertion; missing Stop forwarding with fake success -> immediate explicit core stop_at assertion BEFORE unrelated lease expiry. All originals repeat with same controlled schedule, no host phase search. No missingFD claim because no motion intended; prior missingFD remains open. Keep syntax/import failures distinct from behavioral kills.

New native bridge tests check real pairing/auth, listener mismatch, exact clock monotonicity/no hidden submit time advancement, no fixture bootstrap/renew, status/result strings. Use unchanged production headers/source. Reuse native2552 and existing034 historyJS57/StopBinding44/old19/136 tests if dependency paths unaffected. Actual HTTP/runtime SDKstub regression not mandatory when no production asset changes; historical passing results not relabeled new executions. Document every NOT_RUN.

Owned new paths only src/firmware/tests/browser_chain/, .dev/browser-chain-evidence/, this plan and closeout indexes. No changes to prior harness/evidence/product; reference hashes frozen. Layer2 PASS precedes product harness implementation; API-only tool preflight is not implementation acceptance. Freeze then independent L4 reproduces source and actual native/browser consumers, attacks clock/late reply/admission/Stop forwarding, reports9binary/5categories and finding landing/class thresholds. Any accepted same PA/terminal/startup/firstfault instance invokes existing threshold despite spare rounds. Report conditional controlled-clock acceptance separately from real-time wall usability and full PB/hardware acceptance.
