WINNAKEN/robot-arm-lab/docs/design/046-design-reinforcement-gripper.md

> 개발 이력: 작성 당시의 계획·결과입니다. 현재 상태는 [STATUS](../STATUS.md)를 확인하세요. 원시 로그와 로컬 경로 일부는 공개본에서 제외했습니다.

# MP8 — 설계 보강 1 단계: 모터 실측 원장 · 첫 그리퍼 KG1 (Claude 모델링 · 2026-10-27)

> 계획 번호 046 은 MP8 이 쓴다(040 ~ 044 = Codex · 045 = MP7). 결정 원문 = `.dev/mp8-evidence/user-decisions-mp8.json`.
> (처음 쓸 때(10/27)는 「042 ~ 044 = 비워 둔 자리」 로 적었는데, 그 뒤 Codex 가 042 · 043 · 044 를 썼다 — 10/28 확인 · 검토 R-11.)

## 요청 (원문)

- 「아 아직 출력안할거야」(외장 v3 3MF 출력 준비 질문에 대한 답 — 출력 준비는 멈춤)
- 「이제 좀더 해당 장비 설계부분 더 보강하자」
- 「추가로 그립퍼 어떻게했으면좋겟는지 참고로 난 첫 그리퍼는 3d 프린터 출력물 집는데 쓸거야」

## 사용자 결정 (질문 창 원문 · 선택지 원문)

| 번호 | 고른 선택지(원문) | 선택지 설명(원문 요지) |
|---|---|---|
| G1 구동기 | 「STS3215 12V 버스 서보 (권장)」 | 55 g · 정격 10 kg·cm · 위치 · 부하 · 전류 되읽기 · 어댑터 (A) + 24→12 V 강압기 · 보드의 빈 IO1 · IO2 · CAN 과 따로 도는 두 번째 구동 경로라 정지 · 제어권 규칙을 Codex 가 새로 짬 |
| G2 가반 | 「그리퍼 포함 0.5 kg (권장)」 | 지금 손목 판정이 그대로 · 물체는 약 0.3 kg 까지(쓸 수 있는 토크가 20 % 낮으면 약 0.2 kg) |
| G3 출력물 | 「중간 (폭 80 mm · 200 g 이하)」 | 행정 약 90 mm · 몸체 폭이 손목 드럼 Ø78 보다 커지고 무게도 늘어남 |
| G4 집는 자리 | 「정해진 자리(트레이 · 지그)에서 (권장)」 | 사람이 판에서 떼어 트레이에 놓으면 로봇이 집어 옮김 · 카메라는 붙일 자리만 |
| G5 안내 | 「Ø6 금속 봉 + 인쇄 턱 구멍 (권장)」 | 가장 가벼움 — 그리퍼 약 155 ~ 180 g · SO-ARM 그리퍼와 같은 방식 · 미끄럼 끼움은 원장에 값이 없어 구멍 6.0 ~ 6.4 시험편을 먼저 출력해 고름 |
| G6 봉 재질 | 「탄소 관 6 × 4 (권장)」 | 가장 가볍고(하나 약 3 g) 매끈하고 단단함 · SO-ARM 이 쓰는 재질 중 하나 |

**결정 때 안내와 달라진 것(검토 R-04 — 사용자에게 알리고 관 수량을 묻는다)**: G6 질문 문구는 「봉은 둘」 이었으나 산출은 **턱마다 둘 = 넷**(B2 의 까닭) ·
G5 질문의 가로 폭 「약 165 mm」 → 140 mm(작아짐) · 그리퍼 질량은 G5 설명의 범위(약 155 ~ 180 g)를 조금 넘어 **184 g**(검토 뒤 손끝 대를 두껍게 하고 받침 턱 · 시험 지그를 더한 뒤 값).
**사용자 답(2026-10-28 · MP8 끝 보고 뒤)**: 「탄소봉 네게 써도되고 무게좀더 무거운건 괜찬아」 → 관 넷 확정 · 184 g 받아들임(작성자 해석은 `.dev/mp8-evidence/user-decisions-mp8.json` 에 따로 · 설계 · 짐 판정 숫자는 그대로).

작성자 해석(결정과 따로): G2 = MP5 계산 모형의 짐(그리퍼 + 물체 점질량)과 같은 뜻 · G3 의 80 mm = 집을 물체의 가장 큰 폭 · G4 는 트레이 · 지그 설계를
이번 범위에 넣으라는 뜻으로 읽지 않는다(붙일 자리만).

## 지금 상태 — 설계 현황 조사 요지 (2026-10-27 · 읽기 전용 조사 5 + 비평 2)

- 실제 부품으로 설계된 것은 둘뿐이다: v2 계보 J2 어깨 분할(부품 6) · MP6 사이클로이드 27:1 시제품(관절에 넣지 않은 독립 시제품). 외장 v3 를 포함한 나머지는
  속이 찬 외곽 덩어리(벽 · 체결 · 베어링 · 모터 장착 · 케이블 통로 없음).
- 모든 모델이 모터를 **실측하지 않은 가정값**으로 그린다(몸체 40 · 드라이버 18 · 파일럿 Ø22 × 2 · 축 Ø5 D · 24 · 나사 깊이 4.5). 모터 두 세트는 10/26 도착 · 미측정.
- 관절 거리를 그대로 두는 지금 배치에서 **모터 몸체 길이 상한 ≈ 44 mm**(J4 끝 덮개 ↔ J3 드럼 · 40 mm 일 때 틈 4 mm · 48 mm 면 4 mm 겹침) — 영향 표
  `.dev/mp8-evidence/motor-impact.md`(이 단위의 `motor_impact.py` · MP5 mp5-canfit 값과 같은 식 · 같은 값 재현).
  → **검토 뒤 바뀜(2026-10-28)**: 가장 먼저 걸리는 것은 **J1 드라이버 ↔ 발 윗면 43.0**(발을 파면 바닥 기준 51) · v3 J4 43.2(민트 사선 돋움 0.8) · J2 분할 기둥 끝 43.5(다시 그리면 풀림) ·
  v2 J4 44.0 — 드라이버 18 · 간격 2 가정 아래(영향 표 · 검토 MP8-MOT).
- 그 밖의 빈 곳(이번 범위 밖 · 다음 단위 후보): 감속기 통합(J2 공간 12.3 mm · 손목 감속기 43.5 vs 드럼 36) · 베어링 하중 경로 · 체결 · 케이블 통로(B2) ·
  드라이버 화면 · 버튼 접근(MKS 설명서: 보정은 무부하 · 기계에 넣기 전) · 재료 · 출력 공정 · 관절 범위 · 실제 질량 · 관성(URDF 값은 임의) · 끼움 시험편 ④ 링 0.10 ~ 0.30 모두 헐거움.

## 이번 범위

| 묶음 | 산출 | 결정 · 부품 없이 되는가 |
|---|---|---|
| A 모터 실측 원장 | `src/cad/calibration/motor-mks42d.json`(가정값 · 출처 · 쓰는 곳) · `docs/measure/mks42d-sheet.md`(무전원 실측 기록지) · `src/cad/design-check-mp8/motor_impact.py`(영향 표) · `check_motor_ledger.py`(형식 + 양성 대조 15) | 된다 — 값은 사용자가 잰 뒤 채움 |
| B 첫 그리퍼 KG1 | `src/cad/kmjh-gripper-v1/` 생성기 · `models/kmjh-gripper-v1/`(부품 STL · STEP · native · 질량 · 무게중심 · 출력 판 추정) | G1 ~ G4 로 된다 · 구매품 치수는 공개 자료(실물 오면 대조) |
| C 그리퍼 짐 판정 | `src/cad/design-check-mp8/gripper_loads.py` → `.dev/mp8-evidence/loads-gripper/`(MP5 계산기를 입력 사본으로 다시 돌림) | B 의 질량이 나오면 |
| D 구매품 · 인계 | `docs/BOM.md` 그리퍼 줄(선택함) · HANDOFF MP8 절 · Codex 에게(펌웨어 · 배선 · URDF) | — |

## 하지 않는 것 · 무접촉

관절 거리 · 축 · 표시 자세(사용자 10/27) · v1 · v2 · v3 · J2 분할 · MP6 · MP5 파일(읽기만 — MP5 계산기는 모듈로 불러 입력 사본만 바꿈) · URDF ·
펌웨어 · 배선 문서(Codex) · 끼움 원장 값 변경(MP6 지문이 값에 묶임 — 값은 MP6 맞춤 판정 때) · 출력 · 프린터 전송 · 구매 · 판에서 떼어 내기 · 카메라 ·
트레이 · 지그 설계 · J6 출력 플랜지 설계(그리퍼 쪽 체결면만 정하고 팔 쪽은 J6 감속기를 고를 때) · 새 설치.

## A. 모터 실측 원장

- 원장 꼴은 끼움 원장(`print-fits.json`)을 따른다: 항목마다 value · unit · status(assumed / published / measured) · means · source · used_by ·
  관측 원문(observations — 세트 A · B · 날짜 · 키 · 원문) · 바뀐 기록(history).
- 원장은 생성기가 자동으로 읽지 않는다 — 각 모델 파일은 자기 값을 그대로 두고, 영향 표를 보고 각 단위에서 반영한다(MP5 · MP6 지문 · 해시를 깨지 않음).
- 영향 표 `motor_impact.py`: LC(v2geom · v3geom 같은 식) · J4 ↔ J3 드럼 · J6 ↔ J5 드럼 · J1 캔 끝 ↔ 바닥 · J2 분할 덮개 넘침 · 프레임 대각선 ↔ 캔 안 반지름 ·
  MP6 모터 나사 끝 ↔ 구멍 바닥(하한 0.5) · 몸체 길이 상한(관절 거리 그대로) · 시나리오 40 / 48 / 60. 입력 sha256 을 싣는다.
- 형식 검사 `check_motor_ledger.py --controls`: 거부 14 + 통과 1(원문 있는 measured) — 각 대조는 거부 목록이 정확히 그 항목 하나.
- 기록지는 Codex 점검표(`docs/specs/bench-no-can-checklist.md`) A 절의 무전원 규칙을 따르고 그 파일은 고치지 않는다. 시험 조각 판정(파일럿 판 · D 구멍)은 끼움 원장
  observations 에만 먼저 적는다.

## B. 첫 그리퍼 KG1 — 요구

- 방식: 대칭 평행 집게 — 피니언 하나 + 랙 둘(두 턱이 같은 거리만큼 반대로) · 금속 직선 안내 · 손끝 교체(나사 둘 + 인서트) · 닫힌 끝 기계 멈춤(원점).
- 구동기: Feetech STS3215 12V(C018) 한 개 — 서보 몸체는 플랜지 쪽 · 손끝은 짧게(짐 모멘트).
- 집는 폭: 물체 최대 80 mm(G3) → 손끝 사이 최대 벌림 ≥ 90 mm · 닫힘 0 mm(얇은 부품 · ~~손끝끼리 맞닿기 직전 멈춤~~ → **두 손끝이 맞닿음 = 닫힘 · 원점**(B2 · 검토 R-15 로 하나로 맞춤)).
- 질량 목표: 그리퍼(~~어댑터 ·~~ 나사 · 서보 포함) ≤ 170 g · 무게중심과 쥐는 점은 플랜지에 가깝게 → C 에서 판정.
  (어댑터 판은 따로 두지 않게 바뀌어(아래 줄) 질량에 들지 않는다 · 버스 서보 어댑터 (A)는 제어 보드 쪽 부품 — 검토 R-05.)
- 체결면(그리퍼 쪽): 팔 쪽 J6 출력이 정해지지 않았으므로 ~~그리퍼 바닥 = 어댑터 판과 따로 — 어댑터 판만 다시 만들면 J6 · 시험대 · 2 ~ 3 호기에 붙는다~~
  → **B2 로 바뀜(2026-10-28)**: 받침 원판(Ø56 · M3 넷 Ø31.5 · 아랫면 Ø20 맞춤 홈)이 곧 체결면 — 팔 쪽 판 하나만 이 면에 맞추면 J6 · 시험대 · 2 ~ 3 호기에 붙는다.
  대신 팔 나사는 서보 · 턱 아래에 가려 **그리퍼를 떼려면 관 → 턱 B → 턱 A → 피니언 → 서보 순으로 풀어야 한다**(관을 접착하면 사실상 못 뗌 — 그래서 관은 R 기둥에만 눌러 끼움).
- 끼움 값: 인서트 구멍 Ø4.0(원장 확정) · M3 통과 3.4(원장 임시값) — 원장에서 읽고 parameters.json 에 끼움 키를 두지 않는다.
  ~~금속 안내의 끼움은 구매품이 맡게 해 인쇄 미끄럼 끼움을 쓰지 않는다~~ → **사용자 G5 「Ø6 금속 봉 + 인쇄 턱 구멍 (권장)」 로 바뀜**(2026-10-28 질문 창 —
  그 선택지가 「구멍 6.0 ~ 6.4 시험편을 먼저 출력해 고르셔야 함」 을 적었다): 새 끼움 키 넷은 원장의 `pending` 칸(시험 전 · values 와 따로 — MP6 지문이
  values 전부에 묶여 있어 values 에 키를 더하면 MP6 을 다시 만들어야 함 · 지문 그대로 확인 `cc0a39b9…`).
- 카메라: 붙일 자리(나사 구멍 둘)만 · 트레이 · 지그는 범위 밖(G4).
- 디자인: KMJH(흰 몸체 · Deep Navy 덮개 · Cool Gray 손끝 받침 · 민트 사선 하나) — 색은 출력 때 필라멘트로 정함(이번엔 출력 안 함).
- 출력: H2D 0.4 · PLA · 지지대 없이 눕힐 수 있는 부품 꼴 · 판 맞춤 · 질량은 슬라이서 추정(출력 · 전송 없음).

## B2. 배치 · 치수 (구매품 조사 `.dev/mp8-evidence/research-dims.md` 뒤 · 2026-10-28)

- 서보를 **눕혀** 축을 +y 로(커넥터가 있는 아래면이 뒤를 봄 — 세우면 커넥터 자리 약 14 mm 만큼 그리퍼가 길어짐). 서보 위면(M2 넷)을 벽 뒷면에 · 스플라인은
  벽의 Ø21 구멍으로. 피니언 m1.5 · z18 · r 13.5 · ~~b 10~~ → **b 9 + 허브 2**(조사: 0.4 노즐 m1.5 ~ 2.0 · z ≥ 17 언더컷 없음 · 검토 G01 — 피니언 뒷면과
  턱 A 쐐기 앞면 사이 축 방향 틈 0 → 1.0 · 혼 높이 2.65 에서도 0.65).
- **서보 받침 턱(검토 G07)**: 서보 위면 M2 자리가 홈이라 서보가 z 로 ±0.4 떠다닐 수 있음 → 벽 뒤에 서보 아래 옆면(z 13.64)을 받치는 턱 · 조일 때 서보를 턱에 눌러 댐.
  피니언 나사 넷은 꼭 맞는 구멍(원장 pending `m3_close_hole_dia` 3.2)으로 혼 위 가운데를 잡음.
- 랙 A = 피니언 위(이 아래) · 랙 B = 피니언 아래(이 위) → 두 턱이 반대로 같은 거리. 턱마다 **자기 탄소 관 둘**(턱 A y −15 · −5 · 턱 B y 10.5 · 18.5 · z 52) —
  관을 함께 쓰면 긴 슬리브끼리 부딪히고, 랙 하나를 슬리브 밖으로 길게 내밀면 피니언 밀어내는 힘에 휨(어림 0.4 ~ 1.2 mm)이 커서 넷으로 했다.
- 턱 B 는 랙이 아래라 세운 벽(y 5.5 ~ 9.5)으로 슬리브까지 올라온다 — z 를 위로 출력(랙 이는 층을 가로지름 · ~~랙 Y 0.485 로 피니언보다 튼튼~~ →
  랙 Y 0.485 는 원문 미확인 · 층을 가로지르므로 층 사이 인장 31 MPa 와 견줌 · 검토 R-17).
  턱 A 는 y 를 위로 출력(랙 이가 층 안) · 랙 뒤 45° 받침 · 그래서 서보 벽 꼭대기를 38.5 로 낮춤.
- 손끝 A = 옆 날개를 대 +y 면에(인서트 = 출력 방향 세로) · 손끝 B = 덮개를 대 윗면에(같은 까닭) — 두 손끝 모두 확정 인서트 값(세로 구멍)만 쓴다.
- 행정 0 ~ 94(한쪽 47) · 서보 199.5° · 닫힘 = 두 손끝이 맞닿음 · 받침 기둥 안쪽 x ±62(슬리브 끝 최대 ±61 — 손끝 대 10 mm 로 두껍게 한 뒤 · 검토 G09).
- 관: L 기둥(미끄럼)으로 넣어 두 슬리브를 지나 R 기둥에만 눌러 끼움(검토 R-14) · 맞춤 홈(받침 앞면 x 0) — 두 손끝 맞닿는 선이 홈 위면 두 턱이 같은 이에 물린 것(검토 G02).
- 팔 체결: 원판 Ø56(공구 플랜지와 같은 지름) · M3 넷 Ø31.5 원(0°) · 아랫면 Ø20 맞춤 홈(팔 쪽 돌기 — J6 출력 설계 때) — 원판을 먼저 팔에 조인다(조립 뒤엔 위에서 닿지 않음).

## C. 그리퍼 짐 판정

- `gripper_loads.py`: 그리퍼 질량 · 무게중심 + 물체 0.2 kg(G3) @ 쥐는 점을 합성 점질량으로 바꿔(곧게 편 자세의 중력 항은 정확히 같음 · 관성 항은 Σ m(o − c)² 만큼
  작음 — 그 크기를 함께 적음) MP5 `joint_loads.py` 를 입력 사본으로 다시 돌린다(모듈의 HERE 만 바꿈 · MP5 파일 무변경 · 입력 사본은 `.dev/mp8-evidence/loads-gripper/`).
- 기본 경우(쓸 수 있는 토크 0.5)와 비관 경우(0.4) · 손목 27:1 S1 / S2 · 손목 54:1 · 어깨 후보 칸(J2 칸 — 같은 구동이면 J3 여유가 더 큼) · MP5 0.5 kg @ 0.05 m 기준과 견줌.
- 쥐는 점(물체 무게중심)은 한 점 가정이 아니라 **높이 셋**(손끝 판 가운데 82.25 · 트레이 집기 20 mm 물체 96 · 6 mm 물체 103 — 기본 = 103)으로 돈다(검토 G04).

## 검사 장치 (MP6 · MP7 교훈 — 처음부터)

`src/cad/kmjh-gripper-v1/verify_gripper.py` — 커밋된 부품 STL 만으로(생성기를 부르지 않음 · 정답 = parameters + 원장 + 검사기 안의 독립 표):
G0 출처 sha256(부품 STL · native · STEP · 3MF ↔ 만들기 기록 ↔ 지금 입력) · G1 부품 목록 · 닫힘 · G2 열림 여섯 자리 × 손끝 두 벌의 모든 쌍(인쇄 부품 + 서보 몸통 ·
혼 · 나사 머리 · 관 · 커넥터 자리) 교차 ≤ 0.01 mm³ · G3 맞물림(겹침 없음 + 0.4 밀면 겹침) · G4 손끝 간격 = 2u · G5 구멍(지름 = 원장 · 빔 · 둘레 재료 · 독립 개수 ·
인서트가 출력 방향에서 세로) · G6 출력 방향별 판 안 · 판 닿음 · 가파른 처마 · 다리 길이 ≤ 30 · G7 루이스 · **G8 조립 경로**(턱 A 를 위로 · 턱 B 를 앞으로 빼내는 길 ·
관 축 = 기둥 구멍 = 슬리브 구멍 — 만든 뒤 작성자가 조립 차례의 빈틈을 찾아 더함).
쓰기 가드 `guard.py`(보호 = v1 · v2 · v3 · MP6 · MP5 · URDF · 펌웨어 · 원장 폴더 · 격리 작업 뿌리 표지 `MP8_SCRATCH`) · 양성 대조 `run_controls.py`(밝힌 기대 키 집합과 꼭 같음 ·
형상 대조는 사본 기록의 출력 sha256 도 맞춰 G0 이 같이 거짓이 되지 않게 · 가드 대조는 꾸민 저장소에서 가드 함수만).

**검토 뒤 검사 장치에 더한 것(2026-10-28 · 처분 = `.dev/mp8-evidence/review.md`)**: G1 manifold 바꾸기 = 메시 부피(열린 메시가 빈 입체로 조용히 통과하던 길을 막음) ·
G2 움직이는 쌍 δ 0.3 최소 틈(빼는 방향은 이름 표로만) · 놀음 끝 여덟(혼 높이 2.65 · 관 위 놀음 ± · 피니언 비킴) · 구매품 쌍(피니언 나사 끝 ↔ 서보) · 나사 몸통 기준 입체 ·
G3 위상 표본 20 + 최소 백래시(피니언 비킴 + 관 놀음 만큼 밀어도 겹침 없음) · G4 물체 상자 · G5 M2 홈 탐침 · 원장 밖 종류는 parameters 와 대조 · 개수 표 73 개 전부 ·
G6 구멍 가림을 없애고 아래 향한 면마다 다리 길이(가파른 면 20 · 수평 30) · G8 혼 높이 두 끝 · 관 없는 턱 A 0.3 처짐 · 관 끼움 쪽 · G0 출력 키 집합 · 출력 준비 기록 · 도구 판.
대조 29 + 가드 29(거부 사유 조각까지) · `--out` 도 가드.

## 결과 (2026-10-28 · 독립 산출 검토 뒤 고친 판 — 첫 판 값은 아래 줄 끝 괄호)

- 그리퍼: 부품 16(인쇄 8 + 시험편 8 — 관 구멍 · M3 구멍 블록 · 맞물림 지그 · 랙 막대 둘 · 시험 피니언 넷) · 검사 모두 참 · 슬라이서 「ready」 · 지지대 없음 ·
  시험편 판 36.4 g · 1 시간 45 분 · 본판 111.5 g · 3 시간 28 분(첫 판 23.4 g · 108.5 g).
- 질량 **184 g**(인쇄 104 + 서보 55 + 관 13 + 혼 3 + 나사 · 인서트 9 — 목표 170 g 을 14 g 넘음 · 첫 판 181 g) · 무게중심 z 35.8 ·
  출력물 200 g 과 합쳐 384 g(가반 0.5 kg 안).
- 짐 판정(MP5 계산기 · 입력 사본 · 쥐는 점 높이 셋): 손목 27:1 · NEMA17-40 기본 여유 25.3 / 23.0 / 21.9 % · **비관 0.2 / −1.6 / −2.5 %**(쥐는 점 82.25 / 96 / 103 mm —
  트레이 집기에서는 비관 경우 부족) · NEMA17-48 기본 69.5 % 이상 · 비관 35.6 % 이상 · 54:1 비관 85 % 이상 · 어깨 162:1 비관 5.0 ~ 5.4 % · 135:1 비관 부족(첫 판은 z 85 한 점 · 비관 0.4 %).
- 모터 영향 표: 관절 거리 그대로면 몸체 상한 **43.0 mm**(J1 드라이버 ↔ 발 윗면 — 발을 파면 51) · v3 J4 43.2 · J2 분할 43.5(다시 그리면 풀림) · v2 J4 44.0 —
  드라이버 18 · 간격 2 가정 아래(첫 판 「≈ 44 · J4 ↔ J3」).

## 검토

Codex 비작성자 검수는 이번에 하지 않는다(필요하면 사용자가 지시). 대신 Claude 하위 에이전트 워크플로(같은 모델 계열 — 비작성자 검수가 아님)로
~~계획 검토 1 회(만들기 전)~~ · 산출 검토(만든 뒤 · 읽기 전용 · 셸 없음) — 지적과 처분은 `.dev/mp8-evidence/review.md`.
**계획 검토(만들기 전)는 하지 않았다**(이 줄의 약속과 다름 — 검토 R-10 · review.md 머리에 적음). 산출 검토 지적을 고친 뒤의 다시 검토도 하지 않았다.

## 소유 경로 · 커밋

이 계획 · `src/cad/kmjh-gripper-v1/` · `models/kmjh-gripper-v1/` · `src/cad/design-check-mp8/` · `src/cad/calibration/motor-mks42d.json` ·
`src/cad/calibration/print-fits.json`(`pending` 칸 · `used_by` 한 줄 — `values` 무변경 · MP6 지문 그대로) · `docs/measure/` ·
`.dev/mp8-evidence/` · `docs/BOM.md`(그리퍼 줄 · 바뀐 기록 덧붙이기) · `.dev/HANDOFF.md` MP8 절 · `.dev/CODING_RULES.md` MP8 단락(덧붙이기만 — 남의 미커밋 줄은
색인에 올리지 않음). 커밋은 소유 경로의 파일 이름만 적어서(`git commit --only` — Codex 가 스테이징해 둔 것은 건드리지 않음) · push 없음.
