WINNAKEN/robot-arm-lab/docs/design/056-j5-wrist-real-part.md

> 개발 이력: 작성 당시의 계획·결과입니다. 현재 상태는 [STATUS](../STATUS.md)를 확인하세요. 원시 로그와 로컬 경로 일부는 공개본에서 제외했습니다.

# 056 — J5 손목 굽힘 관절 실부품 v1 (MP10 · Claude 모델링 · 2026-10-28)

## 요청 · 결정

- 사용자 「계속이어가」 → 질문 창: 「손목 관절 실부품 설계 (권장)」 · 「J5 손목 굽힘 하나 (권장)」 · 「관절 거리만 고정 (권장)」 · 「PLA 로 먼저 (권장)」 · 「MP10 (권장)」.
  원문(질문 · 고른 것 · 고르지 않은 것) = `.dev/mp10-evidence/user-decisions-mp10.json`(세션 기록에서 스크립트로 꺼냄).
- 작성자 해석: J5 관절 하나를 **실제로 출력해 조립할 부품**으로 만든다. MP6 사이클로이드 27:1 감속기는 **파일 · 부품 그대로** 쓰고, 그 둘레의 모터 · 드라이버 하우징 ·
  J4 쪽 목(링크 4) · 출력 허브(링크 5 뿌리) · 뒤 덮개를 새로 그린다. 관절 원점 · 축 · 거리(v1 kinematics)만 지키고 바깥 치수는 v3 와 달라져도 된다.

## 범위 · 하지 않는 것

- 새 폴더: 코드 `src/cad/j5-wrist-v1/` · 산출 `models/j5-wrist-v1/` · 근거 `.dev/mp10-evidence/`.
- 하지 않음: v1 · v2 · v3 · MP6 · 그리퍼 · 끼움 원장 · 모터 원장 · URDF · 펌웨어 · 배선 문서 고치기 · 출력 · 프린터 전송 · 구매 · 새 설치 · 모터 전원.
  J4 · J6 · 링크 5 몸통은 다음 단위(이번엔 접속면 · 나사 자리만).

## 좌표

- **모듈 좌표 = MP6 좌표**: z = J5 축(링크 4 의 +y) · z = 0 = 모터 앞 장착면 · 감속기 출력 면 z = 43.5(`cycloid.json` `stack_mm.output_face`) ·
  x = 링크 4 의 +x(J4 → J5 방향) · y = 링크 4 의 −z. MP6 부품 STL 이 이 좌표로 저장돼 있어 옮기지 않고 그대로 쓴다.
- 링크 4 안 자리: 모터 면 = J5 원점에서 링크 4 −y 로 21(v3 와 같은 자리 — 드럼 면 −18 에서 3 안). 링크 4 점 = (x + 78, z − 21, −y).
  J4 출력 면(링크 4 x = 18 · v3 와 같음)은 모듈 x = −60, J4 축은 모듈 (y, z) = (0, 21) 을 지나는 x 방향.

## 부품 (인쇄 · PLA)

| 부품 | 하는 일 |
|---|---|
| `J5_STATOR_A` | 캔 반쪽(J4 쪽 · x < 0) + **목(링크 4)**: J4 출력 면(x = −60)에 닿는 판 + 캔으로 내려오는 받침 · J4 나사 넷 자리 · 조임 귀(볼트 머리) · 커넥터 칸 · 케이블 창 · 홈 · 타이 구멍 |
| `J5_STATOR_B` | 캔 반쪽(x > 0) · 조임 귀(인서트 자리) |
| `J5_REAR_COVER` | 뒤 덮개 — 두 반쪽을 뒤에서 묶음 · 떼면 드라이버 화면 · 버튼 쪽이 열림 |
| `J5_OUTPUT_HUB` | MP6 출력 플랜지 위 원판(링크 5 뿌리) — 위면에 링크 5 용 M3 인서트 넷 |

## 핵심 설계 판단

- **캔은 둘로 나눠 모터 몸통을 조인다(조개 꼴).** 하중 길: J5 짐 → MP6 하우징 → 모터 나사 넷(MP6 그대로) → 모터 몸통(강철 · 사각) → 두 반쪽의 사각 홈(모양으로 돌지 않음 ·
  볼트 넷이 x 방향으로 조임) → 목 → J4. 두 반쪽 사이는 1.0 띄워 조임 힘이 모두 모터로 가게 한다. **(2 차: 조임은 갈비 둘 · 볼트는 가르는 면 옆 귀 — 아래 「2 차」 절)**
- 버린 길: ① MP6 덮개 나사(반지름 34.5)로 캔 앞 테를 함께 조이기 — 나사 머리 자리 바깥 벽이 1.3 mm(바깥 39)로 얇고, 나사를 넣을 길이 없음 ·
  ② MP6 하우징 바깥을 띠로 감싸 마찰로 잡기 — 돌림을 모양으로 막을 데가 없음 · ③ 모터와 바닥판 사이에 판 끼우기 — MP6 쌓임(파일럿 · 편심 축 압입 높이)이 깨짐.
  드라이버(가정 46 각)가 모터(42.3)보다 커서 한 덩어리 캔은 뒤에서 끼울 수 없다 — 그래서 조개 꼴.
- MP6 덮개 나사(M3 × 30) 머리는 바닥판 밑으로 나온다 → 캔 앞 테에 홈(폭 7)을 판다(돌림 막기에는 안 씀). **(2 차: 깊이 3.4 + 가르는 면까지 x 길)**
- MP6 출력 플랜지 나사(M3 × 8)는 허브 두께만큼 긴 것으로 바꾼다(머리 밑 4 → M3 × 12 · 끝 위치 그대로).
- J4 접속: J4 도 MP6 와 같은 출력 플랜지(나사 넷 · 반지름 14 · 45°)라고 **가정**하고 목판을 그 위에 얹어 같은 나사를 길게(M3 × 16) 쓴다. J4 를 설계할 때 바뀔 수 있다.
- 케이블: 감속기가 모터와 같은 축이라 가운데로 못 지나간다 → 드라이버 커넥터가 J4 쪽(−x) 옆에 있다고 **가정**하고 그 옆 벽에 구멍을 낸다(밖으로 나와 목을 따라 J4 로).
- 출력 방향: 두 반쪽 = 뒤 끝을 바닥에 세워(축이 위) · 덮개 = 바깥 면이 위 · 허브 = 밑면이 바닥. 오버행은 45° 모따기로 줄인다(KMJH 사선과 같은 말).

## 치수 원천 (숫자를 옮겨 적지 않는다)

- 형상 = `src/cad/j5-wrist-v1/parameters.json`.
- MP6 접속 = `models/cycloid-27-v1/cycloid.json`(`stack_mm` · `radii_mm` · `screws`) + `src/cad/cycloid-27-v1/parameters.json`(개수 · 나사 머리) — 읽기만.
  나사 자리 각(덮개 · 출력 인서트 45° · 누름 고리 0°)은 MP6 생성기의 고정값이라 parameters 에 출처와 함께 적는다.
- 모터 · 드라이버 = `src/cad/calibration/motor-mks42d.json`(모두 가정값 · 생성기가 직접 읽음 — 실측이 들어오면 다시 만들면 따라옴).
- 구멍 = `src/cad/calibration/print-fits.json` PLA(`m3_clearance_dia` 3.4 임시 · `insert_hole_dia` 4.0 확정). parameters 에 끼움 키를 적으면 생성기가 멈춘다.
- 관절 자리 = v1 `kinematics.json` · `parameters.json`(읽기만).

## 검사 (커밋된 STL 로 스스로 계산)

| 번호 | 무엇 |
|---|---|
| C1 | 부품 STL 닫힘 · manifold 부피 = 메시 부피 > 0 |
| C2 | 두 번째 구현(생성기를 부르지 않고 parameters · 원장 · `cycloid.json` 으로 manifold3d 로 다시 만듦 — 같은 작성자라 커널 일치 확인에 가깝다 · 검토 R-5) ↔ STL 양방향 표면 거리 ≤ 0.03 |
| C3 | 조립 겹침 · 틈: 네 부품 + MP6 부품 + 모터 · 드라이버 · 커넥터 가정 상자 + 나사 몸 — 닿기로 한 쌍(조임 면 · 바닥판 면 · 허브 ↔ 플랜지)만 면 접촉, 나머지는 겹침 0 · 틈 하한 |
| C4 | 나사마다 표준 길이 · 물림 ≥ 4 · 끝 ↔ 구멍 바닥 ≥ 0.5 — 자리면 · 바닥은 STL 을 막대로 찔러 잰다 |
| C5 | 자리: 모듈 z 축 = v1 J5 축 · 목판 면 = J4 원점 + 18 · J4 축 (MP9 의 독립 순기구학 · 표시 자세) |
| C6 | J4 한 바퀴(5° 간격): 모듈 ↔ v3 링크 0 ~ 3 바디 겹침 |
| C7 | 단면 벽 두께 ≥ 2.0(z · x 단면 여러 곳 · shapely) |
| C8 | 출력 준비(printforge printprep · H2D · PLA Basic · 0.20) — 판정 · 지지대 · 질량 · 시간 |
| C9 | J5 한 바퀴(15° 간격): 허브 ↔ MP6 고정 쪽 · 누름 고리 나사 머리 틈 |
| C3b | (2 차) 닿는 넓이 하한 — 갈비 ↔ 모터 · 앞 테 ↔ 바닥판 · 허브 ↔ 플랜지 · 덮개 ↔ 반쪽 · 목판 ↔ J4 플랜지 |
| C6b | (2 차) J4 = MP6 가정 — J4 고정 쪽(덮개 · 누름 고리 · 그 나사 머리)을 5° 간격 한 바퀴 · 반쪽 A 와 겹침 0 · 틈 ≥ 0.3 |
| C10 | (2 차) 반쪽을 옆에서 밀어 넣는 길 — 모터 · 드라이버 · 커넥터 · MP6 덮개 나사 머리 겉봉과 겹침 0 |

양성 대조(생성기에 고장을 넣어 다시 만든 판을 검사기가 잡는지): 홈 각 · 조임 홈 좁힘 · 드라이버 칸 좁힘 · 목판 1 mm 밀림 · 허브 키움 · 덮개 인서트 바깥으로 ·
반쪽 틈 0 · 볼트 자리 얕음 · 열린 메시 · 인서트 원 반지름 2.5 mm(20.5 → 23) — 2 차에서 더함: 갈비 좁힘 · 머리 길 없앰 · 목 / 허브 나사 자리 · 덮개 인서트 얕음 · J4 면 물림 없앰 · 기록 ↔ 파일 sha 어긋남(모두 17).

## 손계산 (어림 — 판정 아님)

- J5 필요 토크 약 3.9 N·m(짐 0.5 kg · 안전율 포함 · MP6 README). 모터 조임 면(x = ±21.15)에서 그 짝힘 ≈ 3.9 / 0.042 = 93 N — 볼트 넷의 조임 힘(M3 · 몇 백 N)에 비해 작고,
  사각 홈이라 미끄러져도 돌지 않는다(모양 잠금). 크리프로 조임이 풀리면 축 방향(모듈이 빠지는 쪽)만 마찰에 기댄다 — 실물 시험 항목.
- 목판 뿌리 굽힘: 손목 이후 짐 어림 2 N·m · 실제 뿌리(z −2)의 판 10 × 42 단면(세워 출력이라 층과 수직으로 당김) → 약 2.9 MPa — PLA 층간 강도보다 한참 작음(검토 R-12 가 바로잡음).

## 가정 · 위험

- 모터 · 드라이버 · 커넥터 치수 · 커넥터 방향은 모두 가정(실측 전). 드라이버 화면 · 버튼 면도 모름.
- J4 접속 = MP6 출력 플랜지 가정(위치 · 나사). 중심 맞춤 턱은 끼움 값이 원장에 없어 안 둠 — 나사 구멍 틈만큼(± 0.2) 어긋날 수 있다.
- PLA 는 모터 · 드라이버 열에 약하다(공기 틈만 둠) · 조임 크리프.
- MP6 는 「비작성자 최종 검수 미통과」 표지 그대로다.

## 검토

계획 검토 없음(사용자 「일단 만들어놓고 조금씩 수정」 흐름 · MP9 와 같음). 산출 검토 = Claude 하위 에이전트(읽기 전용 · 작성자 결론 안 줌). Codex 비작성자 검수 없음(잔여 위험).

## 만들며 바뀐 것 (검사 · 슬라이서가 찾은 것 — 위 글보다 이것이 이긴다)

| 무엇이 드러남 | 고침 |
|---|---|
| 첫 만들기에서 반쪽 A STL 이 열림(manifold 부피 0) — 목 받침 윗면이 캔 앞면과 같은 z = 0 평면 | 받침 윗면 z −2 · 앞면을 판 안쪽 0.3 · 어느 면도 같은 평면에 두지 않음 |
| 뱀부 스튜디오 「floating cantilever」(반쪽 A) — 받침 앞 0.3 mm 띠가 공중 첫 층 | 판 아래 앞 모서리 45° 1 mm 모따기 · 받침 경사를 판 밑면보다 0.3 아래에서 시작 |
| 같은 경고가 남음 — 슬라이스 시험(칸 채움 → 경고 없음 · 턱 채움 → 남음)으로 **커넥터 칸의 평평한 천장**이 원인 | 커넥터 칸 · 케이블 구멍 천장을 45° 박공으로 · 칸 안쪽 끝은 드라이버 칸 가장자리 + 0.1 까지(조임 칸과 벽 2.75) → 네 부품 모두 지지대 없이 `ready` |
| C7: 조임 볼트 자리파기가 둥근 바깥으로 비스듬히 나오며 1.1 mm 입술 | 입술이 min_wall 보다 얇은 구간을 바깥으로 틈(상자 높이는 원통보다 0.1 좁게 — 원통에 접한 상자 면에서 SolidCraft 빼기가 「no result」) |
| 허브 위 2 mm 모따기 부근에서 링크 5 인서트 바깥 살 1.0 ~ 1.6 | 인서트 원 반지름 22 → 21 · 생성기 한계에 모따기 반영 |
| C2 계산이 4 분 넘게 걸림 | 정확히 다시 재는 문턱 0.005 → 0.02(허용 0.03 의 2/3 — 그 아래 값은 참 거리 이상이라 판정이 바뀌지 않음 · 보고 값 ≤ 0.02 는 위쪽 어림) |
| (1 차 끝) 위 「입술 트기」 · 「박공」 줄은 2 차에서 대체됨 | 아래 2 차 절 |

## 2 차 — 산출 검토 R1 반영 (위 글과 다르면 이 절이 이긴다)

검토 = `.dev/mp10-evidence/review.md`(원문 `review-r1-raw.md`) · 중대 2 · 보통 4 · 경미 8 — 13 건 수용 · 고침 · R-4 ③(목을 반쪽 A 와 한 몸으로 넣은 것)은 사용자 결정으로 넘김.

| 바뀐 것 | 왜 |
|---|---|
| MP6 덮개 나사 머리 홈 깊이 2.2 → 3.4 · 머리에서 가르는 면까지 x 방향 길 | R-1 반쪽을 옆에서 밀어 넣을 길 · R-2 렌치볼트 머리(3.0)도 받음 |
| 조임 면 = 한 반쪽에 갈비 둘(폭 6) · 나머지 x 면 공기 틈 1.0 · 앞 테 구멍도 1.0 | R-4 ② 고른 글 「모터 둘레 공기 틈」 · 앞 테가 갈비 틈보다 좁으면 그 밑면이 뜸(슬라이서) |
| 드라이버 칸 → 조임 칸 45° 깔때기(사각뿔대) | 갈비 + 평평한 턱 = 뱀부 스튜디오 「floating cantilever」(변형 슬라이스로 가림) |
| 조임 볼트를 둥근 캔 벽의 자리파기 → **가르는 면 양옆 귀(lug)** 로(머리는 귀 평면 · 귀 밑 45°) | 비스듬한 자리파기의 얇은 입술 · 그 입술을 트는 상자 · 슬롯이 판마다 SolidCraft 빼기 실패 · 열린 이음매 |
| 커넥터 칸 = 한 번의 45° 외쪽 지붕(안쪽 끝 −41 · 바깥 벽 쪽만 높음) | R-8 조임 면 뒤 얇은 벽 · 상자 + 박공 두 빼기의 같은 평면 면이 열린 이음매 |
| 목판 J4 면 반지름 28.5 바깥 0.6 물림 | R-3 J4(= MP6) 누름 고리 나사 머리(출력 면보다 0.15 높음)를 J4 가 돌 때 긁음 |
| 목 받침 45° 아랫면 케이블 홈 + 케이블 타이 구멍 두 쌍 | R-4 ① 고른 글 「밖 홈과 묶는 고리 자리」 |
| 허브 링크 5 인서트 원 21 → 20.5 | R-14 인서트 바깥지름 4.2 기준 위면 벽 |
| J4 나사 원 · 개수 · 각 · 나사 길이 목록 = MP6 에서 읽음 · 바깥 반지름 = MP6 단언 · 케이블 창 높이 = 드라이버 높이 기준 | R-9 · R-7 |
| 검사: C3b · C6b · C10 더함 · C4 광선 · C7 단면(48 곳)을 원천 값에서 · C8 은 지지대 없음까지 · C2 거리 전 넓이 0 면 거름 · C7 문턱 1.5(45° 예각 모서리 1.24 는 얇은 벽 아님) | R-6 · R-7 · 작성자 |
| 대조 10 → 17 | R-11 |

결과 = 검사 13 모두 참 · 네 부품 지지대 없이 `ready` · 모듈 약 672 g.

## 다시 만들기 (2026-10-30 · 모터 전체 길이 실측 반영 — 이 절이 위 글 · 표보다 이긴다)

- 사용자 「J5 모터 40mm 짜리 아니였어??」 → 다음 단계 상자 「J5 뒤쪽 길이를 53.5 로 줄여 다시 만들까요?」 에 「지금 40 기준으로」(원문 `.dev/mp10-evidence/user-decisions-mp10-rebuild-1030.json` · 규칙 = CODING_RULES 「MP10 다시 만들기」 단락).
- 바꾼 것: 드라이버 칸 = 몸체 `body_length` 40 + 간격 `motor_driver_gap` 2(가정) 뒤에서 모터 원장의 **실측 `overall_length` 53.5**(10/29 · 뒤 단자대 끝까지 · 상한)까지. 원장 `driver_depth` 18(가정)은 더 읽지 않는다(`parameters.json` `motor_keys` · `driver_span_note`). 생성기 · 두 번째 구현 · 출력 준비(모터 무게중심) · 렌더 · 만들기 기록(`driver_z_used`)을 같이 고침. 구조 · 다른 매개변수 무변경.
- 결과: 두 반쪽 · 덮개가 6.5 앞으로(캔 뒤 끝 z −64.0 → −57.5) · 허브 STL 그대로 · 검사 13 모두 참 · 양성 대조 17 모두 잡힘 · 한 판 111.06 → 105.5 g · 모듈 약 672 → 666 g · SolidCraft CLI 0.23.0 → 0.26.0.
- 따라 바뀐 것(고치지 않음 · 사용자 판단 대기): 케이블 창이 드라이버 칸 기준이라 직사각 높이 12 → 5.5 · 단자대 끝 뒤 여유 덮개 안면까지 4 · 커넥터 칸 바닥까지 1. 모터 · 드라이버 · 커넥터는 overall_length(실측) 밖에는 여전히 가정 — 위 글의 「모두 가정」 은 이 하나를 빼고 읽는다.
- 산출 검토 = Claude 하위 에이전트(읽기 전용) — 원문 `.dev/mp10-evidence/review-rebuild-1030-raw.md` · 처분 = `.dev/mp10-evidence/review.md` 끝. Codex 비작성자 검수 없음(잔여 위험).

## 다시 만들기 2 (2026-10-30 · 드라이버 단자대 방향 — 이 절이 위 글 · 표보다 이긴다)

- 사용자 드라이버 뒷면 사진 + 「뒤에서보면 이런데 6단자는 오른쪽 5단자에 아래2개 더있는건 왼쪽이야 뒤에서 봤을떄 위의 4개는 모터에 드가더라」 → 질문 창 「양옆 단자를 이음 쪽으로 (권장)」(원문 `.dev/mp10-evidence/user-decisions-mp10-terminals-1030.json` · 규칙 = CODING_RULES 「MP10 다시 만들기 2」 단락).
- 드라이버를 뒤에서 볼 때 위(모터 선 4 단자) = −x · 양옆 단자대(5+2 · 6) = ±y(이음) · 화면 · 단추 = +x. 위 「케이블」 판단(−x 커넥터 가정)과 「J5_STATOR_A 커넥터 칸 · 케이블 구멍」 은 이렇게 바뀐다: −x 칸 = 모터 선 칸(창은 남는 출구) · ±y 단자대 칸 둘 = 두 반쪽에 반씩 · (x, z) 단면 = 상자 + 이음 쪽으로 오르는 45° 박공 · 안쪽은 조임 칸 면 − 0.15 까지(조임 칸 · 깔때기와 이어짐) · 이음 자리 창 둘 = 폭 14 · 뒤 끝면 위 2 ~ 7 + 박공 · 조임 귀 너머까지 · 뒤 덮개 나사 30 · 150 · 210 · 330°.
- 만들며 바뀐 것: ① 창을 드라이버 칸 기준(박공 꼭대기 −39)으로 두니 SolidCraft 가 반쪽 A 빼기를 「no result」 — 창이 조임 귀 45° 밑면을 높이 파고들 때만 실패(낮거나 좁은 창은 됨) → 뒤 끝면 기준으로 내림. ② −x 칸과 같은 외쪽 지붕(바깥 벽 쪽이 높음)은 안쪽 끝이 드라이버 칸 옆 공중에서 시작하는 칼날 모서리를 남겨, 이음 쪽이 열린 ±y 칸에서는 한쪽만 붙은 외팔보 → 뱀부 스튜디오 「floating cantilever」(층 단면 검사로 0.1 × 10 mm 띠 확인 · 지붕 시작을 올려도 남음) → 이음 쪽 박공으로 바꿈 · 네 부품 다시 지지대 없이 `ready`.
- 산출 검토 R3 뒤 고침: ③ 이음 창 꼭대기가 가르는 면에서 조임 귀 밑면과 0.003 mm 로 맞닿아 있어 창을 1 mm 내림(한계 `terminal_window_clear_of_lug`) · ④ 새 검사 C11(창이 밖으로 열림) · C12(덮개 인서트 구멍 둘레 벽)와 대조 셋(단자대 칸 좁힘 → C3 · 이음 창 막음 → C11 · 덮개 인서트 옛 각 → C12). 결정 질문 그림은 「반쪽 A │ 반쪽 B」 를 세로 이음으로 그렸지만(위 = −x 면 A 가 위 · 이음은 가로) 구현은 고른 글대로다(검토 R3-9).
- 결과: 검사 15 모두 참(C3 88 쌍 · 닿음 28 · C7 62 곳) · 양성 대조 20 모두 잡힘 · 한 판 105.5 → 104.34 g · 모듈 약 666 → 665 g.
- 산출 검토 = Claude 하위 에이전트(읽기 전용) — 원문 `.dev/mp10-evidence/review-rebuild2-1030-raw.md` · 처분 = `.dev/mp10-evidence/review.md` 끝. Codex 비작성자 검수 없음(잔여 위험).

## 다시 만들기 3 (2026-11-01 · 모터 커넥터 칸 — 이 절이 위 글 · 표보다 이긴다)

- 사용자 맞춤 보고 「핀은 잘보이는데 모터 위쪽 커넥터떄문에 더 안으로못들어가는것같은데? 얼만큼을 더 밀고싶엇는지는 내가정확하게는 모르겟는데...」(사진 둘) → 다음 단계 상자 「커넥터 칸을 앞으로 늘릴 값은 어떻게 정할까요?」 에 「재서 알려줄게」 → 잰 값 「1. 29 / 2. 선이 두껍지않고 변형도심하지안하도되서 10mm (커넥팅하고 커넥터 높이가 7mm정도라) / 3. 16 / 4. 이건 사진 첨부 , 모터로 바로가」(원문 `.dev/mp10-evidence/user-decisions-mp10-connector-1101.json` · 규칙 = CODING_RULES 「MP10 다시 만들기 3」 단락).
- 원인: 모터 −x 면 뒤 뚜껑 위의 모터 6 핀 커넥터 + 선(앞면에서 29 뒤부터 · 높이 10 · 폭 16). 옛 판은 앞면 뒤 38 까지 모터 −x 면 위가 공기 틈 1.0 뿐이고 커넥터 칸은 z −41 부터라 반쪽 A 가 커넥터 높이 − 1 만큼 덜 들어갔다. 위 표 「모터 · 드라이버 · 커넥터 가정」 에 없던 부품(모터 쪽 커넥터)이다.
- 고침: 반쪽 A 에 모터 커넥터 칸 — y −8.6 ~ 14(폭 22.6) · 모터 −x 면 위 깊이 12(옛 칸 범위 y ≤ 11.2 는 옛 칸 바깥 끝 너머 14.1) · 지붕 = y 방향 45° 박공(양 끝 z −27 · 가운데 꼭대기 z −15.7). (y, z) 단면을 x 로 밀어낸 칸 둘(깊은 칸 · 옆 칸 — 옆 칸은 벽이 얇아 커넥터 높이 + 2 까지만 · 지붕 · 바닥 0.2 아래로 같은 평면 피함).
- 만들며 바뀐 것: 첫 시도는 옛 −x 칸처럼 바깥 벽 쪽으로 오르는 외쪽 지붕이었다 → 뱀부 스튜디오 「floating regions」(지지대 필요) — 층 단면 검사로 셋을 찾음: 조임 칸 벽(x −22.15)과 +y 갈비 끝에서 공중에 시작하는 칼날 모서리 · 새 칸 바깥 벽이 옛 칸 45° 지붕 위에 선 아래 방향 칼날. → y 방향 박공(양 끝 벽에서 자라 오름) + 깊은 칸이 옛 칸 바깥 끝 너머까지(옛 지붕을 품음)로 바꾸니 네 부품 다시 지지대 없이 `ready`.
- 결과: 검사 15 모두 참(C3 90 쌍 · 닿음 28 · 모터 커넥터 상자 틈 0.8 / 0.6 · C3b 반쪽 A 갈비 323 mm² · C7 71 곳) · 양성 대조 21 모두 잡힘(새 대조 = 모터 커넥터 칸 없앤 옛 판 → C3 · C10) · 한 판 104.34 → 102.23 g · 반쪽 A 46.7 g · 1 시간 31 분.
- 산출 검토 = Claude 하위 에이전트(읽기 전용) — 원문 `.dev/mp10-evidence/review-rebuild3-1101-raw.md` · 처분 = `.dev/mp10-evidence/review.md` 끝. Codex 비작성자 검수 없음(잔여 위험).
- 2026-11-05: 끼움 원장 · 모터 원장 · MP6 산출이 MP13 · MP14 로 바뀌어 같은 형상으로 다시 돌림(네 부품 sha 그대로). 5+2 쪽 거리를 못 받은 채 넓히기 둘(y1 15.3 · 14.6)을 시도했으나 둘 다 C7(얇은 띠 > 1.5 mm²)로 버리고 14.0 유지(`.dev/mp10-evidence/rebuild3-1105-widen-tries.json`). 반쪽 A 는 H2D 38 번 판으로 보냄(MP14).
