WINNAKEN/robot-arm-lab/docs/design/061-arm-exploded-view.md

> 개발 이력: 작성 당시의 계획·결과입니다. 현재 상태는 [STATUS](../STATUS.md)를 확인하세요. 원시 로그와 로컬 경로 일부는 공개본에서 제외했습니다.

# MP11 — 팔 전체 분해도: 외장 v3(rev1) + 그리퍼 KG1 (Claude 모델링 · 보기용) — 2026-10-29

> 계획 번호 061 은 MP11 이 쓴다. 056 은 MP10 · Codex 둘 다 썼고, 057 ~ 060 은 Codex 것이다(060 은 커밋 시점에 Codex 가 스테이지만 해 둔 상태).
> 결정 원문 = `.dev/mp11-evidence/user-decisions-mp11.json`(세션 기록에서 스크립트로 꺼냄).

## 요청 (원문)

- 「전체적인 파트들의 분해도 도 한번 쫙 만들어봐 방금 손목처럼」
  - 저장소 밖(`C:\tools\mp10-work\arm-exploded\`)에서 그림 넷을 만들어 보여 드렸다. 「방금 손목처럼」 은 MP10 의 손목 분해도 렌더를 가리킨다.
- 닫는 글에서 「이 분해도를 저장소에 남길까요?」 라고 여쭸고, 답은 「새 단위로 남기기」 였다.
- 질문 창에서 단위 번호를 여쭸고, 답은 「MP11 (권장)」 이었다. 고르지 않은 선택지는 「MP9 3 단계」.

## 무엇을 남기나

- 이 단위는 보기용 그림 단위다. 산출은 그림 다섯 장과 그것을 다시 만드는 스크립트다. 치수의 원천이 아니며, 겹침 · 강도 같은 설계 검사도 하지 않는다.
- 그리는 대상은 외장 v3 장면 `models/armold-mks-product-v3/blender/kmjh-arm-v3.blend`(rev1)의 몸체 47 개다. 여기에 그리퍼 KG1 개체 11 개를 붙인다.
  - 그리퍼는 부품 STL 6 개(바탕 · 턱 둘 · 피니언 · 손끝 덮개 둘)를 쓴다.
  - 서보는 상자 하나로, 탄소 관 넷은 원통 넷으로 그린다.
  - 붙이는 행렬은 MP9 의 `models/arm-v3-kg1-assembly/assembly.json` 에 있는 `mount.g_to_world_display` 이다.
  - 벌림 u 와 손끝 덮개 판은 `src/cad/arm-v3-kg1-assembly/parameters.json` 의 `gripper.render_u` 와 `gripper.padset` 을 쓴다.
- J5 는 v3 외장 모양 그대로 둔다. MP10 의 J5 실부품(`models/j5-wrist-v1/`)은 넣지 않는다. 이유는 두 가지다.
  - 사용자가 본 그림을 그대로 남기는 단위다.
  - MP10 의 목을 어떻게 할지(반쪽 A 와 한 몸으로 둘지, 따로 떼는 어댑터로 할지)가 아직 사용자 결정 대기다.
  - 실부품으로 바꿔 넣는 일은 따로 정한다.
- 장면 파일은 열어서 읽기만 하고 저장하지 않는다. 렌더 앞뒤의 sha256 이 같은지 대조한다.

## 산출 — `models/arm-v3-kg1-exploded/`

| 파일 | 내용 |
|---|---|
| `renders/arm-exploded-numbered.jpg` | 곧게 편 자세(q = 0)의 분해도. 번호 43 개를 달고 오른쪽에 링크별 부품 목록을 붙였다. |
| `renders/arm-exploded-home.jpg` · `renders/arm-assembled-home.jpg` | ㄱ 자 대기 자세(갤러리 `home`)를 앞 왼쪽 45° 에서 본 분해도와, 같은 각도의 조립 그림. |
| `renders/arm-exploded-straight.jpg` · `renders/arm-assembled-straight.jpg` | 곧게 편 자세의 번호 없는 분해도와 조립 그림. |
| `data/render-report-*.json` | 장면 sha256 · 자세 · 개체마다 옮긴 양(mm) · 축 점선 개수 · 부품 중심의 화면 자리 · `blend_unchanged`. |
| `data/label-grid-*.json` | 카메라 광선이 처음 맞은 부품을 칸마다 적은 격자. 번호 풍선 자리를 고르는 데 쓴다. |
| `manifest.json` | 입력 파일 · 스크립트 · 산출 파일의 sha256 과 렌더 명령. |
| `check.json` · `README.md` | 아래 검사 결과와 읽는 법. |

코드는 `src/cad/arm-v3-kg1-exploded/` 에 둔다.

| 파일 | 하는 일 |
|---|---|
| `explode_arm.py` | Blender 안에서 장면을 열고 그리퍼를 붙인 뒤 벌려서 렌더한다. |
| `label_parts.py` | 번호 풍선과 부품 목록을 붙인다. 번호 묶음 `GROUPS` 도 여기 있다. |
| `make_all.py` | 위 둘을 돌리고 manifest 를 쓴다. |
| `check_exploded.py` | 검사한다. |
| `run_controls.py` | 양성 대조를 돌린다. |
| `guard.py` | 쓰기 가드. |
| `parameters.json` | 샷 설정. |

## 벌리는 규칙

벌리는 양은 보기용 값이며, 스크립트 상수에 계수 F 를 곱한다.

- **관절**
  - 관절 k 의 빈 객체(`JOINT_Jk`)를 그 관절 축 방향으로 옮긴다. 방향의 부호는 「자식 링크가 붙는 몸체 중심 − 모듈 중심」 으로 정한다.
  - 거리는 J1 75 · J2 85 · J3 85 · J4 75 · J5 75 · J6 65 mm × F 이고, 바닥에서 손끝 쪽으로 누적된다.
- **바닥 묶음**
  - 발판은 제자리에 둔다.
  - 나머지는 높이 차례로 35 mm 씩 올린다.
  - J1 은 J1 모듈이 올라간 만큼 같이 올린다.
- **관절 안 작은 부품**: 모두 모듈에서 바깥쪽으로 뺀다.

  | 부품 | 방향 | 거리 |
  |---|---|---|
  | 끝 덮개 | 그 관절 축 | 45 mm × F |
  | 끝 덮개 사선 | 그 관절 축 | 70 mm × F |
  | 띠 고리 | 그 관절 축 | 28 mm × F |
  | 허브 덮개 | J2 · J3 · J5 축 | 40 mm × F |
  | 허브 덮개 사선 | J2 · J3 · J5 축 | 62 mm × F |
  | 로고 글자 | 위팔 면에 수직 | 28 mm × F |
  | 로고 사선 | 위팔 면에 수직 | 40 mm × F |
  | 공구 돌기 | J6 축 | 30 mm × F |

- **그리퍼**: 그리퍼 좌표 G 에서 옮긴다.
  - 그리퍼 전체를 +z(J6 축 바깥)로 70 mm × F 옮긴다.
  - 서보는 −y 로 48, 피니언은 +y 로 42 옮긴다.
  - 턱은 ±x 로 28, +z 로 38 옮긴다.
  - 손끝 덮개는 ±x 로 28, +z 로 78 옮긴다.
- **점선**: 관절 축의 중심선이다. 대시 9 mm · 틈 5 mm · 굵기 Ø1.6 이다. 길이는 그 축에 놓인 부품들의 축 방향 범위에 20 mm 씩을 더한 만큼이다.
- **샷 두 개**: 값은 `parameters.json` 에 있다.

  | 샷 | 자세 | 바라보는 방향 | F | 채움 |
  |---|---|---|---|---|
  | home | `home` | (−1, −1.05, 0.62) | 1.3 | 0.86 |
  | straight | `zero` | (0.7, −1, 0.8) | 1.6 | 0.80 |

  두 샷 모두 Cycles 64 샘플, 2400 × 1600 이다.

## 검사 — 그림이 무엇을 그렸는지만 본다

검사기는 커밋된 산출과 지금의 입력 파일을 읽어서 스스로 계산한다.

- **C1 장면 무변경**: 리포트 둘 다 `blend_unchanged` 가 참이어야 한다. 리포트의 장면 sha256 은 지금 장면 파일의 sha256 과 같아야 한다.
- **C2 번호 완전성**
  - 렌더한 부품 개체(점선 제외 58 개)는 저마다 `GROUPS` 의 번호 하나에만 들어가야 한다. 빠진 것도, 두 번 든 것도 없어야 한다.
  - 번호는 43 개다.
  - 번호마다 장면에 실제로 있는 개체를 가리켜야 한다.
- **C3 산출 지문**: manifest 의 산출 sha256 이 지금 파일과 같아야 한다.
- **C4 입력 지문**: manifest 의 입력 sha256(장면 · MP9 행렬 · 그리퍼 STL · 매개변수 · 운동학 · 자세 · 스크립트)이 지금 파일과 같아야 한다. 다르면 그림이 낡은 것이다.
- **C5 벌림 기록**: 리포트마다 다음이 있어야 한다.
  - 관절 6 개를 옮긴 양
  - 옮긴 양이 0 이 아닌 관절 안 · 바닥 부품
  - 축 점선 0 개 초과
  - 자세가 `parameters.json` 과 같음
- **양성 대조** `run_controls.py`: 메모리 안에서 다음 다섯 가지를 하나씩 일부러 망가뜨린다. 해당 검사가 거짓이 되는지 본다. 저장소 파일은 바꾸지 않는다.
  - `GROUPS` 에서 번호 하나 빼기
  - 개체 하나를 두 번호에 넣기
  - 산출 sha 한 글자 바꾸기
  - 장면 sha 바꾸기
  - 관절 옮긴 양 하나 지우기

## 하지 않는 것

- 다음 파일은 읽기만 한다.
  - v1 · v2 · v3(장면 포함)
  - MP6
  - 그리퍼 KG1
  - MP9 조립 파일
  - MP10 J5 실부품
  - 끼움 원장 · 모터 원장
- 관절 거리 · URDF · 펌웨어 · 배선 문서는 건드리지 않는다.
- 출력 · 구매 · 새 설치는 하지 않는다.
- 공유 문서(HANDOFF · SESSION_HANDOFF · CODING_RULES)에는 덧붙이기만 한다.
- 커밋은 `git commit --only` 로 내 경로만 한다. push 는 하지 않는다.

## 소유 경로

- `src/cad/arm-v3-kg1-exploded/`
- `models/arm-v3-kg1-exploded/`
- `.dev/mp11-evidence/`
- 이 계획 문서(061)
- `.dev/HANDOFF.md` 의 MP11 절 · `.dev/SESSION_HANDOFF.md` 의 MP11 줄 · `.dev/CODING_RULES.md` 의 MP11 단락(셋 다 덧붙임)
