WINNAKEN/robot-arm-lab/docs/design/086-can-arrival-readonly-preparation.md

> 개발 이력: 작성 당시의 계획·결과입니다. 현재 상태는 [STATUS](../STATUS.md)를 확인하세요. 원시 로그와 로컬 경로 일부는 공개본에서 제외했습니다.

# 086 — CAN 수령 체크리스트와 무운전 시험 계획

2026-10-30 · 문서 준비 단위. 사용자 요청: Isaac 노트북 없이 CAN 도착 전 준비를 계속하고, 다음 주 모듈 수령 시 사용할 체크리스트·시험 순서를 정리한다. 실물 보정·모터 운전은 제외한다.

이번 산출물은 `docs/specs/can-arrival-readonly-checklist.md`와 이전 사용자 엑셀 선호에 따른 `outputs/01a16115-2f16-75c2-b397-2c7acca28c43/can-arrival-v1/CAN_수령체크리스트.xlsx`다. 현재 펌웨어·매뉴얼·Waveshare 공식 설명과 보존된 회로 자료를 대조한다. 문서 대조 결과와 엑셀 생성 보조물은 `.dev/can-arrival-prep/`에 출처/해시와 함께 보존한다. 제품 코드·승인 플래그·BOM·CAD/URDF·기존 시험 원장·시뮬레이션 파일은 변경하지 않는다. 설치·플래시·장치 연결·송신·전원 인가·재부팅·구매·Isaac 재접속은 실행하지 않는다.

단계는 지금 준비 → 수령품 식별 → 무전원 배선/종단 → 드라이브와 분리한 보드 단독 확인 → 조건 충족 뒤 읽기 전용 단일 드라이브 A/B 개별 확인 → 서로 다른 ID가 확인된 경우에만 두 드라이브 함께 확인으로 나눈다. CAN 부품 수령 자체를 실물 시험 PASS로 처리하지 않는다. 이번 사용자 요청은 시험 계획 작성이며 해당 실물 단계를 지금 수행하는 지시는 아니다.

명령표는 현재 codec에서 허용하는 ID1/2와 읽기 코드31/32/F1/3A만 담는다. 계산된 checksum과 수신 DLC를 실제 C++ 고정 시험 자료/매뉴얼과 대조한다. 설정 쓰기·F3 토크 변경·F7·이동·보정·홈/제로·공장초기화는 전송 대상에서 제외한다. F3 같은 바이트가 checksum 위치에 나타날 수 있으므로 금지 판정은 명령 첫 바이트 기준임을 명시한다.

선택 Waveshare는 절연 CAN H/L 단자이므로 별도 기준선이나 차폐를 전원−/SH GND에 임의 연결하지 않는다. RVSP4core의 같은 꼬임쌍만 H/L로 식별하고 남은 심·차폐는 초기 짧은 벤치에서 각각 절연한다. MKS 급전 귀환은 별개다. 기존003의 이 배선 정정은 유지하되 옛CF8883m/미구현 문구·운전 명령 순서는 이번 체크리스트에 가져오지 않는다.

현재 기본 app은 장치 비활성이고 준비 실행부도 승인false다. 기존 유지보수/운전 경로는 읽기 전용 도구가 아니다. 따라서 수령 직후 가능한 무전원/보드 단독 확인과, 전용 읽기 실행부·전원 시 자동 동작 검토가 필요한 실제 CAN 확인 사이에 명확한 보류 조건을 둔다. 미확정 펌웨어/핀/bitrate/ID를 가정으로 통과시키지 않는다.

완료 판정은 문서·프레임 산술·출처 대조까지이며 실제 CAN·정지·토크/운전·물리 시간 검증은 NOT_RUN을 유지한다. 이번은 구현을 하지 않는 메소드/시험계획 문서 단위로, 기존 코딩 단위085의 시간/실행/검토 예산을 재사용하지 않는다.
