WINNAKEN/robot-arm-lab/docs/design/146-public-github-release.md

> 개발 이력: 작성 당시의 계획·결과입니다. 현재 상태는 [STATUS](../STATUS.md)를 확인하세요. 원시 로그와 로컬 경로 일부는 공개본에서 제외했습니다.

# 146 공개 GitHub 초판

2026-11-13 KST. 사용자가 WINNAKEN 계정의 공개 저장소 생성, 지금까지 작성한 코드·문서 업로드, 개발 과정 기록을 명시적으로 요청했다.

## 범위

- 원본 작업 폴더와 188개 로컬 커밋은 보존한다. 약 2.7GiB의 비공개 실행 이력은 push하지 않는다.
- 별도 `C:/projects/robot-arm-lab-public` 공개 배포 폴더에 현재 자체 소스, 작성 문서, URDF v4 자산을 검증 후 복사한다. 작업 트리에는 미커밋인 최신 reader144도 포함한다.
- README, 현재 검증 상태, 개발 일지, 기여/실행 안내, 외부 출처와 공개 범위 설명을 추가한다. 역사 계획은 당시의 계획/결과이며 현재 상태로 오인하지 않도록 표시한다.
- 원본 ESP/flash/NVS 덤프, 인증정보, 주문/메일/사진 원본, 로컬 사용자·네트워크 식별정보, SDK/의존성/빌드, raw 실행·검수 로그, 외부 패키지/상용·권한 불명 자료와 과거 Git 객체는 제외한다.
- 공개본 텍스트의 개인 경로·네트워크 endpoint는 환경변수/명확한 예시 값으로 바꾸되, 소스 동작·판정 기준·기구 파라미터는 바꾸지 않는다. 변경 경로/유형과 파일 해시 목록을 기록한다.
- 새 재사용 라이선스를 임의 부여하지 않는다. 외부 라이선스/출처는 별도 문서에 유지한다.

## 검증과 게시

1. L2는 공개 필터/식별정보 제거/원본 보존/재현성의 논리 결함을 검토한다.
2. 내보내기와 별도 공개 검사로 금지 경로·바이너리·토큰·실제 네트워크 endpoint·파일 크기·URDF mesh 참조를 확인한다. 금지/알 수 없는 바이너리는 실패 처리한다.
3. 현재 reader144 HOST 회귀는 실제 CAN/USB 없이 실행한다. 공개 조회 성공 기록은 ID1/500K/0RPM 한 번의 응답만 뜻하며 실제 움직임·정지 기능·원점 검증은 미완료임을 표시한다.
4. 비작성자 L4가 공개 트리와 검사 결과를 실제 읽고 개인정보/외부 권리/허위 수용/누락을 확인한다. PASS 전에는 외부 생성/업로드를 하지 않는다.
5. 승인된 공개 트리만 새 Git history의 main에 커밋하고 `WINNAKEN/robot-arm-lab` public 생성/push한다. CLI 인증 계정과 저장소 부재를 사전 조회했다. force push 없이 원격 visibility/commit/tree를 다시 읽어 완료를 판정한다.
6. 원본에는 공개 경로와 동기화 절차만 인계한다. 원본 history를 public remote로 바로 연결하지 않는다.

## 운용 한도

두 그룹(내보내기·검사, 공개 안내·게시)으로 분리하고 각 M 단위 45분 이내, 종료 정리 300초를 남긴다. 주 검토자 L2/L4 공유 최대45분, L2/L4 각 최대2회다. 표준 외부 호출 경로는 기존 Python lint 결함으로 이번에도 차단됨을 확인했으며, 사용자에게 이전 승인된 동일 계열 비작성자 폴백을 적용한다. 동일 계열 공통 편향은 잔여로 기록한다. 원본 제품 코드·하드웨어·모터 전원·카메라/네트워크 설정은 변경하지 않는다.
