WINNAKEN/robot-arm-lab/docs/specs/gripper-ttl140.html

ROBOT ARM LAB / GRIPPER 140 / 2026-11-11

# J5·J6는 CAN 그리퍼 STS3215는 TTL 버스

사용자가 제시한 상품은 Feetech STS3215 12V·30kg·cm TTL, ST-3215-C018로 식별됩니다. 상품 설명과 제조사 자료를 대조한 결과이며, 실제 받은 서보의 명판·리비전·핀 방향은 아직 확인하지 않았습니다.

그리퍼 신호 S를 CAN H/L 또는 RS485 A/B에 연결하지 않습니다. STS3215는 단일 신호선의 반이중 TTL 디지털 통신이며, 일반 PWM 서보 신호와도 구분합니다. 호환 TTL 버스 인터페이스의 보유 여부·제품명이 확인 대기입니다.

## 권장 첫 시험 구조 — 기능 블록이며 핀 배정·구매 확정이 아닙니다

그림의 USB형 어댑터는 첫 시험 후보입니다. 어댑터가 자동 방향제어와 적절한 신호 레벨을 지원한다면 향후 기존 ESP32의 별도 UART로 통합하는 방법도 검토할 수 있습니다. 제어기를 반드시 두 개 사야 한다는 뜻은 아닙니다. 현재 보드의 CAN/RS485 단자가 TTL 포트를 대신하지 않습니다.

그리퍼 기능 | 연결 준비 원칙
V / Vcc | 확인된 12V형 서보에 맞는 보호된 전원. 24V 직결 금지, USB 5V나 ESP32 3V3를 모터 전원으로 사용하지 않음
G / GND | 서보 전원 귀환 및 선택한 TTL 인터페이스의 기준 GND를 해당 회로대로 연결. CAN 절연 SGND와 혼용하지 않음
S / Signal | 단일 반이중 TTL 버스 데이터. 방향제어·송신 해제·수신 신호레벨을 확인한 인터페이스를 사용. ESP32 GPIO 직결 배선은 미승인

단자 이름 기준이며 커넥터를 어느 쪽에서 보는지와 선색으로 핀 순서를 추측하지 않습니다. 제조사 C018 자료는 신호 high2–5V를 기재하므로 ESP32 3.3V 입출력과의 호환을 별도 확인해야 합니다.

## 소프트웨어와 기구 시험에서 바뀌는 점

- 기존 MKS CAN 명령과138의 RS485 FA/FB 프레임을 그리퍼에 쓰지 않습니다. STS3215 전용 프로토콜/코드가 필요하며 현재 저장소의 실제 그리퍼 제어 경로에는 아직 통합하지 않았습니다.
- 어댑터와 현품 확인 후 ID·모드·전압·현재 위치 읽기부터 준비합니다. 조립된 그리퍼를 임의로180° 중립·끝각·연속회전 모드로 보내거나 자동 영점 보정하지 않습니다. 개폐 가능한 각도와 방향은 현물에서 별도 확인합니다.
- 30kg·cm는 공칭12V에서의 stall torque 표기입니다. 서보축 토크를 손끝 파지력이나 연속 허용 하중으로 그대로 쓰지 않습니다. 제조사 C018의 stall current2.7A도 보호/전원 선정의 참고값이며 실제 공급 정격 확정이 아닙니다.

근거: Feetech C018 제조사 사양서 p3·4·8 (https://cdn.robotshop.com/media/F/Fit/RB-Fit-155/pdf/feetech_12v_30kg_cm_magnetic_encoding_servo_sts321_specification_pdf.pdf) / Waveshare ST3215 공식 자료 (https://docs.waveshare.com/ST3215_Servo) / 호환 서보 제어보드와 전압 일치 원칙 (https://docs.waveshare.com/Servo_Driver_with_ESP32). 7.4V형 등 다른 파생 모델의 수치를 혼용하지 않습니다.

준비용 혼합 버스 안내 · TTL 어댑터/현품/전원 확인 대기 · 실제 연결·급전·통신·플래시·구동 NOT_RUN
