WINNAKEN/robot-arm-lab/docs/brand/README.md

# 디자인 컨셉 — KMJH (개인 프로젝트 · 모델링 색 · 디자인 기준)

사용자(2026-10-26): 「우리 모델링을 조금 수정해야하는게 색상을 주황색보다는 흰 청 회로 맞추면좋겟는데 내 개인 프로젝트니깐 위의 컨셉에 맞추는거지 당장은
중요한거아니고 나중에 다시 모델링하거나 할떄 컨셉으로 유지하기위한 (개인프로젝트) 색상이나 디자인 을 통일하고싶어서 그래」.

**지금 있는 모델은 고치지 않는다**(「당장은 중요한거아니고」). 다음에 외장을 다시 모델링하거나 새 부품을 만들 때 이 기준을 따른다.

공개본에는 로고·팔레트 컨셉 그림만 포함합니다. 연락처·명함·QR이 들어간 적용 예시 원본은 로컬에만 보존하고 공개하지 않습니다.
- `kmjh-01-identity.webp` — 「KMJH / BRAND IDENTITY EXPLORATION」: 가로 로고 · 모노그램 · 로고 변형 셋 · 색 · 스타일 단서 · 적용 예
- 적용 예시 이미지 — 비공개 원본으로만 보존하며 이 공개본에는 포함하지 않음

## 색 (그림의 표기 그대로)

| 이름 | 값 | 그림에 적힌 뜻 |
|---|---|---|
| Deep Navy | `#0B2545` | STABILITY · EXPERTISE · TECHNOLOGY |
| Cool Gray | `#6B7280` | BALANCE · VERSATILITY · ENGINEERING |
| Mint Accent | `#34D399` | INNOVATION · PROGRESS · POSITIVITY |
| White | `#FFFFFF` | CLARITY · SIMPLICITY · FOCUS |

사용자 말의 주색 = **흰 · 청(남색) · 회**. 민트는 그림에서 로고 사선 · 짧은 강조 띠에만 쓰인 강조색이다.

## 모델링에 옮기는 법 (작성자 제안 — 사용자 확정 전)

| 자리 | 지금(v2 외장 · 계획 014) | 컨셉 적용 제안 |
|---|---|---|
| 링크 셸 · 베이스 하우징 등 큰 외장 | 흰 몸체 | **흰색** 그대로 |
| 관절 색 링 · 끝 덮개 | 주황 | **진한 남색(Deep Navy)** |
| 감속기 하우징 · 브래킷 · 속 기능 부품 | (기능 부품은 PLA 아무 색 — 지금 시험은 초록) | **회색(Cool Gray)** 또는 남색 — 시험 출력은 색을 따지지 않는다 |
| 강조 | 없음 | **민트(Mint Accent)** 를 작은 면에만: 덮개의 45° 사선 띠 · 표시선 · 로고 사선 |
| 로고 | 없음 | 모노그램(K · M · J · H 를 엮은 각진 기호) 또는 가로 로고를 베이스 옆면 · 이름판에 양각 / 음각 · 다른 색 판 끼움 |

형태 단서(그림의 「STYLE CUES」 = Precision · Motion · Trust · Modular 와 로고 모양에서 읽은 것 — 제안):
- 각진 면 + **45° 사선**(로고 K 의 민트 사선 · 모노그램의 꺾인 획) — 둥근 곡면 위주보다 평평한 면과 사선 모따기.
- 모듈 반복 — 관절마다 같은 덮개 · 같은 색 띠 규칙.
- 장비 이름판 예(그림 03): 외장 한 면에 이름판 자리(모델 · 일련번호 · 전압 · 가반)를 두는 것도 가능.

## 색 · 재료로 옮길 때

- H2D AMS 로 여러 색을 쓸 수 있다. 실제 필라멘트 색 이름 · 값은 **그때 색상표로 골라** 이 표에 적는다(아직 고르지 않음 · 화면 색 값과 필라멘트 색은 같지 않다).
- 구매는 `docs/BOM.md` 의 M03(외장 PLA — 흰 · 남 · 회 + 민트 소량 · 「나중」).
- 끼움 보정값은 재료 · 색이 바뀌면 다시 잴 수 있다(`src/cad/calibration/print-fits.json` 은 Bambu PLA Basic 기준) — 같은 PLA Basic 의 다른 색이면 그대로 써 보고 맞춤 확인 판으로 확인.

## 바뀐 기록

| 날짜 | 내용 |
|---|---|
| 2026-10-26 | 처음 만듦 — 사용자 그림 두 장 · 말 원문 · 색 넷(그림 표기) · 모델링 적용 제안 |
