WINNAKEN/robot-arm-lab/src/simulation/provider_session/README.md

# 055 provider-bound SDK session

새 사용자 권한의 audit→diagnosis→conditional new-process connection, 각1회. Torch/CUDA 원자료를 guard 전에 기록하고 원본 report로 root가 profile을 선택한다. 기존053/054 원장·source·실패는 보존한다. install/reboot/hardware/training/ring work 없음.

launch.ps1 -Role test; -Role prepare -Purpose installation_audit|provider_diagnosis|provider_connection; -Role run -RunDir <prepared absolute path>; -Role verify -RunDir <path>. 최종 결과는 outputs/isaac-provider-v1/HANDOFF.md와delivery.json.
