WINNAKEN/robot-arm-lab/docs/design/006-offline-and-hardware-acceptance-cases.md

> 개발 이력: 작성 당시의 계획·결과입니다. 현재 상태는 [STATUS](../STATUS.md)를 확인하세요. 원시 로그와 로컬 경로 일부는 공개본에서 제외했습니다.

# ESP32 2축 제어 검증 시나리오

2026-10-22 · 설계004/화면005의 수용 시나리오 · **전 항목 PLANNED / 실행 전**

이 문서는 시험 입력과 기대 결과를 준비한 것이다. 테스트 코드 작성·실행, ESP32 빌드·실물 구동 결과가 아니다. 가짜 시계·가짜 CAN transport를 주입하는 호스트 시험과 실제 장치 시험을 구분한다. 정본 계약이 바뀌면 해당 시나리오도 같은 변경으로 갱신한다.

## 1. 부품 없이 구현 후 실행할 시험

| ID | 입력 / 조건 | 관측해야 할 결과 |
|---|---|---|
| O01 | 가이드003의 ID1/2 정상 프레임·signed48 음수·signed16 속도 | 바이트·DLC·checksum 정확, 위치 부호/단위 맞음. 기존88프레임은 출처 확인된 골든 입력으로 사용 |
| O02 | 잘못된 DLC/checksum/명령/ID/RTR/확장프레임, 미지원 code FF FF | 정상 상태를 갱신하지 않음, 오류 원인 기록. 유효성 없는 위치를0으로 표시하지 않음 |
| O03 | 2개의 WS 세션이 동시에 acquire | 한 세션만 소유, 다른 세션 관찰 유지. 이 때문에 CAN 이동이 발생하지 않음 |
| O04 | READY에서 arm, F3ACK만 수신하고3A응답 없음 | ARMED 금지, 제한시간 후 STOPPING. ACK만으로 허가완료 표시 금지 |
| O05 | 정상100펄스 요청 뒤 같은 seq/request_id 재전송 | FD 송신1회, 중복 요청은 결과 재표시/거절. 캐시 eviction 뒤에도 실행안됨 |
| O06 | 같은 ticket에 새seq/request_id 사용 | ticket 1회성으로 두 번째 실행 거절 |
| O07 | 만료 ticket, 이전boot/session/lease, 상태 revision 변경 | CAN 전송0회. 모바일시계 조작으로 TTL 늘어나지 않음 |
| O08 | 입력 큐에 있는 move 직후 stop, CAN 송신 직전 epoch변경 | 아직 송신하지 않은move폐기, STOP우선. 이미송신된프레임은별도로기록 |
| O09 | 일반 큐8개 포화 뒤 stop | stop 래치가 처리됨. 추가move거절,정지누락없음 |
| O10 | FD TX실패/ACK누락/지연/중복완료 | FD 자동 재송신0회,STOPPING. 과거완료응답하나로다음이동허용안됨 |
| O11 | MOVING중 사용자keepalive중단, CAN RX정상 | 서버lease만료로STOPPING. WS연결만남아도허가연장안됨 |
| O12 | 화면hidden/WSdisconnect/close누락 | 최선의종료알림과별개서버시계만으로만료. 재접속은관찰,이전요청복원없음 |
| O13 | STOPPING 진입 후 전송목록 전체 기록 | 각축F7최대1회 외정상조회/설정없음. TX로heartbeat를무기한갱신하지않음 |
| O14 | F7ACK누락 또는 TX종료시점불명확 | 타이머만료로성공처리안됨,FAULT·물리차단안내. 자동조회재개없음 |
| O15 | F7ACK성공 뒤 관측속도/위치 불안정 | STOPPED_RECHECK진입금지,FAULT. 정지응답과실제관측분리 |
| O16 | bus-off 진입,복구 이벤트,수동재점검 | 일반TX/허가폐기,복구만으로CANmove전송안됨. 재점검상태로만진입 |
| O17 | MCU재부팅에NVS설정은남고RAM상태소멸 | 새boot,기존lease/ticket/arm/pending소멸. 설정이남아도이동0회 |
| O18 | 축1허가상태에서축2보기전환/축2이동요청 | 허가자동이전없음,축2요청거절. 전역동시이동없음 |
| O19 | 관찰세션stop,타출처/잘못된sessionstop | 유효관찰stop허용,타출처·잘못된세션거절. 조작권없다고정상stop거절안됨 |
| O20 | JSON초과길이/중복키/NaN상당값/잘못된타입/unknown op | 파싱·범위검증거절,부분실행0회. 오류로서버재시작안됨 |
| O21 | 로그256건초과/전송상태메시지지연 | drop수표시,제어루프안막힘. 오래된측정은age/invalid표시 |
| O22 | stop·토크해제·오류시각 동시 이벤트 | 정의된정지우선순위적용,이동중F3disable로바뀌지않음 |
| O23 | active_axes=[1] 또는[2]의 정상1축, [1,2]에서1축누락 | 명시한1축은READY가능,2축누락은차단. 무응답축자동제외없음 |
| O24 | enable=1 부팅/정지뒤enable유지, 유지보수제어권 요청 | 정지·무부하확인뒤disable/3A=0으로READY진입. maintenance arm/move거절 |
| O25 | 유지보수disableACK만도착,3A누락 또는실제MOVING관측 | READY승격금지,움직이는축토크해제금지. FAULT진단조건우회없음 |
| O26 | 이전epoch/timeout거래/중복읽기응답, pending없는정상checksum묶음 | raw로그만,valid/age갱신안됨. Rmax미확정프로필은arm차단 |
| O27 | STOPPING/FAULT에stop·stale·lease만료를반복주입 | episode/epoch/축별F7시도/절대기한고정. F7재전송과기한연장없음 |
| O28 | fake transport HW에FD대기중 STOP→정상격리→재설치/복구 | 옛inflight/알림폐기,이전FD추가방출없음. F7전용새세대또는FAULT만 |
| O29 | stop/uninstall/recovery API실패 또는 결과불명확 | barrier완료거짓표시없음,새송신호출0회,FAULT·물리차단안내. 하드웨어실패상태선로무송신보장은아님 |
| O30 | FD시작ACK뒤정상조회·중복시작ACK가계속오지만완료없음 | 최초TX기준전체이동deadline2000ms후STOPPING,조회로기한연장안됨 |
| O31 | 전체deadline과완료/stop동시도착 | 정지/기한만료우선,이전이동재시작없음. 정확한경계시각규칙대로판정 |
| O32 | keepalive의오래된seq/이전lease재전송 | 제어권만료시각갱신안됨,정상새keepalive만유효 |

각 시험은 초기 상태, 가짜 단조 시각, 입력 이벤트 순서, 예상 CAN TX 목록, 최종 상태, 화면 이벤트를 명시한 fixture로 만든다. 구현 함수의 내부 분기 수를 그대로 기대값으로 삼지 않는다. 경계값은 만료 직전/정각/직후를 포함한다. 유효하지 않은 프레임도 수신됐다는 이유로 last_valid_rx를 갱신하지 않는다.

Rmax 전제가 성립하지 않아 오래된 응답이 새거래의 정상창 안에 들어오는 경우, CAN에 요청nonce가 없어 원리적으로 구별 불가능할 수 있다. O26을 이 반례까지 해결한 시험으로 확대하지 않는다. 그런 장치/전제에서는 운전 프로필을 승인할 수 없으며 응답지연·RX서비스 상한은 별도 실물H11의 수용 전제다. host fixture의epoch태그만으로 선로프레임에없는식별자를발명하지않는다.

## 2. 화면 시안 검토와 실제 화면 시험의 차이

| ID | 이번 디자인 시안에서 볼 것 | 실제 웹 구현 때 추가할 것 |
|---|---|---|
| U01 | 320/390/430/900px 가로넘침·정지바 위치 | 실제 휴대폰 회전/키보드/주소창 변동·터치 목표 확인 |
| U02 | 대기/허가/이동/끊김/오류 문구 | 실제서버 snapshot·age로 상태결정,목표값을측정값으로표시하지않음 |
| U03 | 탭선택과축별허가 분리 | 실제모바일동시접속/제어권경합,다른탭의stop |
| U04 | 상단 '실제 장치 미연결',제어버튼disabled,외부요청0 | fake/real 빌드·주소구분,실제앱에모의데이터유입차단 |
| U05 | 포커스·명확한상태텍스트·색에의존하지않음 | 화면읽기기·전송지연·WS실패·백그라운드에서세션만료 |

이번 시안의 UI 렌더 검사는 `.dev/firmware-design-evidence/ui/`에 따로 기록한다. 실제 웹 구현의 U01~U05가 통과한 것으로 합치지 않는다.

## 3. 부품 도착 뒤 별도로 시험할 것

| ID | 실물 조건 / 시험 | 통과 증거 |
|---|---|---|
| H01 | 실제 PCB·단자·극성·종단·모터고정·퓨즈·차단 회로 | 가이드003의수령표/측정/사진,무전원검사 |
| H02 | FW버전·Mode·MStep·전류·heartbeat지원/읽기 | 실제raw RX와About일치,지원되지않으면운전gate닫힘 |
| H03 | USB전용업로드→USB분리→DC독립운전 | 동시급전없음,실제빌드/핀/보드재부팅기록 |
| H04 | 읽기→정지상태차단→허가→100펄스1회 | 명령한축만반응,위치/속도/발열/전류/정지관측 |
| H05 | 제한된이동중FD정지/F7·물리차단 각각 | 신호전이동중이었음을확인,정지응답과정지시간별도기록 |
| H06 | 별도확정한긴저속조건에서모든대상TX중단 | heartbeat만료전이동중,실제급정지관측. 100펄스프리셋으로대체불가 |
| H07 | 휴대폰화면잠금/탭전환/AP이탈 | ESP32세션만료정지,복귀시자동허가/재이동없음 |
| H08 | CAN오류/bus-off·큐잔류·재기동 | 버스복구후이전move안나감,보호동작·전원상태관측 |
| H09 | STOP중F7/조회중단·복귀 절차 | 실제trace의TX중단과MKS보호타이머동작,재점검전이동없음 |
| H10 | 독립운전2축반복조회·모바일2대 | 메모리/지연/오류/발열·전압기록,정지경로유지 |
| H11 | FW별응답순서·최대조회지연·RX서비스/backlog·중복/timeout관측 | Rmax·RX서비스상한·코드별조회간격전제검증. 불명확하면프로필미승인/이동불허 |

H05~H09의 조작은 실제 위험과 정지 수단을 검토한 시험 조건 확정 이후 수행한다. 가짜 CAN시험으로 전기적 노이즈·정지거리·모터회생·퓨즈차단협조를 증명하지 않는다. 새로운전원/모터/기구를사용하면해당실물조건을재검증한다.

## 4. 기록 형식

한 시험마다 case_id, 문서/프로필/빌드 식별, 입력 fixture, 실제 TX/RX, 기대/관측 상태, 오류 원인, PASS/FAIL/NOT_RUN, 근거 파일을 남긴다. 실행하지 않은 항목은 PASS로 바꾸지 않는다. 현재 O/H 시험은 모두 PLANNED이며 UI 디자인 렌더 결과만 별도 증거에 존재할 수 있다.
