WINNAKEN/robot-arm-lab/docs/design/015-normal-can-stop-handoff.md

> 개발 이력: 작성 당시의 계획·결과입니다. 현재 상태는 [STATUS](../STATUS.md)를 확인하세요. 원시 로그와 로컬 경로 일부는 공개본에서 제외했습니다.

# ST3-2 — normal CAN bench actor and stop handoff

2026-10-23. L2R2 PASS7MET/0UNMET; implementation host snapshot prepared, L4 pending. Definitive startup/timing and terminal composition clarifications below override earlier shorthand. Budget L2/L4 each2 rounds. Existing013 gate,007/008/StopLink and model files remain immutable. Own only this plan, new robot_run component/tests/run/evidence build. No app wiring, target SDK/hardware/network/purchases. Constructor does no I/O. Standalone C++17 fixed storage, one serialized task, noncopyable; tests link real gate/codec/StopLink/StopCoordinator against fake CanPort.

## Scope and trust

One startup lifetime, one axis or two([1],[2],[1,2]), single fixed100pulse FD at a time, terminal stop no restart. F3 enable/disable, heartbeat setting/readback and maintenance are excluded. Immutable RunProfile embeds gate Config and StopProfile; axes/count must match, heartbeat1000 readback/response/position tolerance approvals default false. Added normal_profile_approved defaults false, validates nonzero profile/boot and bounded tolerance. This is an integration harness for already-enabled, firmware-verified bench fixtures; it cannot turn a newly delivered disabled driver into ARMED. No raw-frame public sending. No user-supplied snapshot/proof/approval request fields; profile attestations supplied trusted startup by future maintenance supervisor. Runtime packet Origin/JSON/sessionauth remain future adapters.

## State machine

Idle → begin(profile approved) → Checking(reset_and_start actual call) → Ready after all active-axis post-reset correlated valid reads and stopped proof → AwaitStart(FD accepted by SDK but TX not yet confirmed) → Moving(FD TX success then status1 start) → Completing(status2 after start, subsequent fresh proof) → Ready with reservation cleared and permit revoked. Any userstop/lease expiry/clock/service/transport/health/read/FD timeout → Stopping → StoppedRecheck or Fault. Unapproved profile begin→Fault with NO port reset/submit. Every stop/fault is terminal; repeated begin/stop cannot restart or extend original stop timestamp. Ready may be invalid/Checking-like before stopped proof; gate acquire denied until fresh proof.

Actor owns real ControlGate and unmodified StopLink referencing same CanPort, but state selects exactly one transport owner. Public begin/poll/open_session/request/close_session serialize; nonpoll methods never do normal I/O except immediate stop handoff when gate stops. Caller services poll<10ms. Gate snapshots are actor-derived only. Gate requests call advance clock/health staleness first; observer Stop and gate expiry invoke handoff before new normal output. Authenticated Stop ignores ownership but unknown session/boot remains denied in gate. Actor fault separately latches first reason and reports snapshot fault; web cannot clear it.

## Normal traffic and freshness

All absolute uint64 times use checked addition; now>=deadline expires first, clock reversal/service gap>=10ms or processing duration>=10ms faults, error evidence before completions/RX. Immutable active topology. Only one inflight TX plus one pending read at a time, no FIFO or retries. Read codes F1/31/32/3A; cycle across every active axis, one scheduled request no sooner than20ms after last submit, and sameaxis+code only after last confirmedTX+140ms (Rmax100 +service10 +margin20, strict>130). If blocked do not create delayed queue; wait while checking existing deadlines. Response accepted only after matching actual TX completion, matchingaxis/code, dequeue>=confirmedTX and dequeuetime/currentprocessing before response deadline TX+100, age<10ms. No backlog allowed before starting any command. Early, unsolicited, duplicate and malformed RX logged bounded32ring and ignored for proof; pending timeouts stop. Unexpected FD stale/duplicate notifications do not advance reads or extend deadlines. RX batch max16, any remaining backlog or error counters/fatal/unknownalerts →stop/fault. TxSuccess plus TxIdle not required for TXsuccess; TxIdle alone/emptyalerts nevercompletion, conflicting TxSuccess|TxFailed or terminalwithoutinflight or tx_pending nonzero →fault. Submission acceptance never TXsuccess; completion at>=submit+50 faults. Health checked before/after API and after finalRX, counter/state changes failclosed. CAN-ID above0x7FF rejected before narrowing, flags/DLC/checksum via realcodec.

Samples store valid flag/value/confirmedTX/dequeue timestamps peraxis/code. Startup has NO valid samples. All required activeaxis samples fresh age<400ms; missing during Checking denies gate permits (not fake0), but after first Ready loss/missing/stale →stop. Observed enable must==1 for all active axes in this alreadyenabled fixture profile. F1==1, speed==0 and3position samples with TXspacing>=140ms and max-min<=approved tolerance form stopped proof; all3positions must age<400ms (scheduler supports fast fixtures, slow valid responses may conservatively neverReady). Initial checking hard deadline2000ms and no automatic axis exclusion. Idle unexpectedmotion denies readiness; once permit/reservation exists, otheraxis moving or healthloss stop. During selectedaxis move, expected moving is represented even before fresh movementread so gate cannot grantoverlap. No moving otheraxis tolerated.

## Permit window and movement

013 revokes permits on every new snapshot revision. To preserve its contract, Ready actor may issue fresh observation snapshots until gate arm exists; then it pauses normal read submission for the bounded arm/ticket window (no outstanding read may exist at Arm/Ticket). Existing samples keep their timestamps, not refreshed artificially. Independent age>=400 revokes/stops before gate move/take, even though ticketTTL500/lease800. Arm denial when read pending is Busy; caller explicitly retries with fresh seq, no queued retry. Snapshot stays fixed only while valid/healthy; stop/error/stale publishes revision then hands off. Keepalive can renew lease but cannot refresh observation ages. This pre-dispatch hold is <400ms, under heartbeat1000; actual permit latency not guaranteed. Takeintent at latest port time and then validate intent boot/session/lease/revision/direction/fixedpreset +now<dispatch_before immediately before submit; recheck aftersubmit, late API failure closes/handoffs and neverreports unsent cancellation. Only actualcodec build_move100 used, FD sent once. No replay/resend on missing ACK.

TXconfirmed FD starts absolute movementdeadline+2000ms and first FD response deadline+200ms. FD value1=start beforedeadline required; value2 complete only after value1, any0/3/5 or outoforder2 stops. Duplicate1 does not extend deadline. CompletionFD2 alone is not complete. Invalidate all positional stopped-proof history at FDsubmission. Completion requires subsequent correlated reads TXafterFD2 for F1/32/3A and3position samples, expected signed motor position change consistent with100pulse direction and approved profile counts-per100pulse/tolerance; counts-per100pulse startup profile required nonzero, no CAD/gear ratio assumptions. Overflow-safe signed delta comparison. FDstart neednotemitmoving sensorinstant; reservation alreadyblocks. Stopped proof beforeFD2 or position delta0 cannot satisfy. On proof publish newrevision stoppedready and call gate.complete matchingtakenintent. Gate failure triggersstop; completiondeadline neverextended bynewRX. Resume normalchecking after successfulcompletion with fresh explicit arm required. Does not claim device exactly-once/noncereplayprotection or torque control.
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
