WINNAKEN/robot-arm-lab/docs/design/016-boot-and-torque-supervisor.md

> 개발 이력: 작성 당시의 계획·결과입니다. 현재 상태는 [STATUS](../STATUS.md)를 확인하세요. 원시 로그와 로컬 경로 일부는 공개본에서 제외했습니다.

# ST3-B — boot checks and explicit torque permission

2026-10-23 L2R2 PASS7/0; implementation host snapshot prepared, independent L4 pending. Inserted prerequisite before012 ST3-3 web; does not rename web stage. New-unit budgets L2 max2/L4 max3 declared before work due protocol/config/disable/enable/handoff phases. Author cannot finalreview own code; same-family fallback only if external unavailable, recordNOT_RUN. Own thisplan/newrobot_boot/tests/boot/build evidence; minimal controlled robot_run profile/proof extension and run tests only. App/oldgate/codec/StopLink/SDK/CAD untouched, no
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
