WINNAKEN/robot-arm-lab/docs/brand/kmjh-01-identity.webp

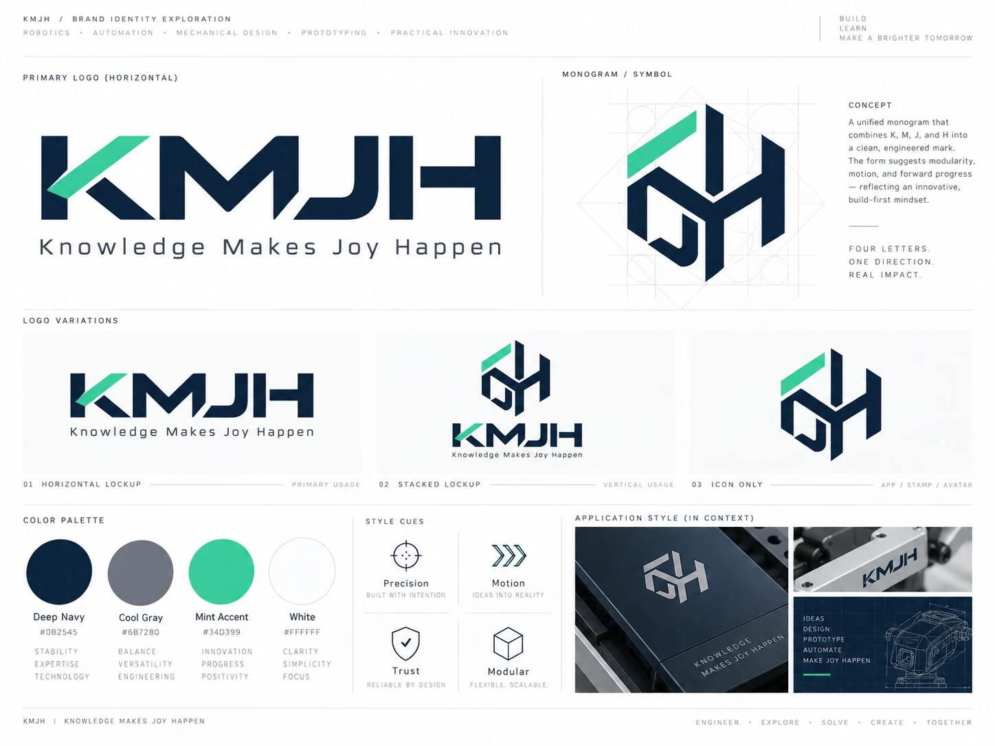
docs/brand/kmjh-01-identity.webp
