WINNAKEN/robot-arm-lab/src/firmware/components/robot_boot/README.md

# ST3-B — boot checks and explicit torque permission (offline)

Supervisor is a single-owner C++17 boot/maintenance layer before BenchRun. App remains inactive. Constructors do no I/O. Existing gate/codec/StopLink/StopCoordinator are unchanged. Actual MKS firmware, electrical ratings, motor calibration, mechanical support and hardware timing are NOT_RUN; approval defaults deny startup before driver API calls.

Manual provenance: received CAN ManualV1.0.9 p32 config00 read/setting-code response/unsupportedFFFF; p35 SR_vFOC82=5, p37 MStep84=16, p40 rate8A=2 andID8Bu16, p41 CanRsp8C=01/01, p44 heartbeat98u32, p71 F3disable/enable, p96 sync4A=0. Strict setting widths, checksum and rawCAN-ID validation; no guessed version40 parser. Reviewed HW/FW identity is a separate trusted approval, not a claimed detected firmware version.

Boot only reads settings and F1/31/32/3A. Initially enabled motors never pass initial ReadyDisabled. Explicit authenticated maintenance authority plus current unloaded operator claim and fresh stopped proof permit DisableAll; each axis requires actual TXcompletion/F3success and later3A0. That explicit maintenance operation then writes heartbeat1000 and obtains new matched config98readback after140ms quarantine from WRITEconfirmedTX; ACK/DLC6echo are not readback. FinishMaintenance releases authority, then new explicit DriveAcquire and EnableSelected permit one F3enable plus new3A1 while every other axis stays0. No automaticenable or FD in Boot. RenewMaintenance renews the current explicitly held authority, including drive phase; it does not renew unloaded claim/config evidence.

Actual strict3-position proof has narrow valid windows. If its history ages out between two UNSENT F3 operations while latest observations remain fresh/healthy, scheduler defers writing and obtains new real samples. It does not refresh timestamps, renew unloaded confirmation, extend400ms observation limits or disable a moving axis. First timing failure at761ms is preserved in build/attempt-4-first-scenarios.log; follow-up ready-after-heartbeat proof failure preserved attempt-5-proof-refresh.log. Latest tests exercise successful deferral with unchanged limits.

Before both actual heartbeat1000 readbacks, stop/fault closes the physical port and reports Fault, torqueunknown/manualpowercut_required, never fabricated stop_verified. After current settings verified, unchanged actual StopLink handles isolation/stop/quiet/diagnostics with original100/600/3600 bounds. Normal faults remain faults even if subsequent software stop verifies. No automatic F3disable as a stop substitute.

Private move-only BootEvidence is minted once after actual protocol sequence and healthyquiescedclose; Boot becomes terminal before Run owns port. It binds exact issuing CanPort object, boot/profile/axis/calibration, authenticated principal,50ms admission cap, current observation age, original800ms authority and earliest real configread+4000 deadline. SingleSelected Run cannot use the legacy seedboolean shortcut. It resets actual port and obtains new samples before ready, requires same principal's fresh explicit normalAcquire, and preserves old authority deadline until then. Observer cannot steal owner; no implicit Arm/ticket/FD. New lease cannot renew borrowed config deadline. This preparation is a **bounded remaining≤4s configuration-attestation window**, not a long-running operational UI; normal runtime configuration refresh is not implemented. Historical heartbeat evidence may support verified stop at age expiry but never renews motion permission.

Validation command: `src/firmware/tests/boot/run.ps1 -Mutations`. Strict C++17 warnings-as-errors: **46 fixtures /7302 assertions PASS**, three compiled runtime mutants killed (F3ACK→disabled, omit other-axis disable, expired capability accepted). Test fixtures are independent setup scenarios; polling/assertion count is not number of separate cases. Real components linked: Supervisor/configcodec/BenchRun/gate/StopLink/StopCoordinator/codec against fake CanPort. Existing legacy `tests/run/run.ps1 -Mutations` remains **51 fixtures/3426 assertions PASS**,2compiled mutants killed, separate logs. No ESP32 SDK rebuild/flash/real port operation.

Executed: default and identity approval0I/O; settings bytes/widths/checksum/unsupported/flags/ID; readonly enabled1 and disabled0 boot; configmismatch; fullF3disableall/98write+read; F3ACK/no3A and unchangedenable; HBACK/echo/no-readback and140ms WRITE quarantine; operator idle4500ms actually refreshes configs; unloadedclaim/no-confirm/expired-confirm; leaseexpiry; observerStop unverified beforeHB; replay; wrongprofile/50ms expired/singleusecap; closefailure; no oldproof after reset; principal mismatch; original authority expires during Checking and after Ready without acquire; exact configharddeadline5103 despite valid normal renewals; [1]/[2]/[1,2] profiles; selectedaxis1/2 endtoend normal FD completion and actual StopLink verification with otheraxis0. ProductionSingleSelected rejects manuallyset legacyseedflag0I/O.

Not individually executed: every setting mismatch permutation, all API failed-return combinations, arbitrary delayed CANnonce-less replay, full overflow/counter exhaustion sweep, all stopeligibility invalidation combinations, physical power-cycle detection, future web session authentication or user wait latency. HardwareIdentity/response/calibration approvals are trusted fixture inputs, not hardware test results. Operator unloaded confirmation is a human claim, not a sensor. New UI namespace routing is an adapter contract, not implemented wire security. No axeswitch/re-enable after terminal; reboot/maintenance/recheck required.

Plan016 L2R2 PASS7/0; L4 pending(max3 predeclared). External different-family review NOT_RUN. Final source/executable hashes and raw failure/mutant logs are under `.dev/boot-torque-evidence/build/`; definitive freeze manifest created after final docs.

## L4 R1 fixes — final R2 snapshot

Four source counterexamples were accepted and corrected. SingleSelected Run known bus error invalidates historical heartbeat premise: real close→Fault/manualcut, no new reset and no verifiedstop. Legacy already-enabled fixture bus behavior remains separately tested; mere config-age timeout may still use historical heartbeat for stop, retaining original Fault.

BootEvidence binds the exact issuing CanPort object's address. Receiver A→differentB rejects and consumes the token before B driver I/O, even when profiles/diagnostics match. The CanPort object must outlive BootEvidence and both actors, and must not be reconstructed at the same address or rebound to another physical bus/device during this lifetime. This pointer lineage is accidental proof-transfer prevention, not hardware attestation or cryptography; physical powercycle/rewiring detection remains unimplemented.

Supervisor has one record_fault(error,time) writer for the first error/time pair and one abort_stop failure path for timing/inner/finalcleanup. Later failures cannot overwrite either half. Qualified-HB Proof fault followed by reset90, outer600 and unhealthyfinalclose retain original Proof/time; operatorStop followed by reset90/outer600 or unhealthyfinalclose records its actual first timing/port failure time. Invalid startup profile also records currentclock rather than assuming0. Existing source only record_fault writes Status.error/fault_at, verified mechanically.

DisableAll legal starts are quiescent NeedsMaintenance/ReadyDisabled only; FinishMaintenance requires quiescent ReadyDisabled. Disabling/Heartbeat/Enabling, in-flightTX, pendingACK/readback and ACK→3A gap returnBusy before any phase mutation. Reentrant fresh sequences cannot reset operation_deadline or reissueF3. Read-only operation_deadline() permits exact regression assertion; authority stays held when a finish request arrives during a real scheduledF3.

Final **46fixtures/7302assertions PASS**,3compiled runtime mutants killed. Legacy51/3426 plus2mutants remainsPASS. R2 intermediate testsetup failures preserved r2-attempt-1/2: new legal operation correctly required currentstability and a new explicit unloadedconfirmation; fixture corrected rather than loosening proof/claim rules. No acceptance-budget extension; L4R2 independent disposition pending. The broad first-fault class has the reviewer's prospective exhaustion threshold; no claim it is independently closed before R2 verdict.

## ST3-C actual per-setting runtime refresh (017; independent L4 pending)

This section supersedes the ST3-B fixed4s operating-window limitation, not its authority/port/torque protections. Actual BootEvidence now carries every active axis's seven actual setting values, confirmed TX and dequeue timestamps. Run validates and copies them, then rereads one entry through its existing sole CAN slot. Each actual entry still expires at dequeue+4000; only its matching successful transaction renews it. Owner lease/normal diagnostics/reset do not renew settings. Runtime emits no settings writes or automatic F3. Historical legacy seed behavior stays separate.

Fast actual Boot→Run cases on one/two axes run12s and refresh every setting at least3 times. Two-axis selected1/2 each execute two actual fixed FD moves after4s and complete using new physical-fixture responses. These are offline fake-port results, not hardware acceptance. Captured known bus faults invalidate historical heartbeat approval before an age/authority expiry can trigger reset-based stop; mismatch/unsupported likewise close unverified/manualcut. Pure age expiry retains the separately reviewed historical-stop policy.

Final C regression: Run51fixtures/3427assertions, Boot46/7292; original2+3 mutants compile and fail. Runtime22/1525994 with3 killed behavioral mutants. A required priority-intersection mutation remains an explicit **coverage/acceptance gap**, with two surviving variants and failed real Arm setup preserved; no claim all017 tests completed. See tests/runtime/README.md and `.dev/runtime-refresh-evidence/build/frozen-manifest.json`. C L4 pending; no app/SDK/phone/hardware execution added here.
### ST3-C R2 validation snapshot (independent L4R2 pending)

Runtime28fixtures/1527570assertions,5 compiled failing behavioral mutants; oldBoot46/7292+3 andRun51/3427+2 pass. Actual wire RX-age observer now kills the original urgent-only priority mutation (bad config dispatch age3402 vs diag250; positive maximum159). Shared production freshness/headroom predicates, used by actual actor, pin4000/400/overflow while real seed/EDF/one-entry nonrenew/late reply/admission traces pin consumer use. PostFD2 real config response cannot replace new positions; completion follows genuine proof515ms later. Exact actorTTL/headroom race is represented by the explicitly reviewer-permitted predicate+consumer alternative, not falsely claimed isolated wire crossing. See tests/runtime/README.md for exact evidence/limits. Historical R1 survivor gap remains in preserved R1 snapshot; current R2 awaits independent disposition.
