WINNAKEN/robot-arm-lab/src/firmware/components/robot_run/README.md

# Normal bench CAN actor — ST3-2

`BenchRun` owns one immutable profile, actual ControlGate, one normal CAN transaction slot and actual StopLink. Single serialized caller, fixed storage, no allocation/network/GPIO/wall clock. Existing codec/gate/StopLink/StopCoordinator are unmodified. No app_main wiring or target rebuild.

This is a **post-maintenance, already-enabled bench integration harness**, not full boot firmware. Every approval defaults false. Trusted seed attests prior maintenance disable plus explicit F3 enable/readback, heartbeat and calibrated motor counts/direction; wire requests cannot supply it. F3/maintenance startup, persistent configuration, SoftAP/web/parser and actual hardware remain NOT_IMPLEMENTED/NOT_RUN. Seed alone grants no movement: fresh correlated F1/31/32/3A and three spaced stable positions must be read through actual fake/real CanPort interface first.

Ready → gate lease/arm/ticket → one fixed100pulse FD → actual TX alert → FDstart1 then completed2 → three fresh post-completed positions and fresh other samples plus calibrated motor count delta → Ready with permit revoked. TX API acceptance, stale stopped state, FD2 or unchanged encoder alone cannot complete. Global TX1/pendingread1, no retries. Axis interleaving schedules 2 axes x4 codes x20ms, same-code160ms, three-position span320ms plus20ms axis offset. One-axis same-code140ms. Slow response can conservatively failfreshness; no throughput guarantee.

Gate revisions invalidate tickets; predispatch arm pauses new reads only while stored samples remain younger than400ms. Lease renewal does not refresh proof. UI must retry Busy with a fresh sequence while a read is in flight. This is a bounded permit window, not cached-ready resurrection. Normal observations invalidate at >=400; poll gap/duration at>=10 fault; read response100, TX50, FDstart200, movement2000 are strict >=expiry. These are software candidate bounds, not physical stop limits.

On stop, normal owner becomes inactive before unchanged StopLink performs real reset/isolation. Original firststop epoch bounds isolation100/preparation600/overall3600 even though inner starts later. Quiet never normalTX. Actor normalfault remains Fault after healthy new-driver stop; independent stop_verified indicates software stopverification only. Terminal gate/actor cannot resume/restart. Late calls or cleanup failure remain Fault; late I/O may already have escaped, no cancellation guarantee.

Host validation uses `src/firmware/tests/run/run.ps1 -Mutations`: actual five implementation units (newactor + existinggate/StopLink/StopCoordinator/codec), strict C++17 warnings as errors. Current51fixtures/3426assertions PASS; each fixture is one scenario with many polling assertions, not3426 independent cases. Two mutants compile0 and fail runtime: SDKaccept treatedTXsuccess, normalread injected duringStopping. Fakeport models realaccept/completion distinction, queued RX and actual reset/close counters. Source/manifest hashes and rawlogs in `.dev/normal-can-evidence/build/`. Initial sandbox compiler objectrename failure preserved; same command formally escalated. Neither fake proof nor compile validates actual MKS firmware/rating, counts-perpulse, replay delay bounds, TWAI on hardware, mechanical motion or safety.

Plan015 L2R2 PASS7/0. L4 pending; same-family fallback, external other-family NOT_RUN.

Executed coverage mapping: 34fixtures cover approval-denial zeroI/O;1/2axisready; acceptancewithoutcompletion; fullfixedFD/newpositioncompletion; unchanged/wrongdelta rejection; FD2withoutstart/missingstart/missingcomplete; exact TX50/read100/start200/move2000/lease800/stale400; service10/clockreverse/API10; observer/operatorstop beforetake and aftersubmit; actualStopLinkreset/quiet/diagnostics/softwarestopverification; originalfault persistence; finalcloseunhealthy/late; reset100, lateouter600/3600; replayseq; largeIDignore; mixedTXterminal; RX17backlog; no repeatedbegin restart. Default undefined-profile assertion covers combineddeniedflags, not each individualapproval independently.

Planned but NOT individually executed in this fixture suite: arbitrary delayed samecode response replay across generations, explicit disconnected-session observer path (gate unit tested separately), systematic all APIs failed-return/clock-overflow permutations, healthy late600 phase crossing (unreachable under stricter guards; measured dominating-guard alternative executed below). Those remain code-review/next integration cases; noclaimcomplete015testmatrix coverage. Source gates implement corresponding bounds, but execution coverage is limited to rows above. Physicalbus timestamp absence/nonce replay and calibratedcounts are stilltrustedprofilelimitations.

## L4 R1 fixes and measured final R2 evidence

51fixtures/3426assertions PASS. Explicit delta must be nonzero and have calibrated requested sign BEFORE magnitude tolerance check. Large tolerance6400 remains permitted under explicitlyapproved fixture but cannot mask zero/reverse;8 combinations zero/reverse xD0/D1 xcalibratedsign+/- rejected,4validdirection cases complete, counts calibration0 profile rejectsbeforeI/O. This keeps directional safety independentof tolerance ratherthan relying on a profile ratio. Nonselected correlated F1!=stopped OR speed32!=0 faults immediately, even if F1reportstillstopped. Dedicated realcorrelatedspeed test passes.

Validchecksum preFD2-history test establishes stable positions alreadyat expected3200delta whileFDcompletionwithheld. Then actual pendingread TXbeforeFD2 is deliveredafterFD2, followedby3unsolicitedvalidpositionframes. None can complete/reserveclear; missingnewtransactions yieldsdeadlinefault. This proves observabletransactionboundaries, not arbitrarynonce-replay detection.

Measuredphaseguard tests (runlog): originalT0=382, gate→innerhandoff=9, innerbegin391; actualStopLink bothaxes TX49ms +ACK199ms reaches Quiet preparationat887 (originalelapsed505). Stop laterverifieshealthy. Bound: handoff<10 +beginprocessing<10 +2x(TX<50+ACK<200) gives <520ms toobservedprep (the measured discretecase505); healthy original600 crossing is dominated/unreachable with these strongerlimits. Secondcase reset90 (stillinnerisolation<100) leaves innercoreStopCommands but outerpercall<10 rejects atnow472, elapsed90, StopTimingFault, stop_verifiedfalse. No relaxedguard/private-statefabrication. Original600/3600 latecalls remain tested separately. Thus the R1 requested lateinnerphase test is closed by the reviewer-permitted **measured earlierguard** alternative, not a fabricatedhealthy600transition.

L4 R2 independent disposition pending; files frozen only after finalmanifest. Physicalresponsebounds, hardwarestop, targetcompile, maintenance/web/app remain NOT_RUN.

## ST3-B integration extension (016)

LegacyAllEnabled remains an explicitly trusted legacy fixture path. New SingleSelected policy requires private move-only actual BootEvidence; setting old seedboolean cannot bypass it. All current proof/read enable comparisons expect selectedaxis1 andothers0; gate's observed enabled booleans remain truthful. Boot owner principal mapping rejects observer Acquire, requires explicit sameprincipal freshAcquire, and preserves provisional old lease through new startup proof. Borrowed actual config expiry is an immutable runtime deadline, not refreshed by reset/samples/renew. Admission freshness uses old observations only to admit reset; actual new CAN reads must replace all stopped proof before Ready. Failed/expired/wrongprofile capability is consumed and reports Fault/torqueunknown/manualcut without driver reset. Hardware/app/long-running configuration refresh remain NOT_RUN/NOT_IMPLEMENTED. The standalone robot_boot README contains actual protocol and end-to-end coverage.

ST3-B L4R1→R2 corrections: capability also binds exact issuing CanPort instance (must remain alive and physically unrebound through transfer); known SingleSelected bus failure invalidates historical heartbeat and performs unverified realclose/manualcut without StopLink reset. This differs intentionally from legacyfixture bus policy and from mere config-age expiry. Boot maintains firstcause/time through centralized stopfailure handling and legal phase admissions; see robot_bootREADME/016/R2 evidence.

## ST3-C actual per-setting runtime refresh (017; independent L4 pending)

This section supersedes the ST3-B fixed4s operating-window limitation, not its authority/port/torque protections. Actual BootEvidence now carries every active axis's seven actual setting values, confirmed TX and dequeue timestamps. Run validates and copies them, then rereads one entry through its existing sole CAN slot. Each actual entry still expires at dequeue+4000; only its matching successful transaction renews it. Owner lease/normal diagnostics/reset do not renew settings. Runtime emits no settings writes or automatic F3. Historical legacy seed behavior stays separate.

Fast actual Boot→Run cases on one/two axes run12s and refresh every setting at least3 times. Two-axis selected1/2 each execute two actual fixed FD moves after4s and complete using new physical-fixture responses. These are offline fake-port results, not hardware acceptance. Captured known bus faults invalidate historical heartbeat approval before an age/authority expiry can trigger reset-based stop; mismatch/unsupported likewise close unverified/manualcut. Pure age expiry retains the separately reviewed historical-stop policy.

Final C regression: Run51fixtures/3427assertions, Boot46/7292; original2+3 mutants compile and fail. Runtime22/1525994 with3 killed behavioral mutants. A required priority-intersection mutation remains an explicit **coverage/acceptance gap**, with two surviving variants and failed real Arm setup preserved; no claim all017 tests completed. See tests/runtime/README.md and `.dev/runtime-refresh-evidence/build/frozen-manifest.json`. C L4 pending; no app/SDK/phone/hardware execution added here.
### ST3-C R2 validation snapshot (independent L4R2 pending)

Runtime28fixtures/1527570assertions,5 compiled failing behavioral mutants; oldBoot46/7292+3 andRun51/3427+2 pass. Actual wire RX-age observer now kills the original urgent-only priority mutation (bad config dispatch age3402 vs diag250; positive maximum159). Shared production freshness/headroom predicates, used by actual actor, pin4000/400/overflow while real seed/EDF/one-entry nonrenew/late reply/admission traces pin consumer use. PostFD2 real config response cannot replace new positions; completion follows genuine proof515ms later. Exact actorTTL/headroom race is represented by the explicitly reviewer-permitted predicate+consumer alternative, not falsely claimed isolated wire crossing. See tests/runtime/README.md for exact evidence/limits. Historical R1 survivor gap remains in preserved R1 snapshot; current R2 awaits independent disposition.
