WINNAKEN/robot-arm-lab/docs/BOM-budget.md

# 6 축 완성 예산 어림 — robot-arm-lab

2026-10-28 · 사용자 질문 「현재 진행되고있는 예산은 대략적으로 얼마니?」 → 「아니 예산이니깐 6축까지 다해서」 · 저장 요청 = 다음 단계 상자의 버튼
「파일로 남기기」(보낸 문장 「이 6 축 예산표를 BOM 옆 파일로 남겨 두고 BOM 에서 가리키게 해줘」).

- **어림이다 — 견적 · 주문 목록이 아니다.** 품목의 상태 · 수량 · 규격은 `docs/BOM.md` 가 정본이고, 이 파일은 금액만 모은다. 구매 · 결제는 사용자가 한다.
- 금액 기준(줄마다 「기준」 칸):
  - **기록** = BOM · 계획 001 · `.dev/spreadsheet-build/purchase-quotes.json`(커밋 안 된 작업 파일 — 계획 001 §11 이 가리킴) 에 적힌 그날의 화면 표시값(결제액 아님 · 「후보」 는 실제 산 제품과 다를 수 있음).
  - **시세** = 2026-10-28 웹 검색 결과에 나온 해외 판매처 표시값. 판매 페이지를 직접 열어 확인하지 않았고 국내 가격 · 재고는 보지 않았다.
  - **가정** = 조사하지 않고 잡은 값.
- 달러 → 원은 계획 001 §11 의 예산 가정 **1 USD = 1,500 원**(실시간 환율 아님). 배송 · 관세 · 부가세 미확인분 · 실패 출력은 맨 끝 「예비 10 %」 로만 잡았다.
- 합계 = 각 줄의 낮게 · 높게를 그대로 더한 값(원 단위). 줄을 고치면 묶음 합 · 요약도 다시 더한다.
- 구성 가정(확정 설계 아님 · 022 검토 · BOM 4 절): J1 = NEMA17 + 사이클로이드 · J2 · J3 = 어깨 — **가안** NEMA17 + 앞단 감속 + 사이클로이드 /
  **나안** NEMA23 + SERVO57D + 앞단 감속 + 사이클로이드(L02 는 사용자 「두 축 시험 실측 뒤 결정 (권장)」 으로 보류) · J4 · J5 = MP6 사이클로이드 27:1 ·
  J6 = 감속 거의 없음 · 그리퍼 = KG1.

## 요약

| 묶음 | 낮게 ~ 높게(원) |
|---|---:|
| ① 이미 주문 · 도착(2 축 벤치 시험) | 263,887 ~ 318,887 |
| ② 나머지 모터 — 가안(전부 NEMA17) | 180,000 ~ 280,000 |
| ② 나머지 모터 — 나안(어깨 NEMA23) | 282,570 ~ 407,450 |
| ③ 감속기 J1 ~ J6 | 165,000 ~ 540,000 |
| ④ 전원 · 배선 · 안전 | 158,000 ~ 227,500 |
| ⑤ 그리퍼 KG1 | 128,380 ~ 153,380 |
| ⑥ 출력 재료 · 체결 | 130,790 ~ 260,790 |
| **합계 — 가안(전부 NEMA17)** | **1,026,057 ~ 1,780,557** |
| **합계 — 나안(어깨 NEMA23)** | **1,128,627 ~ 1,908,007** |
| 예비 10 % 포함 — 가안 | 1,128,663 ~ 1,958,613 |
| 예비 10 % 포함 — 나안 | 1,241,490 ~ 2,098,808 |

- 한 줄로: **6 축 완성(그리퍼 포함)까지 약 102.6 ~ 190.8만 원**, 예비 10 % 를 넣으면 약 112.9 ~ 209.9만 원.
- 이미 주문 · 도착한 ① 이 약 26.4 ~ 31.9만 원 → 앞으로 더 들 돈은 예비 포함 약 81 ~ 183.5만 원.

## 품목별

### ① 이미 주문 · 도착(2 축 벤치 시험)

| BOM 번호 | 품목 | 수량 | 단가 | 금액(원) | 기준 | 근거 · 메모 |
|---|---|---|---|---:|---|---|
| E02 ~ E07 | 벤치 시험 부품 여섯(보드 · 실험용 전원 · 전원선 · WAGO · 퓨즈 세트 · L 브래킷) | 각 1 | 기록 합 125,427 | 125,427 | 기록 | BOM 1 절 표시값(24,150 + 68,597 + 8,100 + 10,450 + 8,460 + 5,670) |
| E08 | igus CF888.021 CAN 선 1 m(주문했다가 안 쓰기로 함 · 취소 여부 모름) | 1 | 약 12,000 | 12,000 | 기록(추정) | 계획 001 §14.1 — 3 m 화면 값을 길이로 나눈 추정 |
| E11 | 디지털 멀티미터(배송 중 · 실제 모델은 받은 뒤 기록) | 1 | 후보 UT33A+ 27,500 | 27,500 | 기록(후보) | `.dev/spreadsheet-build/purchase-quotes.json` B11 |
| E12 | USB-C 데이터 케이블(배송 중) | 1 | 후보 3,960 | 3,960 | 기록(후보) | 같은 파일 B02 |
| E01 | MKS SERVO42D CAN MT + NEMA17 모터(도착 · **결제액 기록 없음**) | 2 세트 | 세트당 45,000 ~ 70,000 | 90,000 ~ 140,000 | 시세 | Probots(인도) CAN + 40 mm 모터 세트 ₹2,999(약 US$33 ~ 36) · 판매처 · 배송 차이로 폭을 둠 |
| R06 | M3 열압입 인서트 추가 주문분 | 100 | 5,000 ~ 10,000 | 5,000 ~ 10,000 | 가정 | 조사 안 함 |
| | **묶음 합** | | | **263,887 ~ 318,887** | | |

### ② 나머지 모터 — 가안(전부 NEMA17)

| BOM 번호 | 품목 | 수량 | 단가 | 금액(원) | 기준 | 근거 · 메모 |
|---|---|---|---|---:|---|---|
| L01 | **가안** — 나머지 네 관절도 MKS SERVO42D CAN + NEMA17 | 4 세트 | 세트당 45,000 ~ 70,000 | 180,000 ~ 280,000 | 시세 | E01 과 같음 |
| | **묶음 합** | | | **180,000 ~ 280,000** | | |

### ② 나머지 모터 — 나안(어깨 NEMA23)

| BOM 번호 | 품목 | 수량 | 단가 | 금액(원) | 기준 | 근거 · 메모 |
|---|---|---|---|---:|---|---|
| L01 | **나안** — 손목 · 허리 쪽 두 관절 MKS SERVO42D CAN + NEMA17 | 2 세트 | 세트당 45,000 ~ 70,000 | 90,000 ~ 140,000 | 시세 | E01 과 같음 |
| L02 | **나안** — 어깨 J2 · J3 를 MKS SERVO57D CAN MT + NEMA23-56 | 2 세트 | 세트당 US$64.19 ~ 89.15 | 192,570 ~ 267,450 | 시세 | AliExpress 「57D 56mm CAN MT」 표시 $64.19(할인가) · 원가 $89.15 · Makerbase 드라이버만 $49.99 |
| | **묶음 합** | | | **282,570 ~ 407,450** | | |

### ③ 감속기 J1 ~ J6

| BOM 번호 | 품목 | 수량 | 단가 | 금액(원) | 기준 | 근거 · 메모 |
|---|---|---|---|---:|---|---|
| R03 ~ R05 | 사이클로이드 베어링(6801 둘 · 6800 · 6808) — J1 ~ J5 다섯 관절(J4 · J5 분 — 6801 · 6800 도착 · 6808 주문함 · 수량 기록 없음) | 5 관절 | 관절당 10,000 ~ 30,000 | 50,000 ~ 150,000 | 가정 | 일반품은 싸고 브랜드 6808 하나가 RS 영국 £19.20 — 그 사이로 잡음 |
| R01 · R02 | 평행핀 Ø4(× 28 · × 20) — 관절당 34 개 × 다섯 | 170 개 | 100 개당 약 33,000 | 50,000 ~ 80,000 | 시세 + 가정 | Zoro Ø4 × 30 100 개 $22.15(같은 길이 · 경화 연마 아님) · 28 mm · 연마품 · 배송으로 폭 |
| L02 | 어깨 J2 · J3 앞단 감속(벨트 · 풀리 · 축 · 베어링) | 2 관절 | 관절당 20,000 ~ 40,000 | 40,000 ~ 80,000 | 가정 | 조사 안 함 · 앞단 방식 미정(022) |
| L03 | J2 출력 베어링(6812 자리 표시 → 크로스 롤러 / 앵귤러 후보) | 1 | 15,000 ~ 150,000 | 15,000 ~ 150,000 | 가정 | 일반 깊은 홈 베어링이면 아래쪽, 크로스 롤러면 위쪽 |
| — | J1 회전대 베어링 | 1 | 10,000 ~ 50,000 | 10,000 ~ 50,000 | 가정 | 설계 안 함 |
| — | J6 감속 · 지지 | 1 | 0 ~ 30,000 | 0 ~ 30,000 | 가정 | 022 — J6 필요 감속비 ≤ 2.7(직결도 가능) |
| | **묶음 합** | | | **165,000 ~ 540,000** | | |

### ④ 전원 · 배선 · 안전

| BOM 번호 | 품목 | 수량 | 단가 | 금액(원) | 기준 | 근거 · 메모 |
|---|---|---|---|---:|---|---|
| L06 | 24 V 고정 전원(예 MEAN WELL LRS-350-24 · 350 W) | 1 | US$30 ~ 45 | 45,000 ~ 67,500 | 시세 | Jameco $32.10 · RS 영국 £36.76 · 그 밖 소매 $30 ~ 45 |
| E13 | DC 급전 차단 구성(정지 버튼 · 차단 릴레이 / 접촉기 · 허용 버튼 · 박스) | 1 구성 | 60,000 | 60,000 | 기록(가예산) | 계획 001 §11 「급전 차단 회로 가예산 60,000원」 |
| — | 6 축 CAN · 전원 배선 · 커넥터 · 선 정리 | 1 구성 | 30,000 ~ 60,000 | 30,000 ~ 60,000 | 가정 | 조사 안 함 |
| E19 | 홈 스위치 + 고정부 | 6 | 스위치 3,883 + 고정부 | 23,000 ~ 40,000 | 기록 + 가정 | purchase-quotes B16 OMRON SS-5GL 3,883 × 6 = 23,298 · 고정부는 가정 |
| | **묶음 합** | | | **158,000 ~ 227,500** | | |

### ⑤ 그리퍼 KG1

| BOM 번호 | 품목 | 수량 | 단가 | 금액(원) | 기준 | 근거 · 메모 |
|---|---|---|---|---:|---|---|
| G01 | Feetech STS3215 12V 버스 서보(1 + 예비 1) | 2 | US$16.99 ~ 21.99 | 50,970 ~ 65,970 | 기록 | BOM 2b |
| G02 | Waveshare Bus Servo Adapter (A) | 1 | US$4.99 | 7,485 | 기록 | BOM 2b |
| G03 | 24 → 12 V 강압기(3 A 이상) | 1 | US$39.95 | 59,925 | 기록 | BOM 2b Pololu D36V50F12(품절) — 같은 급 다른 제품이면 줄어듦 |
| G05 ~ G08 | 탄소 관 6 × 4 · 그리퍼 나사 | — | 10,000 ~ 20,000 | 10,000 ~ 20,000 | 가정 | 조사 안 함 |
| | **묶음 합** | | | **128,380 ~ 153,380** | | |

### ⑥ 출력 재료 · 체결

| BOM 번호 | 품목 | 수량 | 단가 | 금액(원) | 기준 | 근거 · 메모 |
|---|---|---|---|---:|---|---|
| M03 | PLA 필라멘트(외장 · 관절 · 시험편 · 실패 출력) | 3 ~ 5 kg | kg 당 30,000 ~ 40,000 | 90,000 ~ 200,000 | 시세 + 가정 | Bambu PLA Basic 1 kg 해외 표시 €20 ~ 33 · NZ$34.99 — 국내 kg 값은 가정 |
| R07 ~ R09 · G11 · L04 | M3 · M4 나사 · 너트 묶음(감속기 · 팔 · J2 분할 등) | 1 묶음 | 20,000 ~ 40,000 | 20,000 ~ 40,000 | 가정 | 조사 안 함 · 인서트는 R06 보유분 사용 |
| E14 | 모터 고정판 · 체결 | 1 구성 | 20,790 | 20,790 | 기록 | purchase-quotes B10 알루미늄 평판 15,790 + 체결재 가예산 5,000 |
| | **묶음 합** | | | **130,790 ~ 260,790** | | |

## 금액 폭이 큰 이유

1. **J1 · J2 출력 베어링**(③) — 일반 깊은 홈 베어링이면 몇 만 원, 크로스 롤러면 10만 원이 넘는다. 감속기 선정(L03) 뒤에 좁힌다.
2. **어깨 모터**(②) — 가안 · 나안 차이. 두 축 시험 실측 뒤 사용자 결정(L02).
3. **출력 재료**(⑥) — 실패 출력 · 다시 뽑는 횟수.

## 넣지 않은 것

- 이미 가진 것: H2D 프린터(M01) · 인두 · 캘리퍼 · 배선 공구(E10) · 기존 PLA.
- 나중 · 보류: PC 용 USB-CAN(E18 — 필수 아님) · 2 ~ 3 호기 RobStride(L07) · 유료 CAD(L08 보류) · 다이얼 게이지(M06) · 윤활제(M07) · 온도계(E20 보유 장비).
- 원격 GPU · Isaac 등 시뮬레이션 비용.

## 고치는 법

- 실제 결제액 · 도착품 · 설계 결정이 오면 그 줄의 금액 · 기준을 고치고(결제액이면 「결제」) 합계를 다시 더한 뒤 아래 「바뀐 기록」 에 한 줄. 사용자 말은 「」 안에 원문 그대로.
- 상태 · 수량은 BOM 이 먼저다 — BOM 에서 품목이 바뀌면 이 파일의 그 줄도 맞춘다.

## 출처(2026-10-28 웹 검색 — 판매 페이지 표시값)

- MKS SERVO42D CAN + 40 mm 모터 세트: [Probots](https://probots.co.in/mks-servo42d-can-closed-loop-stepper-motor-kit.html)
- MKS SERVO57D: [Makerbase](https://makerbase3d.com/product/makerbase-mks-servo57d/) · [AliExpress 57D 56mm CAN MT](https://www.aliexpress.us/item/3256811382487173.html)
- LRS-350-24: [Jameco](https://www.jameco.com/z/LRS-350-24-MEAN-WELL-350-4W-24VDC-14-6A-Single-Output-Enclosed-Power-Supply_2219823.html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) · [RS 영국](https://uk.rs-online.com/web/p/switching-power-supplies/1065869)
- 베어링: [RS 영국 NSK 6808ZZ](https://uk.rs-online.com/web/p/ball-bearings/0639974) · [Walmart 6800ZZ 10 개](https://www.walmart.com/ip/18748865611)
- 평행핀: [Zoro Ø4 × 30 100 개](https://www.zoro.com/i/G9902457/)
- PLA: [PriceSpy NZ](https://pricespy.co.nz/product.php?p=15971030) · [Elektronica voor jou](https://elektronicavoorjou.nl/en/?p=39209947)

## 바뀐 기록

| 날짜 | 바뀐 것 | 근거 |
|---|---|---|
| 2026-10-28 | 처음 만듦(MP9 세션 · Claude) | 위 사용자 질문 · 저장 요청 |
| 2026-10-29 | R03 ~ R05 설명만(6801 · 6800 도착) — 금액 · 합계 그대로(결제액 모름) | BOM 바뀐 기록 2026-10-29 |
