WINNAKEN/robot-arm-lab/docs/BOM.md

# 구매품 목록 (BOM) — robot-arm-lab

사용자 요청(2026-10-26): 「이거 파일로 저장하면서 전체적으로 구매해야했던구매품 리스트 즉 bom리스트를 만들어서 관리해」.
**구매품의 상태는 이 파일 하나에서 관리한다.** 품목의 자세한 이유 · 조사 · 배선은 각 줄의 근거 문서가 정본이고, 이 파일은 「무엇을 · 몇 개 · 지금 어디까지」를 모은다.
**금액 어림(6 축 완성까지 · 견적 아님) = [`docs/BOM-budget.md`](BOM-budget.md)** — 상태 · 수량 · 규격은 이 파일이 정본이고, 그 파일은 금액만 모은다.

## 관리 규칙

- 상태 단어(이것만 쓴다):
  - **보유** — 손에 있음 · **사용함** — 쓴 기록은 있으나 보유를 따로 적지 않음
  - **주문함** — 주문 완료를 사용자가 확인(도착 전) · **도착** — 받음
  - **선택함** — 제품을 골랐고 주문 완료는 확인 안 됨 · **살 것** — 사기로 했고 규격이 정해짐
  - **확인 필요** — 보유 · 주문 여부를 모름 · **나중** — 다음 단계에서 정함 · **보류** — 사용자가 미룸 · **제외** — 다른 선택과 겹쳐 사지 않음
  - **챙겨 옴** — 사지 않고 사용자가 다른 곳에서 가져옴(받으면 **보유**)
- 바뀌면 그 줄의 상태를 고치고 맨 아래 「바뀐 기록」 에 한 줄(날짜 · 번호 · 전 → 후 · 근거). 사용자 말은 「」 안에 원문 그대로.
- 가격은 그 문서에 적힌 날의 화면 표시값이다(지금 가격 아님). 구매 · 결제는 사용자가 한다.
- 품목의 상태 · 수량 · 결제액이 바뀌면 `docs/BOM-budget.md` 의 그 줄 금액도 맞춘다(그 파일의 「고치는 법」).
- 수량 = 필요한 수 · 권하는 구매량(여유 · 묶음 포함)을 따로 적는다.
- 구매 후보를 비교한 엑셀(`.dev/spreadsheet-build/` · `outputs/…xlsx`)은 2026-10-22 이후 갱신되지 않았다(001 §14 「기존 엑셀은 아직 이 현황으로 갱신하지 않았다」) — **이 파일이 최신**이다.

## 1. 1 호기 2 축 벤치 시험 (첫 시험 — 상세 = `docs/design/001-mks-can-two-axis-test-plan.md` §14)

| 번호 | 품목 · 규격 | 수량 | 쓰는 곳 | 상태 | 근거 · 메모 |
|---|---|---|---|---|---|
| E01 | MKS SERVO42D **CAN MT** 모터 + 드라이버(NEMA17 계열) | 2 세트 | 2 축 시험 → 1 호기 관절 | **보유(도착함)** — 2026-10-26 사용자 보고: 모터·드라이브 도착. CAN MT 주문 옵션 확인; 실물 라벨/HW/FW 검증 전 | 001:23 · 001:424 · 알리 상품 1005010202913740 · 받으면 라벨 · CAN 단자 · HW/FW · 축 · 파일럿 · 나사 깊이 확인 |
| E02 | Waveshare ESP32-S3-RS485-CAN-U(외장 안테나) | 1 | 주 제어기(CAN + 휴대폰 웹) | **주문함(배송 대기)** — 2026-10-26 사용자 보고: CAN 부품 배송 대기. 선택 모델 기준이며 실제 도착품/옵션 확인 전 | 001:425 · 표시 24,150 원(10/22) |
| E03 | WANPTEK EPS3210 실험용 전원 32 V / 10 A · 220 V EU 플러그 | 1 | 모터 · 보드 급전(모터는 24 V 이하로) | **주문함** — 2026-10-26 「나머지 선택함 것들도 다 주문했어」 | 001:426 · 표시 68,597 원 |
| E04 | 18AWG 적 · 흑 2 심 실리콘 전원선 5 m(알리) | 1 묶음 | DC 전원 분기 | **주문함** — 같음 | 001:427 · 표시 8,100 원 · 구리 / 주석도금 확인 |
| E05 | WAGO 표기 혼합 커넥터 「221-12 piece set」(221-412/413/415/2411 각 3) | 1 세트 | +24 V / 0 V 분배(221-415 2 개 사용 + 1 예비) | **주문함** — 같음 · 「정품 여부 미검증」 | 001:428 · 표시 10,450 원 |
| E06 | 퓨즈 홀더 + 퓨즈 「Small Set」(홀더 5 · 5 ~ 30 A 퓨즈) | 1 세트 | 분기 보호 | **주문함** — 같음 · 실제 장착 퓨즈 A 값 · 홀더 정격 미확정 | 001:429 · 표시 8,460 원 |
| E07 | NEMA17 L 브래킷 「42 L bracket / 4pcs」 | 1 묶음(4 개) | 모터 2 개 고정 + 예비 2 | **주문함** — 같음 | 001:430 · 표시 5,670 원 · 홀 간격 · 나사 길이 미확인 |
| E08 | igus CF888.021 CAN 케이블(2 × 0.5 · 120 Ω · 차폐) **1 m** | 1 | (안 씀 — E09 로 대체) | **제외** — 2026-10-27 「RVSP는 CF888 대신 쓸 거야」 · 그 전 상태 = 주문함(2026-10-26 「나머지 선택함 것들도 다 주문했어」) — 이미 주문했다면 취소 / 예비는 사용자 판단 | 001:431 · `_research/domestic-short-cables.md`:12 · 1 m 약 12,000 원(추정) · 003 · 엑셀에는 옛 3 m 가 남아 있음 |
| E09 | RVSP 4core 24AWG 통신선(쌍꼬임 · 차폐) 5 m | 5 m | **CAN H/L 선 — E08 대신**(보드 – 축 1 – 축 2) | **확인 필요** — 2026-10-27 「RVSP는 CF888 대신 쓸 거야」로 쓰기로 함 · 주문했는지 기록 없음 · 「120ohm규격은사진에서미확인」 | `.dev/BACKLOG.md`:35 · 배선 방법(4 심 중 어느 쌍 · 실드 · 기준 도체)은 배선 가이드 003 을 고칠 때 정함(Codex) |
| E10 | 페룰 압착기 + 페룰 · 전선 탈피기 · 열수축튜브 세트 | 각 1 | 배선 마감 | **보유** — 사용자 「이미 있거나 샀어」(품목별 보유 / 주문 구분 없음) | 001:432 · `_research/two-axis-wiring-tools.md`:26 |
| E11 | 디지털 멀티미터(후보 UNI-T UT33A+) | 1 | 전압 · 극성 · 도통 · CAN H–L 저항 | **주문함**(배송 중) — 2026-10-26 「멀티미터랑 USB-C 케이블은 오고있어」 · 실제 모델은 받은 뒤 기록 | 001:441 |
| E12 | USB-C **데이터** 케이블 약 1 m | 1 | 보드 업로드 · 디버깅 | **주문함**(배송 중) — 같음 · 데이터용인지 받은 뒤 확인 | 001:442 |
| E13 | DC 급전 차단 구성: 래칭 NC 정지 버튼(22 mm) 1 · DC 차단 릴레이 / 접촉기(코일 24 VDC · 주접점 20 ~ 30 A 급) 1 · NO 급전 허용 버튼 1 · 버튼 박스 | 1 구성 | 모터 급전 차단 | **보류** — 「모델/회로 미확정」 · 2 채널 자동 잠금 모듈은 채택 보류 | 001:439 · `_research/two-axis-dc-stop-components.md` |
| E14 | 고정판 · 볼트 · 너트 · 와셔 | 1 구성 | 모터 2 개 고정 | **보류** — 사용자 「고정판 선정은 급하지 않으니 보류」 · 실물 구동 전에는 필요 | 001:440 · `_research/two-axis-dc-stop-components.md`:5 |
| E15 | 실제로 꽂을 보호 퓨즈(A 값) | 맞는 값 | 분기 보호 | **확인 필요** — E06 세트에 맞는 값이 있으면 추가 구매 없음 | 001:444 |
| E16 | 부족한 단자 플러그 · 공통 전원 연결선 / 출력 단자 | 부족분만 | MKS · 보드 · 전원 | **확인 필요** — 동봉품을 본 뒤 | 001:443 |
| E17 | 120 Ω 종단저항(외장) | 0 ~ 2 | CAN 버스 양 끝 | **확인 필요** — 내장 종단으로 되면 사지 않음 | 001:445 |
| E18 | PC 용 USB-CAN(CANable 계열) | 필요 시 1 | PC 진단 | **나중** — 「ESP32 단독 제어의 필수 구매는 아님」 | 001:453 |
| E19 | 홈 스위치 + 고정부 · 검출 플래그 | 축당 1 · 2 세트 | 원점복귀 시험 | **나중** — 입력 규격 · 검출 구조 확정 후 | 001:451 |
| E20 | 온도계 / 접촉 온도센서 | 1 | 반복 운전 · 발열 시험 | **나중** — 보유 장비 사용 가능 | 001:452 |
| E21 | 일반 운전 버튼 / 노브 | 필요 시 | ESP32 조작 입력 | **나중** — 조작 화면 확정 후 | 001:454 |
| E22 | 축 표시물(종이 · 테이프) | 모터별 1 | 회전 방향 관찰 | **보유** 재료 사용 | 001:455 |

## 2. 사이클로이드 27:1 감속기 MP6 (손목 J4 · J5 후보 — 상세 = `models/cycloid-27-v1/README.md`)

수량 = 감속기 1 개 / 2 개(J4 · J5) / 권하는 구매량(시험 · 여유 · 묶음 포함).

| 번호 | 품목 · 규격 | 1 개 | 2 개 | 권하는 구매량 | 쓰는 곳 | 상태 |
|---|---|---|---|---|---|---|
| R01 | 평행핀(다월) **Ø4 × 28 mm** — 경화 연마(GCr15 · SUJ2) · 탭 없음 · m6 / h6 | 28 | 56 | 100 | 고정 핀(바닥판 압입) | **살 것** — 2026-10-26 「28 소량구하기애매해서 해외 대량 구매할려고하는거라」 |
| R02 | 평행핀 **Ø4 × 20 mm** — 같음 | 6 | 12 | 50 | 출력 핀(캐리어 압입) | **살 것** — 같음 |
| R03 | 베어링 **6801**(= 61801) 12 × 21 × 5 · ZZ · 보통 등급 | 2 | 4 | 6 ~ 10 | 원판 가운데 | **도착** — 2026-10-29 「베어링 6801 과 6800도왔어」 · 받은 수량 · 실드(ZZ / 2RS)는 아직 기록 안 함 · 그 전 = 주문함(2026-10-26 「베어링은 주문했고 나사는 아직안했는데 챙겨올데가있어」) |
| R04 | 베어링 **6800**(= 61800) 10 × 19 × 5 · ZZ | 1 | 2 | 3 ~ 5 | 편심 축 윗끝 | **도착** — R03 과 같음(2026-10-29) · 그 전 = 주문함 |
| R05 | 베어링 **6808**(= 61808) 40 × 52 × 7 · ZZ | 1 | 2 | 3 | 출력 지지(덮개) | **주문함** — 같음 |
| R06 | **M3 열압입 인서트 — 길이 5.7 · 바깥지름 4.2**(가진 것 · 2026-10-26 「인서트는 M3 길이 5.7 바깥지름 4.2야」 · 구멍 Ø4.0 확정) | 12 | 24 | 50 ~ 100 | 덮개 아래 4 · 위 4 · 캐리어 4 | **보유 약 50 개 + 주문함 100 개** — 2026-10-27 「인서트는 50개 정도 있고 100개 추가로 주문은해놓은상태야」 |
| R07 | **M3 × 10 둥근머리 ISO 7380(필수)** | 4 | 8 | 20 | 모터 → 바닥판 | **챙겨 옴** — 2026-10-26 「나사는 아직안했는데 챙겨올데가있어」(M3 볼트는 2026-10-23 「지금 없음」 — 014:28) · **머리 높이 1.65 이하 · 지름 5.7 이하인지 받은 뒤 확인** |
| R08 | M3 × 30(렌치볼트 ISO 4762 또는 둥근머리) | 4 | 8 | 20 | 바닥판 아래 → 덮개 | **챙겨 옴** — 같음 |
| R09 | M3 × 8(둥근머리 권장) | 8 | 16 | 50 | 누름 고리 4 · 출력 플랜지 4 | **챙겨 옴** — 같음 |
| R10 | NEMA17 모터 = E01(MKS SERVO42D) | 1 | 2 | — | 입력 | E01 을 따름 |

규격 메모:
- 핀 Ø4 · 길이 28 / 20 은 설계(핀 원 반지름 28 · 핀 28 개 · 쌓임 높이)에 묶여 있다 — 다른 치수를 사면 **주문 전에** 알려 다시 만든다. 핀은 맞춤 확인 판 시험에 4 개쯤 쓰일 수 있다(막힌 구멍).
- 베어링은 이름보다 치수(안지름 × 바깥지름 × 폭)로 확인. ZZ 권장(PLA 가루 · 손 시험 느낌) — 2RS 도 됨. 턱은 고리 끝면의 좁은 띠에만 닿게 설계했다.
- 인서트: 더 살 때는 가진 것과 같은 **M3 × 5.7 × 4.2**(해외 표기 `M3 × 길이 × 바깥지름`). 다른 크기면 받은 뒤 시험편으로 다시 확인.
  감속기의 캐리어 허브 · 덮개 윗면 인서트 구멍은 깊이 6.0 이라 5.7 인서트보다 0.3 깊을 뿐이다(덮개 아래쪽은 8.0) — 녹은 플라스틱이 바닥에 모이면
  끝까지 안 들어갈 수 있으니 천천히 넣고 면과 같은 높이에서 멈춘다. 다음 판에서 깊이를 늘릴 수 있는지 검토(`fits.insert_depth`).
- 모터 나사는 머리 높이 1.65 · 지름 5.7 로 계산했다(바로 위 1.0 에 원판) — 렌치볼트(머리 3.0)는 원판에 닿는다. 길이 10 은 모터 나사 깊이 4.5 **가정**.
- 출력 플랜지에 팔 · 시험 짐을 함께 조이면 그 두께만큼 긴 M3 가 더 필요하다.

## 2b. 첫 그리퍼 KG1 (MP8 — 상세 = `models/kmjh-gripper-v1/README.md`)

사용자 결정(2026-10-27 · 28 · 원문 = `.dev/mp8-evidence/user-decisions-mp8.json`): 구동기 「STS3215 12V 버스 서보 (권장)」 · 안내 「Ø6 금속 봉 + 인쇄 턱 구멍 (권장)」 · 봉 「탄소 관 6 × 4 (권장)」.
가격은 조사 날(2026-10-27 · 28)의 해외 판매처 표시값 — 국내 가격 · 재고는 보지 않았다.

| 번호 | 품목 · 규격 | 수량 | 쓰는 곳 | 상태 | 근거 · 메모 |
|---|---|---|---|---|---|
| G01 | Feetech **STS3215 12V(C018)** 버스 서보(동봉 혼 둘 · 혼 나사) | 1 + 예비 1 권장 | 그리퍼 구동 | **선택함** — 제품을 골랐고 주문 전 | 55 ± 1 g · 4-14 V · 정격 10 kg·cm @ 12 V · 정지 2.7 A · 표시 $16.99 ~ 21.99(Waveshare · 7.4V / 12V 묶음 표시) · **7.4V 판(C001)은 사지 않음**(어댑터 입력 9 ~ 12.6 V) |
| G02 | Waveshare **Bus Servo Adapter (A)** | 1 | 제어 보드 IO1 · IO2 ↔ 서보 TTL | **선택함** | 표시 $4.99 · 「RX-RX, TX-TX」 · 점퍼 A · 논리 전압 표기 없음 → 잇기 전 E11 멀티미터로 TX 쉬는 전압 ≤ 3.3 V 확인 |
| G03 | 24 → 12 V 강압기(연속 **3 A 이상**) | 1 | 서보 전원 | **살 것**(제품 미정) | 후보 Pololu D36V50F12(4.5 A @ 36 V 입력 · 표시 $39.95 · 품절 · 백오더) — 같은 급 아무 제품 · D36V28F12(2.4 A)는 정지 전류보다 작음 |
| G04 | 24 V 분기 인라인 퓨즈 + 배선 부속 | 1 | G03 앞 | **나중** — 배선 문서(Codex) 개정 때 정격 | E05 WAGO 로 분배 가능 |
| G05 | **탄소 관 6 × 4**(바깥 6 · 안 4) | 140 mm × 4 = 560 mm 이상(500 mm 둘 등) | 턱 안내(턱마다 둘) | **살 것**(규격 정해짐 · 판매 제품은 안 고름) · 수량 **넷** — 사용자 확정(2026-10-28 · 결정 질문 문구는 「봉은 둘」 이었음) | 3 g 남짓 / 140 mm · L 기둥(미끄럼)으로 넣어 R 기둥에만 눌러 끼움 · 끝 모따기 |
| G06 | M2 × 5 **둥근머리(또는 낮은 냄비) — 머리 지름 ≤ 3.8 · 높이 ≤ 1.6** | 4 | 서보 → 벽 | **살 것** | 자리파기 Ø4.0 × 1.8 · 일반 냄비 머리(ISO 7045 dk 최대 4.0)는 여유 0 이라 쓰지 않음 · 서보 셀프태핑 자리 깊이는 공표값 없음(M2 × 5 면 벽 1.2 지나 3.8 물림) — 받으면 잼 |
| G07 | M3 × 6 렌치볼트 | 4 | 피니언 → 혼 | **살 것** | 혼 탭 깊이 2.5 — **더 긴 나사 금지**(Waveshare FAQ: 서보 몸체에 닿으면 탐) · 피니언 구멍은 꼭 맞는 3.2(원장 pending) |
| G08 | M3 × 8 **둥근머리(ISO 7380 · 머리 Ø5.7 × 1.65)** | 4 | 손끝 둘씩 | **살 것** | 손끝 B 머리가 손끝 끝 쪽에 오므로 둥근머리(끝보다 1.35 아래) · R07 ~ R09(챙겨 옴)와 겹치면 그쪽에서 |
| G11 | M3 렌치볼트(팔 · 시험대 체결 — 받침 원판 자리파기 Ø6.2 × 3) | 4 | 받침 → 팔 플랜지 | **나중** — 길이는 팔 쪽 J6 출력 설계 때 | 머리 높이 3.0 = 자리파기 깊이(받침 위면과 같은 높이 · 랙 B 밑과 0.5) |
| G09 | 보드 확장 헤더 커넥터 · 선(4 핀 — 2.0 mm 핀 헤더로 보임) | 1 | IO1 · IO2 · GND | **확인 필요** — 실물 핀 간격 확인 뒤 | 위키 「Pin header (2.0mm pitch)」 · 저장소 003 은 SH1.0(오기로 보임) |
| G10 | M3 열압입 인서트 | 4 | 손끝 대 | R06 보유분 사용 | — |

## 2c. J5 손목 실부품 v1 (MP10 — 상세 = `models/j5-wrist-v1/README.md`)

사용자 결정(2026-10-28 · 원문 = `.dev/mp10-evidence/user-decisions-mp10.json`): 「손목 관절 실부품 설계 (권장)」 · 「J5 손목 굽힘 하나 (권장)」 · 「PLA 로 먼저 (권장)」.
감속기는 2 절 MP6 그대로(관절 하나분). 아래는 이 단위가 더하는 체결품만 — 나사 머리는 둥근머리 ISO 7380(Ø5.7 × 1.65)으로 검사했다.
MP6 덮개 나사(R08 M3 × 30)는 둥근머리 · 렌치볼트 어느 쪽이든 캔 앞 테 홈(깊이 3.4)이 받는다.

| 번호 | 품목 · 규격 | 수량 | 쓰는 곳 | 상태 | 근거 · 메모 |
|---|---|---|---|---|---|
| W01 | M3 × 16(둥근머리 또는 렌치볼트) | 4 | 모터 조임 — 반쪽 A 귀 바깥 면 → 반쪽 B 귀 인서트 | **살 것** | 물림 5.7 · 끝 ↔ 바닥 1.5(검사 C4) |
| W02 | M3 × 16 | 4 | 목판 → J4 출력 플랜지 → J4 캐리어 인서트 | **나중** — J4 설계 뒤(J4 = MP6 같은 감속기 가정) | 끝 자리 = MP6 출력 플랜지 나사(M3 × 8)와 같음 |
| W03 | M3 × 12 | 4 | 출력 허브 → MP6 출력 플랜지 → 캐리어 인서트 | **살 것** — **R09(M3 × 8) 중 출력 플랜지 넷 대신** | 끝 자리 = MP6 의 M3 × 8 과 같음(허브 머리 밑 4) |
| W04 | M3 × 10 둥근머리 | 4 | 뒤 덮개 → 두 반쪽 인서트 | **살 것** — R07 과 같은 규격(챙겨 온 것이 남으면 그것) | 물림 5.7 · 끝 ↔ 바닥 2.0 |
| W05 | M3 열압입 인서트(M3 × 5.7 × 4.2) | 12 | 반쪽 B 조임 4 · 두 반쪽 뒤 4 · 허브 위(링크 5 용) 4 | R06 보유분 사용 | 구멍 Ø4.0(원장 확정) |

## 2d. J2 · J3 공통 구동 모듈 v1 (MP16 — 상세 = `models/j23-drive-v1/README.md`)

사용자 결정(2026-11-06 · 원문 = `.dev/mp16-evidence/user-decisions-mp16.json`): 「네마 23 서보 57 사올테니」 · 「J2·J3 같은 모듈 81:1 (권장)」 · 「J2는 그럼 76사올게」 · 「옆 배치 (권장)」.
수량 = 두 모듈(J2 · J3) 몫. 「선택함」 = 사용자가 2026-11-06 장바구니 화면을 보냄(주문 완료는 확인 안 함). 치수는 상품 표시값 — 받으면 실측해 보정한다.

| 번호 | 품목 · 규격 | 두 모듈 | 권하는 구매량 | 쓰는 곳 | 상태 |
|---|---|---|---|---|---|
| D01 | MKS SERVO57D **CAN MT** + 57 모터 **76 mm**(Motor Package 2) | 1 | 1 | J2 | **선택함** — 장바구니 |
| D02 | MKS SERVO57D **CAN MT** + 57 모터 **56 mm**(Motor Package 4) | 1 | 1 | J3 | **선택함** — 장바구니 |
| D03 | HTD 3M 풀리 **20 잇** · 벨트 폭 15 · 구멍 8(양쪽 플랜지 권장) | 2 | 2 | 모터 축 | **선택함** — 장바구니 수량 1 → **2 로 늘릴 것**(11/06 알림) |
| D04 | HTD 3M 풀리 **60 잇** · 15 · 구멍 8 | 2 | 2 | 입력 축 | **선택함** — 수량 1 → **2 로 늘릴 것** |
| D05 | HTD 3M 닫힌 벨트 15 mm **3M-306**(102 잇) | 2 | 3(3 개 묶음) | 옆 배치 | **선택함** — 같은 장바구니의 「S3M … 237」 은 이 모양이 달라 안 맞음(옆 배치로 안 씀) |
| D06 | D 컷 강철 축 Ø8 × 100(→ 81 로 자름 · 60 잇 풀리를 잰 뒤) | 2 | 2 | 입력 축 | **선택함** — 상품 화면(11/06) · 평면까지 거리 미표시 → 실측 |
| D07 | 베어링 **6804ZZ**(20 × 32 × 7) | 4 | 6 ~ 10 | 원판 | **선택함** — 10 개 묶음 |
| D08 | 베어링 **6812-2RS**(60 × 78 × 10) | 2 | 3 ~ 4 | 출력 | **선택함** — 2 개 × 2 |
| D09 | 베어링 **608**(8 × 22 × 7) | 4 | 6 | 입력 축 | **살 것** — 장바구니에 없음(11/06 알림) |
| D10 | 평행핀 **Ø6 × 45**(장바구니 = 304 스테인리스 GB119) | 56 | 60 ~ 70 | 고정 핀 | **선택함** — 10 개 × 7 |
| D11 | 평행핀 **Ø8 × 45**(담금질 경화 권장) | 16 | 20 ~ 25 | 출력 핀 | **살 것** — 장바구니는 Ø8 × 40(304) → 45 로 바꿀 것(산출 검토 R1 · 캐리어에 19 압입) |
| D12 | M3 열압입 인서트(M3 × 5.7 또는 6 · 바깥 4.2) | 54 | — | 모듈 | R06 보유분 + 장바구니 「M3x L6x OD4.2」 550 개(선택함) |
| D13 | M3 × 12 · M3 × 8 · M3 × 10 둥근머리 · M3 × 20 · M3 너트 | 20 · 18 · 12 · 6 · 2 | 묶음 | 모듈 · 시험대 | **살 것**(길이별 수 = README 표) |
| D14 | M5 × 20 렌치볼트 + M5 너트 + M5 와셔 | 8 + 8 + 8 | 10 + 10 + 10 | 모터 고정 | **살 것** |

## 2e. 팔 전체 v1 (MP17 — 상세 = `models/manipulator-v1/README.md`)

사용자 결정(2026-11-06 · 원문 = `.dev/mp17-evidence/user-decisions-mp17.json`): 「6818 두 개 새로 구매 (권장)」 · 「165 로 늘림 (권장)」 · 「링크 · 바닥을 KMJH 모양으로 (권장)」.
수량 = 팔 한 대. 손목형 감속기(MP6)는 J1 · J4 · J5 · J6 넷이 필요하다 — 2 절 표는 둘(J4 · J5) 몫이므로 J1 · J6 두 벌을 더한다.

| 번호 | 품목 · 규격 | 수량 | 쓰는 곳 | 상태 |
|---|---|---|---|---|
| A01 | 베어링 **6818ZZ**(= 61818-ZZ · 90 × 115 × 13 · 가림판) | 2 | J1 회전대 | **살 것** — 2026-11-06 「6818 두 개 새로 구매 (권장)」 · 2RS(접촉 씰)는 끌림이 J1 여유를 먹어 ZZ 로(산출 검토 R1) |
| A02 | 손목형 감속기 부품 두 벌(J1 · J6) = R01 Ø4 × 28 **56** · R02 Ø4 × 20 **12** · R03 6801 **4** · R04 6800 **2** · R05 6808 **2** · R07 ~ R09 나사 | 2 벌 | J1 · J6 | **살 것** — 2 절 행 규격 그대로 · 수량만 더함 · R09 의 출력 플랜지 넷(M3 × 8)은 회전대 · 공구 플랜지 나사(A03 의 M3 × 12)가 대신함(W03 과 같은 꼴) |
| A03 | M3 **둥근머리(ISO 7380)** 나사(이 단위 링크) — M3 × 8 4 · M3 × 10 16 · M3 × 12 22 · M3 × 16 12 · M3 × 20 4 | 표 | 링크 · 덮개 | **살 것**(길이별 수 = README 나사 표 · 렌치볼트 머리는 세 곳에서 닿음 — 산출 검토 R1) |
| A04 | M3 × 16(조임) 12 · M3 × 10 둥근머리(뒤 덮개) 8 | 표 | J1 · J4 · J6 몸통(MP10 방식) | **살 것** |
| A05 | M3 × 10 렌치볼트(ISO 4762) | 4 | 그리퍼 → 공구 플랜지 | **살 것** — 2b 의 G11(「나중 — 길이는 팔 쪽 J6 출력 설계 때」)의 길이가 이 단위에서 정해짐 |
| A06 | M3 × 16 둥근머리 | 4 | J5 목판 → J4 출력(2c 의 W02 — J4 = MP6 이 이 단위에서 확정) | **살 것** |
| A07 | M3 열압입 인서트(M3 × 5.7 · 바깥 4.2) | 약 46 | 몸통 · 회전대 · 바닥판 · 공구 플랜지 | R06 보유분 + 2d D12 장바구니 분 |
| A08 | 순간접착제 또는 얇은 양면테이프 | 소량 | 끝 덮개 둘 | **확인 필요** — 보유 여부 |
| A09 | PLA 색: 진한 남색 · 민트 · 회색(+ 흰) · 모터 덮개용 PETG 또는 ASA(흰) | — | 덮개 · 표시(3 절 M03) | **확인 필요** — M03 「나중」 의 색을 이 단위에서 씀 |
| A10 | M3 평와셔(바깥 7 · 두께 0.5) | 4 | 바닥판 → J1 몸통(중심 맞춤 구멍 · 머리 밑) | **살 것** — 산출 검토 R1 |

## 2f. 팔 전체 v2 (MP18 — 상세 = `models/manipulator-v2/README.md`)

사용자 결정(2026-11-06 · 원문 = `.dev/mp18-evidence/user-decisions-mp18.json`): 「이미 출력된거 안써도되니깐 구매품만 그대로 쓴다면괜찬아」 · 「B 로 진행 · 손목까지 (권장)」. **구매품은 2d · 2e 그대로** — 바뀌는 것은 표준 나사 · 인서트의 수뿐(새 길이 · 새 품목 없음).

| 번호 | 품목 · 규격 | 수량 | 쓰는 곳 | 상태 |
|---|---|---|---|---|
| F01 | M3 × 8 둥근머리(ISO 7380) | +9 | 위팔 앞 덮개 6(상자 기둥 3 · J3 받침대 기둥 3) · 바닥판 → 원뿔 겉 3 | **살 것**(2e A03 의 M3 × 8 에 더함) |
| F02 | M3 × 12 둥근머리 | +8 | J4 · J6 몸통 뒤 덮개(통 뒤판을 함께 — 2e A04 의 M3 × 10 × 8 대신) | **살 것** — A04 의 M3 × 10 둥근머리 8 은 빼도 됨 |
| F03 | M3 열압입 인서트(M3 × 5.7 · 바깥 4.2) | +9 | 위팔 상자 기둥 3 · J3 받침대 기둥 3 · 원뿔 겉 발 3 | R06 보유분 + 주문분 |
| F04 | MP16 벨트 덮개 나사(M3 × 8 × 3 + M3 × 12 + 너트 · 2d) | 그대로 | J2 = 어깨 뒤 통(벨트 덮개 대신) · J3 = 위팔 덮개 받침대(귀 셋 M3 × 8 · 모터 쪽 M3 × 12 + 너트는 안 씀) | 2d 그대로 |
| F05 | 필라멘트 흰 PLA · 남색 · 민트(모터 둘레 집 · 통의 재료는 온도 실측 뒤 — PETG · ASA 가 필요하면 먼저 묻는다) | — | v2 출력(판 열 장) | **확인 필요** — 2e A09 와 같은 색 · 양 증가 |

### 2f 이어서 — 57D 단자 · 케이블 길 (MP18 이어서 · 2026-11-06 · 상세 = `models/manipulator-v2/README.md` 「57D 단자 · 케이블 길」)

사용자 결정(원문 = `.dev/mp18-evidence/user-decisions-mp18-cable.json`): 「2」(= 「42D 단자 배치를 57D 에도 가정해 지금 바로」) · 「A · 막대 높이 키움 (권장)」 · 「±170° 유지 (권장)」. **새로 살 품목 없음** — 나사 · 인서트 수도 2f 그대로.

| 번호 | 품목 · 규격 | 수량 | 쓰는 곳 | 상태 |
|---|---|---|---|---|
| F06 | 케이블 타이(폭 4 mm 이하 — 구멍 4.5 × 2.4) | +10 ~ 12 | 관절 고리 끝 열하나(원뿔 겉 뒤 · 두건 앞면 둘 · 위팔 위 벽 둘 · 아래팔 · 아래팔 통 앞 · J5 목 MP10 · 링크 5 귀 · J6 통 앞 — 산출 검토 R1-2) + 여분 | M10 그대로(**확인 필요**) |

- 사지 않은 것(사용자 결정 · 배선 문서): 관절 고리용 유연 케이블(RVSP 의 움직이는 굽힘 반지름 약 50 을 고리가 못 지킴) · J1 고리 묶음 보호(스파이럴 · 메시 슬리브) · 팔 안 접속점(WAGO) 자리 · 그리퍼 서보 12 V 전원 · 직렬 신호 선.

## 3. 출력 · 재료 · 공구

| 번호 | 품목 · 규격 | 수량 | 쓰는 곳 | 상태 | 근거 · 메모 |
|---|---|---|---|---|---|
| M01 | Bambu Lab H2D(0.4 노즐 · Textured PEI · AMS) | 1 | 부품 출력 | **보유** | `docs/design/009-bench-print-preparation.md`:7 · 2026-10-25 출력에 사용 |
| M02 | Bambu PLA Basic 초록(AMS A4) | — | 시험편 · 감속기 판 | **보유**(사용 중) | `src/cad/calibration/print-fits.json` |
| M03 | 외장 PLA — **흰색 · 진한 남색 · 회색**(+ 민트 강조 소량) | — | 다음 외장 모델링(디자인 컨셉 `docs/brand/README.md`) | **나중** — 2026-10-26 사용자 「색상을 주황색보다는 흰 청 회로 맞추면좋겟는데」 · 「당장은 중요한거아니고」 · 필라멘트 색은 그때 고름 | 옛 v2 외장(흰 · 주황)은 `docs/design/014-product-exterior-v2-display-kit.md`:12 · 17 |
| M04 | 인두(열압입 인서트용) | 1 | 인서트 넣기 | **사용함**(2026-10-25) | `print-fits.json` |
| M05 | 버니어 캘리퍼 | 1 | 실측 | **사용함**(2026-10-25 시험편 실측) | `print-fits.json` observations |
| M06 | 다이얼 게이지 + 고정대 | 필요 시 1 조 | 감속기 출력 유격 | **확인 필요** | 감속기 구매 후보 엑셀(`outputs/reducer-control-20261023/`) |
| M07 | 플라스틱용 윤활제 | 소량 | 감속기 | **나중** — 재질 확정 후 | 같음 |
| M08 | 608 베어링(8 × 22 × 7) | — | 시험편 ② | **사용함**(2026-10-25 판정) — 2026-10-23 에는 「없음」 | 014:28 · `print-fits.json` |
| M09 | M4 열압입 인서트 | — | (시험편 ③ 에 실수로 사용) | **사용함** | `print-fits.json` |
| M10 | 케이블타이(4 mm) · 양면테이프 · 펜 · 스티커 | — | 출력한 배선 정리 부품 | **확인 필요** | `models/bench-prep-v1/README.md` |

## 4. 나중 단계 (설계 · 시험 뒤 — 지금 사지 않음)

| 번호 | 품목 | 쓰는 곳 | 상태 | 근거 |
|---|---|---|---|---|
| L01 | MKS SERVO42D CAN + NEMA17 추가 4 개(합계 6) | 나머지 4 축 | **선택함 2 개(J1 · J6)** — 2026-11-06 장바구니 「SERVO42D CAN MT」 × 2 · J2 · J3 가 57D(2d 절)로 바뀌어 42D 합계 4(가진 2 + 2) · 그 전 = 나중 「시험용 2개가 최종 설계에 맞으면 4개를 더 산다」 | `docs/references/00_robot_arm_START_HERE_KO_20261021.txt`:103 |
| L02 | 어깨 구동: NEMA23-56 + SERVO57D, 또는 NEMA17-48/60 + 앞단 감속(벨트 · 기어) | J2 · J3 | **정함 → 2d 절(D01 ~ D14)** — 2026-11-06 「네마 23 서보 57 사올테니」 · 「J2는 그럼 76사올게」(MP16) · 그 전 = 보류 「두 축 시험 실측 뒤 결정 (권장)」 | `docs/design/022-modeling-reducer-review.md`:267 · 029:11 |
| L03 | J2 출력 베어링(6812 는 자리 표시 · 크로스 롤러 / 앵귤러 후보) | J2 | **나중** — 감속기 선정 뒤 | `models/armold-mks-product-v2/j2-split/README.md` |
| L04 | J2 분할 조립 M3 나사 19(길이 미정) + 인서트 27 | J2 | **나중** | 같음 :46 · 47 |
| L05 | 그리퍼 구동기 | 그리퍼 | → **G01 로 옮김**(2026-10-27 사용자 「STS3215 12V 버스 서보 (권장)」) | START_HERE:103 · 2b 절 |
| L06 | 24 V 고정 전원(완성 장치 · 예 MEAN WELL LRS-350-24) | 7 축 완성 | **나중** — 「현재20A급 선구매는 권하지 않는다」 | `_research/power-supply-expansion.md`:16 · 30 |
| L07 | RobStride 액추에이터 | 2 ~ 3 호기 | **나중** — 「현재는 RobStride 모터를 주문할 단계가 아니다」 | START_HERE:104 |
| L08 | 유료 CAD(Armold 「Files only」 US$44.95 · 26:1 Cycloidal Drive · PAROL6 · AR4) | 참고 형상 | **보류** — 「구매 보류」 | `docs/design/011-armold-mks-concept.md`:3 · `docs/references/packages/04/other_public_refs/PURCHASE_REQUIRED_KO.txt` |

## 5. 제외 · 대체된 후보 (이력 — 사지 않음)

| 대신 쓰는 것 | 빠진 후보 |
|---|---|
| E02 | Waveshare 내장 안테나형 SKU 32154(비회원 장바구니에만 담김 · 주문 없음) · ESP32-S3-Zero-M · SN65HVD230 트랜시버 · 24 V → 5 V DC-DC MBC2596 · LILYGO T-CAN485 + 강압기 + 외함 · M5Stack 결합형 — 001:457 「중복되므로 신규 구매 목록에서 제외」 |
| E03 | UNI-T UTP1305(옛 엑셀 추천) · UTP1310 · WANPTEK NPS3010W · HDTOP 24 V 5 A 어댑터(전류 제한 없음) |
| E04 | DFRobot FIT0585 · CBAZY 6 색 30 m 키트 |
| E05 | WAGO 221-415 단품 · 221-413 10 개 팩 |
| E06 | ATO / ATC 인라인 퓨즈 홀더(「별도ATO홀더 후보는 중복 구매에서 제외」) |
| E07 | REXBOT · MotorBank SMB-42M · Pololu 2266(형상 참고) |
| E08 | BELDEN 9841 · 광일전선 UL2919(120 Ω 미확인) · igus CF898.021(빠른 납기 대안) |
| E11 | Richmeter RM113A · UNI-T UT33D+(엑셀 후보) |
| E13 | ELEC&Lifes 2 채널 자동 잠금 모듈(채택 보류) |

## 6. 확인이 필요한 것 (사용자에게)

1. ~~**선택함 7 개(E02 ~ E08)** 가 실제로 주문됐는지~~ → 2026-10-26 모두 주문함(답함) · 도착하면 「도착」 으로.
2. ~~**E09** RVSP 4core 선이 E08 을 대신하는지~~ → 2026-10-27 대신 씀(답함). 남은 것: **E09 를 주문했는지** · 이미 주문한 **E08 CF888 은 취소인지 예비인지**.
3. ~~**E11** 멀티미터 · **E12** USB-C 데이터 케이블을 가지고 있는지~~ → 2026-10-26 배송 중(답함).
4. ~~**R03 ~ R05** 감속기 베어링 · **R07 ~ R09** 나사를 이미 주문했는지~~ → 2026-10-26 베어링 주문함 · 나사는 챙겨 옴(답함).
5. ~~**R06** 가진 M3 인서트 개수~~ → 2026-10-27 보유 약 50 개 + 100 개 주문함(답함).
6. ~~**M03** 흰 · 주황 PLA 보유 여부~~ → 2026-10-26 외장 색을 흰 · 남 · 회로 바꾸기로 해 「나중」(색을 정할 때 보유 확인).

## 바뀐 기록

| 날짜 | 번호 | 전 → 후 | 근거 |
|---|---|---|---|
| 2026-10-26 | (전부) | 없음 → 처음 만듦 | 001 §14 · `_research/` · `.dev/HANDOFF.md` · `.dev/BACKLOG.md` · 모델 README 에서 모음 + MP6 감속기 규격(이 날 사용자와 정함 — 「아니 필요하다면 다른 규격 사도되는데 판단은 ?」 → 지금 규격 유지 권고) |
| 2026-10-26 | E01/E02 | 모터·드라이브 주문함 → 도착함 / CAN 통합보드 선택함 → 배송 대기 | 사용자 보고. 보정·모터 운전 승인 없음. 기존 ESP32-WROOM 보유 보고는 통합보드 도착과 구분 |
| 2026-10-26 | E11/E12 | 확인 필요 → 주문함(배송 중) | 사용자 「멀티미터랑 USB-C 케이블은 오고있어」 |
| 2026-10-26 | R03 ~ R05 / R07 ~ R09 | 확인 필요 → 주문함 / 살 것 → 챙겨 옴(상태 단어 「챙겨 옴」 새로 둠) | 사용자 「베어링은 주문했고 나사는 아직안했는데 챙겨올데가있어」 |
| 2026-10-26 | E03 ~ E08 | 선택함 → 주문함 | 사용자 「나머지 선택함 것들도 다 주문했어 일단 기다리는거뿐인것같고」 |
| 2026-10-26 | M03 | 흰 · 주황 PLA 확인 필요 → 흰 · 남 · 회(+ 민트) 나중 | 사용자 「색상을 주황색보다는 흰 청 회로 맞추면좋겟는데 … 당장은 중요한거아니고」 → `docs/brand/README.md` |
| 2026-10-26 | R06 | 치수 미기재 → M3 · 길이 5.7 · 바깥지름 4.2(상태 보유 그대로 · 원장 근거에도 적음) | 사용자 「인서트는 M3 길이 5.7 바깥지름 4.2야」 |
| 2026-10-27 | R06 | 보유(개수 미기재) → 보유 약 50 + 주문함 100 | 사용자 「인서트는 50개 정도 있고 100개 추가로 주문은해놓은상태야」 |
| 2026-10-27 | E08 / E09 | CF888 주문함 → 제외(안 씀) / RVSP 새 후보 → CAN 선으로 씀(주문 여부 확인 필요) | 사용자 「RVSP는 CF888 대신 쓸 거야」 |
| 2026-10-28 | L05 → G01 ~ G10 | 그리퍼 구동기 나중 → 첫 그리퍼 KG1 품목 새로(선택함 · 살 것 · 확인 필요) | 사용자 「STS3215 12V 버스 서보 (권장)」 · 「Ø6 금속 봉 + 인쇄 턱 구멍 (권장)」 · 「탄소 관 6 × 4 (권장)」(MP8 · 계획 046) |
| 2026-10-28 | G05 · G06 · G07 · G08 → G08 · G11 | G05 선택함 → 살 것(제품 안 고름 · 수량 확인 필요) · G06 M2 × 6 냄비 → M2 × 5 머리 ≤ Ø3.8 × 1.6 · G08 M3 × 8 여덟 → 손끝 둥근머리 넷 + G11 팔 렌치볼트 넷(나중) | 독립 산출 검토(`.dev/mp8-evidence/review.md` — R-18 · G06 · INT-10 · G11) |
| 2026-10-28 | G05 | 수량 확인 필요 → 넷(140 mm × 4) | 사용자 「탄소봉 네게 써도되고 무게좀더 무거운건 괜찬아」(`.dev/mp8-evidence/user-decisions-mp8.json` decisions_3) |
| 2026-10-28 | (품목 상태 그대로) | 금액 어림 없음 → `docs/BOM-budget.md`(6 축 완성 예산 어림)를 머리 · 관리 규칙에서 가리킴 | 사용자 「아니 예산이니깐 6축까지 다해서」 · 다음 단계 상자 버튼 「파일로 남기기」 |
| 2026-10-28 | W01 ~ W05 | 없음 → J5 손목 실부품 체결품(살 것 · 나중 · 보유분) | MP10 · 계획 056 · 사용자 「손목 관절 실부품 설계 (권장)」 · 「J5 손목 굽힘 하나 (권장)」 |
| 2026-10-29 | R03 · R04 | 주문함 → 도착(수량 · 실드 기록 안 함) · R05 6808 은 주문함 그대로 | 사용자 「베어링 6801 과 6800도왔어」(`.dev/user-reports-1029/user-reports.json`) |
| 2026-11-06 | L01 · L02 · 2d(D01 ~ D14) | L01 나중 → 선택함 2 개 · L02 보류 → 정함(2d) · J2 · J3 구동 모듈 품목 새로(선택함 · 살 것) | 사용자 「네마 23 서보 57 사올테니」 · 「J2는 그럼 76사올게」 · 장바구니 화면(2026-11-06) · MP16 `models/j23-drive-v1/README.md` |
| 2026-11-06 | 2e(A01 ~ A10) | 없음 → 팔 전체 v1 품목(J1 6818ZZ · 손목형 감속기 두 벌 · 링크 둥근머리 나사 · G11 · W02 길이 확정 · 와셔 · 색 필라멘트) | 사용자 「6818 두 개 새로 구매 (권장)」 · 「165 로 늘림 (권장)」 · MP17 `models/manipulator-v1/README.md` |
| 2026-11-06 | 2f(F01 ~ F05) | 없음 → 팔 전체 v2 나사 · 인서트 수(새 길이 · 새 품목 없음) | 사용자 「이미 출력된거 안써도되니깐 구매품만 그대로 쓴다면괜찬아」 · 「B 로 진행 · 손목까지 (권장)」 · MP18 `models/manipulator-v2/README.md` |
| 2026-11-06 | 2f 이어서(F06) | 없음 → 케이블 타이 수(새 품목 없음) | 사용자 「2」 · 「A · 막대 높이 키움 (권장)」 · 「±170° 유지 (권장)」 · MP18 이어서 `models/manipulator-v2/README.md` 「57D 단자 · 케이블 길」 |
