WINNAKEN/robot-arm-lab/docs/design/129-constraint-order-and-cpu-contact-repair.md

> 개발 이력: 작성 당시의 계획·결과입니다. 현재 상태는 [STATUS](../STATUS.md)를 확인하세요. 원시 로그와 로컬 경로 일부는 공개본에서 제외했습니다.

# 129 — 원한도 유지, articulation 제약 순서와 CPU 접촉 관측 수리

2026-11-07 KST의동일최신사용자요청(128 approval5810fff5…)의연속이다. J6속도초과수리→v4정지/작은동작/큰42초·34초판정→실제영상Drive가목표이며중간진단본만으로완료하지않는다. 128task-scope3f516148… immutable allowed[128,129]/SDK1each/2total/retry0/2700each/명목합5400을그대로사용한다. 128 SDK39812는실제로재현됐고REAPED/active0, 원grant426861.906→429561.906·마커/소스/실패/원장을바꾸지않는다. 새사용자응답제조·128grant재무장0. 129외추가런타임단위권위는만들지않는다. 실물CAN/RS485·포트/급전/flash·설치·구매·네트워크/시계변경0.

등록범위: src/simulation/mp18_video_run_129/{release.py,runner.py,test_runner.py}, derived src/simulation/mp18_isaac_129/{driver.py,contract.py,native.py,config.json,program.json,media.py}, outputs/mp18-video-run-129/, 이계획및Root자기인계절. source9+plan1/2groups=M. 작성자implement113_c 새129 cap2700/검산예비300(128의2586.766은별도보존/리셋0), 필수비작성자main review113_lens 새129 L2+L4누적2700/마감예비300/각max2/noR3(128의L2/L4/actual진단누적은끝까지별도보존). 원L1→L2→L3→L4 및same-familyfallback기승인·공통편향잔여기록을유지한다. 작성자준비는읽기전용·L2통과전제품source생성0. Root가실제운영/회수/영상Drive만담당. 타인CAD/원119–128source/원리뷰/증거/권위patch/revert0.

관측근거: 128 F2acb4ed…/L4PASS59f094d8…/native2ae9e772… 실제run d0f2b14ff76d4079a43f7ba8f218f603/job580561a2…/SDK39812. import439.531s PASS, hold240step/2sim_s/21.516s PASS, small1429FAIL/120frames/largeNOT_RUN. 封印subset8manifest358519b2…는recovery-seal과전건바이트SHA일치/SDKREAPED이며canonicalconsumer완료와구분한다. J6 actualqd−0.5001134872436523은기존.5001guard를1.3487243652354763e−5rad/s초과, 직전−.0097109554→단일step큰변화·target/refvel0. 실제초기USD/tensor속도한도.5동일/no-set이므로전파누락수리는발동하지않았다. KG1_A가desk에수µm이내접근했다는bodypose/support증거는있지만contact/impulse는Contact attached stage identity오류로UNKNOWN, 실제두ID미기록이므로접촉원인확정으로쓰지않는다. 실패step한도재조회도미기록. 원전체report/firstfault/정확값보존하며tol상향·qd클램프·실패행정상trajectory화0.

129물리변경은단1개: 설치SDK와동일한captured lab_physx_cfg.py74의PhysxCfg.solve_articulation_contact_last 기본False→True를SimulationCfg.physics의공식PhysxCfg로명시한다. manager848이해당값을physxScene:solveArticulationContactLast에쓰는실제경로를보존한다. 원defaultPhysxCfg의다른필드와신규cfg를비교해불필요delta0을검산하고reset前/後동일scene속성True·stage/clock0를읽어보고한다. 이는공식NVIDIAguide의maximum joint velocity를마지막에집행하는제약순서가설의좁은검증이며contact원인증명이나성공예단이아니다. 원velocity/J6.5+1e−4·gain64/16·capJ2_12/J3_7·URDFd55f0cbd…·.5deg/1deg_s/34초·dt1/120·hold2/small12/large42/원프로필·floor/상태한계/나머지solver·iterations·접촉마찰/offset·물성·fresh_stage0aaf5e05…byte·단1sim.step등은그대로다. reset後강제pose/velocity설정0. legacy119 contract/config/program 바이트동일을유지한다.

129관측수리: CPU Kit의implicitattachment를GPUexplicitattach와혼동한guard를기전별로검증한다. captured lab_physx_manager984–1026은CPU에서force_load_physics_from_usd, GPU만IPhysxSimulation.attach_stage를사용한다. 129는새attach/detach/physicsstep을하지않고실제CPUcfg·현재Lab/Kit stage의owned root/session/등록ID·simulation interface reportedID와getter前後clock/q/qd를검증한다. expected/actual/context/cache/headerIDs및선택mode를판정前에항상ownedprimitive기록한다. attached0은proven CPUimplicit기전과현재stageidentity가확인된경우만관측기전으로다루고임의0허용0; nonzero다른stage·GPUunsupported·headeridentity불명·clock/state변경/decoder/layout/overflow는명시UNKNOWN을유지한다. 기존borrowedvector즉시copy/64headers/256data·累積참조256·8192primitive/UNKNOWN·firstfaultbeforeguard·primary보존·secondaryproducer12x3primitive불변식을보존한다. 不支援관측으로원controlerror를덮거나물리수정을정당화하지않는다.

Source129는현재128의검토된9source/F2/L4/raw를기점으로outer129/path/nonce/동일원문참조/actualpriorSDK4/newmax1/NOretry와상기두native경계만좁게파생한다. 원128/127역사namespace/SHA를allreplace하지않는다. 원expected_job_sha bootstrap→parent/native/context samecapturedbytesexec, rawstdin123/WinJob/Resultseal/현재source·grant·path/resultguard/MP4onlyallowlist보존. 새approval-evidence는128실제원문을가리키는continuationreference라고명시하고原actual128evidence와taskscopeSHA를FACTS에서같은capturedbytes로검증한다. unit129가元allocation의member이고SDK合2/각1/기간2700/合5400/hardwarefalse/criteriachangefalse인지를보존한다. 128canonical transport/consumer완료및구체원결과가검산되고subset8과원bytes가일치한뒤F129/신규실행을닫는다. 기다리는동안새SDK0·의존대기는원clock와별도동결한다.

HOST: 원128현재30군을실제129generatedpackage로실행한다. 추가actualnative cfg作成/solverattr사용점에서default−True 단1delta·原한도/kinematics無변경을검산하고False/다른필드수정/guard前snapshot복원mutation을거절한다. CPUimplicit0+동일ownedcurrentstage의현재contact, GPUexplicit동일stage, 다른stage/unknown0·錯header/clock/q/qd변경·불가decoder·borrowed다음step변조·누적overlap·primary/finalwrite組合을실제collectorconsumer에서음성관측한다. SDKsource語존재핀만으로기전검증을대체하지않는다. 最低8AC/5공격범주·결함합집합/분류/반복재귀/次DISTINCT/현재source EXH및과거원장유지를비작성자가판정한다. 128兩診斷class폐쇄·privatefield17000候補의production12행불변식기각scope/실측도보존, 새생산필드가그불변식을깨지않음을검산한다.

最終L4PASS/F/current129source/실제prepare 뒤Root만원요청·prepared/F SHA와新고정2700s/nonce/hardwarefalse의exclusive129grant를작성한다. 원128pipeline SDK/SSHparent REAPED·回收완료후129 SDK1회로import→hold→small→large42및34초원판정을진행한다. 128/129실제A/B에서速度max/floor/body/접촉資料/physicsflag·IDmode/參考와기준동일성·행/프레임/원SDKREAPED/원jobseal을검산한다. 기준을실제로통과해야성공이며가설이맞았다고단정하지않는다. 실패도원packet/log/클래스그대로보존·원물리CAN/RS485無승인.

실제v4움직임RGB만encode,전체decode/첫·중간·끝·실제q범위·34초/42초판정확인후기승인DrivefolderPRIVATE_CLOUD_RESOURCE_REMOVED에MP4한개만append·metadata/remote byteSHA검산한다. 기존127/128진단본·v3·CAD/HOST영상을큰동작성공대신쓰지않는다. JSON/원로그/설정/권위/토큰외부업로드0·공유권한변경0.

Primary API: https://docs.omniverse.nvidia.com/kit/docs/omni_physics/107.3/dev_guide/guides/articulation_stability_guide.html ; https://isaac-sim.github.io/IsaacLab/develop/source/api/lab_physx/isaaclab_physx.physics.html ; https://docs.omniverse.nvidia.com/kit/docs/omni.usd/latest/omni.usd/omni.usd.UsdContext.html . 설치SDK와동일な보존소스의cfg74/manager848·984/context133–160을먼저쓴다.
