WINNAKEN/robot-arm-lab/src/simulation/inventory_session/README.md

# 056 typed Torch inventory session

파일 보고 module과 실제 class 정의에 연결된 dynamic namespace를 구분한다. launch.ps1 -Role test|prepare|run|verify. 새 audit/diagnosis/conditional connection 각1회, 이전055 원장 보존. 설치/재부팅/실물/학습 없음. 결과 outputs/isaac-inventory-v1/HANDOFF.md.
