WINNAKEN/robot-arm-lab/models/robot-arm-urdf-v4/meshes/visual/KG1_A__FFFFFF.stl

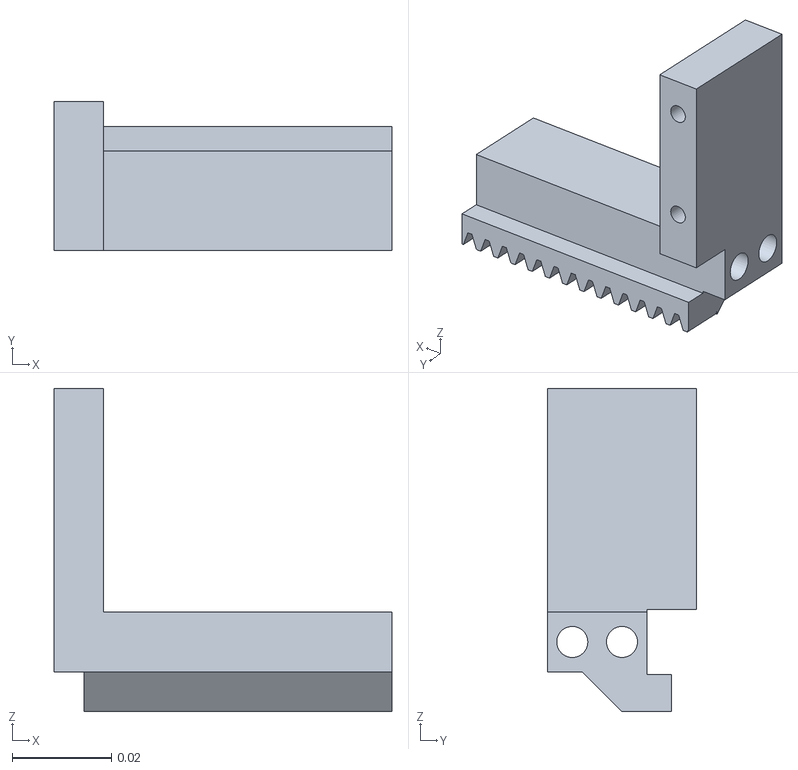
[picture p4: CAD file, 2026-11-13]
models/robot-arm-urdf-v4/meshes/visual/KG1_A__FFFFFF.stl
0.068 x 0.03 x 0.065
