WINNAKEN/robot-arm-lab/models/robot-arm-urdf-v4/meshes/collision/Link1.stl

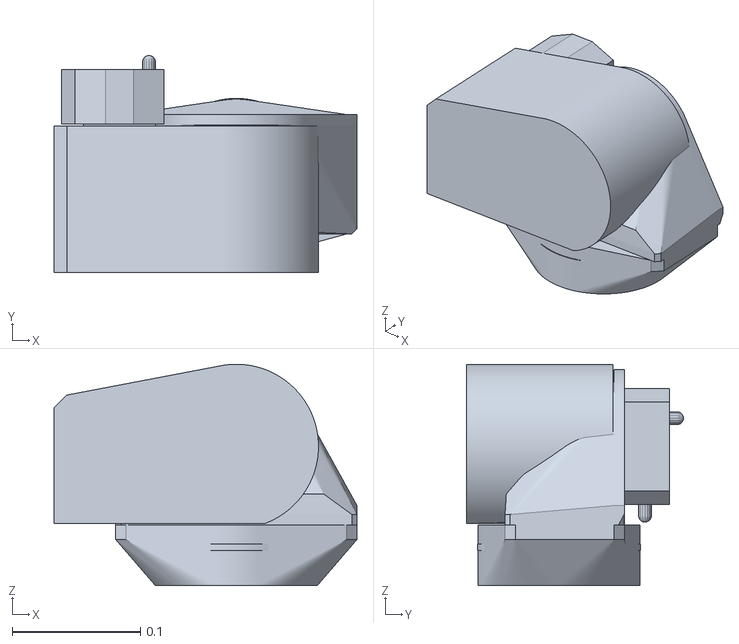
[picture p5: CAD file, 2026-11-13]
models/robot-arm-urdf-v4/meshes/collision/Link1.stl
0.236 x 0.169 x 0.173
