WINNAKEN/robot-arm-lab/models/robot-arm-urdf-v4/meshes/Link3.stl

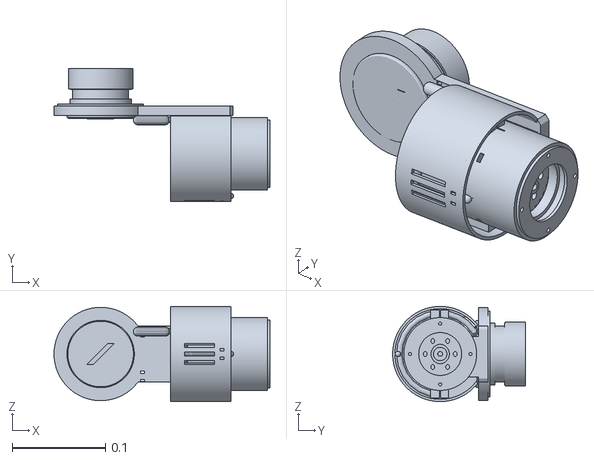
[picture p6: CAD file, 2026-11-13]
models/robot-arm-urdf-v4/meshes/Link3.stl
0.232 x 0.142 x 0.102
