WINNAKEN/robot-arm-lab/models/robot-arm-urdf-v4/meshes/visual/KG1_A__6B7280.stl

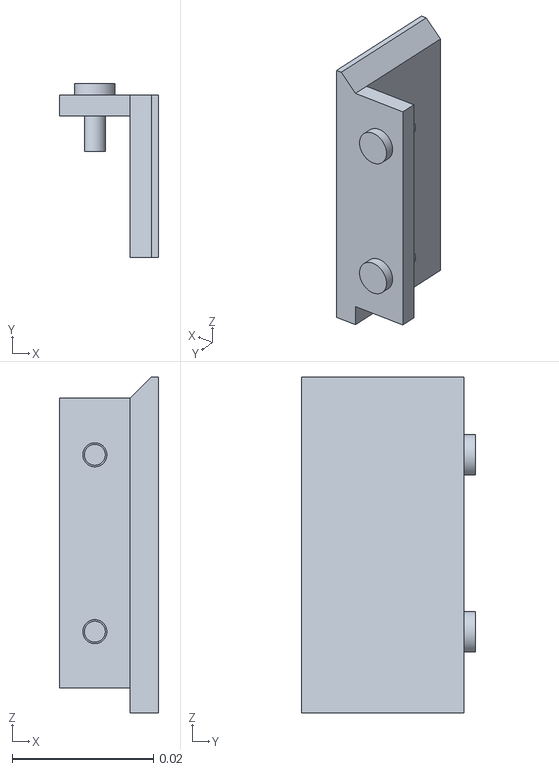
[picture p7: CAD file, 2026-11-13]
models/robot-arm-urdf-v4/meshes/visual/KG1_A__6B7280.stl
0.014 x 0.0246 x 0.0475
