WINNAKEN/robot-arm-lab/models/robot-arm-urdf-v4/meshes/collision/Link4.stl

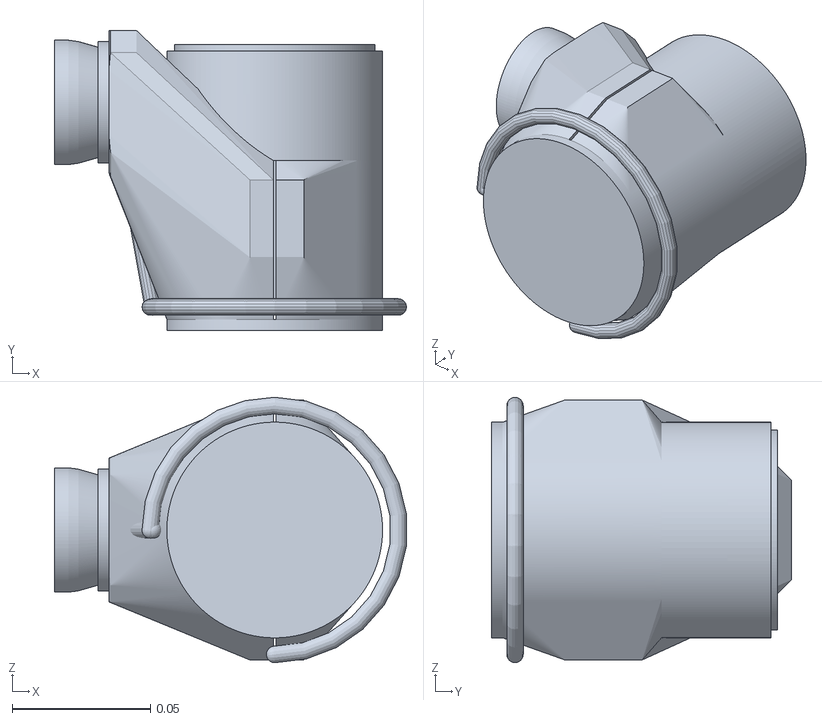
[picture p8: CAD file, 2026-11-13]
models/robot-arm-urdf-v4/meshes/collision/Link4.stl
0.127 x 0.109 x 0.096
