WINNAKEN/robot-arm-lab/models/robot-arm-urdf-v4/meshes/KG1_B.stl

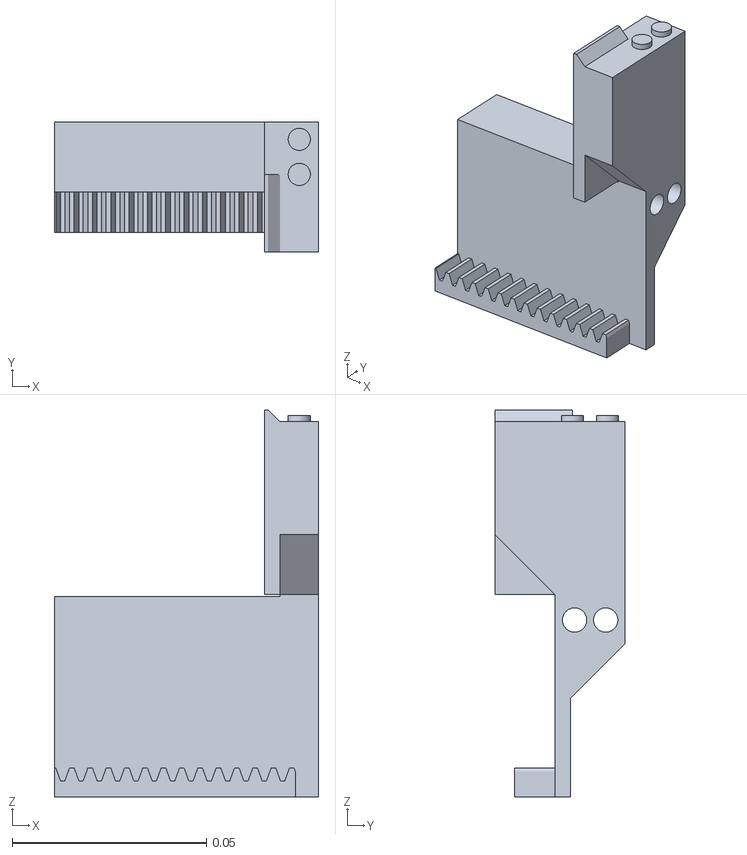
[picture p9: CAD file, 2026-11-13]
models/robot-arm-urdf-v4/meshes/KG1_B.stl
0.068 x 0.0335 x 0.0995
