WINNAKEN/robot-arm-lab/models/robot-arm-urdf-v4/meshes/visual/Link4__FFFFFF.stl

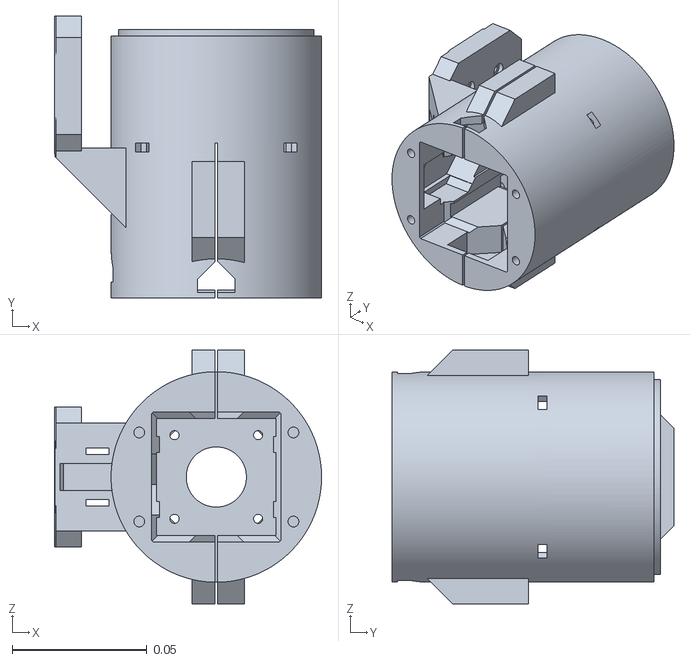
[picture p10: CAD file, 2026-11-13]
models/robot-arm-urdf-v4/meshes/visual/Link4__FFFFFF.stl
0.099 x 0.105 x 0.094
