WINNAKEN/robot-arm-lab/models/robot-arm-urdf-v4/meshes/collision/KG1.stl

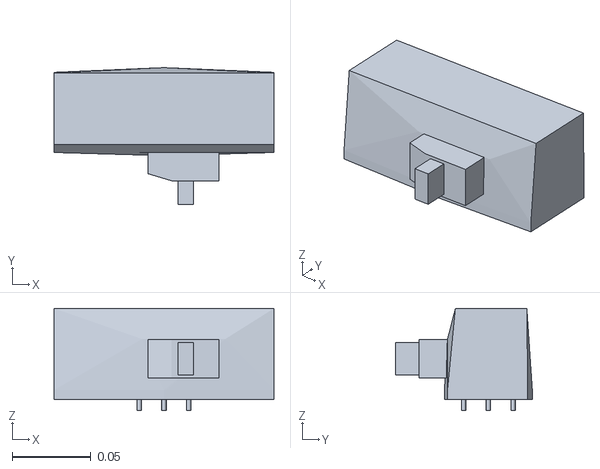
[picture p11: CAD file, 2026-11-13]
models/robot-arm-urdf-v4/meshes/collision/KG1.stl
0.14 x 0.087 x 0.065
