WINNAKEN/robot-arm-lab/models/robot-arm-urdf-v4/meshes/visual/KG1_R__2A2A2A.stl

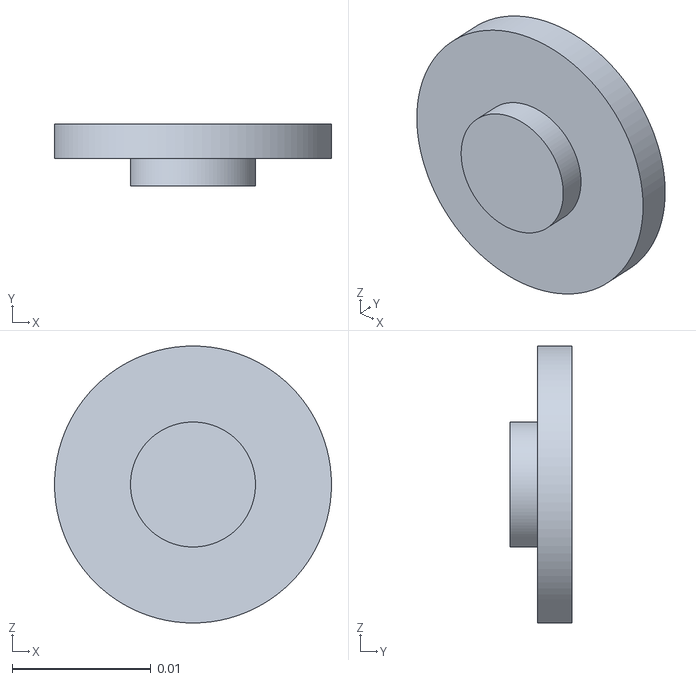
[picture p13: CAD file, 2026-11-13]
models/robot-arm-urdf-v4/meshes/visual/KG1_R__2A2A2A.stl
0.02 x 0.0045 x 0.0199
