WINNAKEN/robot-arm-lab/models/robot-arm-urdf-v4/meshes/Link5.stl

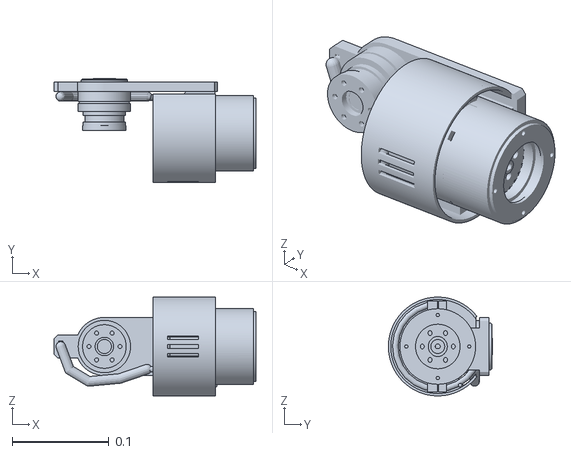
[picture p15: CAD file, 2026-11-13]
models/robot-arm-urdf-v4/meshes/Link5.stl
0.208 x 0.108 x 0.102
