WINNAKEN/robot-arm-lab/models/robot-arm-urdf-v4/meshes/visual/Link3__141416.stl

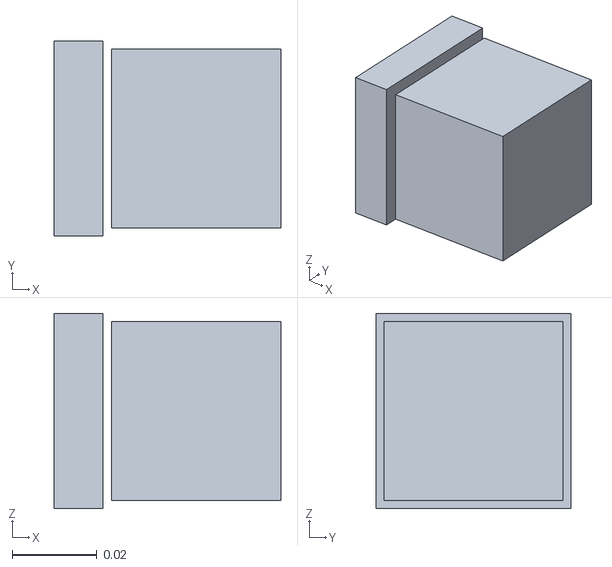
[picture p16: CAD file, 2026-11-13]
models/robot-arm-urdf-v4/meshes/visual/Link3__141416.stl
0.0535 x 0.046 x 0.046
