WINNAKEN/robot-arm-lab/models/robot-arm-urdf-v4/meshes/Base.stl

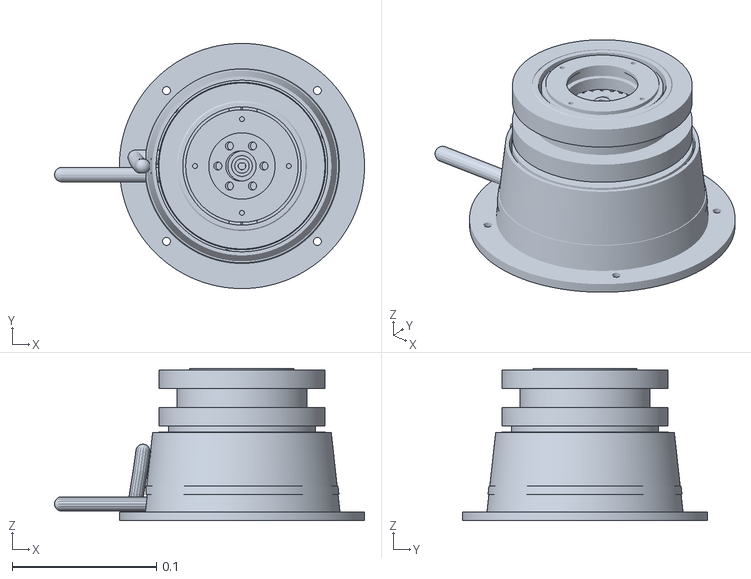
[picture p17: CAD file, 2026-11-13]
models/robot-arm-urdf-v4/meshes/Base.stl
0.215 x 0.17 x 0.105
