WINNAKEN/robot-arm-lab/models/robot-arm-urdf-v4/meshes/visual/Link4__87CEEB.stl

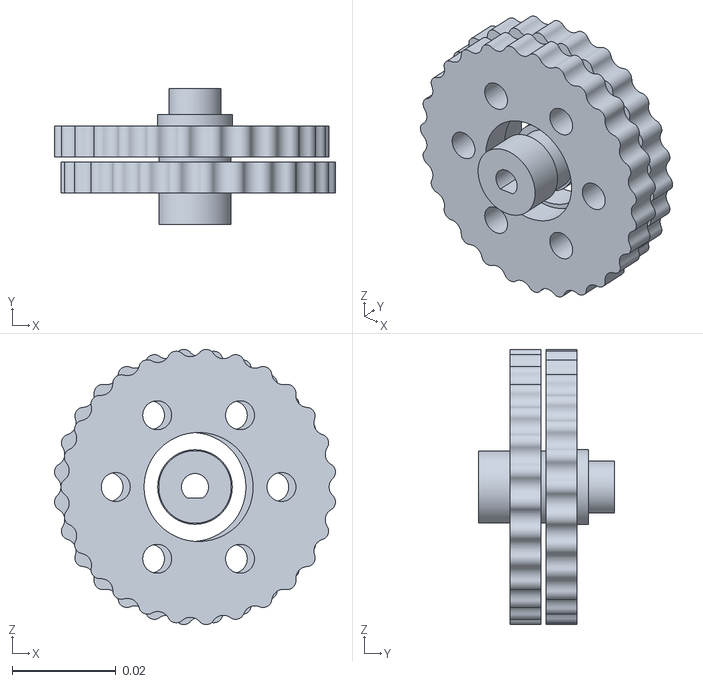
[picture p19: CAD file, 2026-11-13]
models/robot-arm-urdf-v4/meshes/visual/Link4__87CEEB.stl
0.0543 x 0.0263 x 0.0531
