WINNAKEN/robot-arm-lab/models/robot-arm-urdf-v4/meshes/collision/Link3.stl

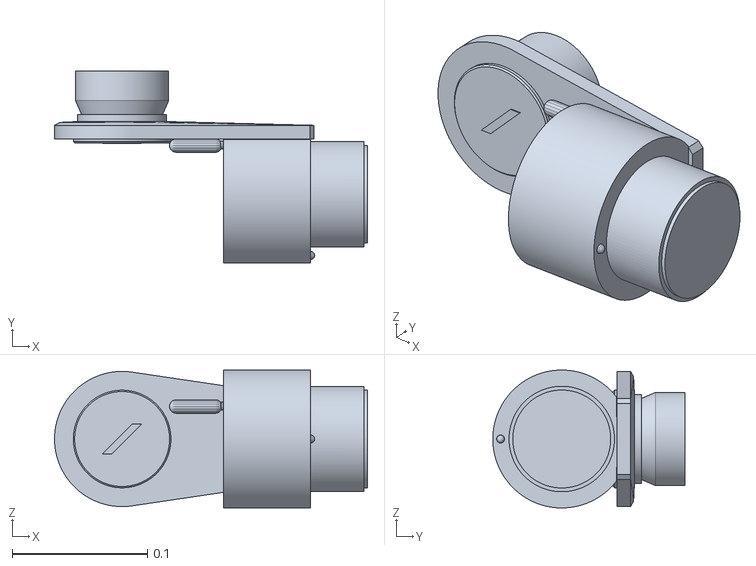
[picture p20: CAD file, 2026-11-13]
models/robot-arm-urdf-v4/meshes/collision/Link3.stl
0.232 x 0.142 x 0.102
