WINNAKEN/robot-arm-lab/models/robot-arm-urdf-v4/meshes/visual/Link5__0B2545.stl

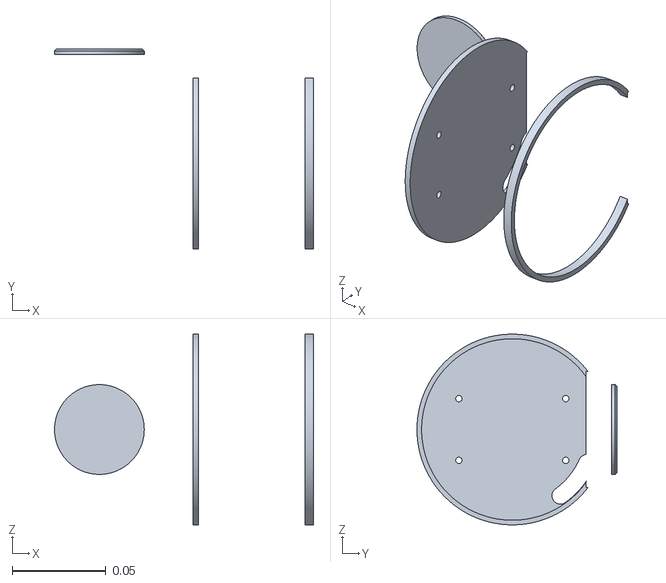
[picture p22: CAD file, 2026-11-13]
models/robot-arm-urdf-v4/meshes/visual/Link5__0B2545.stl
0.139 x 0.107 x 0.102
