WINNAKEN/robot-arm-lab/models/robot-arm-urdf-v4/meshes/visual/Link1__FFFFFF.stl

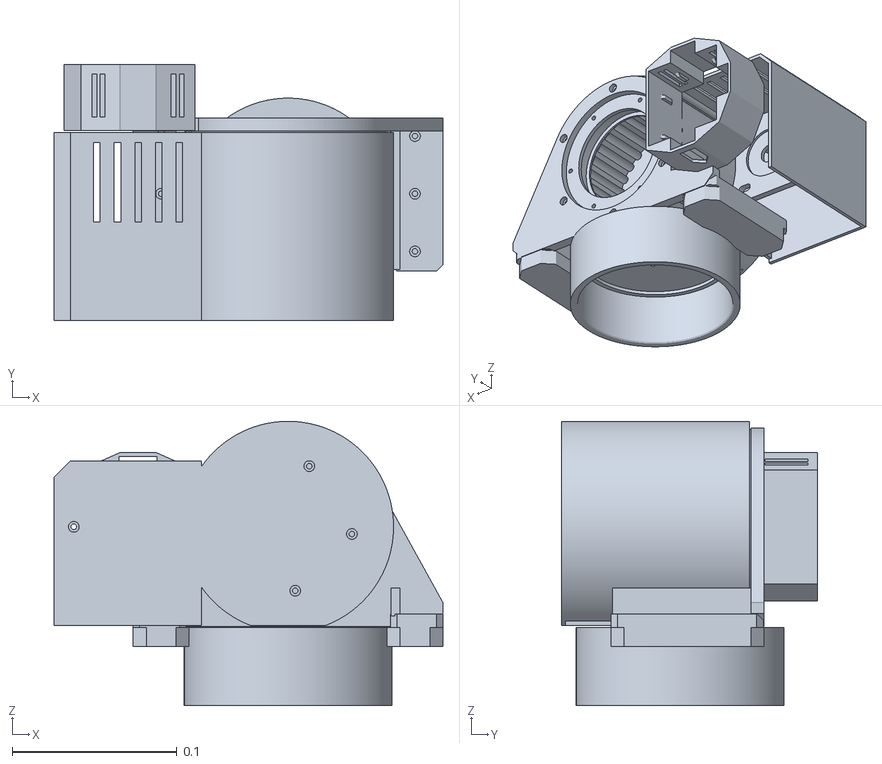
[picture p25: CAD file, 2026-11-13]
models/robot-arm-urdf-v4/meshes/visual/Link1__FFFFFF.stl
0.236 x 0.155 x 0.173
