WINNAKEN/robot-arm-lab/models/robot-arm-urdf-v4/meshes/collision/Link2.stl

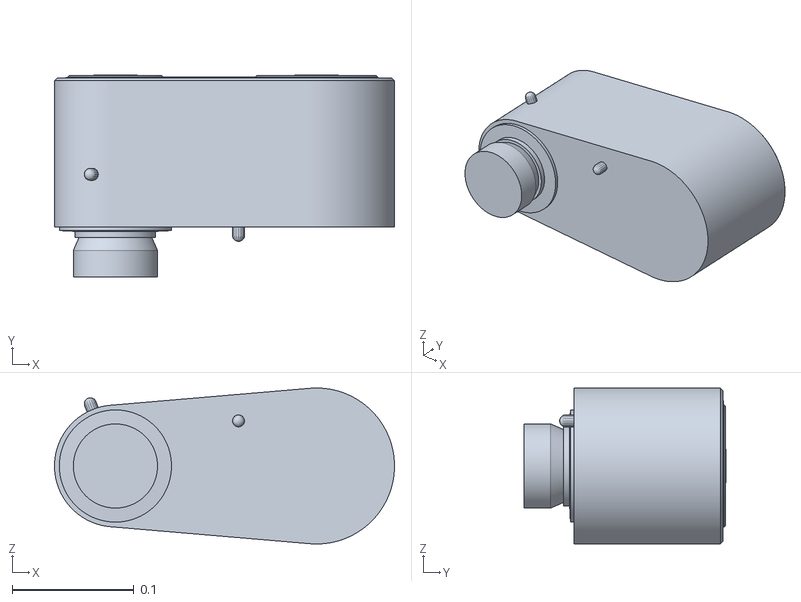
[picture p26: CAD file, 2026-11-13]
models/robot-arm-urdf-v4/meshes/collision/Link2.stl
0.279 x 0.166 x 0.128
