WINNAKEN/robot-arm-lab/models/robot-arm-urdf-v4/meshes/KG1.stl

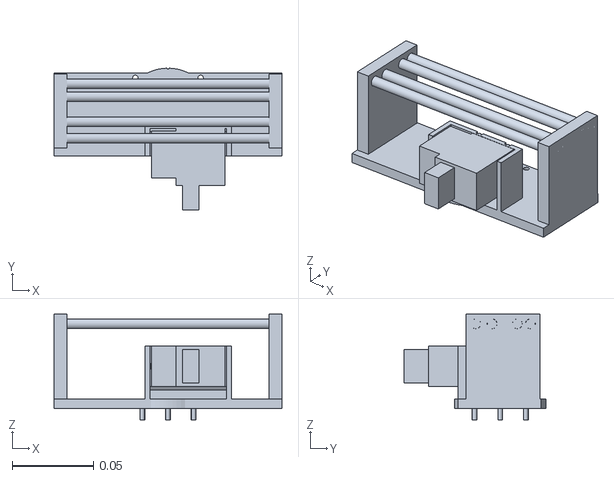
[picture p27: CAD file, 2026-11-13]
models/robot-arm-urdf-v4/meshes/KG1.stl
0.14 x 0.087 x 0.065
