WINNAKEN/robot-arm-lab/models/robot-arm-urdf-v4/meshes/visual/Link5__34D399.stl

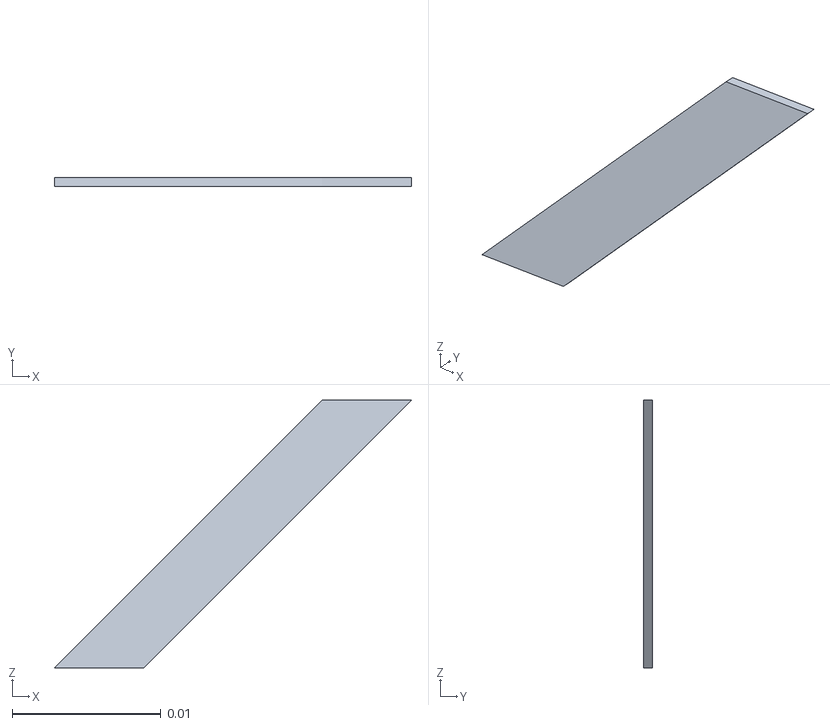
[picture p28: CAD file, 2026-11-13]
models/robot-arm-urdf-v4/meshes/visual/Link5__34D399.stl
0.024 x 0.00062 x 0.018
