WINNAKEN/robot-arm-lab/models/robot-arm-urdf-v4/meshes/Link6.stl

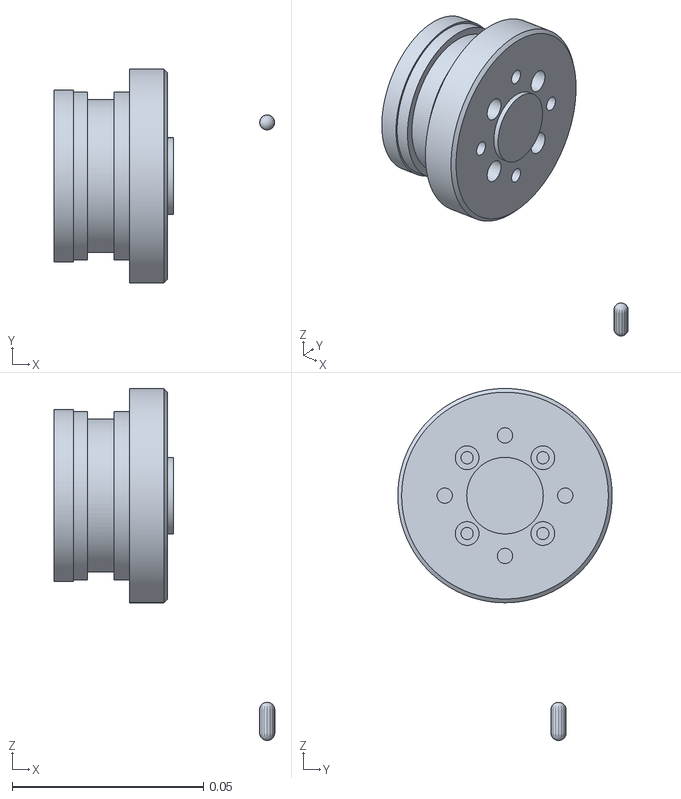
[picture p29: CAD file, 2026-11-13]
models/robot-arm-urdf-v4/meshes/Link6.stl
0.0576 x 0.056 x 0.092
