WINNAKEN/robot-arm-lab/models/robot-arm-urdf-v4/meshes/visual/Link5__6B7280.stl

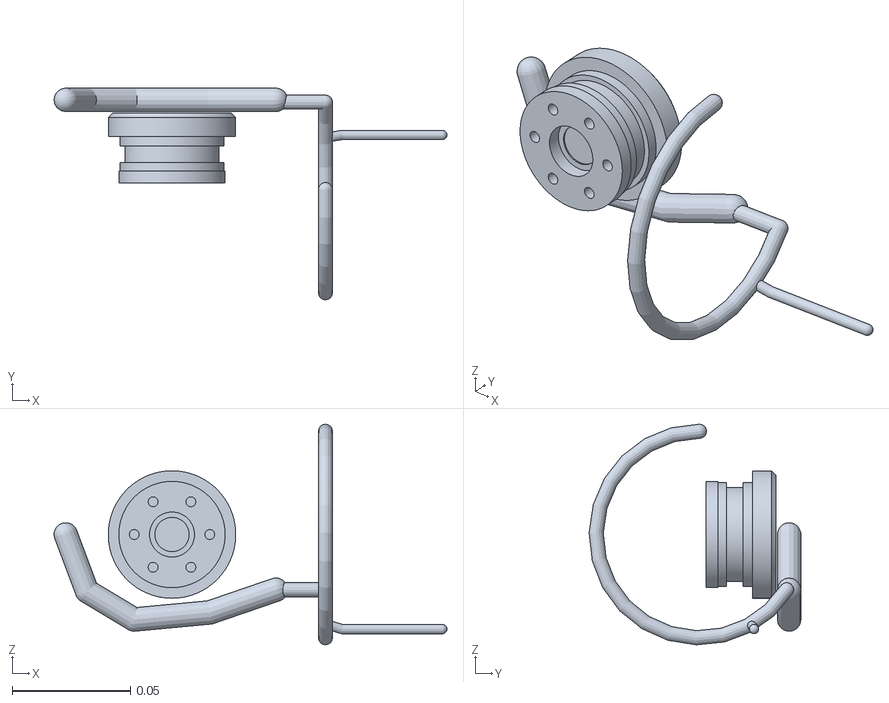
[picture p30: CAD file, 2026-11-13]
models/robot-arm-urdf-v4/meshes/visual/Link5__6B7280.stl
0.166 x 0.0897 x 0.0935
