WINNAKEN/robot-arm-lab/models/robot-arm-urdf-v4/meshes/collision/KG1_A.stl

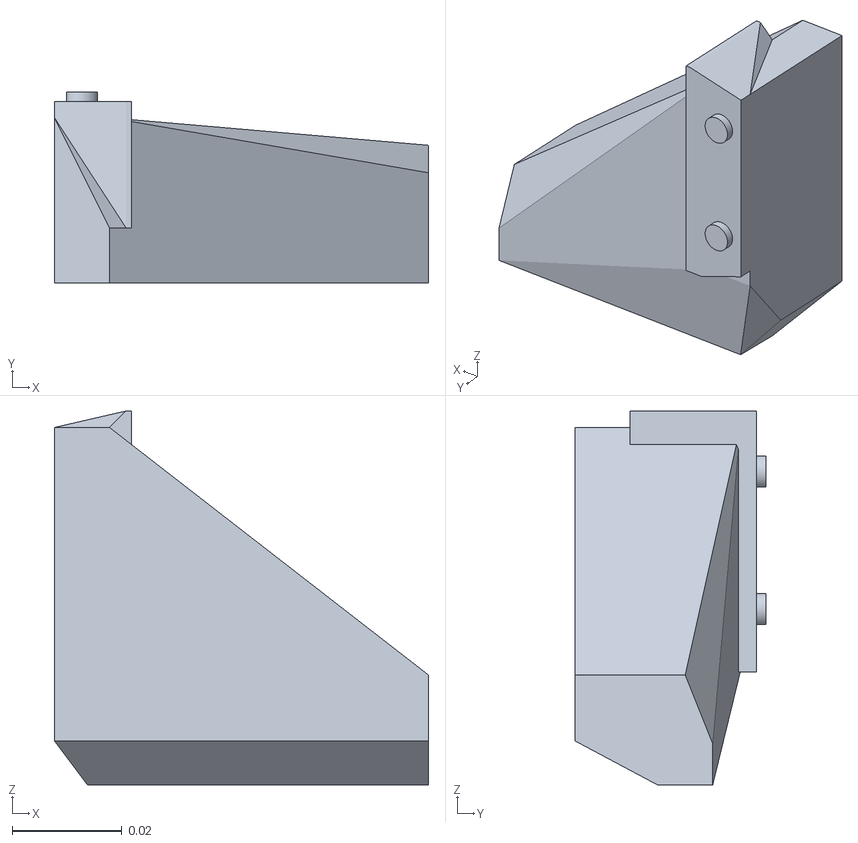
[picture p31: CAD file, 2026-11-13]
models/robot-arm-urdf-v4/meshes/collision/KG1_A.stl
0.068 x 0.0346 x 0.068
