WINNAKEN/robot-arm-lab/models/robot-arm-urdf-v4/meshes/KG1_R.stl

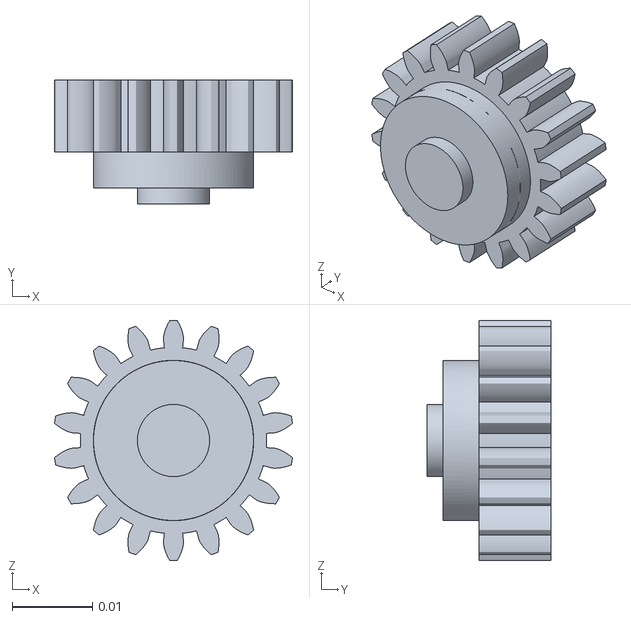
[picture p32: CAD file, 2026-11-13]
models/robot-arm-urdf-v4/meshes/KG1_R.stl
0.0297 x 0.0155 x 0.03
