WINNAKEN/robot-arm-lab/models/robot-arm-urdf-v4/meshes/visual/KG1__6B7280.stl

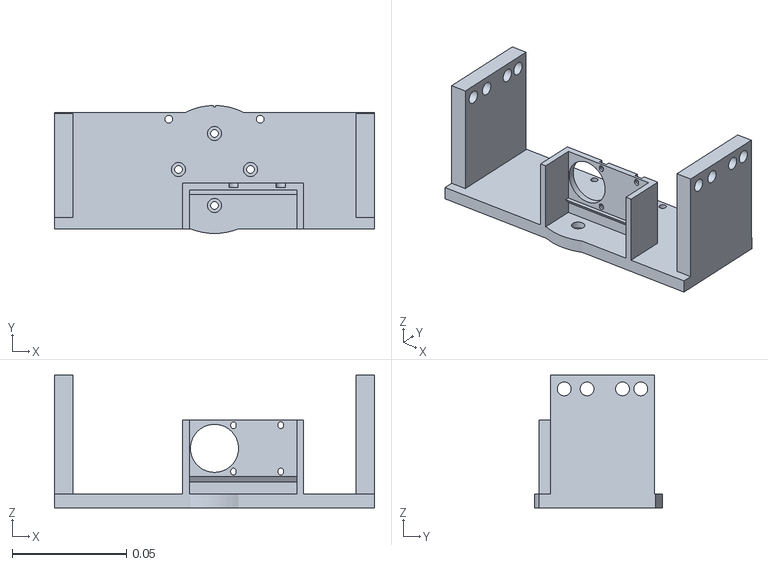
[picture p33: CAD file, 2026-11-13]
models/robot-arm-urdf-v4/meshes/visual/KG1__6B7280.stl
0.14 x 0.056 x 0.058
