WINNAKEN/robot-arm-lab/models/robot-arm-urdf-v4/meshes/visual/Link4__6B7280.stl

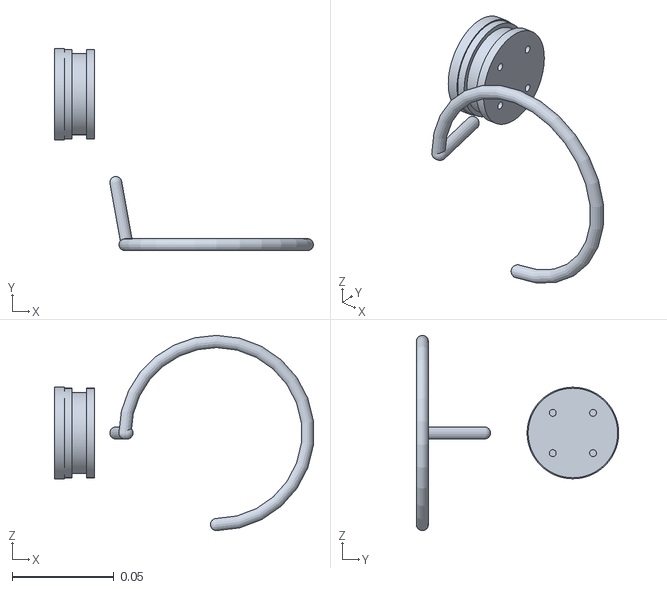
[picture p34: CAD file, 2026-11-13]
models/robot-arm-urdf-v4/meshes/visual/Link4__6B7280.stl
0.127 x 0.0995 x 0.096
