WINNAKEN/robot-arm-lab/models/robot-arm-urdf-v4/meshes/visual/Link4__0B2545.stl

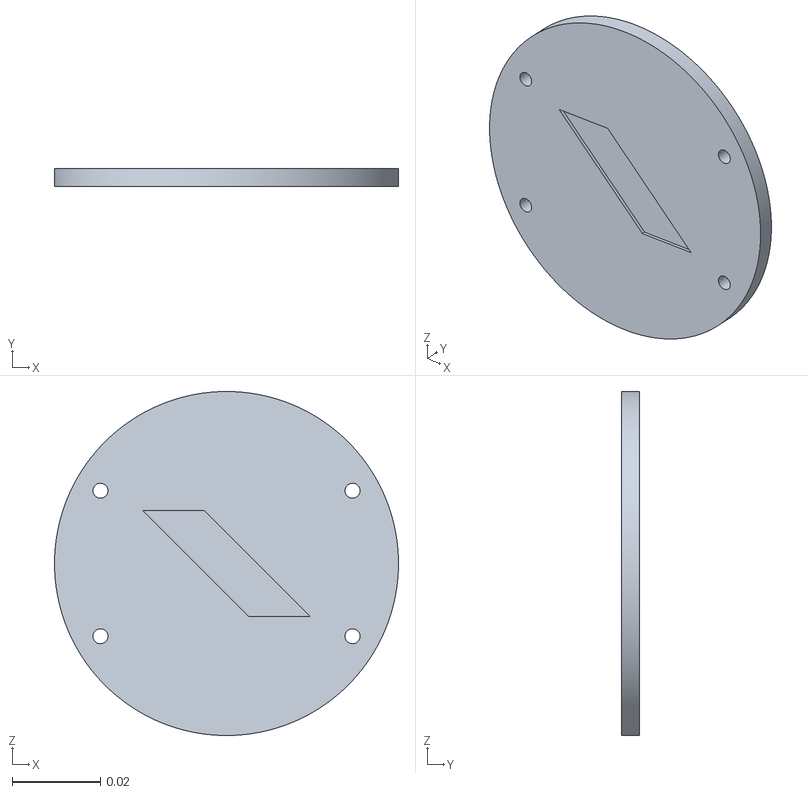
[picture p35: CAD file, 2026-11-13]
models/robot-arm-urdf-v4/meshes/visual/Link4__0B2545.stl
0.078 x 0.004 x 0.078
