WINNAKEN/robot-arm-lab/models/robot-arm-urdf-v4/meshes/visual/Base__34D399.stl

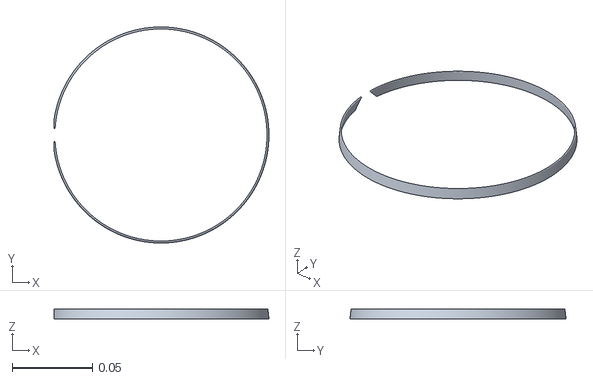
[picture p36: CAD file, 2026-11-13]
models/robot-arm-urdf-v4/meshes/visual/Base__34D399.stl
0.134 x 0.135 x 0.006
