WINNAKEN/robot-arm-lab/models/robot-arm-urdf-v4/meshes/visual/Link2__141416.stl

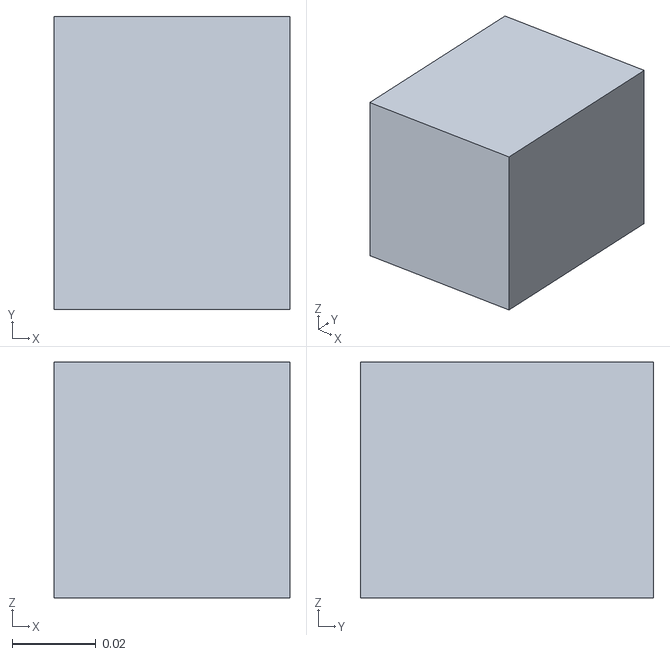
[picture p37: CAD file, 2026-11-13]
models/robot-arm-urdf-v4/meshes/visual/Link2__141416.stl
0.0564 x 0.0701 x 0.0564
