WINNAKEN/robot-arm-lab/models/robot-arm-urdf-v4/meshes/visual/Link3__6B7280.stl

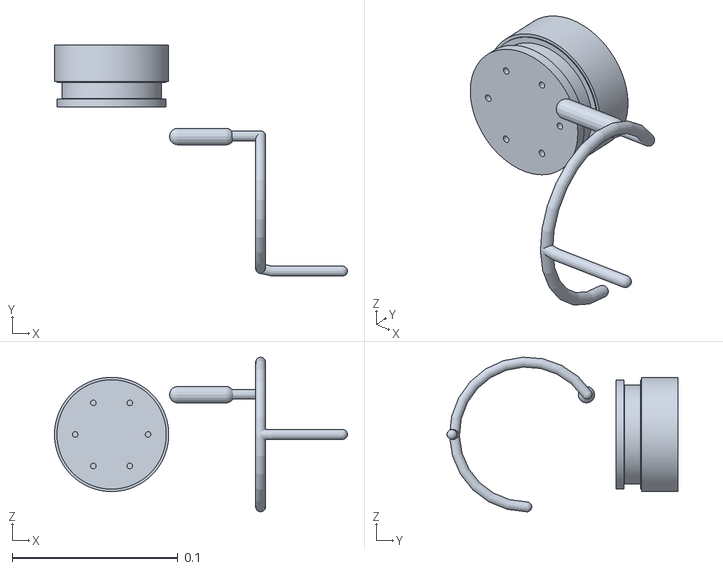
[picture p38: CAD file, 2026-11-13]
models/robot-arm-urdf-v4/meshes/visual/Link3__6B7280.stl
0.177 x 0.14 x 0.0934
