WINNAKEN/robot-arm-lab/models/robot-arm-urdf-v4/meshes/visual/Link2__6B7280.stl

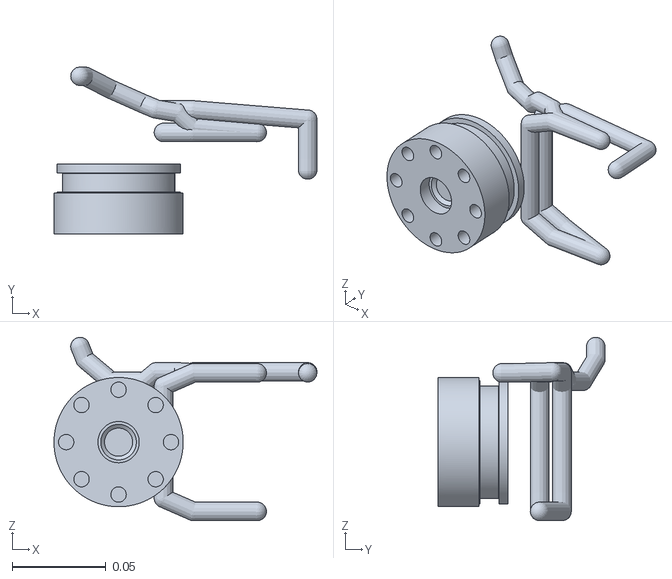
[picture p39: CAD file, 2026-11-13]
models/robot-arm-urdf-v4/meshes/visual/Link2__6B7280.stl
0.14 x 0.0893 x 0.098
