WINNAKEN/robot-arm-lab/models/robot-arm-urdf-v4/meshes/visual/Link1__87CEEB.stl

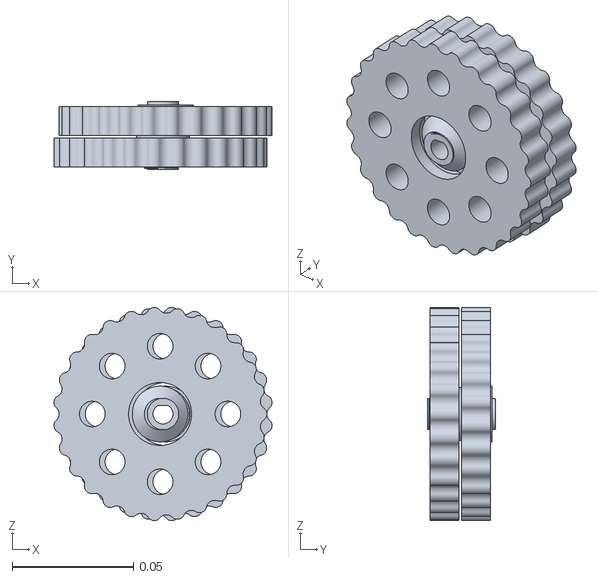
[picture p40: CAD file, 2026-11-13]
models/robot-arm-urdf-v4/meshes/visual/Link1__87CEEB.stl
0.09 x 0.028 x 0.0881
