WINNAKEN/robot-arm-lab/models/robot-arm-urdf-v4/meshes/visual/Link3__FFFFFF.stl

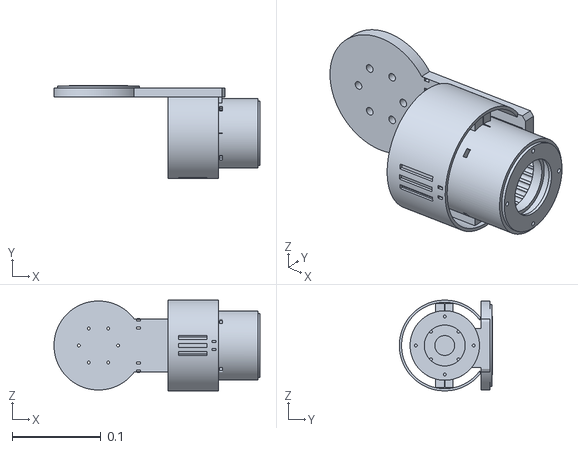
[picture p41: CAD file, 2026-11-13]
models/robot-arm-urdf-v4/meshes/visual/Link3__FFFFFF.stl
0.232 x 0.105 x 0.102
