WINNAKEN/robot-arm-lab/models/robot-arm-urdf-v4/meshes/visual/Link3__34D399.stl

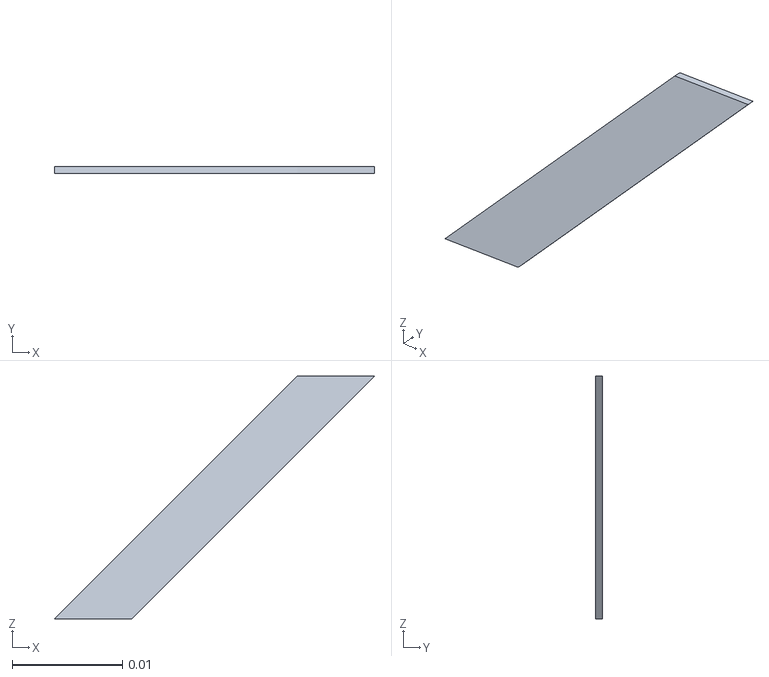
[picture p43: CAD file, 2026-11-13]
models/robot-arm-urdf-v4/meshes/visual/Link3__34D399.stl
0.029 x 0.00062 x 0.022
