WINNAKEN/robot-arm-lab/models/robot-arm-urdf-v4/meshes/visual/KG1_B__FFFFFF.stl

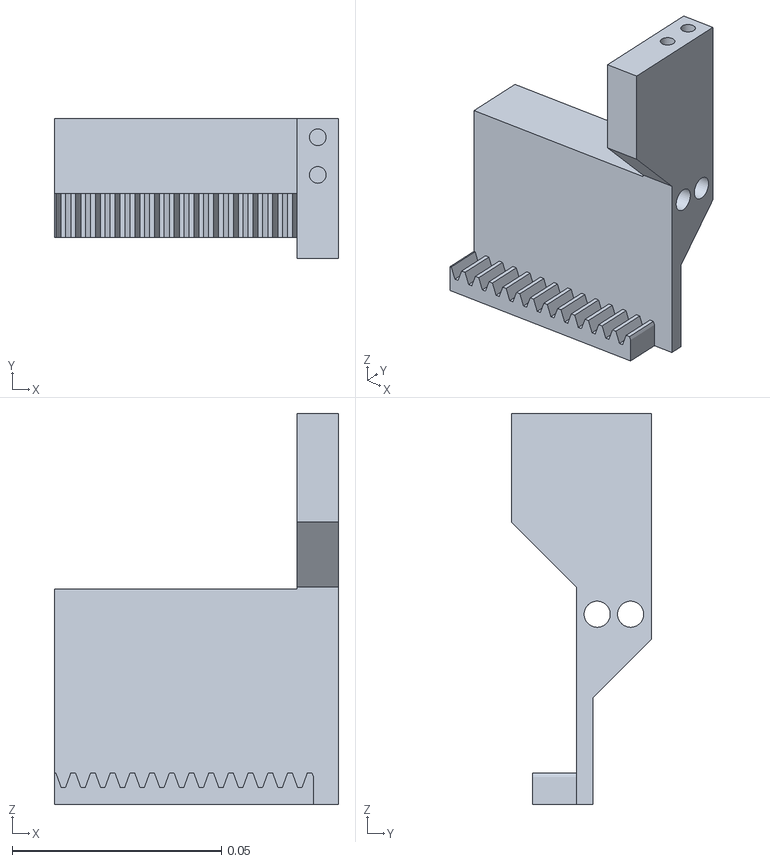
[picture p44: CAD file, 2026-11-13]
models/robot-arm-urdf-v4/meshes/visual/KG1_B__FFFFFF.stl
0.068 x 0.0335 x 0.0935
