WINNAKEN/robot-arm-lab/models/robot-arm-urdf-v4/meshes/visual/Link2__FFFFFF.stl

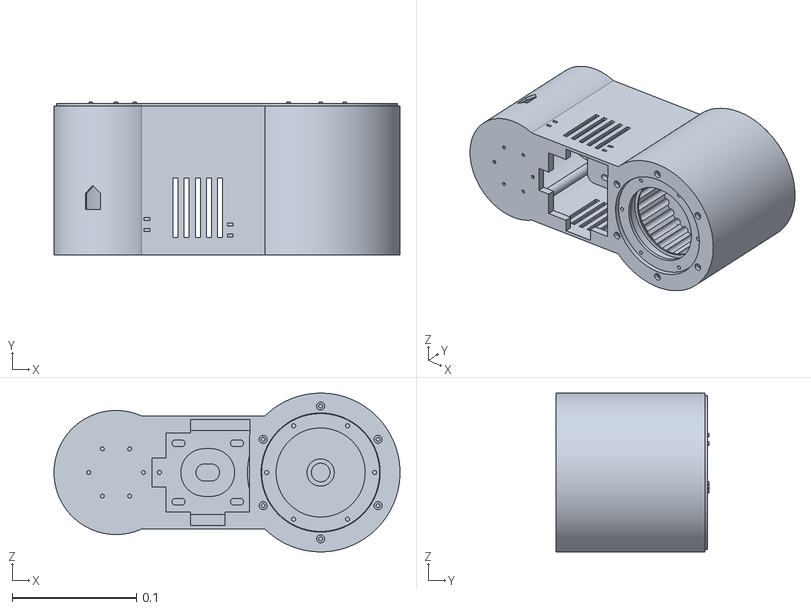
[picture p45: CAD file, 2026-11-13]
models/robot-arm-urdf-v4/meshes/visual/Link2__FFFFFF.stl
0.279 x 0.123 x 0.128
