WINNAKEN/robot-arm-lab/models/robot-arm-urdf-v4/meshes/visual/Link2__0B2545.stl

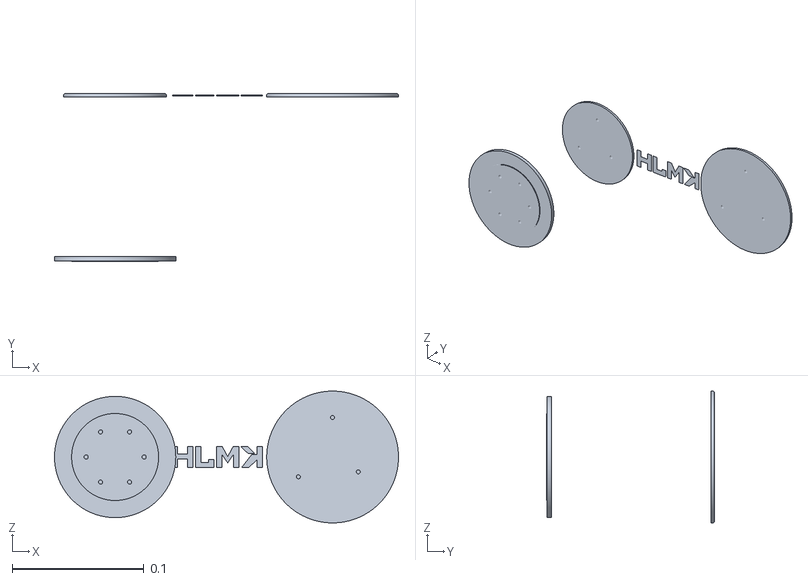
[picture p46: CAD file, 2026-11-13]
models/robot-arm-urdf-v4/meshes/visual/Link2__0B2545.stl
0.261 x 0.128 x 0.1
