WINNAKEN/robot-arm-lab/models/robot-arm-urdf-v4/meshes/visual/Base__FFFFFF.stl

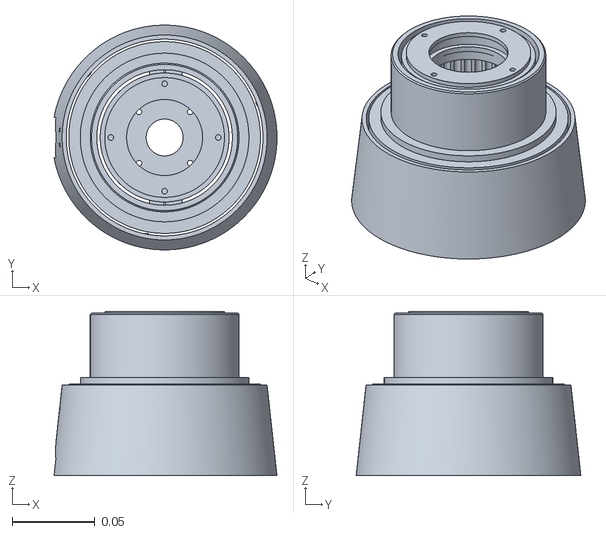
[picture p47: CAD file, 2026-11-13]
models/robot-arm-urdf-v4/meshes/visual/Base__FFFFFF.stl
0.135 x 0.136 x 0.0995
