WINNAKEN/robot-arm-lab/models/robot-arm-urdf-v4/meshes/visual/Link6__6B7280.stl

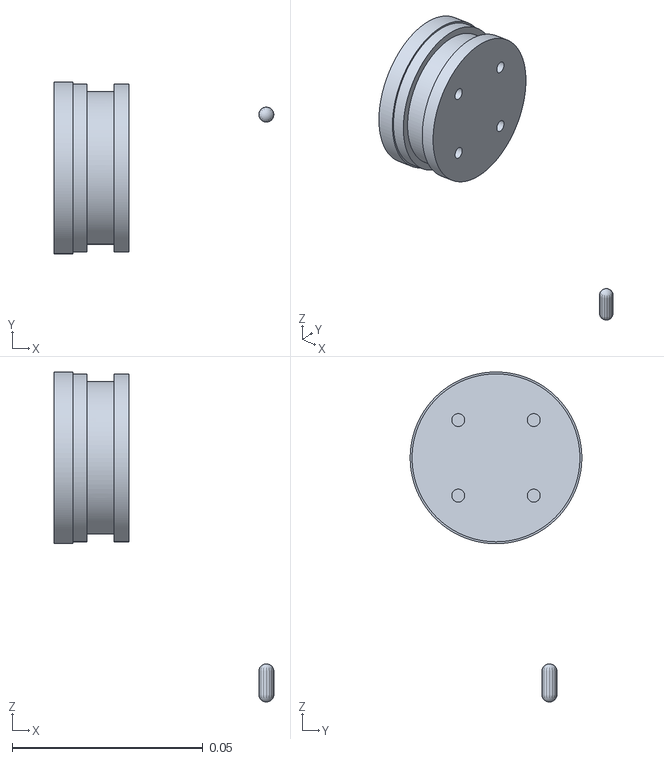
[picture p48: CAD file, 2026-11-13]
models/robot-arm-urdf-v4/meshes/visual/Link6__6B7280.stl
0.0576 x 0.045 x 0.0865
