WINNAKEN/robot-arm-lab/models/robot-arm-urdf-v4/meshes/visual/Link5__FFFFFF.stl

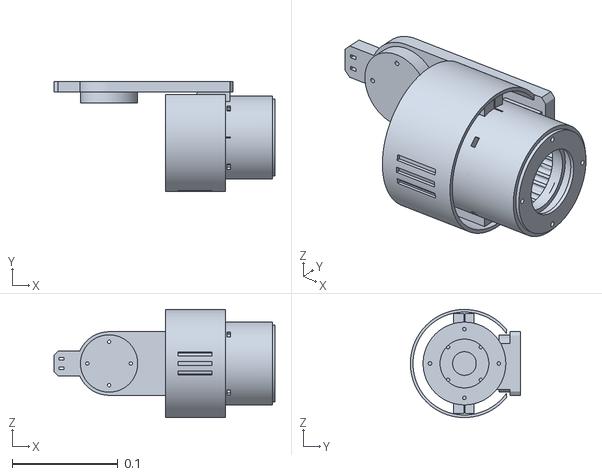
[picture p49: CAD file, 2026-11-13]
models/robot-arm-urdf-v4/meshes/visual/Link5__FFFFFF.stl
0.208 x 0.104 x 0.102
