WINNAKEN/robot-arm-lab/models/robot-arm-urdf-v4/meshes/visual/Link1__0B2545.stl

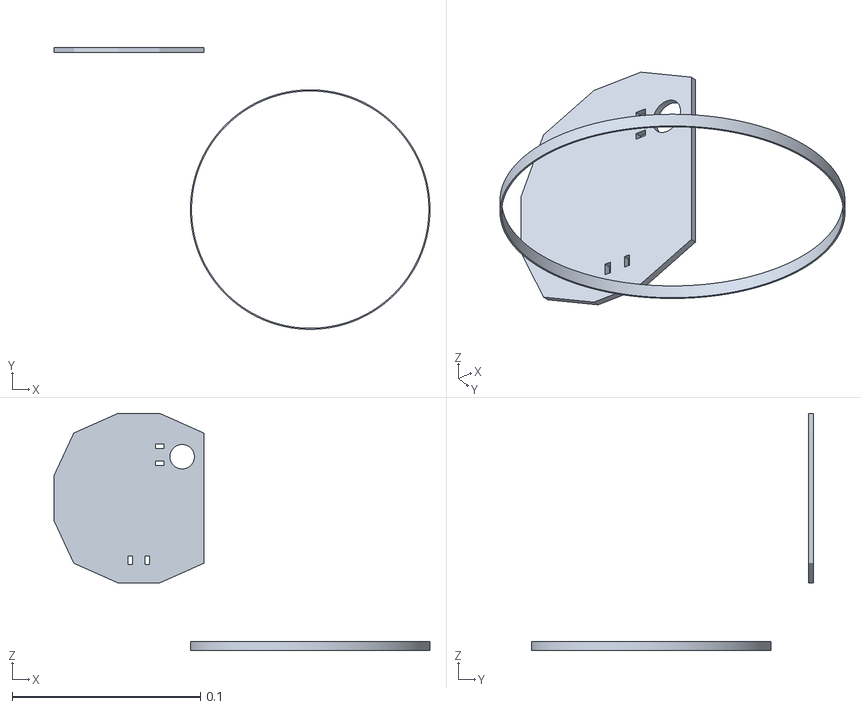
[picture p50: CAD file, 2026-11-13]
models/robot-arm-urdf-v4/meshes/visual/Link1__0B2545.stl
0.2 x 0.15 x 0.126
