WINNAKEN/robot-arm-lab/models/robot-arm-urdf-v4/meshes/visual/KG1__9CA3AF.stl

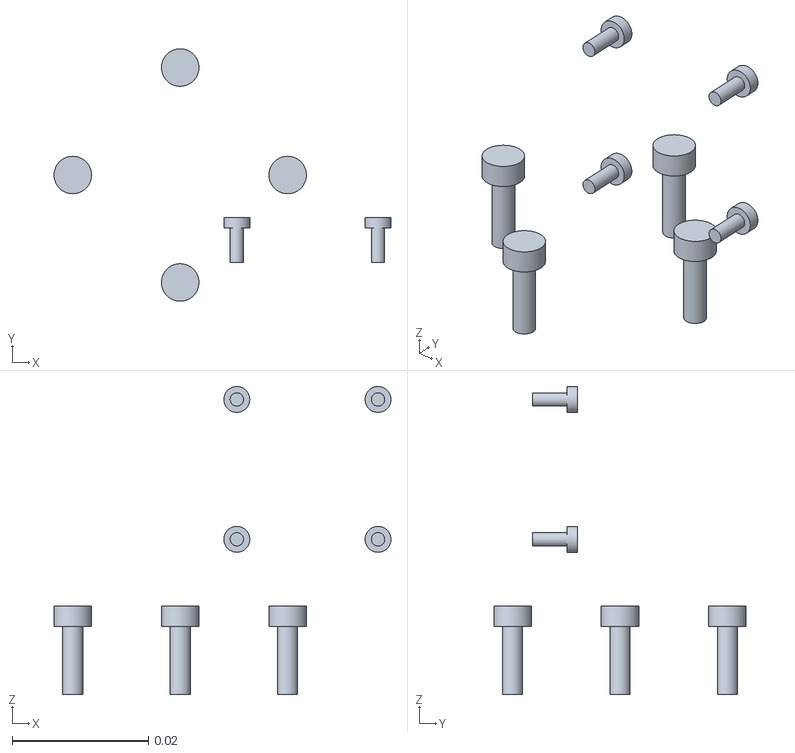
[picture p51: CAD file, 2026-11-13]
models/robot-arm-urdf-v4/meshes/visual/KG1__9CA3AF.stl
0.0494 x 0.037 x 0.0452
