WINNAKEN/robot-arm-lab/models/robot-arm-urdf-v4/meshes/visual/KG1_R__0B2545.stl

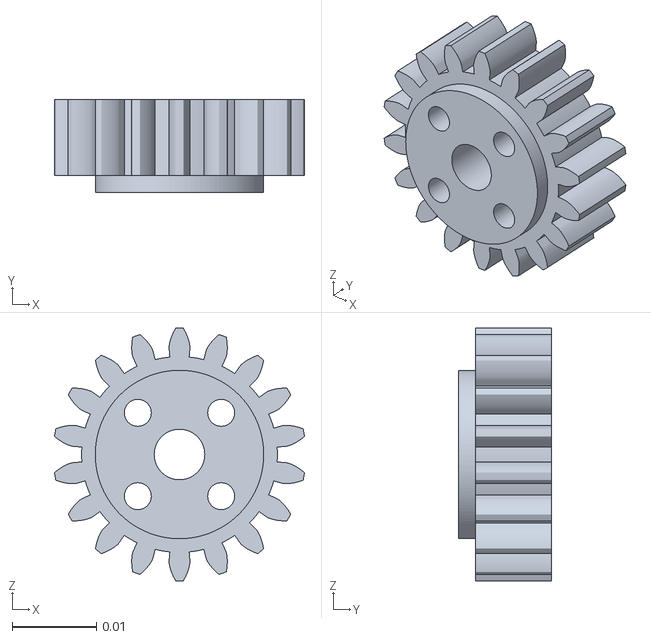
[picture p52: CAD file, 2026-11-13]
models/robot-arm-urdf-v4/meshes/visual/KG1_R__0B2545.stl
0.0297 x 0.011 x 0.03
