WINNAKEN/robot-arm-lab/models/robot-arm-urdf-v4/meshes/visual/Link1__141416.stl

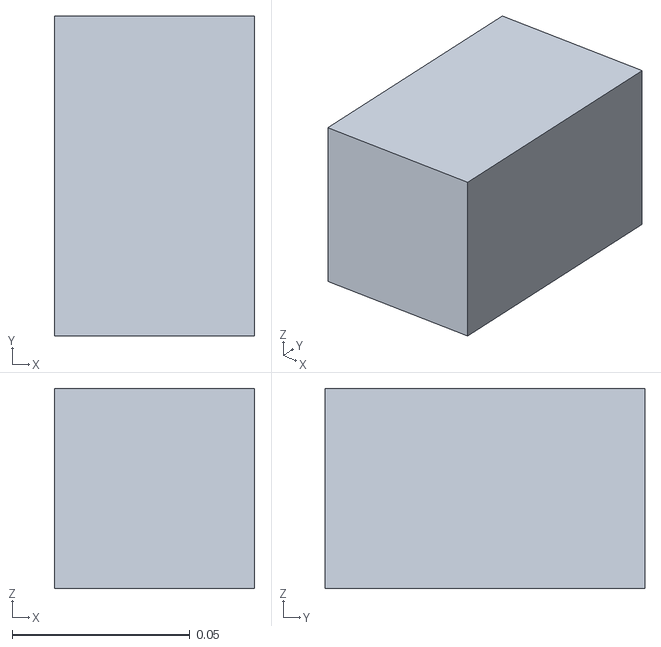
[picture p53: CAD file, 2026-11-13]
models/robot-arm-urdf-v4/meshes/visual/Link1__141416.stl
0.0564 x 0.0901 x 0.0564
