WINNAKEN/robot-arm-lab/models/robot-arm-urdf-v4/meshes/visual/Link3__0B2545.stl

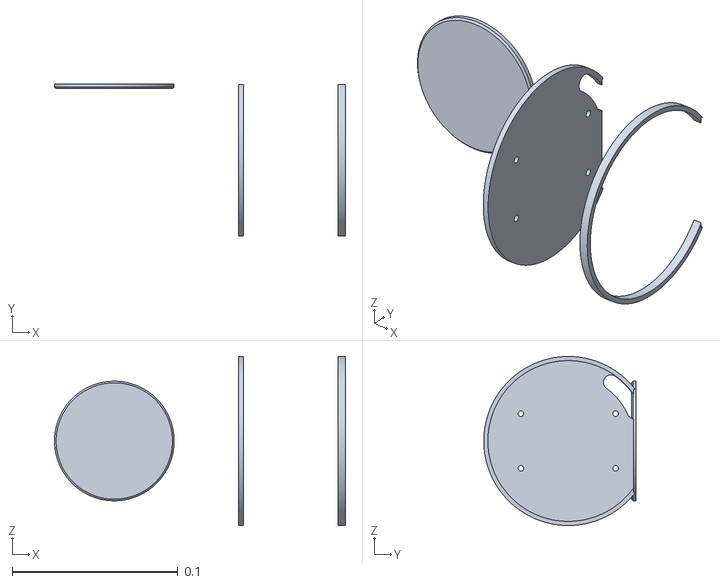
[picture p54: CAD file, 2026-11-13]
models/robot-arm-urdf-v4/meshes/visual/Link3__0B2545.stl
0.176 x 0.092 x 0.102
