WINNAKEN/robot-arm-lab/models/robot-arm-urdf-v4/meshes/visual/KG1__141416.stl

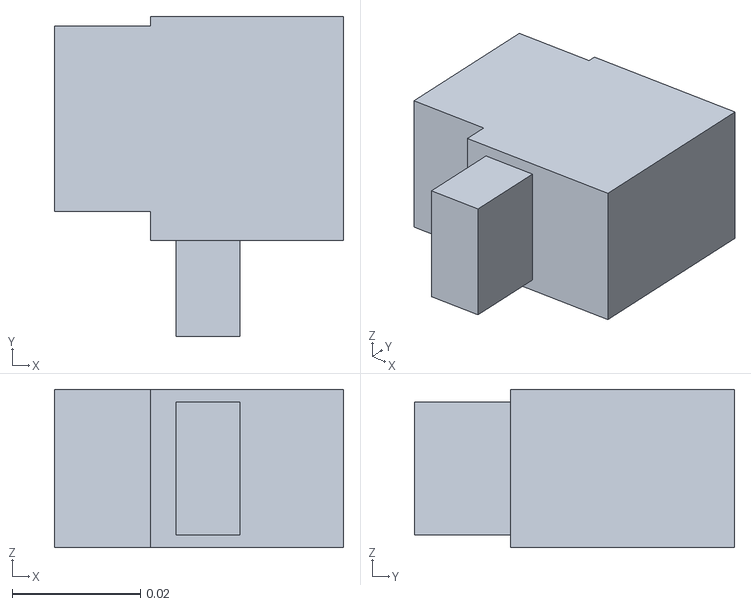
[picture p55: CAD file, 2026-11-13]
models/robot-arm-urdf-v4/meshes/visual/KG1__141416.stl
0.0452 x 0.05 x 0.0247
