WINNAKEN/robot-arm-lab/models/robot-arm-urdf-v4/meshes/visual/KG1_R__3A3A3A.stl

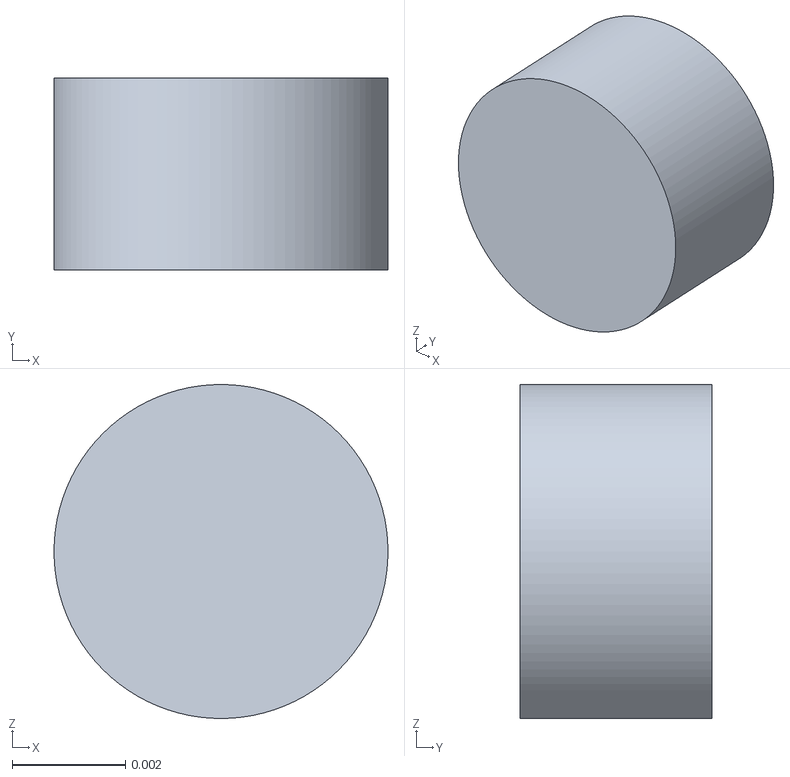
[picture p56: CAD file, 2026-11-13]
models/robot-arm-urdf-v4/meshes/visual/KG1_R__3A3A3A.stl
0.0059 x 0.0034 x 0.0059
