WINNAKEN/robot-arm-lab/models/robot-arm-urdf-v4/meshes/visual/Link1__6B7280.stl

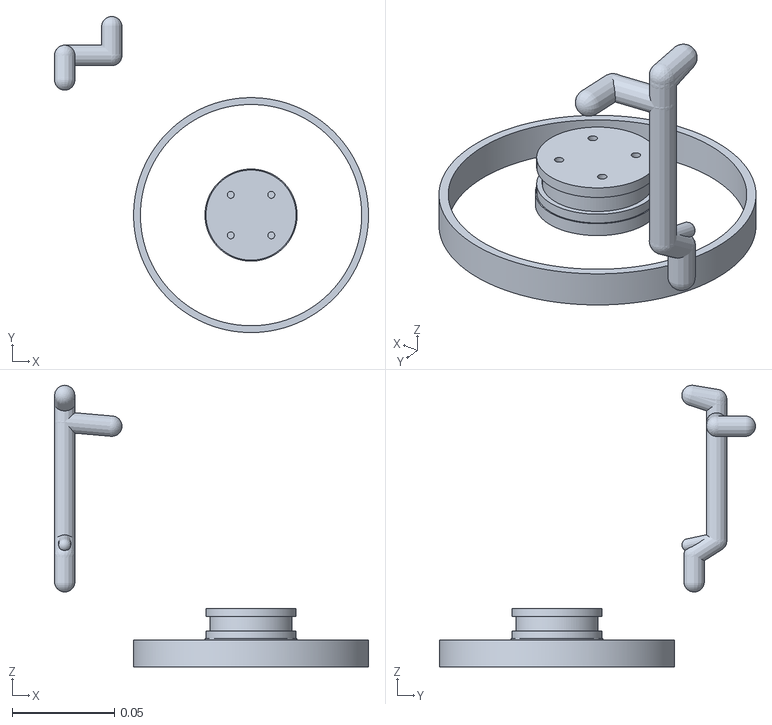
[picture p57: CAD file, 2026-11-13]
models/robot-arm-urdf-v4/meshes/visual/Link1__6B7280.stl
0.153 x 0.154 x 0.137
