WINNAKEN/robot-arm-lab/models/robot-arm-urdf-v4/meshes/visual/Base__6B7280.stl

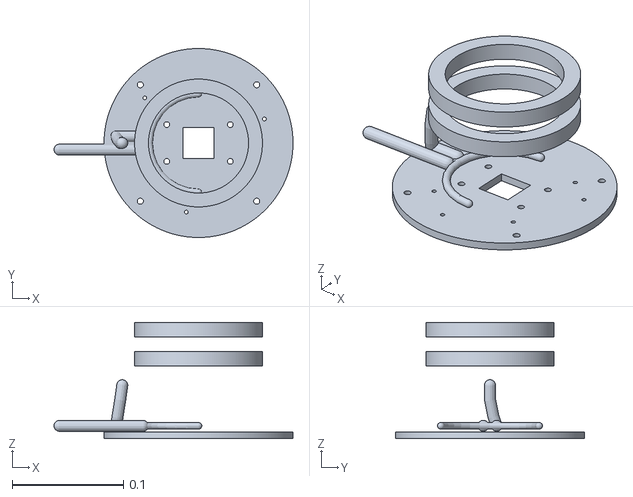
[picture p58: CAD file, 2026-11-13]
models/robot-arm-urdf-v4/meshes/visual/Base__6B7280.stl
0.215 x 0.17 x 0.105
