WINNAKEN/robot-arm-lab/models/robot-arm-urdf-v4/meshes/visual/KG1_B__6B7280.stl

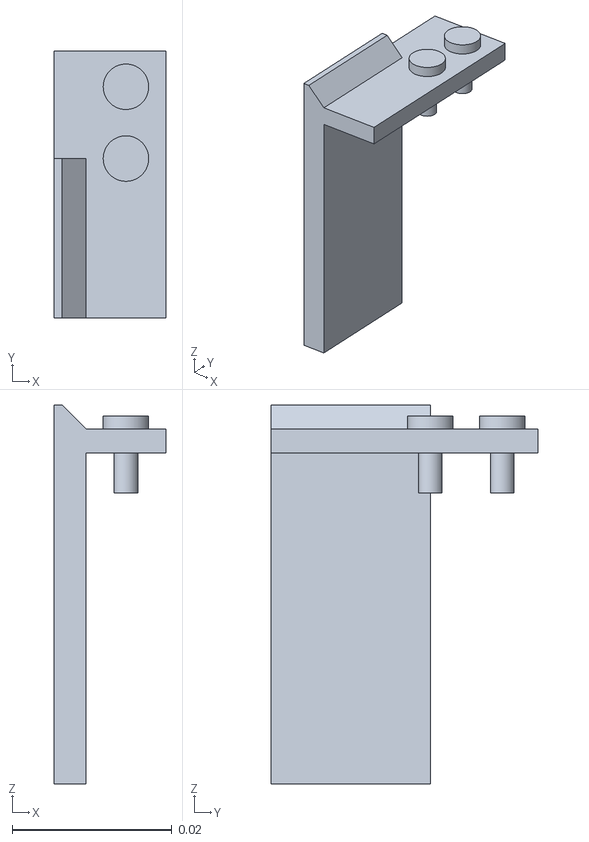
[picture p59: CAD file, 2026-11-13]
models/robot-arm-urdf-v4/meshes/visual/KG1_B__6B7280.stl
0.014 x 0.0335 x 0.0475
