WINNAKEN/robot-arm-lab/models/robot-arm-urdf-v4/meshes/visual/KG1_R__9CA3AF.stl

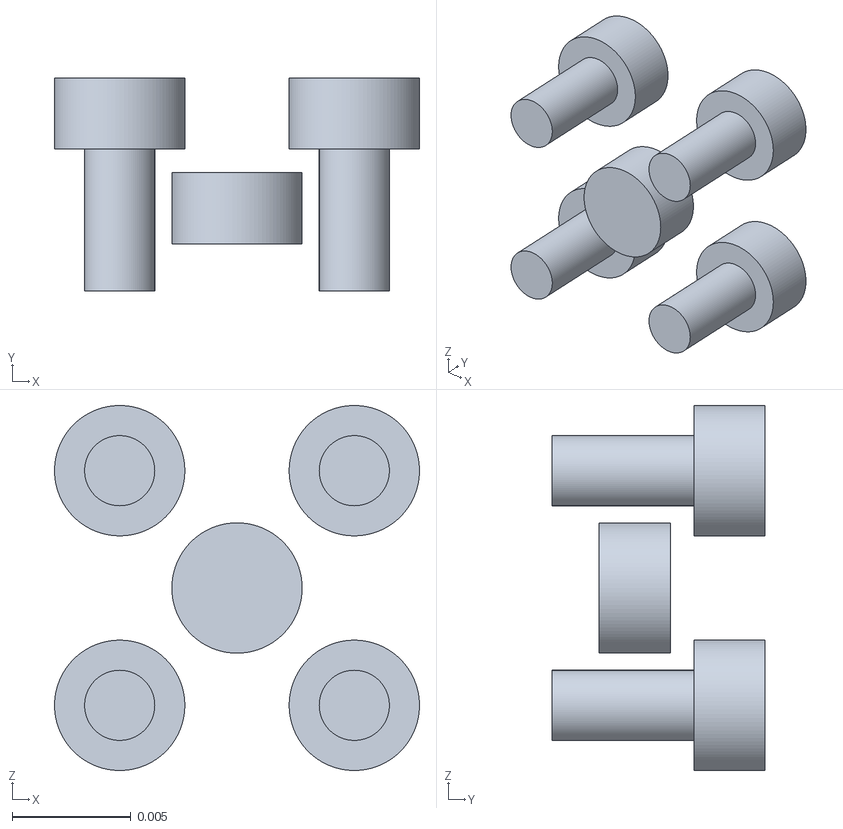
[picture p60: CAD file, 2026-11-13]
models/robot-arm-urdf-v4/meshes/visual/KG1_R__9CA3AF.stl
0.0154 x 0.009 x 0.0154
