WINNAKEN/robot-arm-lab/models/robot-arm-urdf-v4/meshes/visual/KG1__0A0A0A.stl

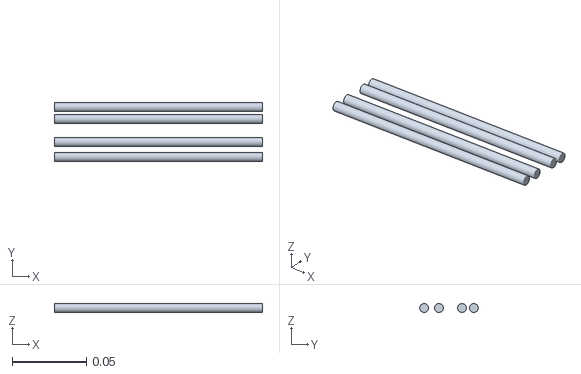
[picture p61: CAD file, 2026-11-13]
models/robot-arm-urdf-v4/meshes/visual/KG1__0A0A0A.stl
0.14 x 0.0395 x 0.00596
