WINNAKEN/robot-arm-lab/models/robot-arm-urdf-v4/meshes/visual/Link6__34D399.stl

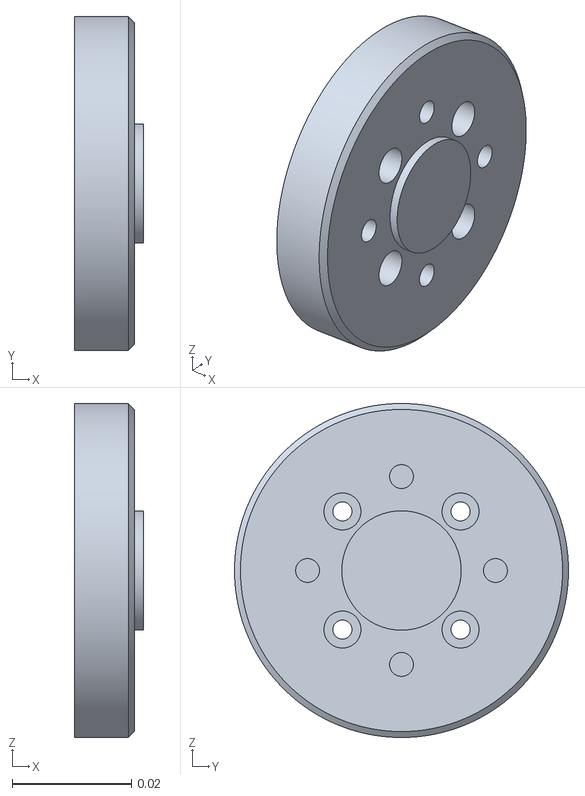
[picture p62: CAD file, 2026-11-13]
models/robot-arm-urdf-v4/meshes/visual/Link6__34D399.stl
0.0115 x 0.056 x 0.056
