WINNAKEN/robot-arm-lab/(list of files, cad)

Other CAD files:
models/robot-arm-urdf-v4/meshes/collision/Base.stl
models/robot-arm-urdf-v4/meshes/visual/Base__141416.stl
models/robot-arm-urdf-v4/meshes/visual/Link3__87CEEB.stl
models/robot-arm-urdf-v4/meshes/visual/Link5__87CEEB.stl
models/robot-arm-urdf-v4/meshes/visual/Base__87CEEB.stl
models/robot-arm-urdf-v4/meshes/visual/Link2__87CEEB.stl
models/robot-arm-urdf-v4/meshes/visual/Link4__141416.stl
models/robot-arm-urdf-v4/meshes/visual/Link5__141416.stl
