WINNAKEN/robot-arm-lab/models/arm-v3-kg1-assembly/README.md

# 외장 v3 + 그리퍼 KG1 조립 (MP9 · 계획 051 · 2026-10-28)

> 보기 · 검사용 조립이다. 커밋된 STL 을 읽어 붙인 자리를 계산하고, 자세마다 닿는지 잰다. 그리퍼 KG1 파일은 고치지 않았다.
> 1 단계 사용자 「지금 붙여놓자 일단 만들어놓고 조금씩 수정하면되는거니깐」 · **2 단계(rev1)** 「v3 민트 고리를 그리퍼 규격(Ø20 × 1.5 돌기 + M3 Ø31.5 나사 자리)에 맞게
> 고쳐서 다시 붙여줘」 → 팔 v3 의 공구 끝만 고쳐(`models/armold-mks-product-v3/README.md` 의 rev1) 다시 붙였다. 붙이는 면 · 돌림은 매개변수 하나씩.

표시 자세

## 붙인 자리 (2 단계)

- 붙이는 면 = **공구 플랜지 면**(J6 원점에서 J6 축 방향 28 mm) — v3 돌기(Ø20 × 1.5)가 그리퍼 받침의 맞춤 홈(Ø20 × 1.5)에 들어가고, 받침 아랫면(G 원점)이 플랜지 면에 닿는다.
- 돌림 = 0° → 그리퍼 x(턱이 움직이는 쪽) = 링크 6 지역 y(q6 = 0 에서 J5 축과 나란함) · 그리퍼 z = J6 축 바깥 · 그리퍼 y = 링크 6 지역 z.
  v3 플랜지 구멍이 0° · 90° · 180° · 270° 라 돌림은 90° 배수만 나사가 맞는다(다른 각이면 검사가 팔 나사 겹침으로 잡음).
- 행렬 = `assembly.json` 의 `g_to_world_display`(표시 자세 세계 · mm) · `g_to_link6_local`(링크 6 지역 = 원점 J6 · 축 = v1 kinematics J6 `R_child` 열).
- 쥐는 점(G (0, 0, 103)) = J6 축 위 · J6 원점에서 131 mm. 그리퍼 184.2 g · 무게중심 링크 6 지역 (63.8, 3.4, −6.9) mm(출처 `models/kmjh-gripper-v1/mass-properties.json`).

## 맞춤면 (2 단계에서 맞춤)

| | 팔 v3 rev1 | 그리퍼 KG1 |
|---|---|---|
| 가운데 | 민트 **돌기 Ø20 × 1.5**(옛 고리 Ø40 × 4) | 받침 아랫면 맞춤 홈 Ø20 × 1.5 |
| 나사 | 공구 플랜지에 **M3 열압입 인서트 구멍 넷 Ø4.0 × 깊이 8 · Ø31.5 원 · 0°**(원장 `insert_hole_dia` 확정 값) | M3 × 10 넷 · Ø31.5 원 · 몸통이 받침 밑으로 7 mm 나옴 → 구멍 안(겹침 0) |

- 돌기 ↔ 홈은 사용자 수치 그대로 **공칭 틈 0** 이다. 두 STL 이 원을 다른 다각형으로 잘라 공칭에서도 0.9 mm³ 쯤 겹쳐 보이므로, 검사는 돌기를 반지름 0.05 mm 들여
  잰 겹침으로 판정하고 원래 값은 `check.json` `mount_contact.fit_pairs` 에 적는다(그리퍼를 옆으로 0.5 mm 밀면 13 mm³ 로 잡히는 대조 C10).
  **실제로 출력할 J6 출력 플랜지라면 끼움 틈이 필요하다** — 그때 원장(`print-fits.json`)에 시험편으로 정한다.
- 1 단계(옛 고리 끝면 32 에 댐 · 플랜지와 4 mm 뜸 · 나사 자리 없음) 기록은 계획 051 과 git 이력.

## 검사 결과 (2 단계 · `check.md` · 원본 `check.json`)

- 검사 장치: 모든 바디 · 부품 manifold 부피 = 메시 부피 · 부피 > 0 · 맞춤면을 STL 에서 잰 값 = 플랜지 v3 · 돌기 그리퍼 규격 · 붙인 면은 맞닿음만
  (팔 나사 몸통 겹침 0 · 맞춤 쌍은 위 설명) · **독립 순기구학 대조**(v1 parameters 로 따로 계산 — 9 자세에서 받침 아랫면 = 플랜지 면 · 쥐는 점이 J6 축 위 ·
  q6 = 0 에서 턱 방향 = J5 축) · **플랜지 구멍을 STL 에서 직접 재기**(넷 · Ø4.0 = 원장 · 원 반지름 15.75 · 0 / 90 / 180 / 270° · 깊이 8 > 나사 몸통 7 · 바닥 살 2) ·
  붙인 그 자세(표시)에서 팔에 박히면 판정 거짓 · 양성 대조 열하나(1 mm 안으로 붙임 · 60 mm 밀어 넣음 · 열린 / 뒤집힌 메시 · 바닥 아래 · 팔꿈치로 옮김 · J5 180° · 구간 함수 ·
  돌림 90° · 돌기 끝에 얹음 · 돌림 45°(나사 어긋남) · 옆으로 0.5 mm(돌기 ↔ 홈 벽) · 구멍 재기(20° 돌림 · 하나 지움 · 바닥 올림)) 모두 잡힘.
- 갤러리 자세 7 × 벌림(닫힘 0 · 렌더 20 · 끝 47): **그리퍼가 팔에 닿는 자세 없음** · 링크 0 ~ 4 와는 모두 10 mm 넘게 떨어짐 · 링크 5(J6 드럼)와는 팔 나사 끝이 3 mm.
  단 **「아래 집기(pick)」 자세는 그리퍼가 바닥 아래 약 66 mm** — 그 자세는 그리퍼 없는 팔로 만든 것이라 그리퍼를 달면 쓸 수 없다(렌더하지 않음).
- J5 쓸기(±170 · 5° 간격 · 경계 ±5°): 팔만으로도 **±115° 에서 J4 고리 ↔ J6 모듈이 닿아 ±110° 까지만 자유** — 그리퍼를 달아도 이 범위는 그대로다.
  그리퍼가 처음 팔에 닿는 각은 그보다 바깥: ㄱ 자 대기 +130 / −160 · 표시 +145 ~ +150 / −160(벌림에 따라).
  표시 자세(J5 = 25°)에서 J5 를 더 돌리면 그리퍼가 바닥 여유 5 mm 안으로 들어간다(닫힘 +30° · 끝 벌림 +25° 까지 바닥 위 · 음의 쪽은 −110° 까지).
- J6 쓸기(표시 자세 · 15° 간격 한 바퀴): 팔에 닿는 각 없음. **바닥은 다르다** — 턱을 끝까지 벌리면(u 47) 25 각 가운데 16 각에서 바닥 여유 5 mm 미달,
  가장 낮을 때 바닥 아래 9.1 mm(q6 = −135). 닫으면(u 0) 모든 각에서 바닥 위(최저 15.7 mm). 표시 자세가 바닥에 가까운 낮은 자세라서다.
- 가장 가까운 틈은 표면 표본점(약 1.5 mm 간격) 사이라 실제 틈보다 조금 클 수 있고, 상자가 10 mm 안인 바디만 잰다(그 밖은 「10 넘음」). 자세 사이 움직임(경로)은 보지 않았다.
- (1 단계 값 — 옛 고리 끝 32 에 붙였을 때: pick 바닥 아래 70 · J6 끝 벌림 18 각 미달 · 최저 −11.9. 그리퍼가 4 mm 팔 쪽으로 오며 조금 나아졌다.)

## 파일

| 파일 | 내용 |
|---|---|
| `assembly.json` | 붙인 자리 행렬 · 맞춤면 실측 · 쥐는 점 · 질량 · 입력 sha256 |
| `check.json` · `check.md` | 자세 · 쓸기 · 대조 결과 |
| `arm-v3-kg1-assembly-display.glb` | 보기용(표시 자세 · m · Y 위 · 그리퍼 벌림 20) — 치수 원천 아님 |
| `renders/` | 블렌더 렌더 여섯(표시 · 손끝 앞 / 뒤 · ㄱ 자 대기 · 옆으로 뻗기 · 손목 비틀기 · 벌림 20) + `render-report.json` — 서보는 보기용 한 상자(검사기 기준 입체의 단차 · 돌기 · 커넥터 자리 없음) |

## 다시 만들기

```powershell
& C:/projects/printforge/.venv/Scripts/python.exe -B src/cad/arm-v3-kg1-assembly/assemble.py
& C:/tools/Blender-5.2.3/blender-5.2.3-windows-x64/blender.exe --background --factory-startup --python src/cad/arm-v3-kg1-assembly/blender_assembly.py -- --blend models/armold-mks-product-v3/blender/kmjh-arm-v3.blend --assembly models/arm-v3-kg1-assembly/assembly.json --check models/arm-v3-kg1-assembly/check.json --gripper-model models/kmjh-gripper-v1 --gripper-params src/cad/kmjh-gripper-v1/parameters.json --kin models/armold-mks-concept-v1/kinematics.json --poses src/cad/armold-mks-product-v3/gallery_poses.json --out models/arm-v3-kg1-assembly/renders
```

저장소 뿌리에서 돌린다. 검사 약 4 분 · 렌더 약 3 분(CPU · 64 샘플). 붙이는 면 · 돌림 · 벌림은 `src/cad/arm-v3-kg1-assembly/parameters.json`.
렌더는 `check.json` 이 all_ok 이고 그 자세가 검사한 모든 벌림에서 팔과 겹치지 않고 바닥 여유 안 · 팔끼리도 안 겹칠 때만 돈다. 블렌더 장면(.blend)은 읽기만 한다(전후 sha256 대조).

쓰기 가드가 「more than one hard link」 로 멈추면: 구글 드라이브가 업로드를 기다리는 동안 최근 파일에 임시 하드 링크(`C:\projects\.tmp.driveupload\…`)를 건다
(2026-10-28 `fsutil hardlink list` 로 확인). 업로드가 끝나 링크 수가 1 이 되면 다시 돌리거나, 이 폴더의 산출(README 빼고)을 지운 뒤 돌린다 — 가드는 바꾸지 않는다.
