WINNAKEN/robot-arm-lab/docs/design/051-arm-v3-gripper-assembly.md

> 개발 이력: 작성 당시의 계획·결과입니다. 현재 상태는 [STATUS](../STATUS.md)를 확인하세요. 원시 로그와 로컬 경로 일부는 공개본에서 제외했습니다.

# MP9 — 외장 v3 팔 끝에 그리퍼 KG1 붙이기 (Claude 모델링 · 2026-10-28)

> 계획 번호 051 은 MP9 가 쓴다(050 = Codex 미추적 `050-sdk-boundary-connection.md` · 040 ~ 044 · 047 ~ 049 = Codex · 045 = MP7 · 046 = MP8).
> 결정 원문 = `.dev/mp9-evidence/user-decisions-mp9.json`.

## 요청 (원문)

- 「DEV_PRINCIPLES 를 읽고 printforge 와 mech-sparring 를 써서 생산 세션을 대기해 진행하던 robot-arm-lab 이어서 작업할거야」
  → 질문 창: 다음 일 = 「실측·시험 결과 넣기 (권장)」 · 기록 자리 = 「robot-arm-lab MP9 (권장)」(원문 = 결정 파일). 실측 값은 아직 오지 않음.
- 「구매품이 아직 도착안해서 그런거라 지금 모델링에 그리퍼 합쳐진게 있나?」 → 없음(MP8 은 그리퍼를 단품으로만 만들고 「그리퍼를 v3 Link6 에 붙인 자세 검사는 다음」 으로 남김).
- 「지금 붙여놓자 일단 만들어놓고 조금씩 수정하면되는거니깐」 ← 이 계획의 범위.

## 문제

그리퍼 KG1(`models/kmjh-gripper-v1/` · 좌표 G = 원점 팔 공구 플랜지에 닿는 면 가운데 · +z 다가가는 쪽 · x 턱 방향)이 팔 모델과 따로 있다.
팔 끝에 붙인 모습 · 팔을 움직였을 때 그리퍼가 팔 · 바닥에 닿는지(특히 J5 를 접을 때)를 아무도 보지 않았다.

## 맞춤면 — 지금 두 모델이 서로 맞지 않는 곳 (실측은 검사기가 커밋된 STL 로 다시 잼)

| | 팔 v3 (링크 6 · J6 축 방향 x · 원점 J6) | 그리퍼 KG1 받침 |
|---|---|---|
| 판 | 공구 플랜지 x 18 ~ 28 · 반지름 28(바깥 모따기 2) | 아랫면(z 0) = 원판 Ø56 과 판 140 × 51 이 한 면 · 두께 6(검토 MP9-R6 ② 로 고침 — 처음엔 「판이 원판 위」 로 잘못 적음) |
| 가운데 | 민트 고리 x 28 ~ 32 · 반지름 20 (4 mm 돋움) | 아랫면 맞춤 홈 Ø20 × 1.5 |
| 나사 | 없음 | M3 넷 · Ø31.5 원 · 0° |

- 그리퍼를 플랜지 면(x 28)에 대면 민트 고리(Ø40 × 4)가 그리퍼 받침에 4 mm 박힌다. → 이번 판은 **고리 끝면(x 32)에 댄다**(겹침 없음 · 플랜지 면과 받침 사이 4 mm 틈).
- 이 어긋남은 이번에 고치지 않는다 — 고칠 길 셋(사용자 결정): ① v3 고리를 Ø20 × 1.5 돌기로(v3 를 바꿈 — 사용자 지시 필요) ② 그리퍼 홈을 고리에 맞춤(그리퍼를 바꿈) ③ 실제 J6 출력 플랜지를 감속기와 함께 설계(MP8 이 미룬 일).

## 선택 · 결정

- 붙이는 자리 = 고리 끝면(위) · 매개변수 `mount.face` = `ring`(대조로 `flange` 를 돌려 겹침이 잡히는지 본다).
- 돌림(J6 축 둘레) = 매개변수 `mount.roll_deg` = 0 → **그리퍼 x(턱 방향) = 링크 6 지역 y** · 그리퍼 z = 링크 6 지역 x(J6 축 바깥) · 그리퍼 y = 링크 6 지역 z.
  링크 6 지역 y 는 q6 = 0(기하 영점)에서 J5 축과 나란하다 — 넓은 쪽(가로 140)이 J5 를 접는 평면 밖에 있어 접을 때 덜 닿을 것으로 봄(검사로 확인 · 다르면 바꿀 매개변수).
  이유 = 작성자 판단(사용자 결정 아님) — 「일단 만들어놓고 조금씩 수정」 이므로 매개변수 하나로 두고 결과를 보여 드린다.
- 관절 거리 · 축 · 표시 자세 = v1 그대로(읽기만). v3 · 그리퍼 파일은 고치지 않는다(새 폴더에 조립만).

## 이번 범위 · 산출

| 묶음 | 산출 |
|---|---|
| A 붙이기 | `src/cad/arm-v3-kg1-assembly/parameters.json`(붙이는 면 · 돌림 · 렌더 벌림) · `assemble.py` — 커밋된 v3 바디 STL · v1 kinematics · 그리퍼 부품 STL + 그리퍼 검사기의 구매품 기준 입체(`verify_gripper.references` · `assemble` 을 모듈로 불러 읽기만)로 붙인 자리를 계산 → `models/arm-v3-kg1-assembly/assembly.json`(G → 세계(표시 자세) 4 × 4 · 맞춤면 실측) · 보기용 GLB(표시 자세 · 색) |
| B 자세 검사 | 같은 스크립트: 갤러리 자세 7 × 벌림(닫힘 0 · 끝 47 · 렌더 20) — 그리퍼 ↔ 팔(링크 0 ~ 5) 겹친 부피 · 이웃 아닌 링크 근접(근사) · 바닥 여유 5 mm · 그리퍼 ↔ 링크 6(플랜지 · 고리) 겹침(고정 · 붙인 면 맞닿음만) · **J5 쓸기**(표시 · ㄱ 자 대기 자세에서 J5 ±170 · 그리퍼 있음 / 없음 · 닿는 구간) · **J6 쓸기**(표시 자세 · −180 ~ 180 · 팔 겹침 · 바닥 여유를 따로) → `check.json` · `check.md` |
| C 보여 주기 | `blender_assembly.py` — 커밋된 `kmjh-arm-v3.blend` 를 읽기만(저장 안 함 · 전후 sha256 같음) · 그리퍼 부품 STL 을 J6 빈 객체에 붙여 몇 자세 렌더(`models/arm-v3-kg1-assembly/renders/`) |
| D 인계 | HANDOFF MP9 절 · SESSION_HANDOFF · Codex 에게(URDF 그리퍼 링크 붙이는 자리 = assembly.json) |

## 검사 장치 (MP6 ~ MP8 교훈을 처음부터 — 크기는 대상에 맞게)

- 커밋된 STL 로 스스로 계산한다(생성기를 부르지 않음). 입력 sha256 묶음(v3 바디 STL · bodies.json · kinematics · 그리퍼 부품 STL · 그리퍼 parameters · 끼움 원장)을 기록에.
- **manifold 부피 = 메시 부피 · 부피 > 0**(모든 바디 · 부품 — 열린 · 뒤집힌 메시가 조용히 통과하는 길, MP8 교훈 ①).
- 붙인 자리의 독립 대조(검토 MP9-R3 뒤): v1 parameters(관절 거리 · axis_parent_zero)만으로 순기구학을 따로 계산해, 갤러리 7 자세 + J5 · J6 를 바꾼 둘에서
  받침 아랫면 = 돌린 고리 끝 · 손끝 끝 = 그 + 106 · 쥐는 점이 J6 축 위 · q6 = 0 에서 그리퍼 x = +J5 축(돌림 0 의 뜻)을 본다.
- 양성 대조(검사기가 돌 때마다 같이 돌고, 기대대로 거짓이 아니면 전체 실패): ① 붙이는 면 = 플랜지(x 28) → 그리퍼 ↔ 고리 겹침 > 1 mm³ ② 그리퍼를 J6 축 반대로 60 mm 밀어 넣음 → 팔 겹침 > 1 mm³
  ③ BASE 에서 면 열 개를 뺀 열린 메시 · 면 방향을 뒤집은 메시 → manifold 키 거짓 ④ 그리퍼를 바닥 아래로 1000 내림 → 바닥 키 거짓
  (검토 뒤 더함) ⑤ ㄱ 자 대기 자세에서 그리퍼를 J3 원점으로 옮김 → 링크 0 ~ 4 겹침 ⑥ J5 = 180 → 팔끼리 겹침 ⑦ 구간 함수의 합성 입력 답 ⑧ 돌림 +90° · 플랜지 면으로 붙이면 독립 대조가 거짓.
- 겹침이 나오는 자세는 「실패」 가 아니라 **기록**이다(어느 자세 · 어느 쌍 · 몇 mm³) — 붙이기 · 검사 장치가 맞는지가 합격 조건이고, 닿는 자세는 사용자에게 보여 드릴 결과다.

## 하지 않는 것 · 무접촉

v1 · v2 · v3(파일 · .blend 저장) · J2 분할 · MP5 · MP6 · 그리퍼 KG1 파일 · 끼움 원장 · 모터 원장 · URDF · 펌웨어 · 배선 문서 · 관절 거리 ·
J6 출력 플랜지 설계 · 맞춤면 고치기(위 ① ~ ③ — 사용자 결정 뒤) · 출력 · 프린터 전송 · 구매 · 새 설치.

## 검토

- 계획 검토(L2)는 하지 않는다 — 보여 주기 조립 · 검사 단위이고 사용자 지시가 「일단 만들어놓고 조금씩 수정」.
- 산출 검토(L4) = Claude 하위 에이전트(읽기 전용 · 작성자 결론을 주지 않고 코드 · 산출을 줌). Codex 비작성자 검수는 하지 않는다 — 잔여 위험으로 기록(MP8 과 같은 꼴 · 사용자가 원하면 띄움).
- 검토 R1(2026-10-28): 중대 0 · 보통 2 · 경미 9 — 모두 받아들여 고침 · 처분 = `.dev/mp9-evidence/review.md`(원문 = `review-r1-raw.md`) · 고친 뒤 다시 검토는 하지 않음.

## 소유 경로 · 커밋

`src/cad/arm-v3-kg1-assembly/` · `models/arm-v3-kg1-assembly/` · `.dev/mp9-evidence/` · 이 계획 · `.dev/HANDOFF.md` 의 MP9 절 · `.dev/CODING_RULES.md` 의 MP9 단락(공유 문서는 덧붙이기만 ·
MP8 절의 「호출 방식 · 과제 폴더는 printforge 코딩 #8 이 사용자와 정한다」 줄 뒤에 결정 36 을 가리키는 줄을 덧붙임). 커밋 = 내 파일 이름만 `git commit --only`(Codex 스테이징 무접촉 · 부모 = 커밋 전 HEAD 확인) · push 없음.

## 2 단계 — 팔 쪽 맞춤면을 그리퍼 규격으로 (2026-10-28)

- 요청 원문: 「v3 민트 고리를 그리퍼 규격(Ø20 × 1.5 돌기 + M3 Ø31.5 나사 자리)에 맞게 고쳐서 다시 붙여줘」(앞 턴 질문 「맞춤면은 어느 쪽을 고쳐 맞출까요?」 의 버튼 「팔 쪽 고치기」).
- 무엇(외장 v3 의 링크 6 공구 끝만):
  - 민트 고리(Ø40 × 4) → **돌기 Ø20 × 1.5** = 그리퍼 받침 맞춤 홈(`kmjh-gripper-v1/parameters.json` `layout.recess_dia` · `recess_depth`) 공칭 그대로(사용자 수치 · 끼움 틈 없음 — v3 는 「NOT FOR FABRICATION」 외곽이라 보기 · 맞춤 확인용). 바디 이름 `LINK6_TOOL_RING` · 민트 · 역할 그대로.
  - 공구 플랜지에 **M3 나사 자리 넷** = 열압입 인서트 구멍 Ø4.0(원장 `print-fits.json` PLA `insert_hole_dia` · 확정) · Ø31.5 원(`layout.arm_screw_pcd`) · 0°(`arm_screw_phase_deg` — 링크 6 지역 y 에서 z 쪽으로 · MP9 돌림 0 과 맞음) ·
    깊이 8 = 그리퍼 팔 나사 몸통이 받침 아랫면 밑으로 나오는 길이 7(`screws.arm_m3.length` − (`base_top` − `arm_screw_cbore` 깊이)) + 여유 1(v3 parameters `screw_hole_extra_depth`).
  - **수치의 원천은 그리퍼 parameters · 원장 하나**다 — v3 parameters 의 `links.tool` 에는 그 파일 경로(`interface_from`)와 여유 1 만 두고 `ring_r` · `ring_t` 는 지운다(두 곳에 숫자를 두지 않음).
  - 붙이는 면 = **플랜지 면**(J6 원점에서 28) — 돌기가 홈에 들어가 받침 아랫면이 플랜지에 닿는다. TCP(쥐는 점) = J6 + 131.
- 바뀌는 MP7 파일(이 단계에서 MP9 소유로 넓힘 · CODING_RULES MP9 덧붙임 단락): `v3geom.py`(Spec 의 공구 규격 읽기 · 돌기 · 플랜지 구멍 · 대조 `tool_holes_rotated`) ·
  `parameters.json`(`links.tool`) · `expected_shapes.py`(돌기 · 구멍의 독립 정답 — 그리퍼 parameters · 원장에서 따로 읽음) · `validate_product.py`(보호 값 대조: 고리 = v2 → 돌기 · 구멍 = 그리퍼 규격 · 원장) ·
  `run_controls.py`(만들기 대조에 `tool_holes_rotated` → C1e) · `build_product.py`(문서 revision 표기) · `models/armold-mks-product-v3/` 산출 · `.dev/product-v3-evidence/` 의 build · check · 대조 · 블렌더 기록.
- 다시 돌리기: build_product → validate_product → 대조 넷(owner_both · drop_ring · bar_shift · tool_holes_rotated) → blender_scene(.blend · GLB · 장면 렌더 넷) → blender_verify → MP9 assemble · 렌더.
- **낡는 것(다시 렌더하지 않음 · 표지만)**: MP7 갤러리(36 장) · 동작 영상(MP4 넷)과 그 대조 기록은 옛 고리로 찍혔고, 그 검사들은 바뀐 .blend sha 로 이제 거짓이 된다 → v3 README · HANDOFF 에 「rev1 이전 렌더」 표지. 다시 렌더는 사용자 결정.
- MP8 영향 표(`motor_impact.py`)는 v3 parameters · v3geom 을 읽는다(공구 값은 안 씀) → 격리 작업 뿌리로 다시 돌려 숫자가 같은지 보고 MP9 근거에 적는다(MP8 근거는 고치지 않음).
- MP9 조립 검사: `mount.face` = flange · 맞춤면 측정의 기대값 = 그리퍼 규격 · 붙인 면 맞닿음에 팔 나사 몸통도 포함(구멍에 들어가야 0) · 대조 C1 = 1 mm 안으로 붙임 → 플랜지 겹침 · 새 대조 = 돌림 45° → 팔 나사가 플랜지에 박힘.
- 하지 않는 것: 관절 거리 · 다른 v3 바디 · v1 · v2 · 그리퍼 KG1 파일 · 원장 값 · 갤러리 · 동작 다시 렌더 · 출력 · 끼움 틈 정하기(진짜 J6 출력 플랜지를 만들 때 원장으로).
- 검토: 산출 검토 = Claude 하위 에이전트(1 단계와 같은 꼴) · Codex 없음(잔여 위험).
- **2 단계 검토(B) 뒤 더한 것**(처분 = `.dev/mp9-evidence/review-b.md`):
  - v3 생성기 · 검사기가 따로 **한계**를 단언: 구멍 깊이 ≤ flange_t − `screw_hole_min_floor`(1) · 구멍이 돌기 밖 · 모따기 안 · 원장 재료 = 그리퍼 `fits_from.material`
    (그리퍼 팔 나사 길이 = 깊이의 원천은 그리퍼 쪽 표기로 잠정 — 길어지면 만들기가 멈춤). v3 대조 `tool_holes_dropped` · `tool_hole_deeper` 더함(C1e).
  - MP7 대조 기록: `controls.json` 은 MP7 · rev0 실행 그대로 되돌리고, rev1 에서 다시 돌린 공구 대조 여섯 + 가드는 `controls-rev1.json` 에 코드 sha 와 함께 따로.
  - MP9: 공칭 맞춤 쌍(돌기 ↔ 홈) 판정은 돌기를 반지름 0.05 들여 잰 겹침(원래 0.92 mm³ 는 기록) — 반지름 · 축 어긋남을 약 0.037 mm 까지 가린다(검토 계산) ·
    대조 C10(옆 0.5 mm) · C8 의 돌기 높이는 그리퍼 `recess_depth` 에서 · 플랜지 구멍을 STL 에서 직접 재 그리퍼 · 원장과 대조(`measure_holes` · 대조 C11) ·
    표시 자세에서 그리퍼가 팔에 박히면 판정 거짓.
  - `.blend1`(블렌더 저장 때 남는 옛 판)은 HEAD 그대로 둔다(커밋하지 않음).
  - MP8 하중 판정(`gripper_loads.py` · 계획 046)은 그리퍼를 옛 고리 끝(J6 + 32)에 붙인다고 가정했다 — rev1 은 28 이라 지렛대가 4 mm 짧다(보수 쪽 · 다시 내지 않음).
