WINNAKEN/robot-arm-lab/models/cycloid-27-v1/assembly/ASSEMBLY.html

# 사이클로이드 감속기 27:1 조립도

robot-arm-lab MP6 cycloid-27-v1 · 값 = 2026-11-05(MP13 핀 구멍 · MP14 모터 축) · 바깥 Ø78 · 높이 43.5 mm(모터 면 → 출력 플랜지 윗면) · 감속 27 : 1(출력은 입력과 반대 방향).

분해도

분해도 — 번호는 아래 부품표 · 흰 = 바닥판 · 덮개 · 하늘 = 그 밖 인쇄 부품 · 회색 = 강철 다월 · 진회색 = 베어링

단면

조립 단면(XZ) — 모터는 흐리게

## 부품표

# | 부품 | 수 | 어디서 | 메모

1 | 모터 MKS SERVO42D(NEMA17 · 일체형 드라이버) | 1 | 가진 것 | 축 Ø5 D · 장착면 → 축 끝 21.5 · 턱 Ø22 × 2
2 | 바닥판 HOUSING_BASE | 1 | 흰 · 38 번 판 | 고정 핀 압입 구멍 Ø4.20 × 28
3 | 고정 핀(강철 다월 Ø4 × 28) | 28 | 산 것 | 바닥판에 21.85 눌러 넣음 · 윗끝 6.15 는 덮개 구멍에
4 | 아래 편심 축 CAM_LOWER | 1 | 하늘 · 38 번 판 | D 구멍 5.20(축에 눌러 끼움) · 게이지로 높이
5 | 원판 1 DISC_1 | 1 | 하늘 · 28 번 판 | 6801 을 눌러 넣음
6 | 베어링 6801(12 × 21 × 5) | 2 | 가진 것 | 원판마다 하나
7 | 위 편심 축 CAM_UPPER | 1 | 하늘 · 38 번 판 | D 구멍 5.30(손으로 미끄럼) · 아래 편심과 반대쪽
8 | 원판 2(원판 1 과 같은 부품 · 180° 돌림) | 1 | 하늘 · 28 번 판 | 6801 을 눌러 넣음
9 | 와셔(2.0 · 2.2 · 2.4 중 하나) | 1 | 하늘 · 28 번 판 | 8 단계에서 두께 고름
10 | 캐리어 CARRIER | 1 | 하늘 · 38 번 판 | 출력 핀 압입 구멍 Ø4.20 × 6 · 허브 인서트 4
11 | 출력 핀(강철 다월 Ø4 × 20) | 6 | 산 것 | 캐리어에 눌러 넣음
12 | 베어링 6800(10 × 19 × 5) | 1 | 가진 것 | 캐리어 가운데(바깥 고리 압입)
13 | 덮개 HOUSING_CAP | 1 | 흰 · 38 번 판 | 고정 핀 미끄럼 구멍 Ø4.25 × 28 · 인서트 8
14 | 베어링 6808(40 × 52 × 7) | 1 | 확인 필요 | 덮개 위에서 넣음
15 | 누름 고리 RETAINER | 1 | 하늘 · 28 번 판 | M3 × 8 넷으로 덮개에
16 | 출력 플랜지 OUTPUT_FLANGE | 1 | 하늘 · 28 번 판 | M3 × 8 넷으로 캐리어 허브에
· | 게이지 GAUGE(0.6) | 1 | 하늘 · 28 번 판 | 1 단계에서 아래 편심 축 높이 맞춤 — 뒤에 뺌
· | M3 열압입 인서트(M3 × 5.7 × 4.2) | 12 | 가진 것 | 덮개 아래 4 · 덮개 위 4 · 캐리어 허브 4 — 베어링 넣기 전에 인두로
· | M3 둥근머리 × 10 | 4 | 확인 필요 | 바닥판 위 → 모터(물림 4.0 · 모터 나사 깊이 4.5 는 가정)
· | M3 × 30 | 4 | 확인 필요 | 바닥판 아래 → 덮개 인서트(물림 6.2)
· | M3 × 8 | 4 | 확인 필요 | 누름 고리 → 덮개 인서트
· | M3 × 8 | 4 | 확인 필요 | 출력 플랜지 → 캐리어 허브 인서트(팔 · 짐을 같이 조이면 그만큼 길게)

「28 번 판」 = 10/30 에 뽑은 하늘 부품(지금 값과 같아 다시 안 뽑음) · 「38 번 판」 = 이번 판 · 6808 · M3 나사는 가진 것인지 확인 필요.

## 조립 순서

1. 먼저 인서트 12(덮개 아래 4 · 덮개 위 4 · 캐리어 허브 4)를 인두로 넣는다 — 베어링 · 핀을 넣기 전에.
2. D 평면 확인: 아래 편심 축 [4]를 모터 축에 손으로만 대 보아 축 끝에서 18.9 mm 넘게(턱 위 0.6 까지) D 평면을 따라 내려가는지 본다. 평면이 그보다 짧으면 끝까지 안 들어간다 — 누르지 말고 멈춘다(편심 축 모양을 바꿔야 함).
3. 모터만 따로 둔 채: 게이지(0.6)를 모터 턱 위에 D 축을 끼고 놓고, 아래 편심 축 [4]를 D 축에 눌러 게이지에 닿게 한 뒤 게이지를 옆으로 뺀다.
4. 모터 [1]를 바닥판 [2]에 M3 둥근머리 × 10 넷으로(편심 축 허브 Ø14 가 바닥판 턱 구멍 Ø22.3 을 지남 · 머리는 바닥판 위).
5. 고정 핀 [3] 28 개를 바닥판 구멍(Ø4.20)에 바이스 · 손바닥으로 곧게 눌러 넣는다(위로 나온 길이를 같게 · 망치 X).
6. 6801 [6]을 원판 둘 [5] [8]에 눌러 넣는다 — 평평한 판 위에 원판을 놓고 베어링 윗면 = 원판 윗면이 될 때까지(아랫면 쪽은 1.0 들어감). 그 면이 위로 간다.
7. 원판 하나 [5]를 위에서 아래 편심에 손으로 밀어 끼운다(베어링 속 고리가 허브 윗면에 앉음 · 누르지 않는다).
8. 위 편심 축 [7](미끄럼)을 D 축에 내려 간격 고리가 6801 #1 속 고리에 얹히게 한다 — 세게 누르지 않는다(아래 편심 축이 밀리면 게이지 높이를 잃는다) · D 면 때문에 편심이 아래와 반대쪽.
9. 다른 원판 [8]을 180° 돌려 위 편심에 손으로 밀어 끼운다(원판 둘의 같은 표시가 반대쪽).
10. 와셔 [9](먼저 2.2)를 저널에 끼우고 곧은 자를 바닥판 벽 윗면에 걸쳐 와셔 윗면과 견준다: 자가 벽과 와셔에 함께 닿으면 맞음 · 자가 와셔에 떠 있으면 얇은 와셔(2.0) · 와셔 위에 틈이 보이면 두꺼운 와셔(2.4). 2.4 로도 틈이 크면 아래 편심 축이 밀린 것 → 3 단계부터.
11. 덮개 [13]에 6808 [14]를 위에서 넣고 누름 고리 [15]를 M3 × 8 넷으로.
12. 캐리어 [10]에 출력 핀 [11] 6 개 · 가운데에 6800 [12] 바깥 고리를 눌러 넣는다(캐리어만 따로) → 캐리어 허브를 아래에서 6808 속 고리에 밀어 넣고 출력 플랜지 [16]를 M3 × 8 넷으로.
13. 덮개 묶음을 내려 출력 핀이 원판 구멍 · 저널이 6800 속 고리(손으로) · 고정 핀 윗끝이 덮개 구멍(Ø4.25 · 미끄럼)에 들어가게 하고, 바닥판 아래에서 M3 × 30 넷으로 덮개 인서트에 조인다. 다시 열 때는 이 넷만 풀면 덮개 묶음이 통째로 빠진다.

주의 — 아직 시험 전인 값: D 구멍 5.20 · 5.30(맞춤 확인 판 범위 밖) · 핀 4.20 · 4.25 는 하늘 Pure 시편 판정(바닥판 · 덮개는 흰 Basic — 같은 판의 흰 핀 시편 36 으로 견줘 봄) · 6808 자리 · 모터 나사 깊이. 맞지 않으면 억지로 누르지 말고 어디서 얼마나 걸렸는지 적어 주세요.
모터를 책상에 잡아 둘 모터 받침은 아직 없음(다음 단위로 설계) — 손으로 돌려 보는 시험만 하고 모터 전원은 받침을 단 뒤에.

## 손 시험 기록지(모터 전원 없이)

모터 축(입력)을 손으로 돌릴 때 걸림 · 뻑뻑한 자리(입력 몇 바퀴째 · 출력 각)
출력 플랜지가 입력과 반대로 1/27 도는가
출력을 손으로 좌우로 흔들 때 유격(대략 각 · 또는 「안 느껴짐」)
원판 · 핀 · 캐리어 · 와셔 사이 긁힘 소리 · 자국
고정 핀 · 출력 핀 · 편심 축이 빠지거나 헐거운가
쓴 와셔 두께
고정 핀 압입(4.20) · 덮개 씌우기(4.25) · 아래 편심 축 압입(5.20) 느낌
