WINNAKEN/robot-arm-lab/src/firmware/tests/runtime/README.md

# ST3-C offline runtime validation — R2 snapshot for independent L4 R2

Command: `./src/firmware/tests/runtime/run.ps1 -Mutations` (PowerShell, existing pinned Zig C++17, -Wall -Wextra -Werror -pedantic). This links actual Boot supervisor/shared config codec/BenchRun/ControlGate/StopLink/StopCoordinator/MKS codec; only CanPort is fake. No network, SDK target, device, flash, purchase, UI or CAD execution.

R1 executed22 fixtures /1,525,994 assertions PASS (historical; R2 results below supersede). Assertions include repeated polling checks, not1.5million independent scenarios:

- Four12s runs: axes[1], [2], [1,2] selected1 and selected2. Seed stamps checked against actual Boot query trace; every active setting renews>=3 times through real matched reads; all entries remain<4000; no FD or extra torque/settings writes. Actual refresh counts86/86/69/69.
- Two15s pressure runs at actual config response delays90/95ms: Ready remains,62/60 refreshes,5492/8723 polls with oldest config in urgent window. This measures urgency presence, **not dispatch-time competition** with diagnostic priority.
- All7 setting codes wrongvalue0x1234 and explicit unsupported: actual ConfigMismatch, no reset or stop_verified, manualcut. Corrupt checksum/wrongaxis/wrongcode cannot renew and reach transaction deadline. Duplicate replies are bounded raw drops. Unsolicited valid other-axis98 reply renews neither sample nor count.
- Two actual Boot→Run integrations, selected1/2, explicitly Acquire/renew, then two actual Arm/Ticket/FD/start/completed/new-proof moves each after4s; completion elapsed6002ms,33 matched refreshes. No automatic retry/enable.
- Original provisional authority expiry4584 coalesced with captured BusError: invalidating Bus fault/realclose, no reset/verified stop. This executes expiry/knownfault precedence at authority boundary, not exact configTTL4000.

Three compiled behavioral mutants fail runtime, all compile exits0: keepalive fabricates config timestamps (fails actual refresh-count requirement); wrong-axis response accepted (fails unmatched timeout requirement); wrongvalue accepted (fails ConfigMismatch requirement). These are the three **killed** runtime controls. Final result.json records executable hashes and exits.

R1 acceptance gap (historical; R2 wire test below addresses it): plan017 requested omit-diagnostic-priority-while-urgent control. Its narrow variant and broader all-config priority-bypass variant both compiled and survived the19-fixture predecessor schedule. Urgent polls did not establish a simultaneous *dispatch* intersection. A public realArm→pause attempt failed to Arm under95ms responses because the genuine three-position freshness window was unavailable; no private state/proof timestamp was fabricated or bounds weakened. Preserve `urgent-config-starves-diagnostics.cpp`, its compile/run logs, `config-starves-diagnostics.cpp`, its logs, and attempts3–8. Two failed mutation-source attempts hit strict unused/tautology compiler diagnostics and are **not mutation kills**. Independent L4 must disposition this gap; author does not waive it or claim branch unreachable. D remains blocked until C independent acceptance.

R1 NOT individually RUN claims (R2 bounded alternatives below address central boundaries): exact configTTL>=4000 late-response/renew race; deliberately clustered seed ages and all infeasible distributions; config headroom Busy→refresh→Arm targeted boundary; setting refresh during postFD2 cannot satisfy position-proof targeted mutant; exhaustive TX50/RX100/140/API10/overflow and cross-generation replay permutations. Existing legacy suites cover many transport/stop boundaries, but are not substituted for these C-specific cases. Physical response bounds, firmware identity, nonce-free CAN replay, real motor calibration and mechanical stop remain approved-profile assumptions/hardware NOT_RUN.

Final legacy commands: `tests/boot/run.ps1 -Mutations`46fixtures7292assertions,3 compiled runtime-failing mutants; `tests/run/run.ps1 -Mutations`51fixtures3427assertions,2 mutants. Boot old scalar-expiry assertion intentionally replaced by actual7refreshes and per-entry freshness at old5103 deadline. Counts differ from old snapshots due changed causal scheduling/expectation; old evidence remains preserved. Raw failed attempts are retained, not overwritten into success.

Frozen manifest lists all controlled source/docs/runners and actual compilation dependency census plus executable/log hashes. Host success does not imply target ELF, hardware or independent review PASS. Current status L2R1 PASS7/0, L4R1 NEEDS_ATTENTION7/2, L3 R2 frozen for independent L4R2, external other-family bridge NOT_RUN due unchanged central hook barrier.
## R2 bounded closures and actual limitations

Final runtime28 fixtures /1,527,570 assertions PASS,5 compiled runtime-failing mutants. Legacy Boot46/7292 plus3 mutants and Run51/3427 plus2 mutants pass. No app/UI/CAD changes. Source predicate extraction is the only additional production change: real `sample_fresh` and `sample_headroom` in robot_config are consumed by Run at entry/deadline/admission. Bounds unchanged.

C-R1-1: fake CanPort now records actual parsed diagnostic RX timestamps, clears them on actual reset, and checks config submissions against all actual latest diagnostic ages. Positive pressure90/95ms dispatches60/59 config reads, maximum latest diagnostic age159ms. Exact original urgent-priority mutant compiles0 and runtime fails: actual configuration dispatch at7589, oldest configuration age3402, latest diagnostic RX age250, axis1/setting8A. Same-code eligibility is established causally by that diagnostic's actual previous TX/RX250ms earlier (>140). This actual wire-selection assertion catches the originally surviving narrow control. Historical survivors/failed Arm setup remain preserved; not counted retroactively as kills.

C-R1-2 production predicate boundary + actual consumer alternative (requires independent disposition): exact freshness3999/4000/4001; headroom401/400/399; future-dequeue, TX-after-RX, invalid, addition overflow/reversal are tested on the actual functions Run calls. Repeat exact3999/4000 and3599/3600 headroom tests on **every real14 Boot seed**, not forged actor timestamps. Actual seed span2662ms, first production EDF query axis2/84 equals oldest seed. A later single actual matched refresh changes exactly1entry, leaves13unchanged (cross-axis nonrenew). Slow actual95ms seed consumption cannot regenerate ready-proof before unchanged original authority4584, fails Profile/noFD. A real late config response at TX+100 hits the stricter transaction deadline and cannot renew afterward or revive Renew. Exact4000 actor entry-race is not claimed separately reached: expiry predicate plus actual consumer traces are used as the reviewer-permitted alternative; no private timestamps/clock-jump masquerading as isolatedTTL exercise.

Public slow95ms operation has199 denied Arm attempts because genuine three-position proof is unavailable. Restore actual fast responses, require actual config-refresh count increase, all production headroom predicates true and new real stable proof, then explicit Arm succeeds. This is a **real consumer admission trace**, not a claim those199 denials came specifically from headroom400. The exact400 headroom boundary itself is exercised in the production predicate; independent reviewer must disposition this bounded alternative. No easier proof or altered400ms/140ms is introduced.

PostFD2: actual started FD has completion notification held by fake hardware; while a real config transaction is pending (actualTX+95msresponse), fake motor completes with expected3200delta and sends valid FD2. Its correlated config response arrives afterward, increments refresh exactly1 but actor remains Completing/notready/reserved. Only genuine new diagnostic/three-position transactions complete515ms later. Additional mutant treating config reply as completed position proof compiles and fails this assertion in fixture28. No production position-history injection or synthetic approved seed.

Remaining NOT_RUN: arbitrary initial seed distributions beyond the observed real2662ms cluster; isolated real-actor configTTL4000 race or headroom400 denial absent the other public guards; exhaustive per-API timing/overflow/replay permutations. These are explicit limits of the bounded predicate+consumer alternative, not a full017matrix claim. Independent L4R2 must accept or reject closure; D remains blocked until actual C PASS. Raw R2 initial changed-entry setup failure is preserved (measurement began after own had already refreshed multiple entries; corrected to snapshot immediately before one actual refresh).
