WINNAKEN/robot-arm-lab/docs/design/001-mks-can-two-axis-test-plan.md

> 개발 이력: 작성 당시의 계획·결과입니다. 현재 상태는 [STATUS](../STATUS.md)를 확인하세요. 원시 로그와 로컬 경로 일부는 공개본에서 제외했습니다.

# MKS CAN 2축 벤치 시험 준비·구매·시험 계획서

작성일: 2026-10-22 · 프로젝트: robot-arm-lab · 기획 #2
상태: **계획 초안 / 실행 전 / 사용자 검토 대기**

후속 상세: 선택한 ESP32 CAN-U 기준 배선·명령·수령 순서는 [배선·CAN 명령 실행 가이드](003-wiring-and-can-command-guide.md)를 따른다. 이 문서의 초기 PC 진단 구매안과 구분한다. 보호장치·퓨즈·실물 정격·펌웨어 구현은 여전히 미확정 또는 미수행이다.

## 1. 이번에 하려는 일

주문한 **SERVO42D CAN MT 모터·드라이버 2세트**를 선택한 **Waveshare ESP32-S3-RS485-CAN-U**의 CAN 버스에 연결하여,
각 모터의 위치 제어와 읽기, 두 노드 구분, 두 축 동시 운전, 정지 및 통신 단절 대응을 확인한다.
처음에는 링크나 감속기를 달지 않고 모터를 고정한 탁상 시험으로 시작한다.
여기서 ‘2축’은 독립된 모터 두 개다. 2관절 로봇의 끝단 좌표 제어까지 포함하지 않는다.

이번 산출물은 준비물·구매 조건·시험 순서를 정한 계획서다.
프로그램 설치, 제어 코드 구현, 펌웨어 변경, 배선, 전원 인가, 구매는 아직 실행하지 않았다.
모터 시험 성공도 완성 6축의 토크·정밀도·가반하중을 검증한 결과로 해석하지 않는다.

## 2. 현재 확인된 것과 남은 확인

| 항목 | 현재 상태 | 후속 확인 |
|---|---|---|
| 모터·드라이버 | 사용자 확인: 실제 주문 옵션은 **CAN MT**, 2세트 주문 완료 | 수령 시 라벨·CAN 단자·실제 수량 확인 |
| 상품 링크 | [주문 상품 페이지](https://ko.aliexpress.com/item/1005010202913740.html) 제공됨 | 자동 열람 불가. 선택 옵션·동봉품·상품 세부 사양 미열람 |
| 상품 화면 | 첨부 화면의 선택 옵션은 RS485 MT | 실제 주문은 CAN MT라는 사용자 답변을 주문 정보로 채택 |
| 모터 정격 | NEMA17 계열을 전제로 계획 | 정확한 모델, 상전류, 길이, 스텝각, 장착 치수 기록 |
| 드라이버 버전 | SERVO42D CAN 전제로 계획 | 하드웨어·펌웨어 버전 두 대 모두 기록 |
| PC | Windows 노트북 가정 | 사용 PC의 OS·USB 포트 확인 |
| 전원·어댑터·계측기 | 보유 여부 미확인 | 아래 목록에서 보유품을 제외하고 구매 |

**주문 모터와 드라이버는 추가 구매 목록에서 제외한다.** 화면만으로 RS485 주문으로 재분류하지 않는다.
CAN MT라는 옵션명만으로 펌웨어 V1.0.9나 케이블 포함을 확정하지 않는다.

## 3. 초기 PC 진단 구성 참고

아래는 초기 계획의 PC 진단 경로다. 현재 주 제어기는 ESP32 CAN-U이며 USB-CAN 구매가 필수는 아니다. 도착 전 준비와 ESP32 기준 기능 구성은 [도착 전 준비 계획](002-before-arrival-preparation-plan.md)을 따른다.

```text
Windows PC ─ USB 데이터 케이블 ─ USB-CAN 어댑터
                                     │
                       CAN H / CAN L / 신호 기준 GND
                                     │
                                 드라이버 1 ─ 드라이버 2
                                   ID 1         ID 2

24V DC 전원 ─ DC 차단 장치 ─ 퓨즈·분배 ─ 각 드라이버 전원
                                              │
                                           각 모터
```

그림은 연결 관계다. 단자 번호·커넥터 핀맵·접지 상세 배선도는 아니다.
CAN은 한 줄의 버스로 구성하고 긴 별형 분기를 만들지 않는다.
전원은 두 드라이버에 분배하며, USB 포트로 모터를 급전하지 않는다.

별도 PC 진단이 필요한 경우의 참고 경로는 **MKS CANable 계열 + Windows Cangaroo**다.
제공 공식 매뉴얼 Part 13에 이 조합이 예시로 있다.
[CANable 공식 안내](https://www.canable.io/getting-started.html)도 Windows Cangaroo의
candlelight/slcan 지원을 설명한다. 실제 구매 모델·탑재 펌웨어·Windows 드라이버와
선택한 Cangaroo 배포본의 조합은 판매 사양으로 별도 확인한다.

‘USB-CAN’이라는 이름만 보고 구매하지 않는다. USB-RS485, USB-TTL은 이 구성의 대체품이 아니다.
후속 자동 기록에 Python을 쓰려면 해당 어댑터의 인터페이스 지원을 먼저 검토한다.
이번 계획에는 자동화 코드 제작이나 펌웨어 교체를 포함하지 않는다.

## 4. 추가 구매 목록

수량은 두 모터를 같은 책상에서 시험하는 최소 구성 기준이다.
보유품·동봉품이 있으면 제외한다. 아래 규격은 선정 조건이며 특정 판매품의 호환 보증이 아니다.
최종 구매 전에는 모터 정격, 어댑터 펌웨어, 단자 규격과 각 부품 정격을 대조한다.
현재 판매가·재고·배송비를 확인한 견적서는 아니다.

### 4.1 첫 전원·통신·회전 시험 전에 필요한 품목

| 번호 | 품목 / 구매 검색어 | 수량 | 구매 조건과 용도 |
|---|---|---:|---|
| B01 | USB-CAN 어댑터 / `MKS CANable Windows Cangaroo` | 1개 | Classic CAN 표준 11비트 프레임, 500 kbit/s, Windows Cangaroo 조합 지원. CAN H/L/GND 단자, 펌웨어 종류, 종단 스위치 유무 확인. 절연형은 예산이 허용하면 우선 검토 |
| B02 | USB 데이터 케이블 | 1개 | 어댑터의 실제 USB 단자와 PC에 맞는 데이터용. 충전 전용 제외. 어댑터 동봉 시 제외 |
| B03 | 24V DC 전원공급기 | 1대 | 전류 제한·전압/전류 표시가 있는 실험용 전원 우선. **24V/5A급은 구매 후보 용량**이며 주문 모터·설정 전류와 동시 운전 소비전력 확인 뒤 확정. 36/48V 제품 제외 |
| B04 | 차폐 연선 CAN 케이블 | 총 1m | 최신 사용자 선택 CF888.021 1m×1개. 두 구간과 연결 여유를 합쳐1m이내인 배치가 전제. Wave CAN-U 외부는 H/L만 노출되므로 전원/확장 GND를 추가 CAN 기준선으로 연결하지 않음 |
| B05 | DC 전원 배선 / 적·흑 연선 | 각 색 2~3m | 주간선 0.75~1.0mm², 짧은 분기 0.5~0.75mm²를 검토 시작점으로 삼음. 허용 전류·길이·단자 수용 굵기·퓨즈 협조 확인 후 결정 |
| B06 | 전원 분배 단자·절연 커버 | 1세트 | +24V/GND를 두 드라이버로 분배. 공급 전류 이상 정격, 노출 도체가 없는 구조 |
| B07 | 인라인 퓨즈 홀더 + 퓨즈 | 분기용 2세트, 예비 퓨즈 | 분기 도체·단자·기동 전류에 맞춰 정격 선정. 전원 측 주 보호도 확인. 임의로 5A/10A 고정하지 않음 |
| B08 | 래칭 정지 버튼 + DC 전원 차단 회로 | 1세트 | 어댑터/PC와 독립하여 두 드라이버의 DC 급전을 차단. 버튼에 DC 부하 차단 정격이 없으면 버튼은 DC 정격 릴레이/접촉기 코일 제어용으로 사용. 보호 소자·하우징 포함 선정 |
| B09 | NEMA17 모터 고정 브래킷 | 2개 | 주문 모터 장착 치수 확인. 축·후면 엔코더·버튼을 가리지 않는 형태 |
| B10 | 베이스판·볼트·너트·와셔·스페이서 | 1세트 | 모터 두 개가 회전 반력으로 움직이지 않도록 고정. 볼트 길이는 모터 도면 확인 후 선택 |
| B11 | 디지털 멀티미터 | 1대 | DC 전압, 저항, 도통 측정. 기존 보유품 사용 가능 |
| B12 | 터미널용 압착 페룰·압착기·탈피기·수축튜브 | 1세트 | 실제 전선 굵기와 단자에 맞춤. 보유 공구 제외 |
| B13 | 드라이버·어댑터용 맞춤 커넥터 / 단자 플러그 | 필요한 수량 | 드라이버 2대 및 어댑터의 핀 수·피치·암수·나사 규격을 수령품으로 대조. 동봉 단자 있으면 제외. 사진만 보고 피치 확정 금지 |
| B14 | 가벼운 축 표시물·각도 눈금 | 모터별 1세트 | 회전 방향·대략 각도 관찰용. 길고 무거운 레버 대신 짧은 표시 사용. 정밀도 계측기로 간주하지 않음 |

전원 선택에서 **모터 상전류 두 개의 합을 그대로 24V 전원 입력전류로 계산하지 않는다.**
드라이버의 전류 제어 방식과 운전 조건 때문에 서로 다른 값이다.
우선 한 대의 저속·무부하에서 전원 전압과 입력전류를 관찰한 뒤 두 대 운전으로 확대한다.
전원 제한에 걸려 보드가 재시작하면 합격이 아니라 전원·설정 재검토 대상으로 기록한다.

첫 구성은 AC 단자가 노출되는 오픈프레임 SMPS보다 외함이 있는 전원 또는 실험용 전원을 우선한다.
이미 보유한 SMPS를 쓴다면 AC 인입·접지·퓨즈·외함 작업은 해당 작업이 가능한 담당자가 별도로 구성한다.
정지 버튼 복귀만으로 모터가 다시 움직이지 않도록 재시작 절차를 시험한다.
이는 벤치 급전 차단 장치 계획이며 안전 인증된 로봇 정지 기능의 검증을 뜻하지 않는다.

### 4.2 2축 버스·원점복귀 단계에서 필요한 품목

| 번호 | 품목 | 수량 | 구매·준비 조건 |
|---|---|---:|---|
| B15 | 120Ω 종단저항 또는 스위치형 종단 | **버스 양 끝 총 2개분** | 보드·어댑터 내장 종단을 먼저 계산. 둘 다 내장되어 있으면 외부 저항 0개. 예비로 120Ω 1% 0.25W급 2개 준비 가능 |
| B16 | 홈 스위치 | 축당 1개, 총 2개 | 첫 후보는 Makerbase SERVO42D 호환 5V NPN형 광센서 또는 무전압 접점형. 보드 입력 회로·핀맵·유효 레벨 확인 후 선택 |
| B17 | 홈 스위치 브래킷·가벼운 트리거 플래그·배선 | 축당 1세트 | 단순 모터 회전에 스위치가 자동으로 눌리지 않음. 센서와 축 표시물 사이에 반복 가능한 검출 기구 필요 |
| B18 | 온도계 또는 접촉식 온도센서 | 1개 이상 | 모터/드라이버 표면 온도 추세 기록. 제품별 허용 온도 확인 후 중단 기준 설정 |

42D 매뉴얼은 EVCC/EGND를 **5V·20mA 공급**으로 설명한다.
센서 두 개를 한 포트에 묶거나 24V 센서를 해당 5V 출력에 연결하는 구성은 채택하지 않는다.
좌우 양쪽 한계까지 검증하려면 센서 추가와 EN/DIR 포트 재매핑 검토가 필요하다.
이번 기본 구매는 홈 센서 두 개이며, 완전한 좌우 리미트 구성으로 표기하지 않는다.

### 4.3 보유 장비 사용 또는 나중에 구매할 것

- 동시 시작 시차를 실제로 재려면 두 축이 함께 보이는 고속 촬영 장비나 공통 시간축의 센서/계측기.
  PC의 CAN 송신 시각만으로 실제 두 모터가 같은 시각에 움직였다고 판정하지 않는다.
- 정확한 반복 정밀도가 필요해지면 독립 각도 계측기. 내장 엔코더 읽기만으로 외부 기계 정밀도를 보증하지 않는다.
- 감속기·링크·그리퍼·남은 4축·RobStride·ROS2용 장비는 이번 구매에서 제외한다.

### 4.4 바로 사용할 구매 체크리스트

- [ ] 보유 전원·멀티미터·공구 확인 후 B03/B11/B12 중복 제외.
- [ ] B01 어댑터 1개 + 동봉되지 않은 경우 B02 USB 케이블 1개.
- [ ] B04 CAN 케이블, B05 전원선, B06 분배 단자, B07 퓨즈.
- [ ] B08 DC 차단 구성, B09 브래킷 2개, B10 베이스·체결 부품.
- [ ] B13 플러그는 동봉품 확인 후 부족분만. B14 축 표시물 준비.
- [ ] B15 종단은 내장 여부 확인 후 부족분만.
- [ ] B16 홈 센서 2개 + B17 검출 기구. B18 온도 기록 장비 준비.

## 5. 배선·설정에서 먼저 정해야 할 사항

### 5.1 종단 구성은 단일 모터와 2축 버스를 구분

**현재 Wave CAN-U 구성 확정안:** 1축은 Wave ON/축1 ON, 2축은 Wave ON/축1 OFF/축2 ON. 물리적 양 끝의 내장120Ω을 사용하고 전체 무전원 H–L 약60Ω을 확인한다. 제조사 회로·MKS 예외 비교 근거는 최신 가이드 §2. 아래는 초기 PC 어댑터 선택 때 남겼던 일반 검토 조건이며 Wave 단자표를 대신하지 않는다.

받은 시작 안내문은 버스 양 끝 120Ω 두 개를 준비하라고 안내한다.
반면 공식 V1.0.9 매뉴얼 §2.3은 단일 모터 예시에 종단 점퍼를 연결하지 말라고 적는다.
따라서 ‘상황과 무관하게 두 개 추가’라는 규칙으로 단순화하지 않는다.

- **단일 모터 단계:** 공식 단일 연결 예시와 선택 어댑터 설명서를 대조하여 종단 ON/OFF를 기록한다.
  어댑터 내장 종단을 알 수 없거나 두 문서의 요구가 충돌하면 전원 인가 전 해결한다.
- **2축 단계:** PC 어댑터 → ID1 → ID2의 물리적 양 끝에만 각각 120Ω이 되도록 구성한다.
  중간 노드의 내장 종단은 해제한다. 전원을 모두 끈 상태에서 의도한 종단 두 개가 병렬이면
  H-L 저항 약 60Ω을 기대한다. 보드 회로 영향이나 문서 차이로 맞지 않으면 원인 확인 후 진행한다.
- 신호 기준 GND는 공식 도면과 어댑터 절연 구성을 따른다. 절연형 어댑터의 CAN 측 GND와
  USB/섀시 GND를 임의로 연결하여 절연을 우회하지 않는다.
- 케이블 변경·종단 점퍼 변경·모터선 변경은 전원 차단 후 수행한다.

### 5.2 처음 사용할 설정 후보

| 항목 | 후보 | 확정 조건 |
|---|---|---|
| 통신 | Classic CAN, 표준 프레임, 500 kbit/s | 어댑터와 두 보드 동일 설정 |
| 노드 ID | 1, 2 | 보드 한 대씩 연결해 설정하고 라벨 부착. 둘 다 기본 ID1인 채 접속하지 않음 |
| 운전 모드 | SR_vFOC / CAN 버스 FOC 모드 | 실제 펌웨어 메뉴·매뉴얼 대조. 읽기 응답만 온다고 동작 모드 적합으로 판정하지 않음 |
| 전류 | 모터 정격 이하의 낮은 값에서 시작 | 정격과 보정 절차 확인 후 결정. 42D 최대 설정 3A를 초기값으로 사용하지 않음 |
| 속도·변위 | 초기 목표 5~10rpm, ±10~30° 이내 | 실제 명령의 단위·가속도 의미와 최소 유효값 확인. 보정 동작은 별도 매뉴얼 절차 |
| 전원 투입 시 동작 | 자동 구동·자동 원점복귀 비활성 | 재전원 시험에서 실제 정지 상태 확인 |
| 응답 | 노드별 응답 활성 | ID·명령·상태·위치·에러를 기록할 수 있어야 함 |
| 통신 단절 보호 | 초기 후보 1,000ms, 확인/유지 명령 주기 후보 100ms | 버전별 지원·범위·지속성 확인. 수동 GUI만으로 주기 유지 불가하면 이 시험은 보류 |

위 속도·각도·주기·시간은 **본 시험의 제안값**이며 제조사 성능 보증값이 아니다.
매뉴얼 §5.2.15의 heartbeat는 ‘어떤 호스트 명령도 일정 시간 받지 않으면 정지’하는 방식이며 기본값 0은 비활성이다.
시험 중 GUI의 자동 반복 송신이 계속되면 통신 단절 시험 조건이 성립하지 않으므로 송신원을 모두 확인한다.
설정이 재부팅 뒤 유지되는지도 별도 확인한다.

## 6. 단계별 시험 순서와 종료 조건

앞 단계가 미확인/실패면 다음 단계로 확대하지 않는다.
각 단계는 기록 후 진행하며, 실패 시 그 단계의 원인을 확인한다.
정지·통신 단절 시험도 낮은 속도·무부하·고정된 모터에서 수행한다.

| 단계 | 할 일 | 통과 조건 / 남길 증거 |
|---|---|---|
| T0 수령·정격 확인 | CAN MT 2세트, 모델·버전·모터 정격·단자·동봉품 기록. 구매 목록 확정 | 두 보드 사진·버전·정격표, 전원/어댑터/배선 선정 근거 확보 |
| T1 무전원 점검 | 브래킷 고정, 모터 상 배선, DC 극성, 퓨즈, 단자, 첫 단계 종단 상태 확인 | 회로 연결표와 도통/단락 점검 기록. 전원 차단 장치의 동작 확인 |
| T2 보드별 첫 기동·보정 | 한 대씩 무부하 보정. 두 번째는 분리. 전류 제한과 자동 동작 OFF 확인 | 보정 완료, 오류 없음, 설정 기록. 이상 발열·진동·전원 제한 시 중단 |
| T3 단축 CAN 읽기 | 한 대의 ID·버전·상태·위치 읽기, 이어 다른 대를 분리 상태로 ID2 설정 | 각 보드 100회 조회에서 응답을 해당 ID·명령으로 식별. 누락·잘못된 프레임·응답 오류를 집계 |
| T4 단축 저속 운전·정지 | 각각 작은 상대 이동 → 반대 방향 복귀. 처음에는 한 동작마다 관찰. 정지 명령과 DC 차단을 각각 시험 | 방향·이동량이 의도와 맞음. 상태/엔코더/영상 기록. 정지 후 자동 재구동 없음 |
| T5 두 노드 연결·개별 운전 | 전원 OFF 후 2축 버스 구성·종단 재점검. ID1/ID2 조회. 한 대만 움직이는 명령을 번갈아 수행 | 각 ID 100회 조회. 지정 축만 명령 수행, 타 축의 의도치 않은 동작 없음. 전압 강하·재부팅 없음 |
| T6 두 축 동시 운전 | 순차 명령 기준선 확인 후, 지원 시 동기 플래그로 각 축 명령 준비 → 공통 시작. 서로 다른 작은 변위로 20회 시험 | 준비 중 대기와 시작 후 두 축 동작을 관찰. 두 축 모두 도착·상태 확인. 시작 시차는 측정 장비가 있을 때만 보고 |
| T7 스위치 원점복귀 | 센서 전기 레벨을 먼저 수동 검출. 트리거 기구 설치 후 한 축씩 저속 원점복귀 10회 | 잘못된 방향/스위치 미검출 때 즉시 중단. 매회 검출·정지·오프셋 기록. 단순 무한회전 축의 ‘홈’을 로봇 관절 범위로 해석하지 않음 |
| T8 통신 단절·복구 | heartbeat 설정 후 모든 송신 중단 또는 어댑터 분리. 두 축 저속 시험. 소프트웨어 정지와 전원 차단도 구분 기록 | 양쪽 모터의 실제 정지, 실제 경과시간, 단절 후 상태와 복구 절차 기록. 재접속·전원 복귀만으로 재동작하지 않음 |
| T9 반복·온도 관찰 | 정해진 저속 왕복 패턴 20회, 최소 10분 관찰. 시작·중간·종료 전압/전류/온도 기록 | 미응답·보호 오류·재부팅·비정상 동작 없음. 제조사 허용치 내 운전. 허용 온도 미확인 시 장시간 시험 보류 |

T3/T5의 100회와 T6/T7/T9의 반복 횟수는 이번 계획의 기본 표본 수다.
그 범위에서 정상이라는 결과이며 장기 신뢰성 보증은 아니다.
위치 도착 판정에는 펌웨어 임계값, 내장 엔코더 값과 외부 관찰을 함께 남긴다.
정밀도나 반복 오차의 합격 각도는 측정 장비와 용도 선정 후 확정하며 임의로 ±0.1° 같은 수치를 약속하지 않는다.

### 6.1 동시 시작과 동시 도착을 구분

공식 매뉴얼 Part 12의 동기 플래그 기능은 명령을 보관하고 공통 실행 명령에서 시작하는 방식이다.
이것만으로 두 축의 도착 시간이 같거나 로봇 궤적 보간이 된다고 볼 수 없다.
V1.0.9 문서의 관련 명령은 0x4A/0x4B다. 사용 전 실제 탑재 펌웨어 지원을 확인한다.
브로드캐스트 시작에는 응답이 없으므로, 시작 명령 송신 로그만으로 두 축 실행을 통과시키지 않는다.
각 축의 위치·동작 상태와 영상으로 확인한다.

보유 계측기로 두 축 시작을 같은 시간축에서 측정할 수 없다면 결과는
‘동시 운전 관찰, 시작 시차 미측정’으로 남긴다. ms급 동기 성능을 주장하지 않는다.
제3자 Arctos 문서의 브로드캐스트 관련 설명보다 공식 매뉴얼과 실제 버전 확인을 우선한다.

### 6.2 정지 시험의 판정 방법

정지 명령 수신, 실제 회전 정지, 전원 차단은 서로 다른 사건이다.
T4에서 정지 명령 후 회전이 멈추는지부터 확인한 다음 두 축으로 확대한다.
T8의 정지 시간은 마지막 수신/송신 기준과 실제 움직임을 관찰한 시각을 구분해 기록한다.
heartbeat 1초를 설정했다고 정확히 1초 안에 기계가 완전 정지한다고 미리 판정하지 않는다.
허용 정지 시간은 실제 속도·관성·계측 해상도를 정한 뒤 실행 전 확정한다.
허용 시간을 정하지 못한 결과는 측정 기록으로만 남기고 보호 성능 합격으로 분류하지 않는다.

전원 차단 시 모터의 유지 토크가 사라지고 잔류 회전이 가능하다.
이번에는 중력 하중과 긴 링크를 장착하지 않는다. 중력 관절 시험은 기계적 지지 설계 후 별도 계획으로 다룬다.

## 7. 시험 기록 양식

```text
날짜 / 시험자 / 단계 / 통과·실패·미측정:
모터 모델·정격 / 드라이버 HW·FW / CAN ID:
PC OS / 어댑터 모델·FW / 사용 프로그램·버전:
전원 전압·전류 제한 / 동작 전류 / 속도·가속도·명령 단위:
CAN 속도 / 종단 위치·ON/OFF / 무전원 H-L 저항:
명령 시각·ID·내용 / 응답 시각·상태·엔코더·오류:
반복 횟수 / 누락·잘못된 응답 / 전압·전류·온도:
정지 방식 / 시간 기준 / 실제 정지 관찰 / 복구 후 재동작 여부:
관측 파일·영상 경로 / 이상 현상 / 다음 단계 진입 여부:
```

시험 로그·영상은 실행 단계에서 `tests/evidence/` 등 별도 위치를 정해 보존한다.
현재 그 폴더나 제어 프로그램을 미리 만들지 않는다.

## 8. 역할과 착수 전 확정 목록

사용자는 보유 장비·수령품 사양을 확인하고 부품 구매·현장 시험 여부를 결정한다.
문서/소프트웨어 담당은 연결표·명령 단위·검사 기록 양식을 준비하고,
전원·배선 담당은 DC 차단 정격·퓨즈·커넥터·센서 입력을 확인한다.
동일인이 맡더라도 확인 항목은 분리하여 기록한다.

실행 전에 남은 항목:

1. 실제 모터 정격 및 보드 버전, 케이블/단자 동봉 여부.
2. 전원·어댑터·공구 보유 현황과 B01/B03/B08 제품 선정.
3. 단일 및 2축 종단 연결표, 센서 핀맵과 작동 레벨.
4. heartbeat 유지 수단, 중단 조건, 재시작 절차.
5. 시험별 온도·정지시간·위치 오차의 필요한 허용 기준과 계측 가능 범위.
6. 이 계획에 대한 검토 및 실제 시험 착수 지시. 코드가 필요하면 별도 구현 계획과 검수를 수행.

이번 문서는 계획 작성자의 자료 대조를 거쳤으며 **독립 검수는 아직 수행하지 않았다.**
구매나 실험의 실행 승인으로 취급하지 않는다.

## 9. 근거와 읽기 범위

- 받은 `00_robot_arm_START_HERE_KO_20261021.txt` 및 패키지 03의 `01_MKS_CAN_FIRST_PURCHASE_KO.txt`.
- 패키지 03 `Makerbase_official/User Manual/V1.0.9/MKS SERVO42&57D_CAN User Manual V1.0.9.pdf`.
  전체 106쪽의 텍스트를 추출하여 관련 절을 확인했다. 특히 §1.3~1.8, §2.3~2.4,
  §3.1~3.15, Part 4, §5.2.15, §9.2.3, Part 12~14를 참조했다.
  핀과 배선 그림은 PDF 10·18·19쪽을 렌더링해 확인했다. 매뉴얼은 펌웨어 V1.0.9 대응을 명시한다.
- [Makerbase 공식 저장소](https://github.com/makerbase-motor/MKS-SERVO42D-57D): 2026-10-22 확인.
  동기 기능과 버전 차이 확인에 사용했다. 실제 수령품 버전은 별도 확인 대상.
- [CANable 공식 Getting Started](https://www.canable.io/getting-started.html): 2026-10-22 검색 결과의
  Windows/Cangaroo/펌웨어 안내 확인. 본문 직접 열람은 시간 초과. 특정 판매품 호환성은 미검증.
- Arctos 참고 코드의 `docs/commissioning.md`, `docs/can-protocol.md`는 제3자 참고로만 읽었다.
- 사용자 답변: 실제 주문은 CAN MT. 스크린샷의 RS485 선택을 실제 주문 사실로 사용하지 않았다.

모든 소스 코드 실행·벤치 시험·설치·구매·전원 인가 결과: **NOT_RUN**.

## 10. 후속 방향: 노트북 없이 ESP32에서 CAN 제어

2026-10-22 사용자 요청을 반영했다. 노트북은 초기 진단·개발 때 사용하고,
후속 운전에서는 ESP32가 CAN 명령 생성과 응답 처리를 맡는 방향으로 계획한다.
보드 추천 후보는 아래 §11에 추가했다. Wi-Fi/BLE 등 상위 통신 방식은 아직 결정하지 않았다.

```text
조작기 또는 휴대폰(선택) → Wi-Fi/BLE 등 → ESP32
                                         │ TWAI TX/RX
                                   CAN 트랜시버
                                         │ CAN H/L
                                   MKS CAN 2대
```

ESP32-S3는 내장 TWAI 컨트롤러와 외부 트랜시버로 Classic CAN에 접속할 수 있다.
CAN 트랜시버 내장 개발보드를 사용하면 별도 모듈의 중복 구매를 피한다.
보유 ESP32의 칩·노출 핀·트랜시버 유무·3.3V 로직 호환성을 먼저 확인한다.
GPIO를 CAN H/L에 직접 연결하지 않는다.

추가 구매 후보는 TWAI 지원 ESP32 개발보드 1개, 호환 트랜시버 1개,
24V 입력을 지원하는 5V DC-DC 전원 1개, 케이스·단자·배선 1세트,
현장 운전 버튼 1세트다. 무선 조작기는 보유 장비와 조작 방식을 정한 뒤 검토한다.
USB-CAN은 초기 진단용이며 ESP32 단독 운전 중 상시 연결할 필요가 없다.
ESP32부터 바로 시작하는 경우에는 진단 기능과 펌웨어 준비가 추가로 필요하다.

무선 단절과 CAN 단절을 별개로 다룬다. ESP32가 계속 상태 조회·heartbeat를 송신하면
상위 무선 연결이 끊겨도 드라이버 측 보호가 동작하지 않을 수 있다.
따라서 상위 명령 유효기간 만료 시 ESP32의 로컬 정지·운전 허가 해제,
재접속·리셋 후 명시적 재시작, 오래된 명령 폐기를 후속 펌웨어 요구로 둔다.
정지 시간과 만료 시간은 아직 확정하지 않는다. 물리 급전 차단 장치는 유지한다.

기존 T0~T9 뒤에 ESP32의 조회·단축 운전 재현 시험과,
무선 단절·ESP32 리셋·CAN 단절을 구분한 복구 시험을 추가한다.
PC와 ESP32가 동시에 동작 명령을 보내지 않도록 시험별 명령 송신 주체를 정한다.

근거: [Espressif ESP-IDF v5.4.4 ESP32-S3 TWAI](https://docs.espressif.com/projects/esp-idf/en/v5.4.4/esp32s3/api-reference/peripherals/twai.html),
Overview / Signal Lines and Transceiver / Alerts, 2026-10-22 확인.
이는 구조·부품 후보 계획이며 펌웨어 구현·설치·실물 구동은 미수행이다.

## 11. 상품 링크와 예산 참고값 — 2026-10-22

엑셀의 `구매목록`과 `상품링크` 시트에 실제 판매 페이지, 판매 단위, 최소 주문 수량,
참고 가격과 확인 조건을 넣었다. 사용자 주문품은 **MKS CAN MT 2세트**로 유지한다.

추천은 [Waveshare ESP32-S3-RS485-CAN](https://www.waveshare.com/product/iot-communication/short-range-wireless/esp32-s3-rs485-can.htm)
통합 보드 1개다. 공식 표시 가격 범위 US$18.99~19.99 중 상단값 US$19.99로 예산을 잡았다.
CAN 트랜시버·케이스가 포함되고 7–36V 입력을 지원하므로, 이 구성을 선택하면 별도
SN65HVD230 모듈·5V 강압기·케이스는 중복 구매하지 않는다. CAN 버스 하나에 모터 두 대를 연결한다.
MKS 명령을 생성하고 응답을 처리할 펌웨어는 별도로 준비해야 하며 현재 구현·호환 시험은 하지 않았다.

[제조사 설명](https://www.waveshare.com/wiki/ESP32-S3-RS485-CAN)에 따라
DC 단자 전원과 USB 전원을 동시에 연결하지 않는다. 24V는 지정 DC 입력에만 연결한다.
분리형 대안은 [ESP32-S3-Zero-M](https://www.waveshare.com/product/esp32-s3-zero.htm)
(가격 범위 상단 US$7.99 예산)과 [SN65HVD230 CAN Board](https://www.waveshare.com/product/sn65hvd230-can-board.htm)
(US$4.99), 별도 5V 전원·케이스다. 두 구성은 대안 관계다.

가격은 견적 확정값이 아니다. USD는 실시간 환율 대신 **예산 가정 1 USD = 1,500원**을 사용했고
배송비·수입 세금·작업비는 제외했다. 국내 가격은 VAT 포함/별도/불명 여부를 각 행에 표시했다.
공식 사이트 직접 접근이 제한된 일부 상품 가격은 공식 검색 표시 범위를 사용했다.
전선·공구·진단용 USB-CAN·시험용 전원 등은 보유품 확인 후 제외할 수 있다.
WAGO 단자는 최소 10개, 테이프는 최소 2롤, 저항은 최소 10개 조건을 반영했다.

커넥터는 수령품의 피치·핀 수·극성을 확인할 때까지 가격을 비워 두었다.
비상정지 버튼 링크는 조립에 필요한 부품 중 하나이며 완성된 급전 차단 장치가 아니다.
브래킷·베이스·홈 센서 고정부도 실물 치수와 설치 조건 확인이 필요하다.
상품 목록은 판매 중인 후보를 조사한 결과이며 최저가·재고·실물 적합성을 보증하지 않는다.
공개 페이지 조회 증거와 품목별 데이터는 `.dev/spreadsheet-build/live-price-records.json` 및
`purchase-quotes.json`에 보관했다. 구매·장바구니 추가·판매자 문의는 하지 않았다.

### 통합형 기준 구매 순서와 소계

추가 보유품 없음 가정으로 기존 가격을 재사용했다. 엑셀 구매목록 B열로 구분하고,
F열을 `보유` 또는 `제외`로 바꾸면 해당 품목은 합계에서 빠진다. 보유·대여 장비와 동봉품을 먼저 확인한다.

| 구분 | 범위 | 참고 예산 |
|---|---|---:|
| 우선 준비 | ESP32 통합형, 업로드용 USB 케이블, 전류 제한 전원, CAN·전원 배선, 분배 단자·퓨즈, 급전 차단 구성, 모터 고정·베이스, 멀티미터·배선 공구, 부족한 호환 단자 | 467,688원 + 미확정 단자 비용 |
| 나중 | PC용 USB-CAN, 포인터 테이프, 홈 스위치·고정부, 온도계, 운전 버튼 | 98,446원 |
| 조건부 | 내장 종단으로 양 끝 120Ω 구성을 충족하지 못할 경우 저항 예비팩 | 3,740원 |
| 중복 제외 | 별도 트랜시버·5V 변환기·외함, 새 조작기/공유기 | 추가 반영 없음 |

우선 예산에는 **급전 차단 회로 가예산 60,000원**을 포함했다. 회로·차단 정격 선정 전에는
해당 부품 구매를 보류한다. 이를 제외한 소계는 **407,688원**이다. 미확정 커넥터는 0원이 아니라
금액 미반영이며 배송·수입 세금·공임도 별도다. 브래킷·단자 등은 실물 대조 후 구매한다.
첫 시험은 고정한 모터의 무부하 저속 2축 벤치 시험이다. 홈 복귀·실제 로봇암 운전 준비 완료를
뜻하지 않는다. 구매는 진행하지 않았다.

## 12. 구매처 통합 및 가성비 수정안 — 2026-10-22

최신 엑셀은 `MKS_CAN_2축_구매_시험_계획_가성비통합안.xlsx`다. 기존 파일이 사용 중이어서 별도 저장했다.
첫 시트 `가성비 통합안`이 최신 추천이며 기존 구매목록은 비교용으로 남겼다.

선정된 상품은 Waveshare(보드), 디바이스마트(배선·분배 단자·퓨즈 홀더·브래킷·공구),
이노사이언스(시험 전원·멀티미터) 3곳으로 묶는다. 전원·계측기를 보유/대여하면 새 구매처는 2곳이다.
급전 차단 회로와 베이스 고정재는 미선정이므로 전체 준비물의 판매처가 3곳으로 확정된 것은 아니다.

- 신규 준비 예산 **366,656원**: 표시가 품목 소계 238,156원 + 조립·작업재 가예산 128,500원.
- 기존 467,688원 대비 **101,032원(약 21.6%)** 감소. 제품 대체와 물량 축소·제작 예산 변경에 따른 계획 비교다.
- 전원·멀티미터·공구를 모두 적합한 보유/대여로 충족하면 161,956원 가정. 대여비는 미견적이며 별도다.
- 배송·수입 세금·VAT 포함 미확인분·규격 미확정 단자·공임 별도. 모터 주문액은 제외.

CAN 케이블은 기존 BELDEN9841 단가를 유지하고 **총 1m 안에 배치 가능한 밀집 벤치**로 줄인다.
전원선은 [FIT0585 적·흑 18AWG 1m](https://www.devicemart.co.kr/goods/view?no=16057419) 5390원×2개로 잡았다.
[REXBOT 브래킷](https://www.devicemart.co.kr/goods/view?no=16095894)은 Chrome 상세에서
770원(VAT 포함), 구매가능수량59개·재고 소진 후 단종 표시를 확인했다. 주문 모터의 홀·간섭 및
베이스 부착 가능 여부를 검토한 뒤 사용한다. 적합하지 않으면 기존 브래킷 대안과 비용으로 복귀한다.

[UTP1305](https://www.innosci.shop/goods/goods_view.php?goodsNo=1000001062) 143000원 및
[RM113A](https://www.innosci.shop/goods/goods_view.php?goodsNo=1000002424) 13200원은 같은 판매처로 묶었다.
두 상품 VAT 포함 여부는 재확인한다. 저가 계측기 후보의 DC전압·저항/도통 모드·분해능·리드/전지
구성도 구매 전 확인한다. 저가 고정 어댑터로 전류 제한 기능을 생략하지 않는다.

단일 판매처로 전부 모으는 적합 옵션·최종가까지는 확인하지 못했다. 디바이스마트의 더 비싼 전원이나
다른 통합 보드를 택해 구매처 수만 줄이는 방식은 현재 추천하지 않는다. 알리익스프레스는
브라우저 사이트 안전 정책으로 접근이 차단되어 우회하지 않았으며, 알리 가격·로그인 할인·합배송은
확인하지 못했다. 원천 목록과 품목별 선정 조건은 `.dev/spreadsheet-build/value-plan.json`에 보관했다.
이번 수정은 계획만이며 장바구니·주문·결제·구동은 변경하지 않았다.

## 13. 알리 플랫폼 기준 보드 비교와 배송 예산 — 2026-10-22

사용자는 국내 구매만을 요구한 것이 아니라 알리처럼 배송을 관리하는 플랫폼 구매를 허용했다.
최신 파일은 `MKS_CAN_2축_알리_비교와_구매예산.xlsx`이며, 앞의 `알리 추천요약`과
`알리 구매목록`을 이번 구매 판단의 기준으로 삼는다. 뒤쪽6시트는 이전 견적과 시험 참고다.

추천은 **Waveshare ESP32-S3-RS485-CAN 내장 안테나·케이스 포함 옵션**이다.
7~36V DC 입력·절연 CAN·외함이 통합되어24V급 벤치에서 부품과 배선을 줄일 수 있다.
LILYGO T-CAN485는 공식 상품7~12V / GitHub5~12V 표기가 상충하며24V 직결은 금지한다.
이번 비교에는12V 강압기와 외함을 추가했다. 한 CAN 버스에서2축을 제어하므로2채널 보드는 필수가 아니다.

| 시나리오 | 배송 포함 계획값 | 변동 예비비10% 포함 |
|---|---:|---:|
| 필수품 신규 준비 | 335000원 | 368500원 |
| 전원·멀티미터·압착기·수공구 보유/대여 | 163000원 | 179300원 |

신규 품목308000원, 배송은 보드5000+부품/공구12000+전원10000=27000원의 **가예산**이다.
위 값은 알리에서 확인한 견적이 아니다. 모터 기주문 금액, 부족 단자 미확정액, 제작 공임,
대여료는 별도다. 예비비는 가격·배송·세금 변동에 대비한 임의 여유이며 세율·면세 판단이 아니다.
급전 차단 재료60000원과 퓨즈·모터 고정은 필수 준비 예산에 포함하되 회로/규격 확인 뒤 구매한다.

알리 직접 조회 제한으로 정확한 상품·옵션·재고·한국 배송비·합배송은 미확인이다.
LILYGO 제조사가 연결한 알리 상품URL1건과 나머지 품목의 알리 **검색 링크**를 구분했다.
한 플랫폼으로 모았지만 한 판매자나 한 소포로 합칠 수 있다고 확정하지 않았다.
보드 구성 가예산은 Waveshare40000원 / LILYGO43000원이며 사양·추가 부품 기준 추천이다.
실제 결제 조건이 달라지면 재산정한다. 조사 출처·상충·계산은 `_research/esp32-can-marketplace-comparison.md`.

기존 시험 순서는 유지한다. 구매·장바구니 변경·제어 펌웨어 구현·실물 구동은 이번에도 미수행.

## 14. 사용자 선택을 반영한 전체 준비물 현황 — 2026-10-22

사용자는 3개씩 순차 추천 대신 전체 목록을 요청했다. 현재 기준은 모터 2개의 무부하·저속 벤치 시험이다. 아래 현황은 이전 예산안의 품목 가정에 우선하며, 선택 완료와 실제 주문 완료를 구분한다. 기존 엑셀은 아직 이 현황으로 갱신하지 않았다.

### 14.1 주문·보유 확인 또는 제품 선택 완료

| 품목 | 수량/선택 | 확인 상태 |
|---|---|---|
| MKS SERVO42D CAN MT 모터+드라이버 | 2세트 | 사용자 주문 완료 확인 |
| ESP32 CAN 통합 보드 | Waveshare ESP32-S3-RS485-CAN-U 1개 | 외장 안테나형 선택, 주문 완료 미확인 |
| 실험용 전원 | WANPTEK EPS3210 32V/10A, 220V EU Plug 1대 | 선택 완료. 모터 급전 설정은 24V 이하 |
| 적·흑 전원선 | 18AWG 5m 1묶음 | 선택 완료. 짧은 분기용 후보이며 전체 10A 공통 배선 적합성은 별도 확인 |
| WAGO 표기 혼합 커넥터 | 221-12 piece set 1세트 | 선택 완료, 정품 여부 미검증 |
| 퓨즈 홀더+퓨즈 | Small Set 1세트, 홀더 5개 구성 | 선택 완료. 실제 장착할 퓨즈 A값·홀더 정격 미확정 |
| NEMA17 L브래킷 | 42 L bracket / 4pcs 1묶음 | 선택 완료. 시험용 2개+예비 2개 |
| CAN 케이블 | igus CF888.021 길이 1m × 수량 1 | 사용자 길이 변경 확정. 3m 화면 총24993원을 길이비례 환산한1m 약12000원은 추정이며 실제1m 결제액·주문 완료 미확인 |
| 페룰 압착기+페룰, 탈피기, 열수축튜브 | 앞서 안내한 3종 | 사용자 보유 또는 구매 확인, 추가 구매 제외 |

### 14.2 첫 시험 전 남은 선정·보유 확인

| 품목 | 필요한 구성/수량 | 다음 판단 |
|---|---|---|
| CAN 실드·접속 | CF888.021의 두 심을 H/L에 사용 | Wave 외부에는 CAN SGND가 없어 기준 GND 도체 추가 안내를 철회. 전원/확장 GND로 대체하지 않음. 초기 실드 양 끝 절연 잠정안, 장기 섀시 접지는 후속 설계. 상세 가이드 §2 |
| DC 급전 차단 구성 | 래칭 NC 정지 버튼 1개, 적합한 차단 장치 1개, NO 급전 허용 버튼 1개, 박스·보호 부품 | 모델/회로 미확정. 제시된 2채널 자동 잠금 모듈은 채택 보류. 상세 `_research/two-axis-dc-stop-components.md` |
| 고정판·볼트·너트·와셔 | 모터 2개 고정용 1구성 | 사용자 구매 선정 보류. ㄷ자 절곡 타공판/기존 작업판 대체 검토, 실물 구동 전 고정은 필요 |
| 디지털 멀티미터 | 1대 | UT33A+ 후보만 안내. 보유/구매 여부 미확인 |
| USB-C 데이터 케이블 | 약 1m, 1개 | 초기 업로드용. 기존 데이터 케이블/동봉품으로 대체 가능, 보유 미확인 |
| 부족한 단자 플러그·공통 전원 연결선/출력단자 | 실제 부족분만 | 드라이버·보드·전원 동봉품 확인 후 판단. 단자 피치 및 전원 주간선/퓨즈 협조 미확정 |
| 실제 사용할 보호 퓨즈 | 회로·도체·설정 전류에 맞는 값 | 선택한 세트에 해당 A값이 있으면 추가 구매 제외. 동봉 최소값 5A를 사용값으로 확정하지 않음 |
| 120Ω 종단저항 | 버스 양 끝 내장 종단 부족분만, 외장 0~2개 | 내장 종단으로 충족되면 외장 구매 제외. 모든 노드에 추가하지 않음 |

### 14.3 이후 시험 단계에서 준비할 것

| 품목 | 수량 | 준비 시점 |
|---|---|---|
| 홈 스위치+고정부·검출 플래그 | 축당 1개, 총 2세트 | 원점복귀 시험. 입력 규격·기계 검출 구조 확정 후 |
| 온도계/접촉 온도센서 | 1대/세트 | 반복 운전·발열 시험 전, 보유 장비 사용 가능 |
| PC용 USB-CAN | 필요 시 1개 | 별도 PC 진단이 필요할 때. ESP32 단독 제어의 필수 구매는 아님 |
| 일반 운전 버튼/노브 | 필요 시 | 조작 UI 확정 후. 위 급전 허용 버튼과 구분 |
| 가벼운 축 표시물·눈금 | 모터별 1개 | 회전 방향 관찰 때 종이/테이프 등 보유 재료 활용 |

추가 CAN 트랜시버·LILYGO 대안 보드/강압기/외함은 현재 Waveshare CAN-U 선택과 중복되므로 신규 구매 목록에서 제외한다. 나머지 4축 모터, 그리퍼, 감속기, 로봇 링크, RobStride/ROS2 장비는 이후 기구·성능 설계 단계다. 안전 차단 모델이나 고정 방식의 미확정을 전체 준비 완료로 취급하지 않는다. 새 주문·결제·장바구니·펌웨어·실물 작업은 수행하지 않았다.

## 15. 부품 도착 전 준비

사용자가 CF888.021을 **1m × 수량1**로 변경하고 정지 시간 문제 수정과 펌웨어 준비를 계속하도록 지시했다. [도착 전 준비 계획](002-before-arrival-preparation-plan.md)과 [정지 시간 수정·코어 준비007](007-stop-timing-and-firmware-preparation.md)을 따른다. 초기 조작은 휴대폰 웹 화면이며 실제 장치 연결·업로드·실물 시험과 부품 없는 코어 시험을 구분한다. 기존 엑셀/PDF의3m 표기는 선택 변경 전 이력이다.
