WINNAKEN/robot-arm-lab/docs/measure/mks42d-sheet.md

# MKS SERVO42D 실측 기록지 (MP8 · 계획 046)

도착한 모터 두 세트(A · B)를 **전원 없이** 캘리퍼로 재서 적는 종이입니다. 적은 값은 채팅으로 알려 주시면 Claude 가
모터 원장(`src/cad/calibration/motor-mks42d.json`)에 원문 그대로 옮기고, 영향 표(`src/cad/design-check-mp8/motor_impact.py`)를 다시 냅니다.

지금 모든 모델(v1 개념 · v2 · v3 외장 · J2 분할 · 사이클로이드 감속기 · MP5 부하 계산)이 아래 "지금 가정" 값으로 그려져 있습니다.
관절 거리를 그대로 두는 지금 배치에서 **몸체 길이**의 상한은 드라이버 18 · 간격 2 가정 아래 다음과 같습니다 — 실측한 1 · 2 · 3 을 원장에 넣고 영향 표를 다시 냅니다.

- 43 을 넘으면 J1 드라이버가 발(높이 12)에 들어감 — 발을 파지 않으면(파면 바닥 기준 51)
- 43.2 를 넘으면 v3 J4 끝 덮개(민트 사선 0.8 돋움)가 J3 드럼에 닿음
- 43.5 를 넘으면 J2 분할 덮개 기둥 끝(보수 기준) — J2 분할을 다시 그리면 풀림(커넥터 44 · 드라이버 47)
- 44 를 넘으면 v2 꼴 J4 끝 덮개가 J3 드럼에 닿음 · 49.2(v3) / 50(v2) 에서 J6 ↔ J5 드럼

전체 길이(4번 = 1 + 2 + 3)로 보면 위 상한에 20 을 더한 값(63 · 63.2 · 63.5 · 64)이며, 이것은 간격 · 두께를 어떻게 나눠 읽든 같습니다.

## 지킬 것

- 전원 · CAN · 보정(CAL) · 시험 회전을 하지 않습니다. 드라이버 덮개 · 보드 · 엔코더 · 자석을 열거나 풀지 않습니다(분해 금지는 Codex 점검표 `docs/specs/bench-no-can-checklist.md` 의 A 절과 같음).
- 전원을 넣지 않으므로 캘리퍼로 잴 때 모터를 손에 들어도 되고, 시험 조각을 잠깐 끼워 봐도 됩니다(A 절의 「손으로 들고 점검하지 않는다」 는 뒤의 전원 투입을 위한 고정 조건).
- 축에 시험 조각을 끼울 때는 손으로 가볍게만 — 억지로 누르지 않습니다. 끼운 것은 다시 뺍니다(설명서: 보정은 아무것도 달지 않은 상태에서).
- 사진 이름: `A-label.jpg` · `A-side.jpg` · `B-label.jpg` … (세트 · 무엇).

## 1. 치수 (mm · 소수 첫째 자리까지)

| # | 항목 | 재는 법 | 지금 가정 | A | B |
|---|---|---|---|---|---|
| 1 | **몸체 길이** | 앞 장착면(축이 나오는 평면 — 둥근 파일럿 돌출은 빼고)에서 모터 몸체 뒷면까지. 드라이버 보드 · 덮개는 빼고 | 40 | | |
| 2 | 모터 → 드라이버 간격 | 모터 뒷면에서 드라이버 보드(또는 그 받침)까지. 안 보이면 "안 보임" | 2 | | |
| 3 | 드라이버 쌓임 두께 | 드라이버 앞면에서 뒤 덮개(방열 케이스) 바깥면까지. 커넥터 · 단자는 빼고 | 18 | | |
| 4 | 전체 길이 | 앞 장착면에서 맨 뒤(덮개 바깥면 — 커넥터 · 단자 빼고)까지 — 1 + 2 + 3 의 확인용 · 단자 끝까지도 따로 적어 주시면 좋음 | 60 | | |
| 5 | 드라이버 가로 × 세로 | 뒤 덮개의 바깥 크기 | 46 × 46 | | |
| 6 | 커넥터 | 어느 면에 몇 개 · 선을 꽂았을 때 그 면에서 튀어나오는 길이(굽힘 포함) | 12 (옆 한 면) | | |
| 7 | 화면 · 버튼 | 어느 면에 있는지(그림으로 표시해도 됨) | 미정 | | |
| 8 | 프레임 한 변 | 몸체 정사각 단면의 한 변 | 42.3 | | |
| 9 | 모서리 모따기 | 몸체 모서리 45° 면의 폭 | 미정 | | |
| 10 | 파일럿 지름 · 높이 | 앞면 둥근 돌출의 바깥지름 · 장착면에서 솟은 높이 | 22.0 · 2.0 | | |
| 11 | 나사 구멍 간격 | 앞면 M3 구멍 네 개의 중심 사이(가로 · 세로) | 31 × 31 | | |
| 12 | 나사 깊이 | M3 나사를 구멍에 손가락 힘으로 멈출 때까지 돌려 넣음 · 렌치로 조이지 않음 · 깊이 = 나사 길이 − 튀어나온 길이(머리 밑에서 장착면까지). 깊이 게이지가 있으면 구멍 깊이도 | 4.5 (감속기 나사는 4.5 이상이어야) | | |
| 13 | 축 지름 | 둥근 쪽 | 5.0 | | |
| 14 | 축 D 평면 | 평면에서 반대편 둥근 면까지 · 평면 길이(축 끝에서). 판정: 평면 길이 ≥ 축 길이(15) − 2.6 이어야 감속기 아래 편심 축 D 구멍이 끝까지 들어감(축 24 → 21.4 · 23 → 20.4) | 4.5 · 미정 | | |
| 15 | 축 길이 | 앞 장착면(파일럿 옆 평면)에서 축 끝까지. 깊이 바를 Ø22 파일럿 위에 대면 파일럿 높이(2.0)만큼 짧게 읽힘 → 파일럿 옆 장착면에 대거나, 파일럿 위에서 잰 값에 10번의 파일럿 높이를 더함 | 24 (판매처 그림 23 — RS485 판) | | |
| 16 | 질량 (저울이 있으면) | 모터 + 드라이버 한 세트(선 빼고) | 310 g | | |
| 17 | 라벨 글자 | 모터 · 드라이버 라벨에 적힌 그대로(모델 · 전류 · 토크 등) — 사진 | — (유지 토크 가정 0.40 N·m) | | |

## 2. 출력해 둔 시험 조각에 끼워 보기 (손으로 · 억지로 누르지 않음)

| # | 무엇 | 어디 | 판정 말 | A | B |
|---|---|---|---|---|---|
| 18 | 파일럿 판 셋 Ø22.15 / 22.30 / 22.45 (`C1_NEMA17_PLATE_1…3`) | 시험편 v1 ① | 들어가는 가장 작은 판 · 흔들림 | | |
| 19 | 감속기 맞춤 확인 판의 D 구멍 4.90 / 5.00 / 5.10 (`FIT_STRIP` 의 motor D-shaft bore 줄) | MP6 맞춤 확인 판 | 손으로 빡빡하게 들어감 · 헐거움 · 손으로 안 들어감 | | |
| 20 | (M3 나사를 받았다면) 시험편 ③ M3 통과 구멍 3.2 / 3.4 / 3.6 | 시험편 v1 ③ | 쑥 들어감 · 빡빡함 · 안 들어감 | — | — |

## 3. 다음

- 1 ~ 17 → 모터 원장 `items`(measured) · `observations`(원문) → 영향 표. 원장 키:
  1 `body_length` · 2 `motor_driver_gap` · 3 `driver_depth` · 4 `overall_length` · 5 `driver_width` · 6 `connector_clearance`(어느 면인지는 원문에) ·
  7 `display_button_face` · 8 `frame` · 9 `frame_corner_chamfer` · 10 `pilot_dia` · `pilot_height` · 11 `bolt_square` · 12 `screw_thread_depth` ·
  13 `shaft_dia` · 14 `shaft_flat_to_axis`(잰 값 − 축 지름 ÷ 2) · `shaft_flat_length` · 15 `shaft_length` · 16 `mass_motor_with_driver` ·
  17 `label_text` · `label_holding_torque`(라벨에 토크가 있으면).
  - 몸체 길이가 위 상한(43 · 43.2 · 43.5 · 44 — 드라이버 18 · 간격 2 가정 아래)을 넘으면, 발을 팔지 · 관절 거리를 그대로 둘지(모터 배치를 바꿈) 바꿀지(URDF 다시)를 여쭙니다.
  - 축 D 평면 길이가 (축 길이 − 2.6)보다 짧으면 감속기 아래 편심 축의 D 구멍을 고쳐야 하므로 여쭙니다.
- 18 · 19 → 끼움 원장 `print-fits.json` 의 observations 에만 먼저 적습니다. 값(`pilot_hole_dia` · `d_bore_extra`)을 바꾸면 사이클로이드 감속기를 다시 만들어야 하므로(감속기 지문이 값에 묶임), 값은 베어링이 와서 감속기 맞춤 판정을 할 때 함께 바꿉니다.
