WINNAKEN/robot-arm-lab/docs/design/076-results.md

> 개발 이력: 작성 당시의 계획·결과입니다. 현재 상태는 [STATUS](../STATUS.md)를 확인하세요. 원시 로그와 로컬 경로 일부는 공개본에서 제외했습니다.

# 075·076 결과 — 정지 통과, 큰 동작 정착 미통과

2026-10-30. 사용자 지시에 따라 쿼터니언 정규화와 게인 표현 문제를 수정했다. 기준은 변경하지 않았고 포그는 실제 USD visibility=invisible로 숨겼다. 실물 보정·모터/CAN 운전·설치·재부팅·학습은 수행하지 않았다. 질량·관성은 가정이며 링 형상은 보류한다. 로봇 자기 충돌은 기존 중첩 AABB 대체 형상 때문에 OFF이고, 바닥 충돌은 ON이다.

## 변경과 검증

- 075: 회전 행렬 계수 2/norm²를 TCP·중력 참조에 일관 적용. 첫 양의 물리 스텝 전에 tensor backend에서 동일한 Kp64/Kd16을 설정하고 실제 readback의 정확 일치를 검사한다. 수치 반올림·허용오차 확대·게인 증가는 없다.
- 075 import·2초 정지는 정식 통과. 첫 큰 동작은 step492/4.1초에서 렌더 시간 표현 불일치로 실패했다. 해당 원본 FAILED와 원장을 보존했다.
- 076: 원 rational→float64→1e9 곱→정수 절삭 순서를 명시하고, raw·binary64 hex·실제 엔진 시간·프레임 상태를 정확히 결속한다. 1tick stale은 거부한다. SDK·모델16개·물리 기준·52초 경로·정규화·게인·초기화는 075와 동일하다.
- HOST: 075 48/29/14/15/13, 076 여기에 codec13을 추가했다. 소스 비작성자 L2·L4와 HOST는 실제 SDK 시험을 대체하지 않는다. 메타데이터 재생 대조와 521시점 산술 검사는 native 성공으로 표시하지 않았다.

## 실제 076 실행

| 목적 | 실행 ID | 정식 결과 | 원 프로세스 |
|---|---|---|---|
| 가져오기 | 3171e172ec6d46e9a785ff6a443bdf70 | IMPORT_VERIFIED | actual0 / policy0 / REAPED |
| 2초 정지 | b1ba3f2e4a5743d38022b768803e77b4 | SMOKE_VERIFIED | actual0 / policy0 / REAPED |
| 큰 6축 동작 | e7da7a7c48f44e14a34d1f975931d1b8 | LATEST_SCENE_DYNAMICS_FAILED | actual0 / policy0 / REAPED, 로컬 수용 종료코드1 |

큰 동작은 52초·6240 스텝·6241 상태·521 프레임까지 완료했다. 프로세스 정상 종료는 물리 검증 통과가 아니다. 정착만 미통과이며, 정식 root의 관절 제한·속도 제한·중력 여유·바닥 여유·정기구학·그리퍼 동기·실제 렌더·전체 경로·큰 동작 범위 검사는 통과했다. FK 최대 위치 차이는 7.575µm, TCP 경로 지름은 0.895787m, 최소 바닥 여유는 17.452mm였다. 이 값은 인증 작업공간 반경이나 실물 안전 검증이 아니다.

| 정착 지점 | 스텝 | 미통과 관절 |
|---|---:|---|
| raise_settle | 960 | J2, J3, J5 |
| sweep_left_settle | 1800 | J1 |
| sweep_right_settle | 3000 | J1 |
| reach_high_right_settle | 4080 | J2, J3, J5 |
| sweep_high_left_settle | 5280 | J2 |
| return_safe_settle | 6240 | J1, J2, J3, J4, J5 |

원 기준은 각도 오차≤0.5°, 속도≤1°/s. 정착 지점의 최대 오차는 3.48677°, 최대 잔류 속도는 5.48899°/s다. 임계값·cap·gain을 바꾸거나 추가 native 재시험을 하지 않았다. 후속 조사 후보는 실제 토크 포화 구간과 위치 경로에 대한 속도 목표 일관성이다. 현재 움직이는 위치 목표에 대해 velocity target=0이 설정돼 있다는 것은 소스 관측이고, 그것이 정착 실패의 원인이라는 판단은 아직 추론이다. 새 제어 수정이나 대조시험은 미실행이다.

## 영상·보존·시간 범위

실제 RTX PNG에서 인코딩했다. 640×480·10fps, 원속도 52.1초/521프레임과 3배속 17.3초/173프레임 모두 전 구간 디코딩 검사 통과. 첫·중간·끝 프레임에서 포그 없음과 실제 자세 변화를 확인했다. 영상 파일명은 FAIL을 유지한다.

- 원속도 영상 (비공개 링크 제외)
- 17초 요약 영상 (비공개 링크 제외)
- Drive 크기·MIME·부모 폴더를 재조회했다. 원격 해시 비교를 했다고 주장하지 않는다.
- 별도 provenance JSON 업로드는 내부 경로·실행 정보가 포함될 수 있고 별도 업로드 승인이 없다는 자동 승인 검토 사유로 거부됐다. 재시도·우회하지 않았고 로컬 video/provenance.json을 보존했다.
- 076 전체 단위 계획은 23:30~00:00UTC 30분에 인계까지 포함했다. native 실행 종료 23:57:04UTC, 원본 회수 관측 23:59:12UTC. 이미 시작한 로컬 최종 검증·영상/인계 정리는 00:00 이후까지 이어져 **전체 30분 준수는 미달**이다. 이를 native 전용 제한으로 소급 변경하지 않는다. 00:00 이후 새 SDK·시험·튜닝·검토 라운드는 시작하지 않았다.
- 진행 조회의 기본 FAILED 상태를 실제 실패로 성급히 안내한 뒤 정정했다. 최종 판단은 오류 기록·종료코드·완료된 root 결과를 사용했다.

정본: outputs/isaac-render-time-v1/result.json, motion-observation-summary.json, drive-delivery.json, budget.json 및 각 runs의 원 report·terminal·exit·validation. 원 075 실패는 outputs/isaac-representation-v1에 별도로 보존한다.
