WINNAKEN/robot-arm-lab/docs/design/077-results.md

> 개발 이력: 작성 당시의 계획·결과입니다. 현재 상태는 [STATUS](../STATUS.md)를 확인하세요. 원시 로그와 로컬 경로 일부는 공개본에서 제외했습니다.

# 077 결과 — 속도 참조 수리·추종 개선, 정착 미해결

2026-10-30. 사용자의 새 계획 지시에 따라 진행했다. **전체 물리 수용 결과는 LATEST_SCENE_DYNAMICS_FAILED**다. 실물 보정·모터/CAN 운전·설치·재부팅·구매·학습은 하지 않았다. 포그는 실제 native USD visibility=invisible이며 첫·중간·끝 프레임에서 확인했다.

## 수정과 검증 범위

기존52초 quintic 위치 경로에 맞는 해석적 속도 `delta*30*u²*(1-u)²/T`를 함께 전달한다. 이동 중 속도0 명령을 없애고, 정지·경계·고정40mm 그리퍼에서는0을 유지했다. 참조64bit와 binary32 명령을 별도로 기록하고 독립 root가 미분·인코딩·실제 tensor readback을 대조한다. 원 readback1e-8 조건도 유지했다.

동결 URDF v3·SDK·초기화·쿼터니언 정규화·시간 코덱·Kp64/Kd16·토크 cap·중력·관절/속도 제한·52초 위치 경로·정착0.5deg/1deg/s·바닥5mm 기준은 변경하지 않았다. 질량·관성은 가정이다. 기존 중첩 대체 충돌 형상 때문에 자기 충돌은 OFF, 바닥 충돌은 ON이다. 링 형상은 보류하며 최신 제작 CAD 변경까지 반영됐다고 주장하지 않는다.

HOST152(48/29/14/15/13/13/20) 통과. 위치6241점 불변, 독립 미분/인코딩 일치, 중앙차분200점 최대 차이4.86e-10, 실제 호출 인수의9DOF 순서, 속도0·부호·phase·열교환·과속·비유한값·ULP 음성 대조를 포함했다. L2/L4R1 비작성자 검토도 통과했다. 같은 계열 별도 세션 폴백이므로 외부 계열 검토와 동일시하지 않는다.

## 실제 Isaac 결과

| 목적 | 실행 ID | 정식 결과 |
|---|---|---|
| 가져오기 | 4f993dabe21c4bbc8f0a8636d2f2bb05 | IMPORT_VERIFIED |
| 2초 정지 | d88bdb5330fb409c874f237f29061355 | SMOKE_VERIFIED |
| 큰6축 | dd04bb987c364da788de242333e61ad0 | LATEST_SCENE_DYNAMICS_FAILED |

각 목적1회. 모두 actual0/policy0/REAPED/noTimeout이며, 큰 동작의 로컬 수용 종료코드는1이다. Native513.031초 후 정상 종료했고 원장3개와 lock 해제를 읽어 보존했다. 프로세스0을 물리 PASS로 승격하지 않는다.

52초·6240스텝·6241상태·521프레임 완주. root는 새 속도 계약과 실제 readback을 수용했다. 정착만 false이고, 그리퍼 동기·FK·렌더·완주·관절/속도 제한·바닥·중력 여유·큰 이동 범위는 통과했다. 최소 바닥 여유17.452mm, FK 최대 위치 차이7.569µm, TCP 경로 지름0.897552m다. 인증 작업반경이나 실물 성능 값이 아니다.

## 같은 전체 경로의 추종 비교

아래 RMS는 같은6241시점 전체의 각도 추종 오차다. 정착 PASS 판정 기준을 대체하지 않는다.

| 축 | 076 RMS(deg) | 077 RMS(deg) | RMS 감소 |
|---|---:|---:|---:|
| J1 | 3.833 | 2.424 | 36.8% |
| J2 | 2.778 | 2.586 | 6.9% |
| J3 | 1.581 | 1.113 | 29.6% |
| J4 | 1.446 | 0.661 | 54.3% |
| J5 | 1.107 | 0.745 | 32.7% |
| J6 | 2.811 | 0.237 | 91.6% |

모든 RMS가 감소했지만 지점별 악화도 있다. J2의 전체 최대 추종 오차는6.674→7.302deg, 왼쪽 회전 뒤 J1 정착 위치 오차는1.052→2.241deg로 증가했다. 높은 위치 왼쪽 회전 뒤에는 J1 정착 미통과도 추가됐다. 유리한 지표만으로 성공을 선언하지 않는다.

큰 이동 뒤6개 정착 지점 모두 아직 미통과다. 정착 지점 최대 팔 각도 오차는3.48677→2.51521deg, 최대 잔류 속도는5.48899→5.12838deg/s다. 원 기준0.5deg/1deg/s를 초과한다. 초기 정지 구간은 통과했다.

## 남은 문제와 후속 조사 후보

위치/속도 명령 불일치는 실제 readback까지 수리됐지만 정착 실패는 닫히지 않았다. 감쇠·관절 결합·구동 토크 제한의 기여는 현재 자료만으로 확정할 수 없다. 원 기록에는 실제 적용 구동 토크 채널이 없으므로, 중력 차감 후 cap 여유만으로 포화를 실측했다고 말하지 않는다.

후속 후보는 SDK의 실제 구동 토크·drive 상태를 계측해 제동 구간을 분석하고, 단위·유효 gain·관절 결합의 영향을 구분하는 것이다. 계측 계약과 독립 검증부터 설계한 뒤 원 기준으로 대조해야 한다. 현재 gain/cap/정착 시간 변경·가속도 FF·추가 native 재시험은 미실행이다. 정착을 속도 참조 수정만으로 해결할 수 있다고 확정한 전제는 철회한다.

비작성자 L4R2의 class 판정: 속도 참조/readback 계약은 CLOSED다. 그러나 동일52초·64/16 조건의 정착을 이 단일 수정만으로 닫는 가설은 EXHAUSTED다. 076의14개(phase,joint) 실패가 모두 남고 새1개가 생겨077은15개·합집합15개다. 이것은 별도 관측축이며 과거 provenance7/physical6/eligibility2 원장을 대체하지 않는다. 제어·RL·도메인 전체의 소진이 아니며, 같은 가설의 추가 발사는 하지 않고 새 계측 계획에서 미해결 전제를 재상정한다. 원 보고서에서 산출한 전건 목록과 판정은 class-disposition.json에 보존한다.

## 영상·보존

- 52.1초 원속도 영상 (비공개 링크 제외)
- 17.3초 3배속 영상 (비공개 링크 제외)
- 실제 RTX PNG로 만들었으며640×480/10fps·전체521프레임·요약173프레임과 전 구간 디코딩을 확인했다. FAIL 파일명을 유지했다. Drive 크기·MIME·부모를 재조회했고 원격 해시 비교를 했다고 주장하지 않는다. 별도 메타데이터 JSON은 로컬에만 보존했다.
- 원076 실패·원장·소진/임계 이력은 그대로 보존한다. 077 결과는 새 단위의 수용 범위일 뿐 과거 실패를 지우지 않는다.
- 정본은 outputs/isaac-trajectory-tracking-v1/result.json, tracking-comparison.json, remote-ledger-closeout.json, source-freeze-r1.json, 각 runs의 원 report/terminal/exit/validation 및 artifact-manifest다. 전체45분 준수 여부는 budget.json의 실제 마감 시각으로 남긴다.
