WINNAKEN/robot-arm-lab/docs/design/082-results.md

> 개발 이력: 작성 당시의 계획·결과입니다. 현재 상태는 [STATUS](../STATUS.md)를 확인하세요. 원시 로그와 로컬 경로 일부는 공개본에서 제외했습니다.

# 082 결과 — 관측부 구현·HOST 통과, 마지막 수리 검토 대기

이번 결과는 **로봇 정착 성공이나 PD 토크 실측 성공이 아니다.** 비영 COM 기준물의 전체 힘·모멘트 대조와 로봇 M/C/G 관측 경로를 구현했으나, 실제 Isaac 실행과 새 영상은 아직 없다.

- HOST: 최종 225개 PASS. 기존 191개와 새 힘·모멘트/동역학/저장 실패 대조 34개다.
- L2 R1: PASS 9/0. L4 R1: PASS 9/0. L4 R2: BLOCK 8/1 — 감쇠 설정 NaN/Inf가 최종 보고서 저장까지 막을 수 있는 경로.
- R2 지적을 수용해 양쪽 관측기의 `close()`에서 packet 전체를 검사하도록 수정했다. 비유한 원값은 `NONFINITE_RAW` 태그로 보존하고 관측 오류로 남긴다. journal과 partial 저장이 함께 실패해도 메모리에 부분자료와 오류가 남는 HOST 대조가 통과했다. **이 마지막 수정본의 비작성자 검토는 미실행이다.**
- 준비 import `3a2f32d118d44a31bc7260c8006b7ce6`은 전송·발사하지 않았다. 준비본은 R2 지적 전 소스이며, 최종 수정본으로 실행하면 안 된다. native import/정지/큰 동작 사용 횟수는 모두 0이다.
- 승인된 계획082의 검토 2회 한도와 새 발사 900초 여유 조건에 도달했다. 06:39:44 UTC 이후 발사하지 않았다. 실패를 성공으로 바꾸거나 원장·마감을 초기화하지 않았다.

구현한 대조는 다음과 같다. 가속도 모드 기준물을 Y축·COM 0.4m·관성 0.05kg·m²·초기 Rz45도로 두며 실제 readback으로 평행축 유효관성을 확인한다. 이 기준물만 중력을 끄고 로봇 중력은 유지한다. 실제 전후 속도와 자세에서 전체 6D 힘·모멘트를 재계산하고, 고정된 frame·pivot·부호·허용오차에 대조한다. 로봇은 매 12번째 원래 step에서 질량행렬 M과 C, 기존 G 증명과 속도 전후값을 수집한다.

`M*qdd+C+G` 및 그 값에서 FF를 뺀 잔차는 단계평균 유한차분 **추정값**이다. 구속·감쇠·외부 힘이 분리되지 않았으므로 로봇 PD 및 포화 여부는 여전히 UNKNOWN이다. 관측기 성공을 로봇 정착 수용으로 대신하지 않는다.

이전 081의 실제 결과는 그대로다. 2초 정지 PASS, 큰 동작 정착 FAIL, 최대 정착 오차 2.515213582도·5.128378810도/초, 실패 관절·구간 쌍 15개다. COM0 단일 관절 기준물의 PD-only 0.01N·m 확인은 로봇 PD 실측이 아니다. 이전 성공·실패·소진 이력을 변경하지 않았다.

정본 증거는 `outputs/isaac-force-balance-v1/review-lineage.json`, `source-freeze-final-pending.json`, `balance-host.json`, `result.json`이다. R1 원본과 R2 준비 source는 별도로 보존했다. 다음 실행 제안은 [083-force-balance-execution-proposal.md](083-force-balance-execution-proposal.md)이며 승인 대기다.

기존 제어 명령·게인·cap·0.5도/1도·초⁻¹/1초 정착 기준을 변경하지 않았다. 실물 보정·모터/CAN 운전·플래시·재부팅·설치·구매·학습은 모두 NOT_RUN이다. 새 영상·Drive 업로드도 NOT_RUN이다.
