WINNAKEN/robot-arm-lab/docs/design/099-results.md

> 개발 이력: 작성 당시의 계획·결과입니다. 현재 상태는 [STATUS](../STATUS.md)를 확인하세요. 원시 로그와 로컬 경로 일부는 공개본에서 제외했습니다.

# 099 — 시각 인증 수리 진행 기록

현재 상태: **ACTUAL_REMOTE_PROTOCOL_PASS_RELATIVE_CLOCK_OFFSET_BLOCK_NATIVE_NOT_RUN**. 사용자 `승인`으로검토된099를1회실행했다. 최종L4R2 PASS9/0·작성자/독립HOST581은유지되며시작지연분리와raw회수는실원격에서도동작했다. 실제상대시계차이+3.410628~+3.429315초가원±1초를벗어나SDK/SimulationApp전중단했다. SSH OSquery1·native목적0·물리/CAN0이다. 098·099의단일2700초예약은각실패종결그대로보존하며재활성화하지않는다. 아래로컬완료/승인대기절은실행전이력이다.

098의관측: 원SSH OSquery 종료0/유효JSON,span9.344초·offset가능구간[-.380145,+8.966639]초가±1초를넘어prepare전중단했다. 실제9초시계offset이나성분별지연원인은UNKNOWN이다. 099는같은연결의READY후challenge→SAMPLE구간을측정하도록수리하며±1초/.25초/age120/+2입장상한과게인64/16·cap·물리기준은유지한다.

L1로컬가능성: actual Windows PowerShell→local Python(-I -S -B) stdin 전달/sitefalse PASS. 비작성자독립실험에서도cold9.344초를넣고READY11.203초,전체13.266초,표본후exit2.063초를관측했다. 표본offset구간[-.003005,+.003956]초·sitefalse이며,monotonic해상도의경과0은실제통신시간0을뜻하지않는다. 이는로컬OS가능성이지SSH/Isaac검증이아니다.

L2R1 **BLOCK6/3**: F1전체20초에cleanup잔여미결속/F2전부publication실패시query소비미예약/F3production변경census·분할gate미확정. 세건모두수용했다. 원계획/판정은review/r1-preserved,반례는review/independent-r1에보존했다. R2계획은고정D=min(m0+20,globalMonoEnd),C=D-2공유cleanup·Popen전xb/flush/fsync소비·A5/B9/C4닫힌production단위를명시했다. 아직구현폐쇄나최종PASS가아니다.

099전체L2최대2/L4최대2를단위별초기화하지않는다. F1시간계산class는097L2R1F2와합집합2번째,비작성자가박제한다음별개동종누락3번째충분임계와더이른반복·재귀판정권을유지한다. 098의L2/L4각2/2·L4union4폐쇄·모든과거실패/임계와정착15·velocity-onlyEXHAUSTED·PD/포화UNKNOWN·moving-root독립교정NOT_DONE·물성가정/링보류·자기충돌OFF/바닥ON을보존한다.

동일계열비작성자fallback은기존사용자승인을따르며공통전제편향이남는다. bridge수리/새설치/실물급전/flash/모터/보정/학습/외부업로드는없다. 이후구현·HOST·최종검토결과는데이터절로덧붙인다.

## 최종 계획과 구현 게이트

최종 L2 R2는 **PASS9/0**, 계획SHA77d9149f5b360c823d303aa09312bc673b480c387526f2379438b1449261c831이다. 원F1/F2/F3계획논리를닫고고유mutable18파일의A5/B9/C5(공유HOST1)분할을수용했다. 진행중R2의analysis10개누락은F3미폐쇄분으로수용하고중간계획/반례를보존했다. 비작성자절차판정에따라verdict전작성자1회semantic갱신·같은cap/round재핀으로C공유HOST수정후A+B전회귀를명시했다. 새round/reset은없다. L2 2/2종결·L4 0/2다.

재부팅 후 실제 저장 상태를조회했다. 099 scaffold와최종L2판정은보존됐고,중단됐던큰driver패치는적용되지않아원복사driver60518B상태였다. 원격예산/SDK/native는없었다. 저장상태확인뒤A패치를적용했다. 재부팅전monotonic이나098예산을재사용하지않는다.

A시각채널은 **HOST208/compile5 통과**했다. 같은SSH명령을가로채실제localPython또는WindowsPS+localPython으로치환한시험이며SDK/원격SSH는없다. 원098실패span은원±1초식에서계속거절한다. cold9.344초·sample후exit2초를표본span과분리하고총lifecycle에는포함했다. 실제PS경로도별도통과했다. 느린sample/nonce/siteflag/Kit/비유한값·EOF/추가stdout·byte/line한도·Popen/partialwrite/flush/reader/reap관측실패·global짧은기한·원로그전부기록실패·예약fsync실패·재호출0을검사했다.

처음의actualPS+cold9.344+exit2시험은READY처리전통신기한도달로거절됐다. 원raw/실패/소유자식reap/cleanupCONFIRMED를first-local-cold-timeout.json및원case에보존했다. 첫draft에는readerpacket시각진단이없어지연성분을단정하지않는다. packet완료시각을항상보존하도록보완했고,cold구간경계는directlocalPython,WindowsPS통로는별도case로재현했다. 생산20/18/2기한을늘리지않았으며이로컬실패를성공으로덮지않았다.

B게이트는 **HOST297/compile22/PSparse 통과**했다. recovery89/scene29/activation84/timing64/entry8/repairs23이다. 원53활성화사례에새native승인누락·false·다른scope/freeze/review·기한/목적변조·실제coordinator pre-network거절등31건을추가했다. actualprepare45input/bundle46과canonical52full검증을유지했다. 098source13은byte동일,driver의시각함수/추가stdlib와고유namespace/plan결속외AST는동일하다. repair승인false는동결하며미래별도native-approval의SHA까지runtime-budget에묶는다.

C는B통과뒤네사후도구를namespace-only로복사하고공유host_clock.py에원분석10개소유호출을추가했다. 원098분석스크립트SHA를검증하고source경로만099로결속해신규summarize를검사하며원098출력은대조해보존한다. 이변경뒤전체A/B/C재검증과보호5995SHA의최종통합게이트가현재진행중이다. 아직515합계통과나L4PASS를선언하지않는다.

최종 작성자 통합 게이트는 **HOST515(89/29/84/64/8/23/10/208)·compile26·PSparse·보호5995 PASS**다. source18/harness13,불변098source13 및비시각driver AST를대조했고C의공유HOST변경뒤A/B/C모두재생했다. source-freeze-r1.json SHA325ca762c327feebf5f5c37da60ee27920f0b169577cd07de6648f9109f91d43에묶어12:13:33KST에L4R1을요청했다. L4최대2중첫호출이며아직최종코드검토PASS가아니다. frozen source/harness/plan은판정전수정하지않는다.

원localfixture558파일은로컬ZIP155900549B(SHA9dbb3a735e8a9f285167e6c68dda3a6dfafc2b9ff5781fa39219d39954bc1d93)와전member hash receipt로보존했다. raw파생repair-fixtures와ZIP은Gitpayload에서제외하며원트리는삭제하지않는다. 시각HOST rawcase/원오류기록은별도보존한다.

## L4 R1 지적과 한정 수리

L4 R1은 **BLOCK8/1**이다. 비작성자는동일515를독립완주했고앞7보고서는작성자와byte동일,비결정적clock208은이름/결과동일이었다. source18/harness13·compile26/PSparse/보호5995/후보48SHA도확인했다. 그러나실제localPython이pipe각28B를쓰고종료0했어도Popen이C뒤/D앞에반환되면reader전guard가닫아raw각0B가되는것을재현했다. Thread.start실패도같은원인으로묶었다. R1후보48/freeze/515와원stdout·stderr/판정은모두보존했다.

비작성자는FAILED_OS_CLOCK_QUERY_EVIDENCE_DROPPED를원098F3와합집합2인스턴스로분류하고다음별개동종합집합3번째를해당raw캡처/검증접근법소진의충분조건으로사전박제했다. 현재재발은coldstart재설계의새표면이며원098F3수리자체가생성했다는직접대응은없다고판정했다. 시간계산class의3번째가아니며소비marker는계속차단됐다. 과거소진/임계는유지한다.

허용된L3-A수리는캡처초기화/오류증거경계에한정했다. 새clock_capture_available은reader가없거나끝난소유pipe만Win32 PeekNamedPipe로가용량을확인하고같은D/기존byte한도에서nonblocking raw복사한뒤닫는다. 동시reader와경쟁하지않고정상SAMPLEreceive시각을만들지않는다. read직후prefix를시각/parse보다먼저보존한다. pipe/기한/회수API등으로확인불능이면capture상태와cleanup을UNKNOWN으로남기고최초오류와소비marker를보존한다. 새로운상대기한·물리기준·권한변경은없다. 새stdlib는clockhelper안의msvcrt/ctypes Win32사용이며driver비시각AST예외는해당clockhelper하나뿐이다.

작성자A수리 **HOST274 통과**: 원208의미를유지하고known28B·원R1mutant를더했다. 늦은Popen·첫째/둘째reader시작실패·1byte읽은뒤reader실패에서stdout/stderr각28B(CRLF포함)를정확히보존했다. 마지막은기존1byte+fallback27byteappend도검사했다. 전역기한소진/Peek오류는UNKNOWN으로남고원deadline오류가부차오류로바뀌지않았다. 원R1source를같은경계에서다시실행하면raw소실이재현돼무효양성이아니다. 원후보48SHA를다시확인했다. A→B297→C10및전체A/B/C/compile/PSparse/5995를다시묶은뒤마지막L4R2로제출한다. 현재L2 2/2종결·L4 1/2이며추가L2/R3/원격실행은없다.

한정수리후B297/compile26/PSparse/불변13/nonclockAST를다시통과했고,C를포함한최종게이트도 **HOST581(89/29/84/64/8/23/10/274)·compile26·PSparse·보호5995 PASS**다. source18/harness13, 고유mutable18은유지했다. 원R1후보48/freeze/515/판정SHA2cff9bf8e9e2b4f60363f1ff707d9fac89afd0e0e397c64bdad550843af52131를다시대조했다.

새source-freeze-r2.json SHA **01d1af00b0b4d0a41ca245817068a4915339c369dbc30614ff9962f011a7f318**에결속하고12:40:15KST부터마지막L4R2(45분cap)를요청했다. review-submission-r2.json은oldR1/newR2 chain과source/harness일치및native승인·budget없음을기록한다. 이후source/harness/plan은동결이며남은변경은검토/결과/인계데이터뿐이다. 사후추가R3나새물리수용을선언하지않는다.

## 최종 수용 범위와 재개 입력

마지막 비작성자 L4 R2는 **PASS9/0**이며SHA14e1123be2da084572f45f4a551ac6103ef6d70d2f73b9e2f728be7b6112f557이다. 독립581을완주해7개결정적HOST보고서는작성자와byte동일,clock274는이름/결과동일이었다. 별도실Windows pipe6경계에서known28B·원R1대조·UNKNOWN/원오류/marker를확인해R1지적을폐쇄했다. source18/harness13·불변13·비시각AST·compile26/PSparse·5995SHA·원후보48/원로그18/판정도확인했다. L2/L4각2/2종결·추가R3·사후독립runtime슬롯0이다. raw합집합2/다음별개3번째충분임계와시간계산합집합2/다음3번째임계는유지한다. 최종미소진판정은현재clock소스범위에한하며과거물리/제어소진을되돌리지않는다.

최종PASS후작성자postreview로actual activator/coordinator를실제ROOT에서native승인없이호출하는로컬음성검사를했다. subprocess/네트워크를추가로금지한상태에서둘다native-approval.json부재로예산생성전에거절했다. source18/harness13·deadline int0·승인false가그대로이고runtime-budget/READY/실행freeze/새native영수증은없다. production-inactive-check.json은이작성자음성검사이며새독립L4나native실행이아니다.

실제원격성능,새import·정지수용·42초물리진단·회수성능·새영상은모두 **NOT_RUN**이다. 다음실행은사용자의**새09945분명시승인**후에만가능하다. 동결repair승인false는편집하지않고별도native-approval.json을닫힌scope/2700초/각목적1/원user_quote/실측freeze·PASSreview SHA로결속한다. 검토된execute.py --review-round 2가확인한뒤deadline숫자한토큰과단일budget을예약하고첫원격명령부터2700초를소비한다. import1→정지1수용후motion42초1,재시도0·늦거나실패하면다음목적NOT_RUN이다. native승인은게인/cap·물리기준·모델/후보변경이나실물CAN권한이아니다.

진행중별도MP10/J5 CAD작업의소유범위밖변경이관측됐고그대로보존한다. 해당경로는099보호5995목록밖이며이번검토는기존URDFv3/가정물성/고정된입력기준이다. 새CAD반영·물성확정·실물수용을주장하지않는다. 결과/인계와소유099만로컬커밋하며push하지않는다.

## 사용자 승인 후 실제 원격 결과

사용자 `승인`은직전질문인첫원격부터새45분/import→정지→통과시42초를수용했다. 원repair승인false를편집하지않고별도native-approval.json을실측freeze·PASSreview SHA에결속했다. source/harness/plan을대조하고`execute.py --review-round 2`를1회실행했다. 새45분은 **2026-11-01 13:18:29.711328~14:03:29.711328 KST**이며기존templateconfig의deadline숫자한토큰만바뀌었다. native-approval와실행freeze/budget/READY의결속은작성자실행후로컬감사(check_time=False)도통과했다.

[관측] 첫SSH OSquery는종료0,READY/nonce/challenge/SAMPLE/sitefalse·Kit0·양EOF/cleanup/capture CONFIRMED로끝났다. 시작→READY **9.890초**,전체channel **10.094초**를전역예산에소비하면서표본왕복은wall **0.014687538초**,mono **0.016초**로분리했다. 원로그누락도없었고truncated/pipe/cleanup오류0이다. 따라서099의시작비용분리/실패증거수리는실원격에서도관측됐다.

그러나SAMPLE remoteUTC-localUTC가능구간은원식/양자화여유포함 **[+3.410627696990967,+3.4293152351379392]초**였다. 작은왕복안에서원격시계가로컬보다약3.42초앞선것을확인했다. 실제UTC에어느PC가맞는지와offset발생원인은아직미확정이다. 이차이는시작9.890초가표본에섞인오류가아니며,원±1초clockguard가정상거절했다. coordinator는원ValueError를보존하고종료1/COORDINATOR_FAILED로끝났다. 재조회·재시도·예산reset은하지않는다.

prepare/upload/supervisor/목적예약전중단해import0/정지0/motion0·SDK API0/SimulationApp0/step0/새PNG0/CAN0이다. standalonebundledPython(-I-S-B)의OS/stdlib조회는SDK API실행이아니다. 새runs/session-clock인증서/native terminal은생성되지않았다. 새원격worker/PID/lock생성경로에미도달해추가remotecloseout도보내지않았다. 당시Kit0을이후PC전체상태확인으로확대하지않는다. 원봉인native감사/hold분석/새영상/원격export성능은모두NOT_RUN이다.

로컬읽기진단에서W32Time은 **Stopped/Manual**,Type=NTP/NtpClientEnabled1/NtpServer time.windows.com,0x9/SpecialPollInterval16384였다. status조회는서비스미실행0x80070426이었다. 최초sandbox의접근거절/서비스미표시는실제서비스부재로해석하지않고,허용된읽기전용unsandbox조회로상태를확인했다. 서비스중지는원인후보이며UTC오류의유일원인으로단정하지않는다. 원격시간서비스는실패후새SSH금지를지켜미조회다. 서비스시작/동기화/PC시간/설정변경은0이다.

runtime-diagnosis.json과원raw/시각/budget/실패를보존했다. 실행전result/index/결과·공유인계바이트도before/에보존했다. 다음은 **100-pc-clock-alignment.md의시간서비스시작·기존provider resync 제안**이며아직미승인·미실행이다. 현재099예산과마지막L4는종결이다. 동기화후에도old099재발사는하지않고새실행준비/검토·승인을거친다. 게인64/16·cap·원물리기준/모델/후보·과거실패/소진은유지한다.
