WINNAKEN/robot-arm-lab/docs/design/100-results.md

> 개발 이력: 작성 당시의 계획·결과입니다. 현재 상태는 [STATUS](../STATUS.md)를 확인하세요. 원시 로그와 로컬 경로 일부는 공개본에서 제외했습니다.

# 100 결과 — 관리자 승인 취소 / 시간 정렬 미완료

2026-11-01. 사용자의 `작업계속이어가'`를 직전100의 두PC 시간 정렬 승인으로 받아, OS 한정 최대600초 작업을 시작했다. 실물 CAN과 시뮬레이터는 범위에 포함하지 않았다.

## 관측과 실제 실행

로컬·기존 SSH 별칭 isaacpc의 읽기 조회는 각각 transport 종료0이었다. 두PC 모두 W32Time **Stopped / Manual**, Type=NTP, NtpClientEnabled=1, 기존 peer `time.windows.com,0x9`를 확인했다. 로컬 토큰은 비관리자, 원격 토큰은 관리자였다. status/verbose와configuration의 native 명령은 양쪽 모두 **0x80070426(서비스 미실행)** 으로 실패했다. 이는 서비스가 없거나 NTP 동기화에 성공했다는 뜻이 아니다. 각 native 출력은 바이트 원본으로 보존했다.

로컬에서 승인된 Start-Service/resync에만 한정한 관리자 승인창을1회 요청했다. Windows Start-Process는 **“사용자가 작업을 취소했습니다”** 라는 오류로 종료1을 반환했다. 이 메시지는 Windows의 반환 기록이며 사용자가 의도적으로 취소했는지까지 판단하지 않는다. 요청부터 반환까지124.953초였고 당시 원기한은37.015초 남았다. helper 실행 전 실패했으며 배타 action marker와action result도 생성되지 않았다. 따라서 로컬 서비스 시작/resync 각0, 원격 변경 각0이다. 추가 UAC나resync는 요청하지 않았다.

600초 기한은 처음 monotonic27877.796에서28477.796으로 한 번만 고정했다. 이후 만료를 확인하고 OS·SSH 명령을 더 발행하지 않았다. 후속 작업은 저장된 로컬 증거 분석·문서화·Git 보존뿐이다. UAC 취소가 최초 중단 원인이고 기한 만료는 재개 금지 경계다. 원기한을 새로 잡거나 시간 정렬 성공으로 바꾸지 않는다. 첫 inline Python 초안은 실행 전 문법 오류였으며, 수정과 승인 대기 모두 같은 원기한에 포함했다.

## 수용 상태와 한계

시간 정렬 **미완료**. 작업 후 서비스 상태와 새 상대 시계차이는 **미관측/UNKNOWN**이며 초기 Stopped 관측을 현재 상태로 승격하지 않는다. 099의 약+3.42초 상대오차는 당시 값으로 보존하고 새 측정값으로 재사용하지 않는다. 어느PC가 실제UTC에 맞는지와 서비스 중지가 유일 원인인지는 여전히UNKNOWN이다.

SDK API / SimulationApp / native / physics step / 새PNG / 실물CAN **모두0**. 정지 수용과42초 진단은NOT_RUN이다. 게인64/16·cap·모델·물리기준·097후보, 098/099 실패·예산·marker·검토종결/소진 계보를 바꾸지 않았다. 제품 소스 변경과 새L2/L4·독립 관측·물리PASS 주장은 없다. 별도MP10/J5 CAD 변경은 보존하고 stage하지 않는다.

## 다음 재개

서비스 시작·기존peer resync라는 작업 범위는 이미 승인됐다. 이번100의600초는 종결됐으므로 재사용/자동재시도하지 않는다. 다음 한정 시도는 로컬 Windows 관리자 승인에 응답할 수 있는 상태에서 새 기한을 명시한 뒤 진행해야 한다. 보안정책이나NTP설정 변경으로 우회하지 않는다. 기존 계획의 각PC resync1회·실패시중단 조건을 유지한다.

시간 정렬 뒤에도099를 재발사하지 않는다. 새 실행namespace와 비활성metadata를 준비하고 필요한 비작성자 검토 및 새45분 명시승인을 완료한 뒤, 첫 원격시뮬 명령부터 새2700초를 사용한다. 원±1초/.25초 조건과 import→정지 수용→42초 순서를 유지한다. CAN은 계속 제외한다.

정본 증거: `outputs/pc-clock-alignment-100/result.json`, `operation-budget.json`, `approval.json`, 양PC `*-before.json`/raw, `local-elevation-*.raw`, `local-elevation-exit.json`. 승인 원계획은`before/approved-plan.md`에 보존했다. 무결성 확인은 작성자의 저장증거 대조이며 독립 관측/검토로 세지 않는다. Notion 규칙은 읽었고 이번 요청에 외부 게시 권한이 없어 로컬에만 남겼다.
