WINNAKEN/robot-arm-lab/docs/design/103-results.md

> 개발 이력: 작성 당시의 계획·결과입니다. 현재 상태는 [STATUS](../STATUS.md)를 확인하세요. 원시 로그와 로컬 경로 일부는 공개본에서 제외했습니다.

# 103 — 준비 실행기 최종 BLOCK / 실제 네트워크 변경0

2026-11-01. 사용자에게서Wi-Fi nt_rtf64 한개A/B/A 및원인입증시조건부off수리를승인받았다. 이승인은같은네트워크영향범위에유효하며10분반복중단조건은사용자가철회했다.

계획L2R1두결함을수리해R2PASS/2of2종결. 구현L4R1은복원발행을막는진단I/O,취소된C수용receipt잔존,staleheartbeat미소비,누락된creationstamp의PID-only통과4건을BLOCK했다. 원source/동결/실패를보존하고수리후작성자/독립23HOST·기존정확반례4건은통과했다. 그러나최종L4R2는progress.json을읽지못하는분기에서continue하여UNKNOWN/복원요청을남기지않는반례를확정해BLOCK했다.

L2/L4각2of2종결·R3/103추가수리/103발사없음. execution폴더없음·실제binding변경0·SDK/native/CAN0. monitoring class합집합2/다음별개3충분임계와restoration-I/O class합집합2/다음별개3임계를유지한다. 비작성자는관측실패가파일progress를소비하는이소스의결함이며일반A/B/A/C도메인소진은입증되지않았다고구분했다. 옛099각2/2종결과raw/time계보·임계도보존한다.

다음104는외부파일watchdog를완전히제거하는신선재설계다. 단일독립로컬actuator가자기monotonic·controller생성ID를직접확인하며,controller는native프로세스handle로완료/미완료를관측한다. 기존103중검증된순수trial/terminal순서/단일target backend의도달부분을정확SHA로재사용하되,103의gate/actor/execute/watchdog진입점은호출하지않는다. 새로운전체배선은다시검토하며103BLOCK/예산/원결함을초기화하지않는다. 승인된target·원복·조건부수리범위는유지하고방화벽/Tailscale/다른binding/CAN은변경하지않는다.

정본outputs/ntp-filter-ab-103/result.json·review/L4-r2.json·independent-l4-r2원재현·source-freeze-L4-r2.json. 기존계획/승인사본/각원실패는보존한다. 동일계열비작성자fallback의공통편향과HOST/실OS수용차이를유지한다.
