WINNAKEN/robot-arm-lab/docs/design/105-results.md

> 개발 이력: 작성 당시의 계획·결과입니다. 현재 상태는 [STATUS](../STATUS.md)를 확인하세요. 원시 로그와 로컬 경로 일부는 공개본에서 제외했습니다.

# 105 — NTP 대기와 병행한 시뮬레이션 자료 분석·실행 준비 점검

2026-11-02. 사용자 병렬 진행 지시로 저장된 실제 운동 기록 분석과 실행기 의존성 점검을 동시에 수행했다. **로컬 분석·사전점검 및 비작성자 자료감사 PASS5/0 / 실제native NOT_RUN**이다. 새 원격 실행·45분 예산·SDK·물리 표본·실물 CAN은 없다. 게인64/16·cap·모델·판정 기준·097의42초 후보를 변경하지 않았다.

## 새로 확인한 운동 패턴

**[관측]** 기존095 기록에서 J3의 실제 속도는32.441667~32.450000초, J5는32.416667~32.425000초에 음수에서 양수로 반전했다. 모두33초 hold 전의 접근 동작 중이다. 32.5초의 목표속도/실제속도는 다음과 같다.

| 관절 | 목표속도와 실제 명령 읽기값 | 실제 관절 속도 |
|---|---:|---:|
| J3 | -0.579357°/s | +0.212542°/s |
| J5 | -0.450611°/s | +0.238837°/s |

**[추론]** 33초 hold 전환 뒤에 처음 발생한 방향 반전으로 설명할 수는 없다. 다음42초 고정목표 진단은 이 접근 이력을 이어받은 잔류 운동을 관측한다. **[미지]** 앞선 추종 오차의 유일 원인이나 실제 PD토크·포화는 아직 구분되지 않았다. 이 단서만으로 게인이나 cap을 조정하지 않는다.

**[관측]** 33~34초 전체9축이 각 종류의 원위치·속도 조건을 동시에 만족한 표본은0/121개다. 다른 hold들과의 차이는 전체 자세·접근 이력이 달라 통제된 인과 대조가 아니다. endpoint 실패축 목록은 원봉인7개와 모두 같았다. 원34초 J3/J5 실패와 전체 consumer BLOCK을 보존한다. 표본 지속성은 별도 진단이며 연속시간 안정성이나 새 합격 기준이 아니다. 현재 checkpoint/consumer는 endpoint 조건을 검사하고, program의 `window_s=0.5`는 그 함수에서 소비하지 않는다. 이를 지속0.5초 수용을 입증한 것으로 표현하지 않는다.

원journal의1부터 센 줄번호는 J3반전3894~3895, J5반전3891~3892,32.5초 비교3901이다. 원rad값·변환·전체입력 SHA·기존096 재확인과 추가 관측·다음42초 해석표는 [분석 보고서](../../outputs/sim-parallel-105/analysis/hold-diagnostic-interpretation.md)와 [재현 JSON](../../outputs/sim-parallel-105/analysis/hold-diagnostic-interpretation.json)에 있다. 새42초 endpoint가 나중에 통과해도 원34초 실패를 지우거나52초 전체 경로의 수리로 표현하지 않는다.

## NTP와 물리 계산의 의존성

**[관측]** 현재 실행기의 첫 원격 단계는 `execute.py:46`의 clock probe이며, 이전099는 `driver.py:426 → clock_bounds:191`의 ±1초 인증에서 prepare 전에 거절됐다. 공인 NTP 질의는 physics producer의 직접 경로에 없고, scene의 물리 step은 엔진 시각·step/120을 검증한다. **[추론]** 현재 NTP 복구를 기다리게 하는 것은 실행기의 양PC wall-clock 인증·절대예산 계약이다. 이 구분을 기존 시간 gate 우회나 옛099 재발사 권한으로 쓰지 않는다.

**[관측]** 현재099의 소비 marker가 모두 남아 있다. **[추론]** 기존 로컬 핀 검증이 통과한다는 전제에서 다시 호출하면 `activate-budget.py:141`의 소비 검사부터 거절된다. 이 예측을 확인하기 위한 실행은 하지 않았다. native가 실행되지 않았더라도 옛45분을 재사용할 수 없다.

읽기 대조로 source의 config 제외17개·harness13개·ref11개·모델16개와 기존핀 일치, program의097 바이트 일치, 원 inactive config와 현재 승인된 deadline 한 토큰 변경/실행freeze 일치를 확인했다. 옛config를0으로 원복하거나 덮어쓰지 않았다. 상세 경로·SHA·최초gate·구현 전 재결속 후보는 [준비 점검](../../outputs/sim-parallel-105/readiness/report.md)과 [JSON](../../outputs/sim-parallel-105/readiness/readiness.json)에 있다.

## 병렬로 완료된 범위와 남은 작업

| 작업 | 현재 상태 |
|---|---|
| 기존 운동 기록의 추가 분석·42초 해석표 | 완료, 새 물리 표본 아님 |
| 현재 후보·source/참조 핀·소비 gate 확인 | 로컬 사전점검 완료 |
| 새 실행 namespace/소스 재결속 구현·검토 | 미착수, 현재 native-ready 아님 |
| NTP 상세 WFP·QoS 조회 | 104의 Windows 관리자 응답 대기 유지 |
| 새 import→정지 수용→42초 실행 | NOT_RUN, 해당 단위 준비·검토·명시 새45분 필요 |

새 namespace의 정적 재결속 후보는 source5+harness12=17파일이다. 이는 구현 전 후보 수량이며 기존099 mutable18·class계보·검토상한을 초기화하는 수치가 아니다. source18/harness13 전체의 복사·경로/plan·승인/freeze/PASS 결속을 갖춘 새 단위가 필요하다. 실제 첫 원격부터2700초·headroom1380/1680·watchdog600/900·회수300/600을 유지하며 세 단계 완주를 보장하지 않는다.

wall-clock 정렬 대신 monotonic anchor와 보수적인 왕복 지연·remaining budget을 결속하는 구조는 **미검토 설계 대안**으로만 남겼다. 아직 새 구현·HOST·권한 검토가 없으며 이번에 시간 인증을 삭제하거나 완화하지 않았다.

자료 감사는 별도 비작성자가 원journal을 PowerShell/.NET으로 직접 읽어 신규 수치와 코드 위치·범위를 확인한다. 최대2회이며 같은계열 잔여편향이 남는다. 이는 기존099/103/104의 추가L4나 실제 물리 재현이 아니다. 원소스·실패/예약·검토/예산·원물성/링보류와 타작업자 MP10/J5 변경을 보존한다. 최종 결과/감사/한정 무결성 영수증은 `outputs/sim-parallel-105/`에 저장하고 공유 인계 원문을 보존한다.

## 최종 자료감사

R1 **PASS5/0**, 신규 지적·미해결0, 추가 회차 불필요다. 사용1/2이며 기존099/103/104의 검토/실패/소진 계보는 바꾸지 않았다. [판정 JSON](../../outputs/sim-parallel-105/review/audit-r1.json) SHA는 `6b37ded519982e36d5f83d7b1467cffd666610018a1f29324d099ff12b777952`다.

비작성자는 작성자의 Python 분석기를 재실행하지 않고 PowerShell/.NET으로6241줄 중1088개 원객체를 직접 파싱했다. 반전 bracket·32.5초 부호/수치·속도정점/차분·전체9축0/121·7개 원endpoint와9개 선택 report/journal 객체 일치를 확인했다. source/ref/model 핀·옛config의 원deadline 한 토큰 변경·097program·74개 명시 목록의 현재 SHA도 일치했다. window_s 미소비 관측은 지속0.5초 요구의 면제나 기존 안전성 수용으로 쓰지 않았다.

같은계열 잔여편향·실제 새물리 미검증은 남는다. 검토 직전10개 입력의 정확한 원문은 `reviewed-inputs-r1/`와 영수증에 보존했다. 검토 후 변경은 본 문서의 결과상태·감사기록, result.json의 상태/판정 메타데이터와 인계·무결성 영수증에 한정한다. 원자료·생산코드·후보·시간 gate·승인/예산은 바꾸지 않는다.
