WINNAKEN/robot-arm-lab/docs/design/112-results.md

> 개발 이력: 작성 당시의 계획·결과입니다. 현재 상태는 [STATUS](../STATUS.md)를 확인하세요. 원시 로그와 로컬 경로 일부는 공개본에서 제외했습니다.

# 112 결과 — 정적 검산 재사용 구현 / 최종 BLOCK·숫자 경계 source 소진

2026-11-05 KST. **최종 L4 R2는 주·보조 모두 BLOCK9/3이다.**
JSON 숫자 결함은 닫혔지만 필수 URDF 관성의 비유한 값 수용이 별도로 재현됐다.
현재 D 숫자 검증·지원 시험 source는 사전 충분 임계에 따라 소진 판정이며
도메인 불가능 판정은 아니다. 조건부 원격45분·import·정지·42초 motion은 모두
시작하지 않았다. 실물 CAN·급전·flash·모터·설치·UAC·시계·네트워크 설정 변경0이다.

정본은 [result.json](../../outputs/static-workspace-preflight-112/result.json),
[주 최종 검토](../../outputs/static-workspace-preflight-112/review/L4-r2.json),
[보조 최종 검토](../../outputs/static-workspace-preflight-112/review/lens-L4-r2/report.json)이다.

## 구현·HOST와 독립 검토

L2는 마지막 R2 PASS12/0으로 닫혔다. B2/C4/D2의8개 운영 소스에서
정적 전건 검산을 첫 원격 전에 수행하고, 정확히 같은 입력에 대한 receipt를
현재 소유권·파일·권위를 매 사용 재확인한 뒤 재사용하도록 구현했다.
원 full sampling8192/path6241·원45 물리 함수 AST·게인64/16·cap·모델/program·
물리/시간 gate를 유지했다. runtime20/key47/dependency47/capsule61의 집합은
서로 구분한다. receipt는 native 권한이 아니다.

| 단계 | 실제 결과 |
|---|---|
| 작성자 수리 후 root 전체 HOST | B26/C40/D21=87 PASS, 원 raw·종료코드 보존 |
| root 실제 B→D 전건 producer |16.969초, 정상 receipt b9d81443...|
| 보조 정상 full/consumer 단회 |15.094초/0.922초, warm 로컬 관측이며 원격 시간 보장 아님|
| 주 최종 L4 R2 |BLOCK9/3,2024.542/2700초|
| 보조 최종 L4 R2 |BLOCK9/3,1699.036/2700초|
| actual root `--run --review-round 2` |CLI2, `typed complete112 L4` 거절, 원격 시작 전|
| native import/정지/motion |전부 NOT_RUN, 새45분 사용0·attempt0|

주 JSON SHA는 `5409b22e61a80440c2f55e3e4a63bb6a39c9b4ee8e397b3c8b9af99c66c4cadf`,
보조는 `478a748824071303ad3b3871cb0ece3f07f7de9b65f25dd96555b449fcab4310`다.
B4/0·C4/0·D0/2·통합1/1이며 D1/D2/I1이 미충족이다. L2/L4는 각각2/2,
noR3다. 기존 승인된 same-family 비작성자 폴백과 공통편향을 명시했다.

## 닫힌 결함과 남은 결함

- **112-MAJOR-01 / reuse 수명:** actual HOST CODE 폐쇄, union1/open0.
  실제 C→B→D의 같은 D 모듈 두 번째 호출·원 token/thread/end·현재 ref/budget
  변경·재읽기 생략 대조를 독립 관측했다. 다음 distinct union2 충분 source 소진
  임계를 그대로 보존한다.
- **112-MAJOR-02 / JSON 숫자:** 원 gravity bool/config overflow·width bool의
  3개 변형은 같은 instance1이며 수리 폐쇄됐다. 보조는 원3+확장 변형45개를
  actual producer/정합 재결속 consumer 양쪽90회에서 숫자 guard로 거절했다.
  논리값·동적 컬렉션 정상 대조도 통과했다. HOST 수87에 이 관측 횟수를 더하지 않는다.
- **112-MAJOR-03 / ET 숫자:** 필수 URDF `inertia ixx="inf"`를 넣고 영향을 받는
  URDF/workspace/submission/config4파일의 SHA·길이를 정합하게 재결속하면
  원 pinned ET oracle가 Base inertia에 inf/nan을 만든 상태로 actual full
  producer와 consumer가 수용했다. 주·보조는 독립 재구성해 같은 receipt
  `37e22b12e205d01a5fb7fc9911b3ffbd055f14d31dba07fa1d961436b5669bb0`를 얻었다.
  같은 유한 값의 다른 표기는 정상 대조로 통과했다. 현재 원 정상 receipt pin을
  바꾸지 않은 대조에서는 입력 불일치로 거절됐다.

03은 새 class가 아니라 `PREFLIGHT_DECISION_NUMERIC_SCHEMA_NOT_ENFORCED`의
distinct instance2다. JSON instance는 closed, ET instance는 open이므로
연속 union2/open1이다. R1에 사전 박제한 next DISTINCT2 충분 임계를 적용해
비작성자가 현재 D 숫자 검증·지원 테스트 source를 **SOURCE_EXHAUSTED**로
판정했다. 수리 전 ET 반례는 직접 실행하지 않았으므로 수리가 이를 생성했다는
인과관계는 UNMEASURED이며 주장하지 않는다. 현재 정상 source/입력의 native
권위 우회·기존 물리 gate 완화·quasistatic 수학 오류도 주장하지 않는다.

## 예산·자료와 관측 오류

최종 작성·HOST·root 귀속 검증 누적은 B778.421/C1406.578/D1019.547초,
각 cap1500 안이다. 남은 시간이 있어도 현재 숫자 source 소진·noR3를
해제하지 않는다. 원 R1 전체 coordination envelope와 실제 작업 누적은 별도로
보존했으며 L4 대기를 새 작성 시계로 재설정하지 않았다.

원 source108/109/110/111의51개와 현재 CAD22, immutable46, 검토된 source8·
dependency47가 모두 같은 SHA/길이를 유지한다. 수리 전 source8/receipt/freeze/
검토/raw는 before-L4-r2에 보존했고 명시 로컬 revision-generation으로 새 receipt를
배타 생성했다. consumer 자동 재생성·fallback은 없다. 과거 실패·닫힌 회차·
source 소진·다음 임계·정착15/velocity-only 소진·PD/포화 UNKNOWN·moving-root
독립 교정 NOT_DONE·물성 가정/링 보류를 유지한다. 이전111의 실제 import/정지
성공을112의 native 수용으로 옮기지 않는다.

**AUDIT-112-R2-01은 root 관측 메타데이터 오류다.** freeze 생성기의 이전 객체
복사 때문에 fr2 top-level HOST_tests83/receipt7668.../R1 UTC가 남았다.
실제 source8/dependency47와 sole receipt b9d8...는 맞고 B는 그 dependency를
기대 SHA로 사용한다. 검토한 fr2 SHA
`c44d96dbca58b2a84ee275491c3d008c67d94d62c409fc94e5856e3b513209c5`를
바꾸지 않고 [별도 정정](../../outputs/static-workspace-preflight-112/source-freeze-r2-summary-errata.json)에
HOST87/실제 receipt를 대조했다. R2 freeze 사건 시각은 미기록이며 복원한 시각을
기록 시각처럼 쓰지 않았다. 추가 제품 class/instance로 세지 않는다.

주 검토는 최종 문서 직전 플랫폼 필터로 한 번 중단됐다. 같은 원 R2 시한에서
이미 수집한 JSON·해시 읽기와 문서 작성만으로 완료했다. 차단 동작·관측을
다시 실행하거나 회차/시계를 늘리지 않았고, 원 오류와 중단 기록을 보존했다.
root의 회수 관측기는 명시 complete_program=True만 최종 완주로 세도록
원 버전을 보존한 채 보수적으로 정리했다. 이 회수 도구는 준비물이며112 회수
자료가 실제로 존재한다는 증거가 아니다.

## 다음 작업

[113 새 설계안](113-typed-decision-artifact-boundary-proposal.md)은 JSON·URDF·
STL 숫자 경계를 별도 policy와 시험으로 새로 작성하는 source0 제안이다.
B2/C4 각1500초·D4 2400초, L2/L4 각최대2·검토 각2700초, 모두 PASS 뒤
조건부 새 첫 원격2700초를 제안했다. source10/runtime21/key48/capsule63의
새 경계를 L1/L2에서 먼저 닫는다. 현재 소진 source를 더 수리하는 R3가 아니다.
새 범위·예산의 명시 승인 전 새 source/HOST/검토/원격은0을 유지한다.
