WINNAKEN/robot-arm-lab/src/simulation/journal_gravity/README.md

# 064 bounded gravity checkpoint and append-only journal

Preserves physical criteria and600s timeout. Durable small checkpoints retain pending acquisition stages; complete rows append once; one atomic final report plus hash-bound journal/checkpoint enter final root validation. No hardware, installation or training. Results: outputs/isaac-journal-gravity-v1/HANDOFF.md.
