WINNAKEN/robot-arm-lab/docs/design/126-usd-layer-lifetime-repair.md

> 개발 이력: 작성 당시의 계획·결과입니다. 현재 상태는 [STATUS](../STATUS.md)를 확인하세요. 원시 로그와 로컬 경로 일부는 공개본에서 제외했습니다.

# 126 — USD layer lifetime repair candidate (local only)

2026-11-07 KST. Current user authorized continuation to an actual Isaac video and Drive delivery. 125 SDK run f3bdb19d83ea4615af27ddb17150c6fc completed import FAIL/RGB0: native fresh_stage reads old root/session layer.identifier after context.new_stage(). New/reset layers were not cleared. 125 source/reviews/fixed45-minute grant/maxSDK1/attempt/GO remain immutable; 126 adds no SSH/SDK or new time grant. The separately uploaded116 clip remains explicitly v3 reference with its original34s settling failure.

Scope: src/simulation/mp18_layer_lifetime_126/{candidate.py,test_candidate.py}, derived outputs/mp18-layer-lifetime-126/candidate/native.py and this plan (4source/plan files,1group=S). Author cap1500s cumulative, reviewer cap1500s, L4max2/noR3, final publication reserve180s. S L2 may be omitted under codex-operation.md; this written plan precedes implementation. Root authors; nonauthor review follows topology-roster.md with previously user-approved same-family fallback/common-bias limitation. No previous125 review round, exhaustion judgment, budget or failures are reset.

Official OpenUSD25.11 object model says registry caches weak handles; wrapper GetRootLayer/GetSessionLayer use weak handles while Sdf.Layer.FindOrOpen uses TfPyRefPtrFactory. Hypothesis: old layers expire after context.new_stage destroys old stage ownership. Pin exact existing old root/session layers BEFORE new_stage via Sdf.Layer.FindOrOpen(anonymous identifier), require returned identifier and identity match original and preserve strong Python objects through final unchanged-content comparison. Snapshot their content before new_stage, rather than the current mislabeled before-reset snapshot taken after switching. Do not use Layer.Find (weak), clone/import/reopen a different file, remove old-content comparison, ignore failures, or clear an old layer. Fail before new_stage if pin/snapshot fails. Keep all fresh anonymous/disjoint/current/clock/traverse/default guards and original error preservation. Retain evidence of pre-switch hash and ownership mode.

Only fresh_stage in original125 native is replaced by AST located byte range; all other bytes exactly equal. Candidate builder records old/new function and full source SHA, byte ranges, unchanged prefix/suffix and compile check. Original125native and124 sources remain unchanged. No edits to model/URDF/CAD/parameters/gains/caps/thresholds/control/hardware. Local pxr absent and no installation; HOST models weak lifetimes explicitly. It must reproduce old original failure and weak-Find mutation, and pass corrected strong ownership; wrong pin/missing pin/pin exception/hash mutation/newstage failure/old mutation/no-old-stage/normal owned reset/clock and evidence errors need meaningful controls. Reuse prior124 controls via explicit test fixture, with fakepxr injection scoped to HOST only; actual generated native function exercised separately from helper. Static source/API evidence is not actual NVIDIA runtime acceptance.

L4 must independently examine lifecycle semantics, original-failure/mutation sensitivity, actual generated native path and byte confinement, unchanged old-layer content before/after, pinned input/provenance, source/result reporting and class lineage. At least6 rubric items and attacks on identity, lifetime, failure evidence, time/budget and mutation. Findings union, source/verification/document landing, repeated or recursively generated class and next-distinct threshold must be explicit; prior125 remote-handoff class remains unrelated unless evidence supports aggregation. Any open issue or exceeded cap stays BLOCK. Local repair can become source PASS while native acceptance remains NOT_RUN. Next remote integration is a separate concrete reviewed plan; no reuse/rearm of125 markers/grant and no invented user reply.

Primary API evidence: https://openusd.org/25.11/api/_usd__page__object_model.html ; https://raw.githubusercontent.com/PixarAnimationStudios/OpenUSD/v25.11/pxr/usd/sdf/wrapLayer.cpp ; https://raw.githubusercontent.com/PixarAnimationStudios/OpenUSD/v25.11/pxr/usd/usd/wrapStage.cpp . Original SDK6.2.0-rc.14 pxr namespace v0_25_11. No native-only pin behavior claim until actual remote execution.
