WINNAKEN/robot-arm-lab/docs/design/130-small-motion-contact-avoidance-local-repair.md

> 개발 이력: 작성 당시의 계획·결과입니다. 현재 상태는 [STATUS](../STATUS.md)를 확인하세요. 원시 로그와 로컬 경로 일부는 공개본에서 제외했습니다.

# 130 — 접촉이 관측된 작은 동작의 수직 왕복 제거, 로컬 수리 완성

2026-11-08 KST. 동일최신사용자목표는J6초과수리→큰동작42/34초원판정→실제v4영상Drive다. 128/129실제SDK2회는두번모두small1429J6FAIL/largeNOT_RUN였다. 原taskscope3f516148… allowed[128129]/각SDK1/합2·고정2700each/합5400은소진, 원파일/실패/권위/기간/마커/클래스원장을변경·재무장하지않는다. 本130은기승인해결목표의필요한로컬source/HOST/검토/prepare만수행하며原scope로runtime130을허용하지않는다. 추가SDK는준비완료후새실제사용자허락을필요로한다. 미리추가승인답변을만들지않으며미승인SDK0·실물CAN/RS485/포트/급전/flash/설치/구매/네트워크·시계/모델CAD변경0.

소유: src/simulation/mp18_profile_repair_130/{release.py,runner.py,test_runner.py}, derived src/simulation/mp18_isaac_130/{driver.py,contract.py,native.py,config.json,program.json,media.py}, outputs/mp18-profile-repair-130/, 本계획과Root자기인계절. source9+plan1/2groups=M. 작성자implement113_c 새130cap2700/검산예비300, 필수main비작성자review113_lens 새130L2+L4누적2700/마감예비300/각max2/noR3. 原129author2316.796/2700·main2066.9585154/2700, 原128author2586.766/main2613.7420227는별도동결·리셋0. L1→L2→L3→L4·기승인samefamilyfallback/공통편향잔여기록유지. 작성자L2전read-only prep후동결, 제품생성0. 타인/old119–129source/원리뷰/原SDK/raw/grants/markers를고치지않는다. Root만실제운영/回收/Drive담당.

근거: 129 F703a61…/nativee78af630…/L4PASS470417…/run c72365f5de08447fbce38165f7c8dbff/job902318ea…/SDK50560. import406.109/hold240step23.281PASS, small1429FAIL/120frames. flagTrue前後readback와原sourcevelocity.5/no-set은확인됐지만J6−.5001133680343628>.5001, 128대비변화1.192e−7뿐이므로solver순서만으로해결했다고하지않는다. 실제CPUimplicit0/currentLabKitcachecontext/header9223002/ownerlayerclockq일치의KG1_A↔Floor persistentpair1/contact2를기록했고비영impulse약.005470094Ns·J6축모멘트투영약−1.12417e−4Nms가동시관측됐다. 原관례actualsupport gap.210252774→.000370585mm, FK관측도근접한다. Contact가단독원인이라는동역학증명은없으며겉보기관통/impulse방향을과장하지않는다. contactstageavailability는해당actual경계NATIVE_CLOSED이고SourcevelocityFAIL은미해결이다.

물리입력변경은program JSON의small첫4segment q_deg에서J2/J3 −3→0, 총8scalar만이다. J1±5/모든segmentduration/hold2/small12/原large42全program·34초zero reference/12초終zero/settling.5deg1deg_s/原sourcevelocity+.0001/모델d55f0cbd…/gain64_16/caps12_7/dt1_120/640×480fps10/floor/衝突/物성/solver等은같다. 129의既定officialflagTrue를유지하나추가물리파라미터변경0. native.py는검토된129e78af… 바이트동일, contract9052/cfg401d도119바이트동일로한다. 原program5217…에서許容JSONPath8곳만파생하고그외JSON語義全同一/large객체byte同等性을검산한다. 

候補는baseline과같이C119.validate_program을6723 sampledposes그대로통과했고原/候補최저nominal10.98720356mm도같다. 따라서기저margin상향수리가아니라約49.655267mm의J2/J3수직상승/2秒복귀excitation을없애는q+qd공통경로가설이다. smallJ1peak.163624617rad_s/J2J3peak0, 原large最大.490873852<.5. large8초복귀가더낮은accel/jerk라도J3peak는oldsmall보다높고기준34·42실제통과/무접촉을예단하지않는다. 原qd-only sourceEXH/정착15/기타소진원장을복구·리셋하지않고새기전/입력으로별도판정한다. tolerance확장/속도clamp/初期poseteleport/桌lower/기준reference변경0.

현재129canonicalconsumer완료: archive157230506B/266b8537ef49a9b510a43d45092d9ec6e68b9284d237aff4e98c3823c581a06d, nativeexit2; SDK50560 및SSHparent모두REAPED/active0/rawcomplete, sealed9와canonical9 hash+bytes一致. authoranalysis7cb5f227…/main5f36f281… 및부모SDK원records를sourceFACTS로같은capturedbytes에서검산하고prioractualSDK5로보고한다(원3+1281+1291; 舊allocation2소진). 모델·기하·APIbindings/原128129sourceF와역사를任意namespaceallreplace하지않는다. Rootsource-authorization.json은LOCAL_REPAIR_ONLY_REFERENCE이며원actualunit128/5810과spentallocation3f516/원문을가리키나runtime권위는주지않는다.

130 runner의runtimegate는原scope에서130非member임을확인하고새實userpermission이없으면prepare後라도run/admit/SDK前명시차단한다. originalclosed budget reply/grant shape(unit130·2700·hardwarefalse·F/preparedSHA·nonce·fixedperiod)는유지하되, 신규new-runtime-permission.json의實userreply·conversationref·sourceF/L4SHA·원요청5810/소진scope3f516·추가SDKmax1/retry0/2700을같은capturedraw로필수검산한다. 靜的policy는code에새명시허락을요구하는要件으로만고정하며승인/할당증서가아니다. 舊128/129approval/grant/goal문구/LOCAL_ONLY기록만으로새runtime을통과시키지않는다. 원新userreply가실제로수신된뒤Root만그대로보존하며조건부선승인이주어진경우동일session의그명시결정이L4이후준비된F에결속됐음을명시한다(승인을다시묻거나발언제조0). 新permission rawSHA는reply.conversation_ref의고정token또는동등한검산결속으로rraw→grant.replySHA에묶고consumedsnapshot/current/expiry까지함께보호한다. 不存在·舊ref재사용·coherent허위role/錯F/錯L4·권한교체를source/입력쓰기또는SDK前거절한다. 신규SDK1회권위는실제새명시user답변을받기전존재하지않는다. permission변경은source코드변경이아니라사전검토된dynamicadmission input이며SourceF에사용자미정답변SHA를미리날조하지않는다.

원rawstdin123/WinJob/expected_job_sha bootstrap→parent/native/context samecapturedbytesexec·currentSOURCE/authority/paths/resultseal/MP4only보존, remote119root/legacyenvelope119는호환계약으로같게두고outer130 labels/runid/nonce/SourceSHA를새로한다. legacyprogram이더이상byte동일이아니므로false동일선언0, original프로그램+8JSONPath변경의실효와새programSHA를metadata/job/prepare/semantics/test에서같이검산한다. C/config/native/原large·criteria·motion종단referencetype은유지한다. SourceSnapshot/로컬prepare는원local수리권위+typed최종L4/F로가능하지만runtime은상기새permission없이는항상불가하게분리한다.

HOST: 原12936군을실제130generatedpackage로회귀하고新program唯8変更과非small/원large/34reference/12endzero/原기준동일·oldprogram復元mutation거절·동일C119validator/nominal+peak/phase判定 실제consumer를검산한다. 新권한gate는canonical실제permission0·source-onlyprepare양성/run차단음성, HOSTtemp의fake新reply+permission/F/L4positive후actualread/write/clockchange·old128129data복용/同문구fakeRole/錯期/錯quota/header/ref/hash변조를actual130Snapshot/admit/parentconsumer에서실측한다. HOST fake권한은본위production권위로복사0. CPUcontact/primary/12x3/borrowedbounds/單physicsstep/속도tol/原state추출順 유지, expectedjob coherentB/WinJob/resultarchive/mediaMP4only를다시實생성code로검산한다. helper存在token만으로수용0, new判定을거짓pass하도록fixture時間/IOseam을약화하지않으며원fixture실패도보존한다. 최소8AC/5攻擊범주·원결함합집합/분류/반복재귀/次DISTINCT/현재sourceEXH를비작성자가判定한다. 실제physical速度/large수리는HOST로닫지않는다.

최종SourceL4/F/current/localprepare까지먼저마쳐user가검토할수있게하고, 추가원격을위한새실제명시허락은그구체준비물을제시하는최종단계로만요청한다. 새실제허락이이미동일session에서명확히주어졌다면다시질문하지않고그근거를보존해Root만新permission/closedgrant를만든다. 추가SDK미승인시여기서remote0을유지하고big/video未完료상태를정직히보고한다. 本계획자체/原latestgoal만으로spentallocation을재해석·reset하거나세번째SDKをdispatch하지않는다. 新許可後만第一130remote로부터2700fixedSDK1/retry0으로import→hold→small→large42/34를실제驗證한다. 실제PASS한v4RGB만encode/fullDecode/firstmiddlelast/actualq範圍·Sourcejobseal로검산해승인DrivefolderPRIVATE_CLOUD_RESOURCE_REMOVED에MP4한개만append, metadata/remoteSHA確認한다. 診断12秒/v3/CAD/HOSTを큰동작PASS대신올리지않으며내부JSON/설정/권위/토큰Upload/공유권한변경0.
