WINNAKEN/robot-arm-lab/docs/development/JOURNAL.md

# 개발 일지

마지막 정리: 2026-11-13 KST. 설계·가정·HOST 시험·실제 실행·실물을 구분해서 기록합니다. 아래 날짜는 기존 설계 문서와 보존한 결과를 기준으로 정리했습니다.

## 2026-10-22 — 프로젝트 시작

MKS CAN 기반 소형 6축을 직접 제작하면서 기구·제어를 함께 익히는 프로젝트로 등록했습니다. 공개 로봇암과 제조사 자료를 조사하고, 외부 참고 자료와 자체 코드를 분리했습니다. 초기에는 부품 치수·토크·하중을 확정값으로 쓰지 않았습니다.

## 2026-10-23 이후 — 제어 코어와 조립 개념

CAN 인코더/속도 코덱, 정지 절차, 단일 송신 소유자, 요청/제어권/명시적 허가의 수명을 나눴습니다. fake CAN과 SDK stub으로 경계와 실패 경로를 확인했습니다. 휴대폰 화면과 실제 모터 운전을 연결하기 전에 장치 비활성 기본값을 유지했습니다.

동시에 자체 CAD와 감속기·장착부·손목·그리퍼를 발전시켰습니다. 실측 전의 값, 제조사 공표값, 사용자 실측값을 원장에 구분했고 출력 끼움 시험 결과를 후속 판에 반영했습니다.

## 2026-10-27 이후 — URDF와 원격 Isaac

CAD 표시 자세와 관절 좌표를 URDF로 옮겼습니다. 링크 원점·단위·COM·관성·기저의 해석 차이로 생긴 문제를 조사하면서 가져오기 성공과 실제 동역학 수용을 분리했습니다. 원격 접속 장애·시간 동기·실행 종료/회수 문제도 별도 진단했습니다.

## 2026-11-06 이후 — MP18과 URDF v4

팔 외장을 MP18 형상으로 다시 구성하고 어깨·위팔·손목·케이블 길을 검토했습니다. 아래팔 J3→J4 거리는165mm를 반영했습니다. 변경 형상을 URDF v4와 링크별/색상별 STL로 옮기고 구성별 질량·COM·관성 근사를 다시 계산했습니다.

질량과 충돌 형상은 여전히 가정입니다. 표시 자세와 관절 단독 한도만으로 책상 충돌을 피할 수 없다는 점을 기록했습니다. 시뮬레이션용 게인·토크 cap을 실물 모터의 허용값으로 사용하지 않습니다.

## 2026-11-10 — 피니언 기준값 수정137

피니언의 목표 위치·속도를 직전 단계의 실제 조 A 위치·속도에서 계산하도록 수정했습니다. 원래133 기록의11,160명령을 재생하는 HOST 검증에서 기준값 결합 오차를 줄였고 독립 HOST21개가 통과했습니다.

이는 실제 Isaac 재실행이나 집기 성공이 아닙니다. 최신 준비 키트는 PREPARED_NOT_RUN이며, 새 동역학 검증·접촉/추종/종료 확인이 남아 있습니다.

## 2026-11-11~12 — 실물 손목과 통신 인터페이스

J5·J6 조립 및 두 축이 CAN형임을 사용자에게 확인했습니다. 그리퍼는 STS3215 TTL 제품이어서 CAN과 별도 인터페이스가 필요합니다. 모터 포함 CAN MT 구매 옵션을 확인했지만 개별 모터의 정격 상전류를 확인하지 못해 초기 시험 설정과 정격을 분리했습니다.

## 2026-11-12 — 조회 전용 ESP 배포와 첫 CAN 응답

ESP의 기존 flash를 로컬에 보존한 뒤 새 조회 앱을 준비했습니다. SDK 전달 방식의 문제로 첫 배포 시도가 flash 쓰기 전에 실패했고, 전달 호출만 수정한145 단위에서 앱/OTA 선택 정보 배포와 readback을 완료했습니다. 원래 bootloader·파티션·NVS를 보존했습니다. 원본 덤프는 공개하지 않습니다.

HOST322검사 및 오류 대조군을 확인했고 실제 USB INFO로 앱 식별·제한된 부팅 안정성을 확인했습니다. 이어 사용자 메뉴값 CR_vFOC·ID1·500K에 맞춰 속도 읽기 한 번을 수행해 정상 체크섬의0RPM 응답을 받았습니다. Mode를 바꾸거나 회전·enable·설정 쓰기를 보내지 않았습니다.

사용자가 앞서 CAL을 눌러 움직인 사건은 별도 기록했습니다. CAL과 로봇의 기구 원점 확정은 구분하며, 통신 조회를 위해 다시 CAL하지 않았습니다.

## 2026-11-13 — 첫 공개판

코드·작성 문서·URDF v4와 개발 과정을 공개하는 요청을 받았습니다. 원본 로컬 Git188개 커밋에는 원시 증거와 대용량 자료가 섞여 있어 그대로 공개하지 않고, 현재 작업 트리의 선별 스냅샷으로 새 공개 이력을 시작합니다.

인증정보·ESP 덤프·주문/메일/사진 원본·로컬 식별정보·외부 패키지·raw 로그를 제외했습니다. 원래 설계 문서는 역사 기록으로 남기고 최신 상태는 STATUS에 분리했습니다. 공개 검토는 기존 승인에 따른 동일 계열의 비작성자 검토이며 공통 편향이 남습니다.

## 다음 확인점

1. 로봇 고정과 현재 자세·책상 간격을 확인할 수 있는 화면 확보.
2. 실제 축 방향·감속비·기구 원점과 전원 차단 시 지지 조건 확인.
3. 제한된 단발 이동·정지 제어를 별도로 구현/검토하고 한 축에서 검증.
4. 최신 피니언 수정본의 Isaac 동역학·파지 시나리오 재검증.
5. STS3215 전원/TTL 어댑터를 분리한 그리퍼 실물 제어 준비.

후속 변경은 날짜, 바뀐 이유, 장치 없이 한 시험, 실제 실행 여부, 남은 결함을 함께 기록합니다.
