WINNAKEN/robot-arm-lab/models/robot-arm-urdf-v1/robot_arm.urdf

<?xml version='1.0' encoding='utf-8'?>
<robot name="robot_arm_lab_v2_simulation_draft">
  <!--SIMULATION ONLY. Assumed mass/inertia/limits. q=0 is CAD display pose. Hardware unapproved.-->
  <material name="body">
    <color rgba="0.925490196078431 0.937254901960784 0.945098039215686 1" />
  </material>
  <material name="accent">
    <color rgba="0.929411764705882 0.490196078431373 0.192156862745098 1" />
  </material>
  <material name="dark">
    <color rgba="0.168627450980392 0.192156862745098 0.219607843137255 1" />
  </material>
  <link name="Base">
    <visual name="BASE_FOOT">
      <geometry>
        <mesh filename="meshes/BASE_FOOT.stl" scale="1 1 1" />
      </geometry>
      <material name="dark" />
    </visual>
    <visual name="BASE_COLUMN">
      <geometry>
        <mesh filename="meshes/BASE_COLUMN.stl" scale="1 1 1" />
      </geometry>
      <material name="body" />
    </visual>
    <visual name="BASE_LIGHT_RING">
      <geometry>
        <mesh filename="meshes/BASE_LIGHT_RING.stl" scale="1 1 1" />
      </geometry>
      <material name="accent" />
    </visual>
    <visual name="J1_MODULE">
      <geometry>
        <mesh filename="meshes/J1_MODULE.stl" scale="1 1 1" />
      </geometry>
      <material name="body" />
    </visual>
    <visual name="J1_ACCENT_RING">
      <geometry>
        <mesh filename="meshes/J1_ACCENT_RING.stl" scale="1 1 1" />
      </geometry>
      <material name="accent" />
    </visual>
    <inertial>
      <origin xyz="0 0 0.057" rpy="0 0 0" />
      <mass value="1.2" />
      <inertia ixx="0.0039891324324243605" iyy="0.0039892" izz="0.005379132432424361" ixy="0" ixz="0" iyz="0" />
    </inertial>
    <collision name="assumed_aabb_proxy">
      <origin xyz="0 0 0.057" rpy="0 0 0" />
      <geometry>
        <box size="0.164 0.16399794 0.114" />
      </geometry>
    </collision>
  </link>
  <link name="Link1">
    <visual name="LINK1_SHOULDER_CAP">
      <geometry>
        <mesh filename="meshes/LINK1_SHOULDER_CAP.stl" scale="1 1 1" />
      </geometry>
      <material name="body" />
    </visual>
    <visual name="LINK1_POST">
      <geometry>
        <mesh filename="meshes/LINK1_POST.stl" scale="1 1 1" />
      </geometry>
      <material name="body" />
    </visual>
    <visual name="J2_MODULE">
      <geometry>
        <mesh filename="meshes/J2_MODULE.stl" scale="1 1 1" />
      </geometry>
      <material name="body" />
    </visual>
    <visual name="J2_ACCENT_RING">
      <geometry>
        <mesh filename="meshes/J2_ACCENT_RING.stl" scale="1 1 1" />
      </geometry>
      <material name="accent" />
    </visual>
    <visual name="J2_END_CAP">
      <geometry>
        <mesh filename="meshes/J2_END_CAP.stl" scale="1 1 1" />
      </geometry>
      <material name="accent" />
    </visual>
    <inertial>
      <origin xyz="-3.97816082159386e-10 -0.0230000025378264 0.074" rpy="0 0 0" />
      <mass value="0.65" />
      <inertia ixx="0.0016813334311424988" iyy="0.0012653332914218907" izz="0.001587733389231056" ixy="0" ixz="0" iyz="0" />
    </inertial>
    <collision name="assumed_aabb_proxy">
      <origin xyz="-3.97816082159386e-10 -0.0230000025378264 0.074" rpy="0 0 0" />
      <geometry>
        <box size="0.103999996280049 0.136000006638631 0.112" />
      </geometry>
    </collision>
  </link>
  <link name="Link2">
    <visual name="LINK2_SHOULDER_HUB">
      <geometry>
        <mesh filename="meshes/LINK2_SHOULDER_HUB.stl" scale="1 1 1" />
      </geometry>
      <material name="body" />
    </visual>
    <visual name="LINK2_UPPER_TUBE">
      <geometry>
        <mesh filename="meshes/LINK2_UPPER_TUBE.stl" scale="1 1 1" />
      </geometry>
      <material name="body" />
    </visual>
    <visual name="J3_MODULE">
      <geometry>
        <mesh filename="meshes/J3_MODULE.stl" scale="1 1 1" />
      </geometry>
      <material name="body" />
    </visual>
    <visual name="J3_ACCENT_RING">
      <geometry>
        <mesh filename="meshes/J3_ACCENT_RING.stl" scale="1 1 1" />
      </geometry>
      <material name="accent" />
    </visual>
    <visual name="J3_END_CAP">
      <geometry>
        <mesh filename="meshes/J3_END_CAP.stl" scale="1 1 1" />
      </geometry>
      <material name="accent" />
    </visual>
    <inertial>
      <origin xyz="0.0859999914674529 0.0365000015215827 3.34904160653737e-09" rpy="0 0 0" />
      <mass value="0.7" />
      <inertia ixx="0.001165558519799128" iyy="0.0040602333832338924" izz="0.004280791801729625" ixy="0" ixz="0" iyz="0" />
    </inertial>
    <collision name="assumed_aabb_proxy">
      <origin xyz="0.0859999914674529 0.0365000015215827 3.34904160653737e-09" rpy="0 0 0" />
      <geometry>
        <box size="0.247999999974039 0.109000010680007 0.090000004823971" />
      </geometry>
    </collision>
  </link>
  <link name="Link3">
    <visual name="LINK3_ELBOW_HUB">
      <geometry>
        <mesh filename="meshes/LINK3_ELBOW_HUB.stl" scale="1 1 1" />
      </geometry>
      <material name="body" />
    </visual>
    <visual name="LINK3_FOREARM_TUBE">
      <geometry>
        <mesh filename="meshes/LINK3_FOREARM_TUBE.stl" scale="1 1 1" />
      </geometry>
      <material name="body" />
    </visual>
    <visual name="J4_MODULE">
      <geometry>
        <mesh filename="meshes/J4_MODULE.stl" scale="1 1 1" />
      </geometry>
      <material name="body" />
    </visual>
    <visual name="J4_ACCENT_RING">
      <geometry>
        <mesh filename="meshes/J4_ACCENT_RING.stl" scale="1 1 1" />
      </geometry>
      <material name="accent" />
    </visual>
    <visual name="J4_END_CAP">
      <geometry>
        <mesh filename="meshes/J4_END_CAP.stl" scale="1 1 1" />
      </geometry>
      <material name="accent" />
    </visual>
    <inertial>
      <origin xyz="0.0600000059820724 -0.0115000001092034 2.51081219010407e-09" rpy="0 0 0" />
      <mass value="0.65" />
      <inertia ixx="0.0008821044605895762" iyy="0.002410417312534377" izz="0.0026334213396584922" ixy="0" ixz="0" iyz="0" />
    </inertial>
    <collision name="assumed_aabb_proxy">
      <origin xyz="0.0600000059820724 -0.0115000001092034 2.51081219010407e-09" rpy="0 0 0" />
      <geometry>
        <box size="0.196000020210438 0.1010000070547 0.0780000256488396" />
      </geometry>
    </collision>
  </link>
  <link name="Link4">
    <visual name="LINK4_NECK">
      <geometry>
        <mesh filename="meshes/LINK4_NECK.stl" scale="1 1 1" />
      </geometry>
      <material name="body" />
    </visual>
    <visual name="J5_MODULE">
      <geometry>
        <mesh filename="meshes/J5_MODULE.stl" scale="1 1 1" />
      </geometry>
      <material name="body" />
    </visual>
    <visual name="J5_ACCENT_RING">
      <geometry>
        <mesh filename="meshes/J5_ACCENT_RING.stl" scale="1 1 1" />
      </geometry>
      <material name="accent" />
    </visual>
    <visual name="J5_END_CAP">
      <geometry>
        <mesh filename="meshes/J5_END_CAP.stl" scale="1 1 1" />
      </geometry>
      <material name="accent" />
    </visual>
    <inertial>
      <origin xyz="0.0674999998056777 -0.0364999967060447 2.54630455609473e-10" rpy="0 0 0" />
      <mass value="0.4" />
      <inertia ixx="0.0005988335927967767" iyy="0.0005295003304479601" izz="0.000722733653614585" ixy="0" ixz="0" iyz="0" />
    </inertial>
    <collision name="assumed_aabb_proxy">
      <origin xyz="0.0674999998056777 -0.0364999967060447 2.54630455609473e-10" rpy="0 0 0" />
      <geometry>
        <box size="0.0990000296413416 0.109000017153444 0.0780000259259718" />
      </geometry>
    </collision>
  </link>
  <link name="Link5">
    <visual name="LINK5_WRIST_HUB">
      <geometry>
        <mesh filename="meshes/LINK5_WRIST_HUB.stl" scale="1 1 1" />
      </geometry>
      <material name="body" />
    </visual>
    <visual name="LINK5_WRIST_TUBE">
      <geometry>
        <mesh filename="meshes/LINK5_WRIST_TUBE.stl" scale="1 1 1" />
      </geometry>
      <material name="body" />
    </visual>
    <visual name="J6_MODULE">
      <geometry>
        <mesh filename="meshes/J6_MODULE.stl" scale="1 1 1" />
      </geometry>
      <material name="body" />
    </visual>
    <visual name="J6_ACCENT_RING">
      <geometry>
        <mesh filename="meshes/J6_ACCENT_RING.stl" scale="1 1 1" />
      </geometry>
      <material name="accent" />
    </visual>
    <visual name="J6_END_CAP">
      <geometry>
        <mesh filename="meshes/J6_END_CAP.stl" scale="1 1 1" />
      </geometry>
      <material name="accent" />
    </visual>
    <inertial>
      <origin xyz="0.0629999990191984 0.00650000486569801 -3.22901150262567e-11" rpy="0 0 0" />
      <mass value="0.35" />
      <inertia ixx="0.0004189793983144403" iyy="0.0012303672285751957" izz="0.0012944463763166286" ixy="0" ixz="0" iyz="0" />
    </inertial>
    <collision name="assumed_aabb_proxy">
      <origin xyz="0.0629999990191984 0.00650000486569801 -3.22901150262567e-11" rpy="0 0 0" />
      <geometry>
        <box size="0.190000039394464 0.0910000200366577 0.0780000275354905" />
      </geometry>
    </collision>
  </link>
  <link name="Link6">
    <visual name="LINK6_TOOL_FLANGE">
      <geometry>
        <mesh filename="meshes/LINK6_TOOL_FLANGE.stl" scale="1 1 1" />
      </geometry>
      <material name="dark" />
    </visual>
    <visual name="LINK6_TOOL_RING">
      <geometry>
        <mesh filename="meshes/LINK6_TOOL_RING.stl" scale="1 1 1" />
      </geometry>
      <material name="accent" />
    </visual>
    <inertial>
      <origin xyz="0.0250000011995604 2.41431064376685e-09 4.01766462113096e-09" rpy="0 0 0" />
      <mass value="0.2" />
      <inertia ixx="0.0001045333900975185" iyy="5.5533383176768606e-05" izz="5.55333720963775e-05" ixy="0" ixz="0" iyz="0" />
    </inertial>
    <collision name="assumed_aabb_proxy">
      <origin xyz="0.0250000011995604 2.41431064376685e-09 4.01766462113096e-09" rpy="0 0 0" />
      <geometry>
        <box size="0.0140000341167023 0.0560000122367292 0.0560000181726514" />
      </geometry>
    </collision>
  </link>
  <joint name="J1" type="revolute">
    <parent link="Base" />
    <child link="Link1" />
    <origin xyz="0 0 0.096" rpy="0 -0 0.261799387799149" />
    <axis xyz="0 0 1" />
    <limit lower="-2.9670597283903604" upper="2.9670597283903604" effort="3.0" velocity="0.5" />
    <dynamics damping="0.05" friction="0.0" />
  </joint>
  <joint name="J2" type="revolute">
    <parent link="Link1" />
    <child link="Link2" />
    <origin xyz="0 0 0.078" rpy="0 -0.872664625997165 -4.31800103134597e-17" />
    <axis xyz="-2.77555756156289e-17 1 2.77555756156289e-17" />
    <limit lower="-2.9670597283903604" upper="2.9670597283903604" effort="6.0" velocity="0.5" />
    <dynamics damping="0.05" friction="0.0" />
  </joint>
  <joint name="J3" type="revolute">
    <parent link="Link2" />
    <child link="Link3" />
    <origin xyz="0.165 -3.5527136788005e-18 -2.1316282072803e-17" rpy="8.11518741140351e-17 1.22173047639603 0" />
    <axis xyz="0 1 -1.38777878078145e-17" />
    <limit lower="-2.9670597283903604" upper="2.9670597283903604" effort="5.0" velocity="0.5" />
    <dynamics damping="0.05" friction="0.0" />
  </joint>
  <joint name="J4" type="revolute">
    <parent link="Link3" />
    <child link="Link4" />
    <origin xyz="0.14 0 0" rpy="0.261799387799149 -9.0205620750794e-17 0" />
    <axis xyz="1 4.16333634234434e-17 4.85722573273506e-17" />
    <limit lower="-2.9670597283903604" upper="2.9670597283903604" effort="2.0" velocity="0.5" />
    <dynamics damping="0.05" friction="0.0" />
  </joint>
  <joint name="J5" type="revolute">
    <parent link="Link4" />
    <child link="Link5" />
    <origin xyz="0.078 7.105427357601e-18 1.55431223447522e-17" rpy="-9.18746677871361e-17 0.436332312998582 7.65622231559468e-17" />
    <axis xyz="6.93889390390723e-17 1 -5.55111512312578e-17" />
    <limit lower="-2.9670597283903604" upper="2.9670597283903604" effort="2.0" velocity="0.5" />
    <dynamics damping="0.05" friction="0.0" />
  </joint>
  <joint name="J6" type="revolute">
    <parent link="Link5" />
    <child link="Link6" />
    <origin xyz="0.14 8.88178419700125e-18 -1.99840144432528e-17" rpy="-0.174532925199433 -1.87350135405495e-16 6.93889390390723e-17" />
    <axis xyz="1 0 2.0122792321331e-16" />
    <limit lower="-2.9670597283903604" upper="2.9670597283903604" effort="1.0" velocity="0.5" />
    <dynamics damping="0.05" friction="0.0" />
  </joint>
</robot>
